rico-x/GemilaiMate/hardware/shield/manufacturing/drill-report.txt

Drill report for gemilaimate-shield.kicad_pcb
Created on 2026-10-28T00:00:00

Copper Layer Stackup:
    =============================================================
    L1 :  F.Cu                      front
    L2 :  B.Cu                      back

Drill file 'gemilaimate-shield-PTH.drl' contains
    plated through holes:
    =============================================================
    T1  0.300mm  0.0118"  (96 holes))
    T2  1.000mm  0.0394"  (121 holes))

    Total plated holes count 217

Drill file 'gemilaimate-shield-NPTH.drl' contains
    unplated through holes:
    =============================================================
    T1  1.000mm  0.0394"  (13 holes))
    T2  3.200mm  0.1260"  (4 holes))

    Total unplated holes count 17
