rico-x/GemilaiMate/hardware/carrier/manufacturing/drill-report.txt

Drill report for gemilaimate-carrier.kicad_pcb
Created on 2026-10-28T10:30:41

Copper Layer Stackup:
    =============================================================
    L1 :  F.Cu                      front
    L2 :  B.Cu                      back

Drill file 'gemilaimate-carrier-PTH.drl' contains
    plated through holes:
    =============================================================
    T1  0.300mm  0.0118"  (53 holes))
    T2  1.000mm  0.0394"  (112 holes))

    Total plated holes count 165

Drill file 'gemilaimate-carrier-NPTH.drl' contains
    unplated through holes:
    =============================================================
    T1  1.000mm  0.0394"  (13 holes))
    T2  3.200mm  0.1260"  (2 holes))

    Total unplated holes count 15
