rico-x/GemilaiMate/docs/compact-shield.md

# Compact Shield: ревизия 0.3.1

**Опытный проект, в железе не воспроизводился.** Переключение между согласованными парами GemilaiMate и оригинального GaggiMate остаётся требованием аппаратных испытаний. Старые carrier и shield сохранены отдельно.

Плата содержит ESP32-S3-WROOM-1-N16R8, собственный USB-C, питание, буферы, PCA9634 и гнёзда ADS1115 Blue, MAX31855 и CJMCU-0102. Измерительные модули вставляются без межплатных проводов. RobotDyn и SSR остаются отдельными силовыми модулями; сетевых цепей на этой PCB нет. Штатный нагрев Gemilai продолжает управляться штатной платой.

Открыть [KiCad-проект](../hardware/shield-compact/gemilaimate-compact.kicad_pro). [Файлы прототипа](../hardware/shield-compact/manufacturing/), [шаблон сверху 1:1](../hardware/shield-compact/previews/assembly-1to1.pdf), [снизу 1:1](../hardware/shield-compact/previews/assembly-bottom-1to1.pdf), [отчёты](../hardware/shield-compact/reports/).

Закупка с учётом прежнего комплекта: [что докупить для Compact](compact-purchase-delta.md). Полная деталировка с расчётом количества — [страница закупки](https://rico-x.github.io/GemilaiMate/compact-purchase.html); ручная сборка — [пошаговый монтаж](compact-assembly.md) ([с картами позиций](https://rico-x.github.io/GemilaiMate/compact-assembly.html)); рендеры и распиновка — [обзор Compact](https://rico-x.github.io/GemilaiMate/compact.html).

## Размеры и размещение

**76 × 61 мм, два медных слоя**, FR-4 1,6 мм, медь 35 мкм. По сравнению с проверявшейся четырёхслойной платой 75 × 60 мм прибавлен 1 мм по каждой стороне габарита; площадь больше на 3,0%. Размер выбран после серии изолированных попыток разводки. Это минимальный прошедший вариант с целыми миллиметрами среди проверенных; глобальный математический минимум не заявляется. Итоги поиска: [layout-search.json](../hardware/shield-compact/reports/layout-search.json).

Все трассы находятся на F.Cu/B.Cu; с обеих сторон заливка GND. Питание разведено дорожками. Внутренних слоёв нет. Антенна WROOM выступает примерно на 7,15 мм за верхний край: 76 × 61 мм — размер текстолита, а не всего устройства. USB выходит к нижнему краю, нижнее левое крепление сдвинуто вправо для кабеля. Размер корпуса и реальные кабели в машине ещё не проверены.

Сверху стоят WROOM, SMD, BOOT/RESET, USB и вставные модули; кабельные JST PH/XH — снизу. Часть низких SMD расположена под модулями: сначала паять SMD, затем гнёзда и разъёмы, последними вставлять модули. Номинальная высота нижней стороны модулей — 11,04 мм. Кнопки и контрольные точки остаются доступными.

Вход питания J4 — единственный JST XH, RobotDyn — единственный PH на 6 позиций (5/6 пустые); J10 нагрева не устанавливать. Другие одинаковые по размеру PH взаимозаменяемы механически: маркировать жгуты по PINOUT/HARNESSES. Ключ исключает разворот штекера, но не перестановку одинаковых разъёмов. Стороны и нумерацию смотреть по сборочным видам; вид снизу зеркален относительно вида сверху.

Номинальные размеры модулей: ADS1115 Blue 28 × 17 мм, MAX31855 20,32 × 22,86 мм, CJMCU-0102 15,24 × 15,24 мм; межрядье CJMCU принято 12,70 мм. **Полученные экземпляры не измерены.** До изготовления сверить модуль, клемму термопары и гребёнки с шаблоном. Источники и уверенность размеров: [component-dimensions.md](component-dimensions.md), [таблица всех позиций](../hardware/shield-compact/reports/component-dimensions.csv).

Гнёзда Harwin M20-7821046, M20-7820646 и два M20-7820546; ответные штыри M20-9991046/0646 и два M20-9990546. Гнездо 8,5 мм + пластик штыревой планки 2,54 мм дают 11,04 мм между платами. Рекомендованные отверстия Ø1,02 мм под контакт 0,65 мм. Совместимость фактических гребёнок-клонов пока не проверена.

Крепление — четыре M2 с головкой до Ø4 мм и изолирующими стойками. Вокруг каждого отверстия круг Ø5 мм без меди на обоих слоях. Не заменять крепёж широкой металлической шайбой.

## Производственные допуски

Ориентир — недорогая двухслойная плата PCBWave с требованием минимального зазора **8 mil = 0,2032 мм** и дорожкой 6 mil. В проекте дорожка не уже **0,20 мм (7,87 mil)**. Исключений 0,15 мм для меди нет.

| Параметр | Принято |
|---|---|
| Обычный зазор сигналов | 0,25 мм |
| Питание, USB и заливки | 0,30 мм |
| Локальные проходы USB-C и близкие контакты корпусов | Правило от 0,21 мм; между площадками USB фактически от 0,22 мм |
| Сигнальные дорожки | Номинал 0,30 мм; тесные участки от 0,20 мм |
| Питание | Номинал 0,40 мм; минимум 0,30 мм |
| Расширение свободных участков | До 0,80 мм сигналы и до 1,20 мм питание, с проверкой соседней меди и отверстий |
| Переходы | Ø0,80 / отверстие Ø0,40 мм, кольцо 0,20 мм, маска с обеих сторон |
| Медь — край | От 0,50 мм |
| Отверстие — чужая медь | От 0,50 мм; локально 0,40 мм у фиксированной геометрии USB |
| Отверстие — отверстие | От 0,65 мм; геометрия фиксированных посадочных мест проверяется отдельно |
| Маркировка | Высота от 1,0 мм, линия от 0,15 мм; это допуск надписей, не меди |

USB-C — **HRO TYPE-C-31-M-12**, локальный вариант посадочного места KiCad. Центры, длины площадок и крепёж сохранены; ширина контактных площадок уменьшена на 0,02 мм: 0,30 → 0,28 мм, 0,60 → 0,58 мм. По [чертежу HRO](https://datasheet.lcsc.com/datasheet/pdf/9e56b777c022540fcce7c7f67825f55e.pdf?productCode=C165948) ширина выводов 0,20 ±0,05 мм, допуск рекомендуемого PCB layout ±0,05 мм. Это проектная адаптация, а не отдельное одобрение производителя разъёма. Фактический минимальный зазор площадок **0,22 мм** независимо проверяется по сохранённой PCB; локальное правило контакт–контакт и контакт–трасса — от 0,21 мм. Один открытый ряд контактов доступен для ручной пайки. USB4085 для этой ревизии не подходит и в BOM отсутствует. Распиновка D+/D−, CC, VBUS и GND проверяется независимо по схеме и PCB. USB Full-Speed 12 Мбит/с; контролируемый импеданс и сертификация USB не заявляются.

На плате **34 перехода GND**, в том числе 20 дополнительных сшивающих Ø0,80/0,40 мм; сигнальные трассы и их переходы не перемещались. Тентирование с обеих сторон. Выбор свободных мест учитывает отверстия, чужую медь, отсутствие новых via-in-pad и крепёж; после добавления повторяется полный DRC. Список: [ground-stitching.json](../hardware/shield-compact/reports/ground-stitching.json).

**Ограничение USB сохраняется.** Заливка снизу разделена на 20 областей, сверху — на 9; сшивка добавляет электрические связи между слоями, но не превращает нижний слой в сплошную плоскость. Доля длины над противоположной заливкой GND: USB_DP 46,46%, USB_DM 48,16%, USB_DP_MCU 34,79%, USB_DM_MCU 0%. Это измерение осевой линии трасс, не расчёт импеданса. USB_DM 40,33 мм и 5 переходов, USB_DP 25,77 мм и 2 перехода; рядом с частью переходов путь до ближайшего соединения GND стал короче, но не везде. Предстоят аппаратные испытания USB и устойчивости к помехам; работа интерфейса не гарантируется проверкой DRC. [Замеры](../hardware/shield-compact/reports/ground-integrity.json).

Пассив 0805/1206 HandSolder, SOT-23/SMA HandSolder, U6/U7 SOIC с шагом 1,27 мм сохранены. Новых проводных перемычек или дополнительных компонентов для перехода на два слоя не добавлено. Локальная переразводка и переходы земли позволяют получить связность без внутренних плоскостей. Ряд тепловых отверстий в центральной земле WROOM сохранён; остальные непланарные отверстия не пересекают SMD-площадки.

Для пробной партии: **2 слоя, 1,6 мм, 1 oz, зелёная маска**, без монтажа; HASL допустим, ENIG даёт более ровные площадки. Перед заказом нужна независимая проверка актуального комплекта и примерка реальных модулей. Производственный ZIP содержит только два медных слоя и актуальные сверловки.

## Питание

Вход — стабилизированные изолированные 5 В правильной полярности. Не подавать на J4 обратное напряжение или повышенное постоянное напряжение. TVS SMAJ5.0A — ограничитель коротких импульсных выбросов: его напряжение пробоя начинается выше рабочего диапазона 5 В; он не является защитой от переполюсовки или длительного перенапряжения. PTC 1,5 А ограничивает перегрузку по току, но не гарантирует отключение блока питания с неверным напряжением. Внешние Alba, RobotDyn/SSR и освещение напрямую подключены к +5V_EXT. USB и внешний вход через отдельные PTC и SS14 образуют +5V_CORE; USB не должен питать внешнюю шину. AP7361C-33E-13 питает контроллер и логику 3,3 В. У него выводы **1 IN, 2 GND/tab, 3 OUT**, это не распиновка AMS1117.

USB позволяет обслуживать контроллер и измерительные модули. Для первой проверки отключить экран, внешнюю Alba, подсветку и исполнительные блоки. PTC 0,5 А не является точным ограничителем USB-тока и его допустимый ток уменьшается при нагреве. Полную систему от USB не питать.

Входной и выходной конденсаторы стабилизатора стоят в пределах 5 мм от его выводов. Предварительный бюджет 3,3 В — около 0,30 А в среднем, с запасом на импульсы радио. При +5V_CORE ≈ 4,6 В потери LDO составят около 0,39 Вт при 0,30 А; при 0,50 А — около 0,65 Вт. Значение 1 А в названии регулятора не означает допустимость 1 А непрерывно в горячей машине. На стенде измерить просадку и температуру. USB с плохим кабелем может не обеспечить запас по падению напряжения на PTC/диоде/LDO. Нельзя заявлять доказанное отсутствие brownout без испытания.

Выходы помпы и SSR имеют аппаратное выключение при отсутствии внешних 5 В и подтяжки в выключенное состояние. Этот узел не является защитным аварийным выключателем машины. Перезапуск, зависание и переключение питания проверяются с эквивалентами нагрузки до подключения силовых блоков.

## GPIO и оригинальная прошивка

| Функция | GPIO |
|---|---|
| Помпа / ZC / клапан | 9 / 21 / 10 |
| Нагрев, не подключён штатно / ALT | 14 / 47 |
| ADS1115 SCL / SDA | 41 / 42 |
| MAX31855 SCK / CS / DO | 6 / 7 / 4 |
| Кнопки пролива / пара, сухие контакты к GND | 38 / 48 |
| ID enable / ADC | 40 / 11 |
| Alba и VL53L0X SDA / SCL | 43 / 44 |
| Весы CLK / DAT0 / DAT1 | 17 / 18 / 39 |
| Штатное расширение | 1 / 2 / 8 / 12 / 13 |
| Свободные выводы | 5 / 15 / 16 |
| Native USB D− / D+ | 19 / 20 |

GPIO0/3/45/46 — сервисные STRAP-площадки; внешние цепи не должны менять режим загрузки. GPIO35/36/37 заняты Octal PSRAM N16R8 и не разведены для доработок. Выводы расширения не являются входами 5 В.

ID=4 соответствует оригинальному профилю GaggiMate Pro PCB Rev 1.1. Прошивка считает ID как round(мВ/100 − 0,5), окно ID=4 — 400–499 мВ. Делитель 10 кОм / 1,58 кОм и 10 нФ даёт номинально около 450 мВ, середину окна; с допусками резисторов ±1% и питания ±5% — около 420–481 мВ, запас примерно 20 мВ с обеих сторон. У старого shield остаётся ID=3 для профиля Pro LEGO. Реальный ADC и HIGH GPIO40 нужно измерить.

Встроенный PCA9634D имеет адрес 0x00, используемый оригинальным кодом. Это закрытая I2C-шина: адрес нельзя произвольно переносить и нельзя добавлять другие устройства с конфликтующим general-call/reset поведением. VL53L0X подключается к той же шине 3,3 В. I2C-сигналы J12 (ToF) и J13 (внешняя Alba) рассчитаны на **3,3 В**. Последовательные резисторы R39/R40 по 470 Ом — только ограничители помех и тока; они не преобразуют уровень и не делают GPIO43/44 устойчивыми к 5 В. Подавать 5 В на SDA/SCL запрещено. Если используется внешняя Alba с собственным PCA9634, **не устанавливать оба нулевых резистора SCL/SDA встроенного PCA**; двух PCA с одинаковым адресом на одной шине быть не должно. Это выбор оборудования при сборке, а не перестановка при смене прошивки.

RGBW: маломощный общий анод 5 В, отдельные резисторы 180 Ом на каналах 0–3. Ленты напрямую сюда не подключать. Каналы 4/5 имеют AO3400A и предназначены для небольшой нагрузки 5 В, суммарно до 200 мА в исходной комплектации. Поведение света во время сброса PCA и с оригинальной прошивкой ещё предстоит измерить; свет может кратко включаться до инициализации. Эти выходы не использовать для клапана или нагревателя.

## Сборка и прошивка

BOM/CPL находятся в manufacturing; BOM-EXTERNAL перечисляет три сменных breakout-модуля и ответные гребёнки. Их можно переставлять между прототипами; количество SMD на пять PCB не означает пять экранов или гидравлических комплектов. Заказывать именно **N16R8**, Quad Flash + Octal PSRAM. ESP-WROOM-32, N16 без R8 и WROOM-2 не являются заменой. Гнездо J19 сверено с маркировкой CJMCU-0102 (ряд A: GND, OE, VA, A1, A2; ряд B: GND, G, VB, B1, B2) и таблицей выводов TI SCES640L: SCL идёт через A1↔B1, SDA через A2↔B2; посадочное место не зеркальное, обе GND на одном торце. Межрядье 12,70 мм и маркировку конкретного клона всё равно проверить до питания. PCA9634D (SO20) и SN74AHCT125D (SOIC-14) имеют ту же нумерацию выводов, что и TSSOP-варианты; физические номера сверяются отдельно от ERC.

Для ручного монтажа выбраны: резисторы и малые конденсаторы 0805, конденсаторы 10 мкФ и предохранители 1206 — все с удлинёнными площадками HandSolder; SOT-23, SOT-23-5/6 и SMA тоже в вариантах для ручной пайки; микросхемы U6/U7 в SOIC с шагом 1,27 мм вместо TSSOP 0,65 мм. У каждой полярной SMD-детали на верхней шелкографии точка первого вывода (U, Q) или черта катода (D). Позиционные обозначения большинства мелких деталей на шелкографию не помещаются: паять по сборочному чертежу 1:1 ([assembly-1to1.pdf](../hardware/shield-compact/previews/assembly-1to1.pdf)) и BOM. Порядок: SMD сверху, затем разъёмы снизу и гнёзда модулей, модули — последними. Самые трудные места остаются у WROOM (центральная земля) и USB-C HRO; пайку скрытой земли нельзя подтвердить одним внешним осмотром.

Перед WROOM проверить питание и отсутствие замыкания. Центральная земля модуля требует пайки по рекомендованному процессу с доступом снизу/оплавлением; одним обычным паяльником надёжность центрального контакта не подтверждена. Для сборки заказать монтаж SMD либо предусмотреть контролируемый прогрев. Съёмные ADS/MAX/CJMCU упрощают замену модулей, но не решают пайку центральной земли WROOM.

Вставить MAX31855 правильной стороной: место модуля подписано на плате. VIN модуля питается от 3,3 В через R41 (0 Ом); это подходит для голого MAX и breakout с регулятором. Вариант 5 В — только перепайкой: снять R41, поставить 0 Ом на R42. Контакт 3Vo остаётся NC. ADS1115 ADDR соединён с GND, адрес 0x48; давление подаётся на A0 через RC-фильтр. CJMCU: ряд A питается от 3,3 В, ряд B от 5 В; контакт G оставлен неподключённым. OE включается RC-цепочкой R43 10 кОм / C17 1 мкФ примерно через 10 мс после установления 3,3 В: TI требует держать OE низким, пока VCCA и VCCB не установились (SCES640L, раздел 8.3). Свободного GPIO под OE нет, а оригинальная прошивка им бы не управляла. Проверить маркировку конкретного клона и прозвонить положение рядов перед включением; никакие сырые 5 В не должны попадать в ESP32.

Цель сборки — `controller-compact`, ID=4 и Alba 43/44, чтобы неизменённая GaggiMate Pro PCB прошивка выбирала профиль Rev 1.1. Прежняя `controller` остаётся ID=3 и GPIO 15/16 для carrier/shield. Физическое определение теперь различает варианты, но прошивку всё равно собирать и выбирать явно; автоматического зондирования GPIO нет. Старый GitHub-релиз без этой цели не является compact-пакетом. Собрать текущий пакет из исходников; согласованный display используется из того же пакета.

Физическая Flash 16 MB, PSRAM 8 MB OPI. В совместимом режиме намеренно сохраняется разметка и заголовки **8 MB**, верхние 8 MB не используются. Перед экспериментами сделать полный дамп **16 MB**, отдельно сохранить настройки экрана. Проверяющий flash.py без `--flash` не открывает порт:

```sh
python tools/flash.py controller-compact --package releases/firmware --port ACTUAL_PORT --fresh
```

Для принудительного загрузчика: удерживать BOOT, нажать и отпустить RESET, затем отпустить BOOT. Штатный USB-UART-мост отсутствует. Работа ROM USB и авто-перехода в загрузчик требует проверки на реальном модуле.

## Приёмка

1. Независимо проверить схему, посадочные места и BOM, сверить реальные модули с шаблоном, подтвердить стек фабрики. ERC/DRC не подтверждают работу схемы.
2. На изолированном стенде: внешний БП с ограничением тока, сопротивление шин, напряжения, USB отдельно/внешнее отдельно/оба питания, отсутствие обратного питания, нагрев и RF-пики тока. Измерить ток +5V_EXT со всей нагрузкой в горячей машине: PTC 1,5 А при нагреве держит меньше.
3. USB BOOT/RESET; физическая память 16/8 MB; определение ID=4 во всех режимах; стабильность BLE/RF возле корпуса.
4. ADS/MAX/ToF/PCA, электрические уровни и полярности выходов с эквивалентами. Проверить, не подсвечивается ли выключенный канал RGBW: в двухтактном режиме PCA выход держит 3,3 В при аноде 5 В. Проверить включение, перезапуск, потерю BLE/ZC и отключение питания.
5. Согласованные пары GemilaiMate и оригинального GaggiMate: несколько переключений туда/обратно, без изменения платы и перемычек. Не смешивать controller/display разных проектов. Для оригинала сверить сохранённые контрольные суммы официальных BIN.
6. Только затем размещение и испытания в Gemilai. Обратная совместимость остаётся неподтверждённой до этих испытаний.

Источники и закреплённые версии: [sources.json](../hardware/shield-compact/sources.json), матрица [совместимости](compatibility.md). Тяжёлые операции KiCad и сборки выполняются на разрешённом стенде; физические устройства при подготовке файлов не подключались.

## Воспроизведение файлов

На стенде нужны KiCad 10.0.7/Python pcbnew, sexpdata, Shapely и для изображений CairoSVG. Полная принятая трассировка хранится в `routing.json`; её SHA-256, сумма входного DSN и побайтовая сумма локальной библиотеки посадочных мест закреплены в `reports/route-cache.json`. Сумма DSN не зависит от порядка перечисления компонентов, цепей и посадочных мест. `python tools/rebuild_compact.py --kicad-python python3 --no-previews` заново создаёт PCB и схему, проверяет геометрию входа, восстанавливает медь, расширяет дорожки, расставляет подписи и повторяет проверки. Изменение схемы или геометрии останавливает использование сохранённой трассировки. Новые варианты трассируются Freerouting 2.5.0 / Java 25 на стенде, с отключёнными автоматическими сужениями и нижним пределом 0,20 мм. Локальные завершения выполняются отдельно и принимаются только после свежего KiCad DRC. `capture_route.py --from-board` сохраняет полную проверенную медь до автоматического расширения. Геометрия DSN и полный результат закреплены контрольными суммами. Локальная `.pretty` закреплена в неподвижной точке: пересборка проверяет её сумму до и после генерации. Автоматическое расширение обрабатывает дорожки по цепи, слою и координатам, независимо от UUID и порядка KiCad. Итоги независимых чистых пересборок: [reproducibility.json](../hardware/shield-compact/reports/reproducibility.json).

Минимальная сверка сохранённого проекта: `python tools/check_compact_shield.py`. Свежие ERC/DRC и сравнение CAM с PCB: `python tools/export_compact.py --verify-only`. Последние команды не подключают физические устройства и не отправляют заказ фабрике.
