rico-x/GemilaiMate/docs/shield.md

# Shield v0.2.4: сборка и ограничения

Два активных варианта: carrier v0.1 90×46 мм и shield 90×75 мм. Общая firmware v0.1.0, те же 13 GPIO и SMD. В shield ADS1115, TXS0102 и MAX31855 вставляются в гнёзда, заменяя три жгута (19 жил).

Схема подключения, 3D-вид сборки с модулями в гнёздах и таблицы жгутов — на [странице подключения shield](shield-wiring.html).

**J5/J6 — кабельные разъёмы. Прямая установка RobotDyn и SSR на shield не предусмотрена.** Диммер подключается 4 управляющими жилами, SSR 3 жилами. Силовые блоки крепятся отдельно, их сетевые части и радиаторы не находятся над PCB. Штатные винтовые клеммы SSR сохраняются.

## Ориентация

У J2/J3/J5/J6/J7 квадратная площадка 1, метка «1», контур на F.Silkscreen и подписи функций. Это не механический ключ: перед установкой модулей измерить питание на пустых гнёздах.

- J2 ADS1115: VDD, GND, SCL, SDA, ADDR, ALRT, A0, A1, A2, A3. ADDR на GND, адрес 0x48, давление A0, ALRT/A1–A3 NC. Подпись «VDD ... A3».
- J7 CJMCU-0102: **2 × 1×5 P2,54**, две независимые гребёнки, не стандартная колодка 2×5. Межрядье 12,70 мм пока допущение. A: GND, OE, VA, A1, A2; B: GND, G, VB, B1, B2. OE/VA = 3,3 В, VB = 5 В; G оставлен NC до прозвонки. Метки «A 3V3» / «B 5V». Поворот на 180° опасен: +5 В может попасть на VCCA.
- J3 MAX31855: VIN, 3Vo, GND, DO, CS, CLK по номерам контактов. Контакт 1 VIN справа, контакт 6 CLK слева при виде сверху. **3Vo — выход, NC.** Подпись читается слева направо: «CLK ... VIN». JP3 1–2 только после проверки VIN 5 В и уровней DO. Габарит Adafruit v2 — ориентир, клон не измерен.
- J5 RobotDyn: 1 VCC5V, 2 GND, 3 ZC, 4 PSM. Контакт 1 слева. Четыре гибких управляющих провода к штатной гребёнке отдельно закреплённого диммера.
- J6 SSR: 1 DC+, 3 DC−/GND, 5 CH1; 2/4 NC. Три отдельных провода к штатной входной клемме SSR, её шаг с PCB совпадать не должен. Перепайка клеммы не нужна.

[connections.csv](../hardware/shield/connections.csv) — актуальная распиновка. J2/J3/J6/J7 отличаются от carrier. Гнёзда малых модулей номинально ≥8,5 мм; просвет ESP32 над деталями проверить ≥5 мм. Нижний ряд ESP32 выбрать один: A либо B. Необязательный датчик уровня воды подключается к гнезду U1 так же, как на carrier: [интерфейсы](interfaces.md#датчик-уровня-воды-необязательно).

Метки J2 и ряды A/B J7 находятся внутри собственных контуров рядом с контактами. Жгуты собирать в цельных корпусах по [инструкции](harnesses.md): J5 1×4, J6 1×5 с пустыми 2/4, штыревые контакты со стороны shield. Отдельные одноконтактные вилки не использовать. Корпуса без механического ключа: метка контакта 1 и проверка прозвонкой до подачи питания обязательны.

Все видимые надписи шелкографии с обеих сторон, включая обозначения компонентов, автоматически проверяются на зазор ≥0,15 мм до переходов. В v0.2.4 перенесены подписи ADS1115, CJMCU-0102, NO MAINS ON BOARD, VDD ... A3, CH1/DC−, несколько позиционных обозначений и нижние авторские надписи. Медь, посадочные места и состав деталей сохранены.

## Механика

J4 сдвинут вправо на 1,27 мм. Четыре M3 с головкой **≤5,5 мм, без шайб**, предпочтительно изолирующие. Шайба Ø7 возле левого нижнего угла не входит в принятый зазор.

`mechanical_profiles` в [design.json](../hardware/shield/design.json) содержит объёмные зоны модулей, ответных колодок J1/J4/J8/J9/J5/J6 и первых участков кабелей. Проверяются пересечения, USB и M3. **Зоны — проектные допуски, не замеры деталей.** Если реальная колодка больше, сначала изменить профиль и компоновку.

USB: x −30…4,8 мм, y 7,62…35,56 мм от верхнего левого угла PCB. J4/J8/J5 и термопара выходят вниз раздельными зонами; J6 вправо, J1/J9 вверх. Дальнейшая прокладка зависит от машины.

RobotDyn/SSR имеют внешние резервы объёма 80×65×65 и 60×45×40 мм. Это бюджеты будущего держателя, не размеры модулей. Известен лишь заявленный PCB RobotDyn 60×42 мм; высота, радиатор, клеммы и габарит SSR не измерены. Координаты внешних блоков не назначены; их пересечения и вписываемость в Gemilai не проверены. Размер 90×75 относится только к PCB.

Вставные модули удерживаются отдельными прижимами по [плану фиксации](retention.md). Новых отверстий под стойки нет, сверление разведённой PCB не предусмотрено. Физическая фиксация ещё не испытана.

Проводами остаются питание J1/J9, давление J4, кнопки J8, термопара, 4 жилы J5, 3 жилы J6 и силовые цепи. J10 нагревателя не подключать.

## До пайки и запуска

1. Распечатать [шаблон 1:1](../hardware/shield/mounting-template-1to1.svg) при 100%; сверить реальные платы, гнёзда, колодки, USB и крепёж. Особенно TXS 12,70 мм/G, MAX и ESP32.
2. Примерить прижимы без давления на компоненты и без опоры только на контакты. Установить все ответные колодки.
3. Запаять SMD/U2/гнёзда без модулей. Проверить КЗ и питание с ограничением тока.
4. По одному установить TXS/ADS/MAX, ESP32 последним; снять JP1 для USB. [Прошивальщик](flashing.md), firmware v0.1.0.
5. Выполнить [стенд](bench.md): отдельно подтвердить ток SSR, ZC, штатные кнопки, уровни MAX при VIN 5 В и силовую часть 3007Z.
6. После часа работы помпы проверить люфт, контакты, прижимы и жгуты. Это испытание ещё не выполнялось.

[mechanical-check.json](../hardware/shield/mechanical-check.json) отделяет номинальные проверки от физики. Gerber — для пробной партии; сборка, USB-прошивка и работа в машине пока не подтверждены.
