rico-x/GemilaiMate/docs/harnesses.md

# Корпуса управляющих жгутов

Использовать цельный многоконтактный корпус, а не отдельные однополюсные вилки. Первый контакт отмечают красной меткой на корпусе и сверяют с маркировкой PCB.

| Вариант | Жгут | Корпус на стороне PCB | Заполнение |
|---|---|---|---|
| Shield | J5 RobotDyn | Один DuPont 1×4 P2,54, штыревые контакты | 1 +5V, 2 GND, 3 ZC, 4 PSM |
| Shield | J6 SSR | Один DuPont 1×5 P2,54, штыревые контакты | 1 DC+, 3 DC−/GND, 5 CH1; позиции 2 и 4 пустые |
| Carrier | J5 RobotDyn | Один DuPont 1×4 P2,54, гнездовые контакты | 1 +5V, 2 GND, 3 ZC, 4 PSM |
| Carrier | J6 SSR | Один DuPont 1×3 P2,54, гнездовые контакты | 1 DC+, 2 DC−/GND, 3 CH1, все позиции подряд |

Пол контактов указан для кабеля: на shield стоят гнёзда PCB, на carrier штыревые гребёнки. На стороне RobotDyn ответную часть подбирают к фактической штатной гребёнке. На стороне SSR — штатная винтовая клемма, её не перепаивают. Пятигнёздный корпус J6 shield с пустыми 2/4 не переносить на carrier.

**Эти корпуса без механического ключа.** Они предотвращают перестановку отдельных проводов при подключении, но весь корпус можно развернуть на 180°. Не считать конструкцию защищённой от переполюсовки. Разворот J5 может подать +5 В на PUMP_PWM/GPIO9; подключение CH1 SSR к +5 В может постоянно включить клапан.

До питания:

1. Проверить фиксацию обжатых контактов в общем корпусе и отсутствие отдельных свободных штекеров.
2. Нанести красную метку первого контакта на каждый корпус и бирку J5/J6. Положения 2/4 J6 shield оставить без металлических контактов.
3. На снятом жгуте прозвонить каждую цепь от позиции корпуса до вывода модуля по таблице. Проверить отсутствие замыканий между соседними проводами.
4. Устанавливать корпус только по метке 1, сохраняя маркировку видимой. Проверить повторно +5 В, GND и управляющие цепи. Первую проверку выполнить на низковольтном стенде с ограничением тока и отключёнными сетевыми нагрузками.

Размеры реально купленных корпусов ещё нужно сверить с зонами ответных колодок. Монтаж жгутов и физическая проверка пока не выполнялись.
