rico-x/GemilaiMate/docs/retention.md

# План регулируемого держателя

Держатель пока не изготовлен и не примерен. Точки прижима и высоты назначают после осмотра реальных модулей.

1. Изолирующий поддон удерживает shield за штатные отверстия Ø3,2: (3;3), (87;43), (3;72), (87;72). M3 с головкой ≤5,5 мм, без шайб. Под гнёздами — изолирующие опоры без контакта с пайкой/медью.
2. Верхняя изолирующая рамка опирается на поддон. Пазы/поперечины дают независимую регулировку трёх прижимных пальцев. Предварительно нижняя поверхность поперечин ≥28 мм над PCB; это не окончательная высота корпуса.
3. Каждый ADS/TXS/MAX удерживается отдельно: мягкая изолирующая накладка сверху на свободном **краю PCB**, опора снизу на том же краю. Не давить на микросхемы, SMD, штыри, регулятор или термоклемму. Устранить подъём/люфт без изгиба платы и нагрузки на гнездо. Номинальный верх малой PCB около 12,64 мм над shield; регулировать по факту.
4. На ADS искать край напротив ряда пинов; на TXS боковой край между рядами; на MAX боковой край в стороне от гребёнки/термоклеммы. У клона там могут быть детали. Если свободного участка нет, нужен другой фиксатор, а не давление на компонент.
5. ESP32 удерживать за свободный край PCB, сохранив USB и BOOT/RESET. Не занимать антенную зону RF keepout крепежом или рамкой.
6. Кабели отдельно разгружены на поддоне, с сервисной петлёй. RobotDyn/SSR крепятся в собственных опорах вне низковольтной PCB; жгуты J5/J6 не служат креплением.

Материал поддона/рамки должен сохранять изоляцию и жёсткость при измеренной температуре и влажности. Температурный запас пока не проверен; план не подтверждает пригодность PLA/PETG для кофемашины. Сетевой отсек проектируется отдельно.

Приёмка: без питания установить все модули, колодки и USB; проверить высоту, кнопки, термоклемму, снятие модулей и зазор до паек снизу. При лёгком подъёме за край модуль не выходит и не прогибается; за кабель/радиатор не тянуть. После стенда и часа работы помпы повторить проверку люфта и непрерывности контактов. Примерка и вибрационное испытание ещё не выполнены.
