rico-x/GemilaiMate/docs/plans/compact-shield.md

# План: Compact Shield с ESP32-S3-WROOM-1-N16R8

Дата: 03.11.2026. Статус: **реализация отдельного прототипа; аппаратные испытания не выполнены**.

Этот документ фиксирует принятые требования. Текущая реализация и ограничения описаны в [compact-shield.md](../compact-shield.md). Существующие carrier и shield сохраняются. Вариант `shield-compact`, текущая опытная ревизия `0.3.1`.

## 1. Цель и критерий совместимости

Создать максимально компактную низковольтную плату с распаянным ESP32-S3-WROOM-1-N16R8, собственным USB-C и гнёздами для измерительных модулей. Отдельный DevKit и его UART-мост исключаются. Сетевые RobotDyn и SSR остаются отдельными блоками; 230 В на основной PCB не заводится.

Полная совместимость является **критерием приёмки**, а не уже подтверждённым свойством. Для выбранной версии официальной прошивки:

- неизменённый образ контроллера должен загружаться на новой плате через native USB;
- оригинал должен определять плату как `GaggiMate Pro Rev 1.1`, ID=4;
- должны совпадать GPIO, полярности, электрические уровни и интерфейсы профиля Pro PCB Rev 1.1;
- согласованная пара официальных controller/display должна работать; возврат к согласованной паре GemilaiMate выполняется через USB без перепайки и перестановки перемычек;
- уровень воды и подсветка должны работать с совместимым оборудованием Alba без изменения оригинального кода;
- после переключения заново проверяются настройки/сопряжение. Совместимость сохранённых данных не предполагается автоматически.

Базовые исходники для сравнения: GemilaiMate `404be08`, GaggiMate v1.9.0 `43d2a7b` и master `b78beee`. Профили Pro PCB Rev 1.1 (ID=4) и Pro LEGO (ID=3) используют одинаковую карту GPIO; для Compact выбран ID=4, потому что это собранная основная PCB. Перед изготовлением повторить сравнение с актуальным стабильным релизом. Это не означает поддержку всех функций других аппаратных профилей GaggiMate, в частности двухбойлерных плат.

Совместимость платы не передаёт автоматически управление штатным нагревом Gemilai новому контроллеру. Выход нагрева предусматривается электрически; подключение его к машине остаётся отдельной задачей. Штатная интеграция сейчас сохраняет родное управление нагревом и паром.

## 2. Сравнение вариантов контроллера

| Вариант | Решение |
|---|---|
| **ESP32-S3-WROOM-1-N16R8 на нашей PCB** | Основной вариант. 16 MB Quad-SPI Flash, 8 MB Octal PSRAM, встроенная антенна; модуль 18 × 25,5 × 3,1 мм. Разводим питание, USB, BOOT/RESET и внешние цепи сами |
| ESP32-S3 DevKit N8R8/N16R8 с готовым USB | Возможен при отдельной проверке разводки UART, но оставляет габариты DevKit и риск занятых GPIO43/44; текущие варианты проекта уже используют этот подход |
| **ESP-WROOM-32 / ESP32 с CH9102X или CH340 и Type-C** | Исключить для этой задачи. Другой MCU/машинный код, нет GPIO40–48, GPIO6–11 заняты встроенной Flash. Официальный образ для ESP32-S3 не запустится; потребовались бы порт прошивки и новая распиновка. Type-C и модель UART-моста этого не меняют |

Использовать полный артикул **ESP32-S3-WROOM-1-N16R8**. Не подменять его ESP-WROOM-32, WROOM-2 или вариантом с другим суффиксом памяти без повторной проверки. Кварц, Flash, PSRAM и радиочасть уже находятся внутри WROOM; заново разводить их дискретными компонентами не требуется.

## 3. Предлагаемая архитектура и габариты

Реализованная геометрия ревизии 0.3.1: **76 × 61 мм, два медных слоя**. Сигнальные зазоры 0,25 мм, питание/USB/заливки 0,30 мм; минимальный зазор меди 0,21 мм, площадки USB от 0,22 мм, дорожки от 0,20 мм, питание от 0,30 мм. USB-C HRO TYPE-C-31-M-12 заменяет USB4085. Пассив 0805/1206 HandSolder и SOIC 1,27 мм сохранены; расширительные разъёмы J16–J18 — 2,54 мм. Модули не измерены и примерка в машине не выполнена. Текущие результаты проверок приведены в validation.md и отчётах.

- ADS1115, MAX31855 и CJMCU-0102 оставлены вставными, чтобы все малые платы shield ставились в гнёзда без навесных межплатных жгутов. До заказа платы измерить точные клоны, особенно межрядье CJMCU и клемму термопары.
- SMD согласование уровня не устанавливать параллельно CJMCU: преобразование 3,3/5 В выполняет один сменный TXS0102 модуль.
- Буферы ZC, SSR и остальные согласующие цепи также находятся на PCB. AHCT125 установлен в SOIC-14 с шагом 1,27 мм для ручной пайки.
- Вставные модули разместить с одной стороны; WROOM, USB и питание разместить так, чтобы модули не закрывали антенну или штекер USB. Обе стороны PCB допускаются, высоту сборки считать в 3D.
- Резервные гребёнки не устанавливать в базовой сборке: оставить доступные площадки/низкопрофильные разъёмы, чтобы они не увеличивали высоту.
- Основные кабельные разъёмы по краям; механический ключ и метка контакта 1. Никакой колодки в зоне входа USB-штекера.
- RF-часть модуля вынести к краю PCB; исключить медь, дорожки, детали, вставные модули, крепёж и кабели в запретной зоне антенны. Проверить также соседний металл корпуса кофемашины.
- Двухслойную трассировку принимать только после DRC, ERC, проверки возвратного пути USB и связности заливки GND. При ошибках корректировать компоновку или понемногу увеличивать габарит в целых миллиметрах; двухслойный результат принимать только после повторных проверок.

Ориентиры модулей: ADS1115 28 × 17 мм, MAX31855 20,32 × 22,86 мм, CJMCU-0102 15,24 × 15,24 мм; это номинальные/продавцом заявленные контуры, реальные клоны не измерены. Высота гнёзд, ответные колодки, терминал термопары и USB входят в общий габарит. Модули RobotDyn и SSR остаются отдельно закрепляемыми силовыми платами; 230 В на логическую PCB не заводить.

## 4. Обязательная распиновка оригинала

| Функция | GPIO | Что предусмотреть |
|---|---|---|
| Помпа | 9 | PSM, активный HIGH, безопасный LOW при запуске |
| Zero-cross | 21 | Неинвертирующий входной буфер 5 → 3,3 В, фильтрация по проверенной текущей схеме |
| Клапан | 10 | Неинвертирующее управление SSR, HIGH = включено |
| Нагрев | 14 | Выход управления SSR; по умолчанию к нагревателю Gemilai не подключён |
| Дополнительный выход ALT | 47 | Отдельный доступный выход, согласование уровня и выключенное состояние при старте |
| ADS1115 | SDA42 / SCL41 | Адрес 0x48, давление A0, питание/уровни как в совместимой схеме |
| MAX31855 | SCK6 / CS7 / MISO4 | Сохранить направление сигналов, питание и допустимый уровень DO |
| Кнопки | 38 / 48 | Сухие контакты к GND, active LOW, аппаратные фильтры |
| Определение платы | EN40 / ADC11 | Делитель ID=4, контроль запуска именно с оригинальным алгоритмом ADC |
| Alba / датчик воды | SDA43 / SCL44 | Отдельная I2C-пара, без UART-моста и индикаторов на этих линиях |
| Весы | CLK17 / DAT0 18 / DAT1 39 | Вывести интерфейс; пока не подключены, эти контакты не считать свободными GPIO |
| Расширение оригинала | 1 / 2 / 8 / 12 / 13 | Вывести отдельной группой, сохранить роли оригинального профиля |
| Native USB | D-19 / D+20 | Только USB; не использовать как свободные выводы |

ID=4 выбирает известный оригиналу профиль Pro PCB Rev 1.1. Делитель 10 кОм / 1,58 кОм рассчитан примерно на 450 мВ, середину окна 400–499 мВ; проверить сопротивление источника, RC и порог ADC. Совпадение расчётного напряжения само по себе не доказывает устойчивость автодетекта.

### Резерв GPIO

При сохранении перечисленных интерфейсов:

- **GPIO5, GPIO15, GPIO16** вывести как свободные GPIO 3,3 В с GND и доступным питанием рядом.
- **GPIO0, GPIO3, GPIO45, GPIO46** вывести на подписанные сервисные площадки с пометкой STRAP; GPIO0 используется также BOOT. Подключаемые доработки не должны менять загрузочные уровни. GPIO45 особенно важен для питания памяти, GPIO46 — для режима загрузки. Предусмотреть возможность отключения внешней нагрузки.
- GPIO1/2/8/12/13 и GPIO17/18/39 доступны через штатные группы расширения/весов, но оригинал может обращаться к ним при старте; произвольные нагрузки там не допускаются без проверки.
- GPIO35/36/37 не выводить как пользовательские: они заняты Octal PSRAM N16R8. Внутренние и не выведенные на WROOM линии памяти также не пытаться использовать.
- Предусмотреть тестовые площадки основных шин и 3,3/5 В, EN, GND; USB-площадки делать без длинных ответвлений. Дублированный тестовый контакт занятого сигнала не объявлять свободным GPIO.

Все внешние GPIO имеют логику 3,3 В; 5 В допускаются только через специально рассчитанное согласование. На схеме и PCB явно различить GPIO, питание и выходы буферов.

## 5. USB, питание, загрузка

1. USB-C в режиме USB 2.0 device: D-/D+ к GPIO19/20, отдельные Rd 5,1 кОм на CC1 и CC2, ESD-защита, механические крепления разъёма. Внешний CH340/CH9102X/CH343 не устанавливается.
2. Пару USB рассчитать под выбранный стек платы, 90 Ом ±10%, непрерывная опорная земля; короткая симметричная трасса. Оставить рекомендованные Espressif посадочные места последовательных резисторов 22/33 Ом и необязательных корректирующих компонентов; окончательные значения определить по модульной референсной схеме и проверке сигнала.
3. Кнопки BOOT и RESET доступны на собранной плате. EN с правильной подтяжкой/задержкой, контроль уровней strapping при всех режимах питания. Сервисные UART TX/RX можно иметь как точки подключения, но они разделены с Alba: для UART-сеанса периферию физически отключают. Постоянный мост отсутствует.
4. Вход внешних изолированных 5 В и USB VBUS развязать так, чтобы внешние 5 В не поступали в компьютер. Сравнить power-mux/идеальные диоды и простую защищённую схему; защита от обратного тока должна быть проверена, а не зависеть только от инструкции снять перемычку.
5. Разделить питание ядра/датчиков и питание дисплея/внешних модулей. Заложить отключение или ограничение внешних потребителей при питании только от USB, чтобы USB не питал всю установку и не превышал доступный ток до/после перечисления.
6. Стабилизатор 3,3 В выбрать по пиковому току и нагреву: минимум Espressif для ESP32-S3 — 500 мА, проектный запас рассчитать для всех потребителей. Сравнить компактный LDO и DC/DC; окончательный выбор после расчёта рассеиваемой мощности, пульсаций и расположения возле ADC/RF. Развязка непосредственно у WROOM, включая входную ёмкость.
7. Нагрев внутри машины — критерий размещения: для N16R8 даташит указывает верхнюю температуру окружающей среды 65 °C в обычной конфигурации PSRAM. Возможность 85 °C связана с ECC и не предполагается для неизменённой ванили. Проверить температуру на месте установки и запас до предела.

Не менять eFuse, не включать шифрование/secure boot, способные ограничить смену прошивок. Проверить восстановление через BOOT/RESET даже при неработающем приложении.

## 6. Alba и вода

Одного переноса I2C на GPIO43/44 недостаточно для отдельного VL53L0X: проверенный оригинал включает ToF после обнаружения LED-контроллера.

Предлагаемый вариант для покомпонентной сборки — предусмотреть **PCA9634 на основной PCB** и вынесенный к баку VL53L0X. Подсветку можно подключить к выходам драйвера; сами светодиоды для обнаружения микросхемы не обязательны. До утверждения схемы воспроизвести адресацию, OE, назначения каналов, питание и активные уровни Alba, затем проверить обнаружение и измерение воды неизменённым оригиналом. Не заменять PCA9634 другим PWM-драйвером только по сходству назначения.

Также предусмотреть разъём для оригинальной/совместимой Alba. **Два PCA9634 с одинаковым адресом одновременно на одну шину не подключать.** Для внешней Alba встроенный драйвер должен отключаться от SDA/SCL аппаратными конфигурационными связями либо быть DNP; одного снятия его питания недостаточно. Это вариант комплектации при сборке, а не переключатель между прошивками. Во время смены прошивок конфигурация аксессуаров сохраняется.

Если посадочное место PCA9634 препятствует целевому размеру, вынести его на малую плату датчика/подсветки и явно отразить это в BOM. В любом варианте для полноценной работы уровня воды на ванили требуется совместимый драйвер; голый VL53L0X не заявлять как полностью поддерживаемый оригиналом.

## 7. Flash и две прошивки

Физическая Flash N16R8 имеет 16 MB, но оригинальный контроллер сейчас собран под 8 MB и `default_8MB.csv`. В первом варианте сохраняем совместимые адреса разделов и используем нижние 8 MB. Верхние 8 MB пока не размечаем и пользовательские данные туда не переносим.

Не вводить собственную 16-MB разметку в режиме совместимости. Проверить bootloader, заголовки BIN, таблицы разделов и доступ к PSRAM. То, что большой чип физически вмещает меньший образ, не заменяет тест загрузки. Резервный полный дамп новой платы должен охватывать **16 MB**.

Для GemilaiMate отдельная сборочная цель `controller-compact` использует ID=4 и I2C периферии 43/44. Сборка существующих carrier/shield остаётся на ID=3 и GPIO 15/16. Для новых плат профиль различается аппаратно; на старом DevKit не зондировать GPIO43/44 из-за UART-моста. Выбор firmware target всё равно задаётся явно при сборке/упаковке.

Оригинальный controller BIN не патчить для прохождения приёмки. С ним используется оригинальный display той же версии. С нашим compact-controller используется согласованный GemilaiMate display. BLE UUID могут оставаться собственными; смешанные пары не заявляются. При переходах сохранить отдельные дампы/экспорты, учитывать NVS, очистку сопряжения и заново проверять рабочие настройки.

## 8. Как добавить в репозиторий

После согласования плана создать отдельную ветку реализации. Новый вариант самостоятельный, не перезаписывает существующий shield и не превращается в импорт исходного GaggiMate.

| Планируемый путь | Содержание |
|---|---|
| `hardware/shield-compact/` | Новый KiCad-проект, локальные библиотеки, исходная схема и PCB |
| `hardware/shield-compact/revision.json` | Единственный источник аппаратной ревизии и даты |
| `hardware/shield-compact/design.json` | Габариты, зоны модулей/антенны/USB, монтаж, состояние проверок |
| `hardware/shield-compact/pinmap.json` | Машиночитаемая карта GPIO и сравнение с выбранным профилем upstream |
| `hardware/shield-compact/manufacturing/` | Только после проверок: Gerber/Excellon, BOM по вариантам комплектации, CPL по сторонам, схемы сборки |
| `hardware/shield-compact/previews/` | 2D/3D, шаблон 1:1, сборка с реальными моделями модулей |
| `tools/check_compact_shield.py` | Независимые проверки GPIO, ID, памяти, запрещённых выводов и механических зон |
| `docs/compact-shield.md` | Сборка, распиновка, питание, ограничения и статус реальных испытаний |
| `docs/compatibility.md` | Матрица официальных версий, проверенных образов, аксессуаров и результатов переключения |

Обновить существующие `tools/check_project.py`, `tools/build_release.py`, `tools/flash.py`, генераторы страниц и `.github/workflows/checks.yml` для третьего варианта. Сейчас в них зашиты два firmware target и фиксированные свойства старых плат; не ослаблять старые проверки для прохождения новых.

Генераторы нового проекта не должны восстанавливать DevKit путём копирования текущего carrier: ядро WROOM требует другой схемы, силовых цепей питания и посадочного места. Общие проверки можно переиспользовать, аппаратные исходники держать раздельно. На PCB сохранить авторство Rico-X, ссылку на репозиторий и точную ревизию. Лицензии и происхождение заимствованных цепей отражать в NOTICE.

## 9. Этапы и условия перехода

| Этап | Результат | Условие перехода |
|---|---|---|
| 1. Требования и источники | Зафиксированные официальные версии, GPIO, память, схема Alba, выбранные артикулы и размеры | Нет неизвестного адреса/уровня/назначения критических цепей; ESP-WROOM-32 исключён |
| 2. Принципиальная схема | WROOM, питание, USB, BOOT/RESET, ID, согласование, сокеты, PCA/Alba и резерв | ERC без ошибок; расчёты питания/нагрева; независимая проверка схемы |
| 3. Компоновка и выбор слоёв | Сравнение компактных расстановок, общий 3D-габарит и доступ к разъёмам | Нет перекрытия антенны, штекеров, крепежа, посадочных мест и модулей; размеры деталей подтверждены |
| 4. Трассировка | Завершённая PCB, контролируемая USB-пара и возвратные токи | DRC/unconnected/schematic parity = 0; независимая сверка GPIO и всех монтажных подписей |
| 5. Сборочные пакеты | Отдельный compact firmware, производственный комплект и воспроизводимые отчёты | Все проверки старых вариантов проходят; новые образы/разделы согласованы; CPL учитывает все используемые стороны и DNP |
| 6. Низковольтный прототип | Реальная сборка, питание, USB/BOOT, память, датчики, логические выходы | Нет ложных включений, обратного питания USB, провалов 3,3 В и перегрева |
| 7. Переключение прошивок | Матрица GemilaiMate → официальный релиз → GemilaiMate и повторные циклы | Без перепайки/перемычек; правильный ID, связь с экраном, ToF/LED, датчики и выходы после каждого перехода |
| 8. Испытание в машине | Реальное размещение, связь, температура и работа через уже проверенные внешние силовые блоки | Только после стенда; документирован фактический результат и оставшиеся ограничения |

На стенде отдельно проверить пропадание ZC, потерю BLE, перезапуск контроллера и экрана, входы кнопок и состояние всех выходов при включении. Локальные защиты GemilaiMate не становятся частью официальной прошивки при смене образа; результаты её поведения фиксировать отдельно.

Нулевой ERC/DRC и успешная компиляция не являются доказательством работы USB, RF или кофемашины. Пока этапы 6–8 не выполнены, новый вариант маркируется PROTOTYPE / NOT HARDWARE VALIDATED, а совместимость — planned или source-checked, не passed.

Тяжёлые сборки и воспроизведение KiCad при реализации можно выполнять на разрешённом пользователем `ubuntu@192.168.88.101`, с фиксированными версиями инструментов и без доступа к физическому контроллеру.

## 10. Источники

- [ESP32-S3-WROOM-1/WROOM-1U datasheet v1.8](https://documentation.espressif.com/esp32-s3-wroom-1_wroom-1u_datasheet_en.pdf): таблица 1-1, выводы модуля, размер и рекомендованное посадочное место.
- [Espressif: schematic checklist](https://docs.espressif.com/projects/esp-hardware-design-guidelines/en/latest/esp32s3/schematic-checklist.html): питание, EN/strapping и USB.
- [Espressif: PCB layout](https://docs.espressif.com/projects/esp-hardware-design-guidelines/en/latest/esp32s3/pcb-layout-design.html): антенна, непрерывная земля и USB 90 Ом.
- [Espressif: GPIO ESP32-S3](https://docs.espressif.com/projects/esp-idf/en/stable/esp32s3/api-reference/peripherals/gpio.html): ограничения памяти, USB и strapping.
- [Espressif: native USB Serial/JTAG](https://docs.espressif.com/projects/esp-idf/en/stable/esp32s3/api-guides/usb-serial-jtag-console.html): загрузка без UART-моста.
- [ESP32-WROOM-32 datasheet](https://documentation.espressif.com/esp32-wroom-32_datasheet_en.html): другой процессор и занятые Flash GPIO6–11.
- [Профили GaggiMate v1.9.0](https://github.com/jniebuhr/gaggimate/blob/43d2a7ba2299c196fd67c001f455985e07e57a49/lib/GaggiMateController/src/ControllerConfig.h), [параметры платы](https://github.com/jniebuhr/gaggimate/blob/43d2a7ba2299c196fd67c001f455985e07e57a49/boards/Gaggimate-Controller.json).
- [GaggiMate Alba](https://docs.gaggimate.eu/docs/addon-alba/), контроллеры LED/ToF и PCA9634 в исходниках обеих прошивок.
- Текущий проект: `hardware/shield/module-profiles.json`, `docs/shield.md`, `firmware/lib/GemilaiMateController/src/ControllerConfig.h`, `tools/build_release.py`, `tools/flash.py`, `.github/workflows/checks.yml`.
