rico-x/GemilaiMate/hardware/carrier/previews/gemilaimate-carrier.png

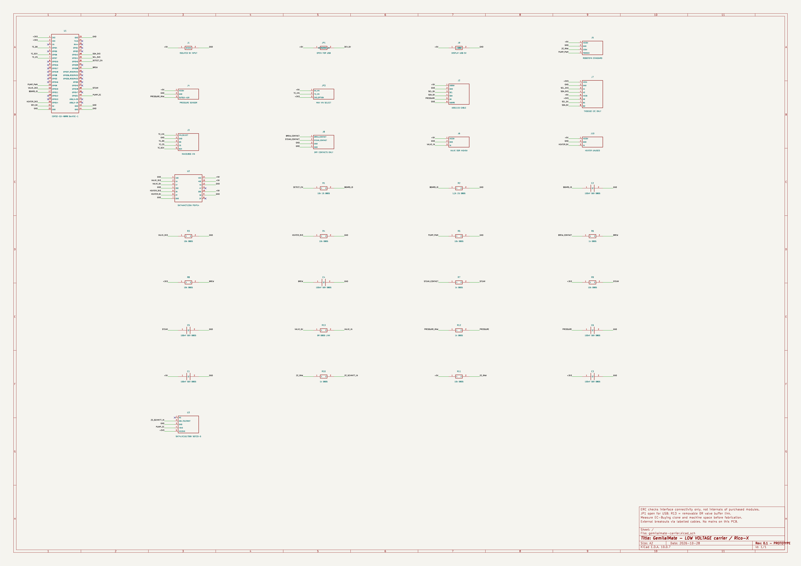
hardware/carrier/previews/gemilaimate-carrier.png
