rico-x/GemilaiMate/hardware/shield-compact/previews/board-bottom.png

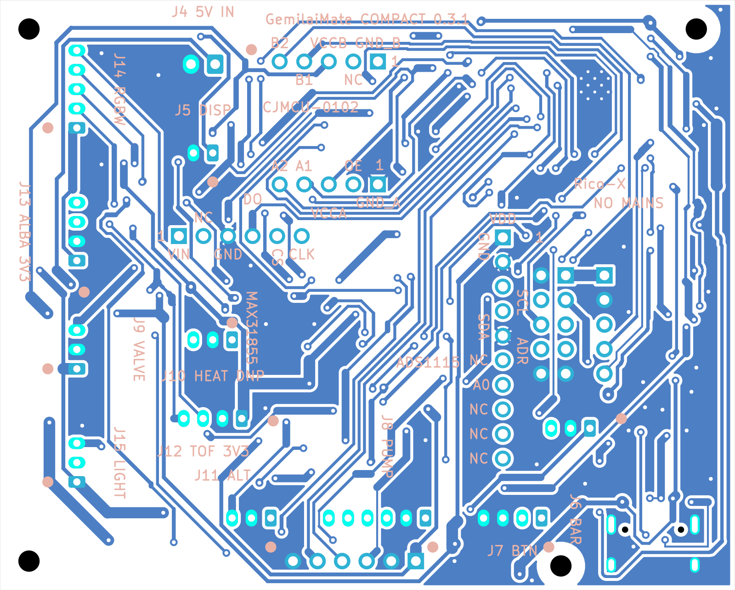
hardware/shield-compact/previews/board-bottom.png
