rico-x/GemilaiMate/hardware/shield-compact/previews/board-top.png

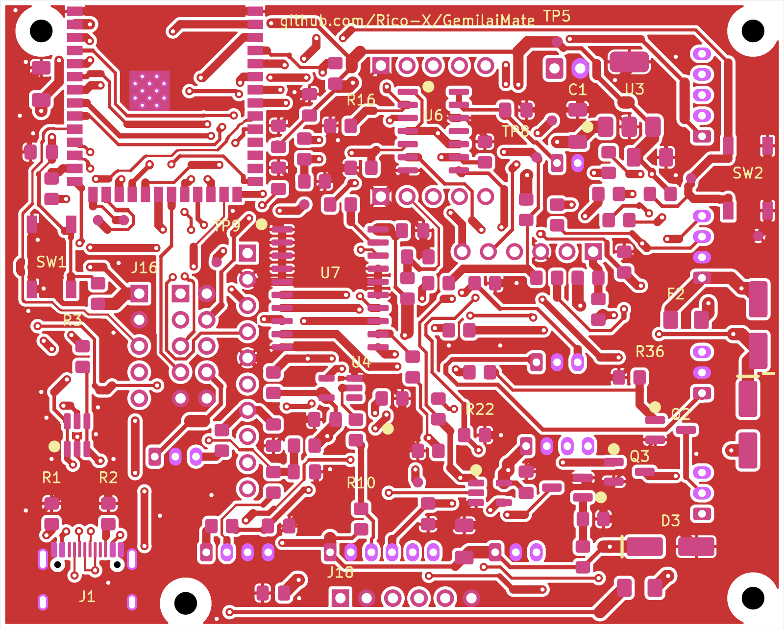
hardware/shield-compact/previews/board-top.png
