rico-x/GemilaiMate/hardware/shield-compact/previews/smd-front.png

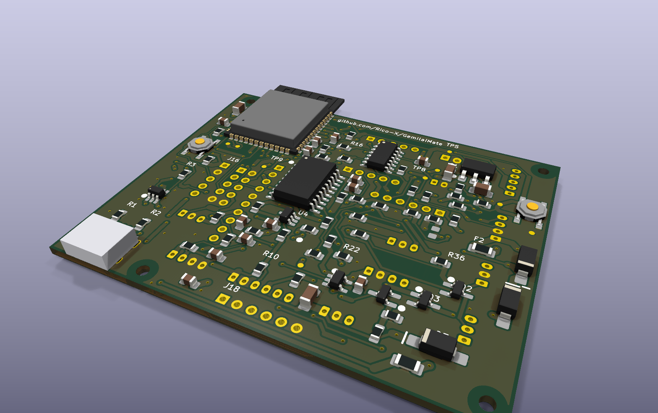
hardware/shield-compact/previews/smd-front.png
