rico-x/GemilaiMate/hardware/shield/previews/board-bottom.png

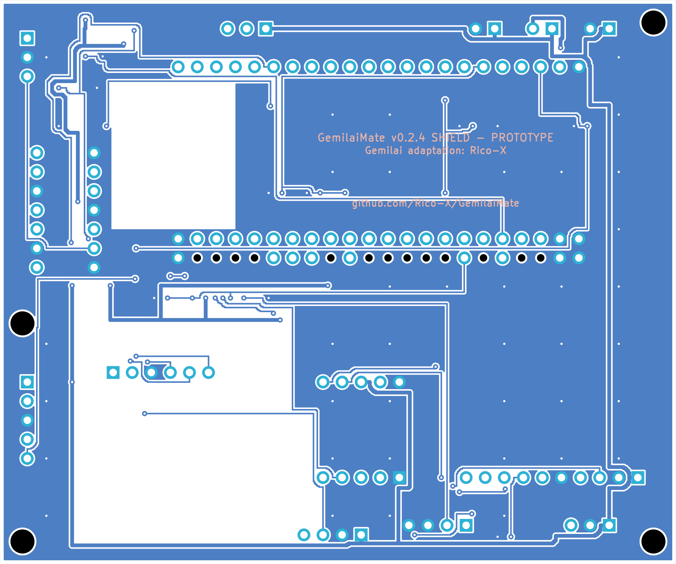
hardware/shield/previews/board-bottom.png
