rico-x/GemilaiMate/hardware/shield/previews/board-top.png

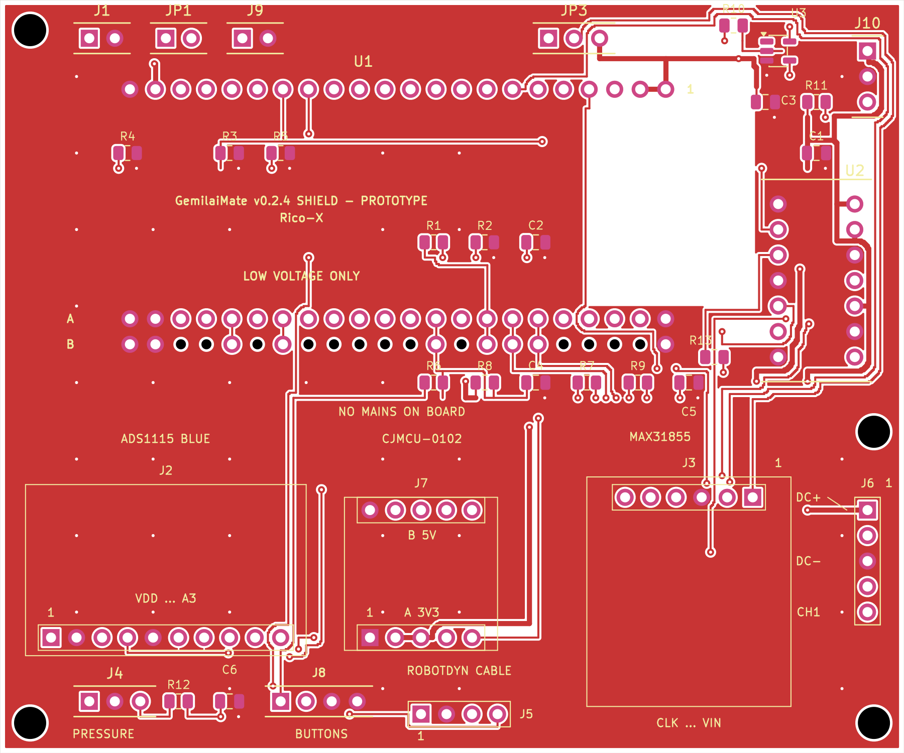
hardware/shield/previews/board-top.png
