rico-x/GemilaiMate/hardware/shield/previews/orientation-silkscreen.png

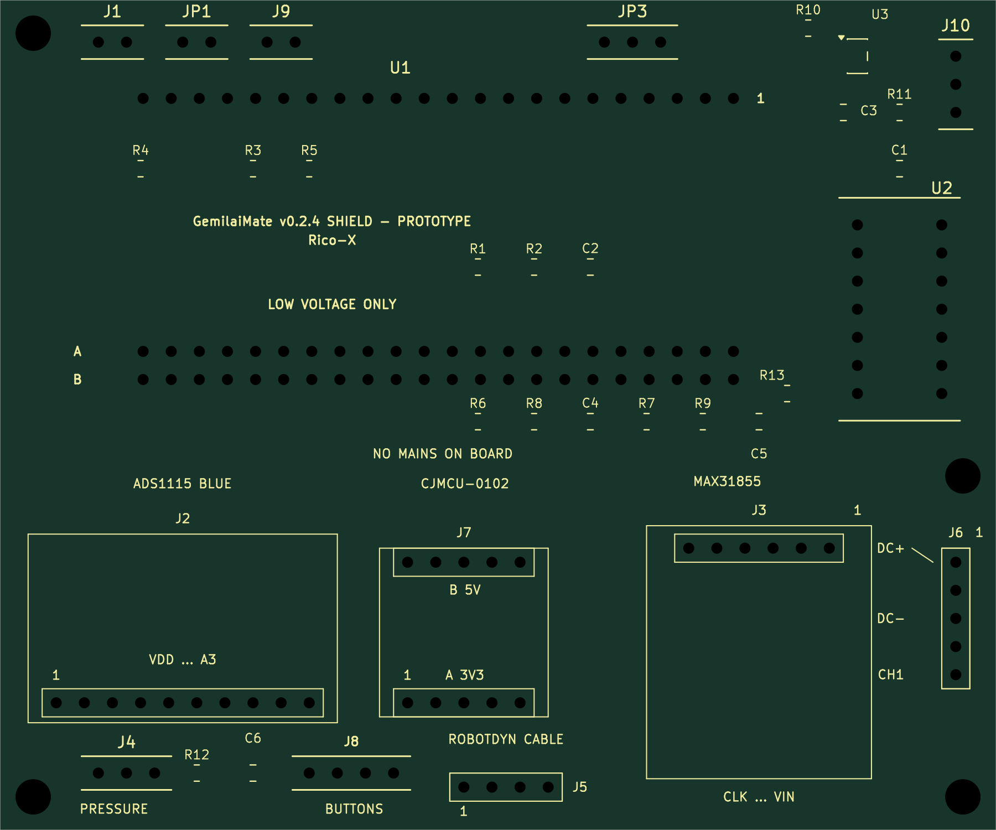
hardware/shield/previews/orientation-silkscreen.png
