rico-x/GemilaiMate/docs/compact-purchase-delta.md

# Что докупить для Compact Shield 0.3.1

Полный список на любое число плат: [страница закупки](https://rico-x.github.io/GemilaiMate/compact-purchase.html). Порядок пайки: [пошаговый монтаж](compact-assembly.md).

Сверка от 04.11.2026: текущий BOM 76×61 мм / 2 слоя и зафиксированная оплаченная закупка от 29.10.2026 в [purchase-kit.md](purchase-kit.md). Позднейшие покупки и фактическое получение посылок этим документом не подтверждаются. Предполагается, что старые упаковки ещё не израсходованы на carrier/shield.

План сохранён: **рассыпуха и разъёмы на платах на 5 PCB, голые WROOM на 3 контроллера, экран/датчики/силовые модули/гидравлика — один комплект на одну машину**. Две платы остаются без MCU. Для первого запуска достаточно одной полностью собранной PCB; столбец «на 1» позволяет заказать минимальный набор.

## Новые печатные платы

Заказать **5 Compact 0.3.1**, 76×61 мм, 2 слоя, 1,6 мм, 1 oz, по [актуальному Gerber ZIP](../hardware/shield-compact/manufacturing/gemilaimate-compact-0.3.1-PROTOTYPE.zip). Ранее заказанные carrier и shield имеют другую разводку.

## Новые SMD-компоненты

Количество без монтажного запаса. Для мелких корпусов разумен запас 10–20%; если упаковка больше потребности, одной упаковки достаточно. Резисторы — **0805, 1%**; конденсаторы — в корпусе и диэлектрике из таблицы. Не покупать 0603/TSSOP вместо предусмотренных корпусов.

| Деталь | Корпус / уточнение | На 1 PCB | По BOM на 5 | Докупить по плану |
|---|---|---:|---:|---:|
| ESP32-S3-WROOM-1-N16R8 | ESP32-S3-WROOM-1 | 1 | 5 | 3 |
| TYPE-C-31-M-12 | USB_C_Receptacle_HRO_TYPE-C-31-M-12 | 1 | 5 | 5 |
| 5.1k 1% | R_0805_2012Metric_Pad1.20x1.40mm_HandSolder | 2 | 10 | 10 |
| 22R 1% | R_0805_2012Metric_Pad1.20x1.40mm_HandSolder | 2 | 10 | 10 |
| USBLC6-2SC6 | SOT-23-6_Handsoldering | 1 | 5 | 5 |
| 1206L050YR 0.5A | Fuse_1206_3216Metric_Pad1.42x1.75mm_HandSolder | 1 | 5 | 5 |
| 1206L150/12 1.5A | Fuse_1206_3216Metric_Pad1.42x1.75mm_HandSolder | 1 | 5 | 5 |
| SS14 | D_SMA_Handsoldering | 2 | 10 | 10 |
| AP7361C-33E-13 | SOT-223-3_TabPin2 | 1 | 5 | 5 |
| 10uF 16V X7R | C_1206_3216Metric_Pad1.33x1.80mm_HandSolder | 4 | 20 | 20 |
| 1uF 16V X7R | C_0805_2012Metric_Pad1.18x1.45mm_HandSolder | 2 | 10 | 10 |
| TL3342F160QG — RESET | SW_SPST_TL3342 | 1 | 5 | 5 |
| TL3342F160QG — BOOT | SW_SPST_TL3342 | 1 | 5 | 5 |
| 1.58k 1% | R_0805_2012Metric_Pad1.20x1.40mm_HandSolder | 1 | 5 | 5 |
| 10nF 50V C0G | C_0805_2012Metric_Pad1.18x1.45mm_HandSolder | 1 | 5 | 5 |
| 47k 1% | R_0805_2012Metric_Pad1.20x1.40mm_HandSolder | 1 | 5 | 5 |
| 100k 1% | R_0805_2012Metric_Pad1.20x1.40mm_HandSolder | 3 | 15 | 15 |
| MMBT3904 | SOT-23_Handsoldering | 1 | 5 | 5 |
| SN74LVC1G125DBVR | SOT-23-5_HandSoldering | 1 | 5 | 5 |
| SN74AHCT125DR | SOIC-14_3.9x8.7mm_P1.27mm | 1 | 5 | 5 |
| PCA9634D | SOIC-20W_7.5x12.8mm_P1.27mm | 1 | 5 | 5 |
| 4.7k 1% | R_0805_2012Metric_Pad1.20x1.40mm_HandSolder | 2 | 10 | 10 |
| 180R 1% | R_0805_2012Metric_Pad1.20x1.40mm_HandSolder | 4 | 20 | 20 |
| 100R 1% | R_0805_2012Metric_Pad1.20x1.40mm_HandSolder | 2 | 10 | 10 |
| AO3400A | SOT-23_Handsoldering | 2 | 10 | 10 |
| SMAJ5.0A | D_SMA_Handsoldering | 1 | 5 | 5 |
| 470R 1% | R_0805_2012Metric_Pad1.20x1.40mm_HandSolder | 2 | 10 | 10 |

Всего новых SMD-позиций для закупки по этому плану — **213 физических деталей**, включая 3 WROOM; ещё **170 деталей** берутся из старых упаковок. Полная сборка всех пяти плат потребует ещё двух WROOM. Это арифметика установок, а не количество товарных упаковок.

Особенно важно:

- Купленные **ESP32-S3 DevKit N8R8** не вставляются в Compact. Нужен **голый ESP32-S3-WROOM-1-N16R8**, не DevKit и не ESP-WROOM-32. Старые DevKit остаются пригодны для прежних carrier/shield и стенда.
- Купленный **SN74AHCT125N DIP-14** не подходит к посадочному месту U6. Нужен **SN74AHCT125DR, SOIC-14**, шаг 1,27 мм. Различие корпусов подтверждено [TI](https://www.ti.com/lit/ds/symlink/sn74ahct125.pdf).
- **PCA9634D** — SOIC-20W, не PCA9685 и не вариант в другом корпусе.
- **AP7361C-33E-13** — предусмотренный стабилизатор 3,3 В в SOT-223; AMS1117 имеет другую распиновку и не является заменой.
- Старые **1,2 кОм** не заменяют **1,58 кОм R8**: этот номинал задаёт аппаратный ID=4.
- Нужен точный **HRO TYPE-C-31-M-12**. USB4085 и произвольный «USB-C 16 pin» не считать совместимыми.
- Предохранители F1/F2 — **самовосстанавливающиеся SMD PTC 1206**. Купленные стеклянные T2A 5×20 для БП выполняют другую задачу.

## Что из старой рассыпухи уже подходит

| Деталь | В зафиксированном заказе | Нужно на 5 Compact | Докупить |
|---|---:|---:|---:|
| 100nF 50V X7R | 100 | 50 | 0 |
| 10k 1% | 100 | 80 | 0 |
| 1k 1% | 100 | 20 | 0 |
| SN74LVC1G17DBVR | 10 | 5 | 0 |
| 0R | 100 | 15 | 0 |

Эти остатки посчитаны до сборки старых плат. Если часть упаковок уже использована, проверить остаток: например, на пять Compact требуется 80 резисторов 10 кОм. Дополнительные партии SN74LVC1G17 не нужны, если основной заказ действительно содержит DBVR/SOT-23-5.

## Разъёмы на пяти PCB

Нужны вертикальные **THT** разъёмы, соответствующие [BOM-THT](../hardware/shield-compact/manufacturing/BOM-THT.csv); разъёмы кабелей находятся с обратной стороны.

| На плату | Полный артикул-пример | На 1 PCB | На 5 PCB |
|---|---|---:|---:|
| JST XH, 2 контакта, шаг 2,50 мм | B2B-XH-A(LF)(SN) | 1 | 5 |
| JST PH, 2 контакта, шаг 2,00 мм | B2B-PH-K-S(LF)(SN) | 1 | 5 |
| JST PH, 3 контакта | B3B-PH-K-S(LF)(SN) | 4 | 20 |
| JST PH, 4 контакта | B4B-PH-K-S(LF)(SN) | 3 | 15 |
| JST PH, 5 контактов | B5B-PH-K-S(LF)(SN) | 1 | 5 |
| JST PH, 6 контактов | B6B-PH-K-S(LF)(SN) | 1 | 5 |

Это полная комплектация разъёмов текущего BOM. Для базовой машины можно пока не устанавливать разъёмы неиспользуемых ALT/ToF/внешней Alba/RGBW/LIGHTS. J10 нагрева — DNP, не покупать для базовой сборки.

**Купленные DuPont не заменяют PH/XH.** Штыревой разъём JST на PCB и ответный кабельный корпус с обжимными контактами — разные детали; нужны оба.

## Ответные корпуса и провод — один комплект жгутов

Для всех предусмотренных портов одной машины: **XHP-2 ×1, PHR-2 ×1, PHR-3 ×4, PHR-4 ×3, PHR-5 ×1, PHR-6 ×1**. Для базового набора достаточно XHP-2 ×1, PHR-2 ×1, PHR-3 ×2, PHR-4 ×1, PHR-6 ×1. Пустые порты не требуют кабелей.

- Контакты PH: SPH-002T-P0.5S либо SPH-002T-P0.5L из BOM; на все порты 35 шт., практично взять 50 с запасом. В PHR-6 RobotDyn заняты только позиции 1–4; 5/6 пустые.
- Контакты XH: SXH-001T-P0.6, на вход питания 2 шт., удобнее небольшой запас.
- Для PH докупить провод **24–28 AWG**, например 24 AWG для питания и 26 AWG для сигналов; диаметр изоляции **0,8–1,5 мм**. Альтернатива — готовые соответствующие PH-жгуты с проверенным сечением и распиновкой.
- Купленный **22 AWG не входит в диапазон SPH-002T-P0.5L**, который ограничен 24–28 AWG. Для входного XH с SXH-001T-P0.6 провод 22 AWG допускается при подходящем диаметре изоляции.

Диапазоны проводов проверены по первичным каталогам [JST PH](https://www.jst-mfg.com/product/pdf/eng/ePH.pdf) и [JST XH](https://www.jst-mfg.com/product/pdf/eng/eXH.pdf). Корпус DuPont с шагом 2,54 мм здесь не подходит. У готового жгута проверить последовательность проводов по HARNESSES, не по цвету.

## Гнёзда модулей и крепёж

Купленные гнёзда и штыри **1×40, 2,54 мм** можно использовать после сверки размеров. На PCB: 1×10 ADS1115, 1×6 MAX31855 и две 1×5 CJMCU — 26 контактов, на пять плат 130. С учётом потерь при резке запаса десяти полос 1×40 достаточно. Отдельные Harwin покупать не обязательно, если полученные гнёзда совпадут с требуемым монтажом и высотой.

Проверить высоту гнезда ≥8,5 мм и сборочный просвет примерно 11 мм под модулем, межрядье CJMCU 12,70 мм и штыри для установки с нижней стороны модулей. Реальные клоны пока не измерены.

Докупается **нейлоновый крепёж M2**: 4 точки на установленную плату, головка винта ≤4 мм. Старый M3 не входит в отверстия Compact Ø2,2 мм. Для одной машины достаточно одного набора на 4 точки; 20 комплектов винт/стойка/гайка нужны только если одновременно закреплять все пять PCB. Высоты стоек выбрать по разъёмам снизу и реальному свободному месту в машине.

## Повторно не покупать

Из зафиксированного комплекта переиспользуются: дисплей LilyGo T-RGB 2.1, ADS1115 Blue, MAX31855, CJMCU-0102, RobotDyn, один SSR клапана, XDB401, термопара, MEAN WELL RS-25-5, USB-кабель данных, стендовые приборы и инструменты. Гидравлика не меняется из-за этой ревизии PCB; её прежние неразрешённые вопросы по размерам и герметичности остаются. Один комплект вставных модулей можно переставлять между опытными платами.

VL53L0X и сами световые нагрузки RGBW/подсветки в старой закупке не подтверждены. Они нужны только для соответствующих дополнительных функций. Дополнительный SSR нужен лишь при использовании отдельного ALT-выхода. Внешнюю Alba для работы встроенного PCA9634 покупать не требуется.

## Старые незакрытые покупки

В прежнем списке также не отмечены как купленные:

- Переключатель режима «Штат/GM», если сохраняется такой способ переключения машины; сверять с окончательной схемой силовой проводки.
- ФУМ-лента либо другой подходящий уплотнитель, только если фактические фитинги требуют резьбового уплотнения. Для плоского G1/4 датчика используется предусмотренная прокладка, а не автоматическая намотка ленты.
- VL53L0X — только если нужен датчик уровня, и сами световые нагрузки — если нужна подсветка.

Эти позиции не являются следствием новой PCB. Существующие кнопки машины можно использовать только после определения их электрической схемы; входы Compact рассчитаны на сухие контакты к GND.

## Монтаж WROOM

У WROOM есть скрытая центральная земля. Для её надёжной пайки предусмотреть доступ к подходящему оборудованию прогрева/оплавления либо монтажнику; это не означает обязательную покупку термопинцета. Одного обычного паяльника может оказаться недостаточно. Производитель задаёт монтаж оплавлением: [Espressif, раздел Product Handling](https://www.espressif.com/sites/default/files/documentation/esp32-s3-wroom-1_wroom-1u_datasheet_en.pdf).

Наличие и цены новых товаров здесь не проверялись; документ фиксирует требуемые детали, корпуса и количество, а не готовую корзину.
