rico-x/GemilaiMate/hardware/shield-compact/manufacturing/BOM-SMD.csv

Designators | Quantity_1_PCB | Quantity_5_PCB | Value | MPN_example | Footprint
U1 | 1 | 5 | ESP32-S3-WROOM-1-N16R8 | ESP32-S3-WROOM-1-N16R8 | GemilaiMateCompact:ESP32-S3-WROOM-1
J1 | 1 | 5 | TYPE-C-31-M-12 | TYPE-C-31-M-12 | GemilaiMateCompact:USB_C_Receptacle_HRO_TYPE-C-31-M-12
R1 R2 | 2 | 10 | 5.1k 1% | RC0805FR-075K1L | GemilaiMateCompact:R_0805_2012Metric_Pad1.20x1.40mm_HandSolder
R3 R4 | 2 | 10 | 22R 1% | RC0805FR-0722RL | GemilaiMateCompact:R_0805_2012Metric_Pad1.20x1.40mm_HandSolder
U2 | 1 | 5 | USBLC6-2SC6 | USBLC6-2SC6 | GemilaiMateCompact:SOT-23-6_Handsoldering
F1 | 1 | 5 | 1206L050YR 0.5A | 1206L050YR | GemilaiMateCompact:Fuse_1206_3216Metric_Pad1.42x1.75mm_HandSolder
F2 | 1 | 5 | 1206L150/12 1.5A | 1206L150/12SLYR | GemilaiMateCompact:Fuse_1206_3216Metric_Pad1.42x1.75mm_HandSolder
D1 D2 | 2 | 10 | SS14 | SS14-13-F | GemilaiMateCompact:D_SMA_Handsoldering
U3 | 1 | 5 | AP7361C-33E-13 | AP7361C-33E-13 | GemilaiMateCompact:SOT-223-3_TabPin2
C1 C2 C3 C16 | 4 | 20 | 10uF 16V X7R | GRM31CR71C106KAC7L | GemilaiMateCompact:C_1206_3216Metric_Pad1.33x1.80mm_HandSolder
C4 C7 C8 C9 C10 C11 C12 C13 C14 C15 | 10 | 50 | 100nF 50V X7R | GRM21BR71H104KA01L | GemilaiMateCompact:C_0805_2012Metric_Pad1.18x1.45mm_HandSolder
R5 R6 R7 R10 R14 R15 R16 R17 R18 R19 R20 R21 R22 R24 R26 R43 | 16 | 80 | 10k 1% | RC0805FR-0710KL | GemilaiMateCompact:R_0805_2012Metric_Pad1.20x1.40mm_HandSolder
C5 C17 | 2 | 10 | 1uF 16V X7R | GRM21BR71C105KA01L | GemilaiMateCompact:C_0805_2012Metric_Pad1.18x1.45mm_HandSolder
SW1 | 1 | 5 | RESET | TL3342F160QG | GemilaiMateCompact:SW_SPST_TL3342
SW2 | 1 | 5 | BOOT | TL3342F160QG | GemilaiMateCompact:SW_SPST_TL3342
R8 | 1 | 5 | 1.58k 1% | RC0805FR-071K58L | GemilaiMateCompact:R_0805_2012Metric_Pad1.20x1.40mm_HandSolder
C6 | 1 | 5 | 10nF 50V C0G | GRM2165C1H103JA01D | GemilaiMateCompact:C_0805_2012Metric_Pad1.18x1.45mm_HandSolder
R9 R11 R23 R25 | 4 | 20 | 1k 1% | RC0805FR-071KL | GemilaiMateCompact:R_0805_2012Metric_Pad1.20x1.40mm_HandSolder
U4 | 1 | 5 | SN74LVC1G17DBVR | SN74LVC1G17DBVR | GemilaiMateCompact:SOT-23-5_HandSoldering
R12 | 1 | 5 | 47k 1% | RC0805FR-0747KL | GemilaiMateCompact:R_0805_2012Metric_Pad1.20x1.40mm_HandSolder
R13 R36 R38 | 3 | 15 | 100k 1% | RC0805FR-07100KL | GemilaiMateCompact:R_0805_2012Metric_Pad1.20x1.40mm_HandSolder
Q1 | 1 | 5 | MMBT3904 | MMBT3904-7-F | GemilaiMateCompact:SOT-23_Handsoldering
U5 | 1 | 5 | SN74LVC1G125DBVR | SN74LVC1G125DBVR | GemilaiMateCompact:SOT-23-5_HandSoldering
U6 | 1 | 5 | SN74AHCT125DR | SN74AHCT125DR | GemilaiMateCompact:SOIC-14_3.9x8.7mm_P1.27mm
U7 | 1 | 5 | PCA9634D | PCA9634D,118 | GemilaiMateCompact:SOIC-20W_7.5x12.8mm_P1.27mm
R27 R28 R41 | 3 | 15 | 0R | RC0805JR-070RL | GemilaiMateCompact:R_0805_2012Metric_Pad1.20x1.40mm_HandSolder
R29 R30 | 2 | 10 | 4.7k 1% | RC0805FR-074K7L | GemilaiMateCompact:R_0805_2012Metric_Pad1.20x1.40mm_HandSolder
R31 R32 R33 R34 | 4 | 20 | 180R 1% | RC0805FR-07180RL | GemilaiMateCompact:R_0805_2012Metric_Pad1.20x1.40mm_HandSolder
R35 R37 | 2 | 10 | 100R 1% | RC0805FR-07100RL | GemilaiMateCompact:R_0805_2012Metric_Pad1.20x1.40mm_HandSolder
Q2 Q3 | 2 | 10 | AO3400A | AO3400A | GemilaiMateCompact:SOT-23_Handsoldering
D3 | 1 | 5 | SMAJ5.0A | SMAJ5.0A | GemilaiMateCompact:D_SMA_Handsoldering
R39 R40 | 2 | 10 | 470R 1% | RC0805FR-07470RL | GemilaiMateCompact:R_0805_2012Metric_Pad1.20x1.40mm_HandSolder
