rico-x/GemilaiMate/hardware/shield-compact/manufacturing/BOM-THT.csv

Reference | Alias | Description | MPN_example | Side | Assembly_note
J2 | J_ADS | ADS1115 BLUE SOCKET | M20-7821046 | front | Verify exact mating part and pin 1 against assembly drawing
J3 | J_TC | MAX31855 SOCKET | M20-7820646 | front | Verify exact mating part and pin 1 against assembly drawing
J4 | J_PWR | 5V INPUT | B2B-XH-A(LF)(SN) | back | Verify exact mating part and pin 1 against assembly drawing
J5 | J_DISPLAY | DISPLAY 5V | B2B-PH-K-S(LF)(SN) | back | Verify exact mating part and pin 1 against assembly drawing
J6 | J_PRESS | PRESSURE | B3B-PH-K-S(LF)(SN) | back | Verify exact mating part and pin 1 against assembly drawing
J7 | J_BUTTONS | BUTTONS | B4B-PH-K-S(LF)(SN) | back | Verify exact mating part and pin 1 against assembly drawing
J8 | J_PUMP | ROBOTDYN | B6B-PH-K-S(LF)(SN) | back | Verify exact mating part and pin 1 against assembly drawing
J9 | J_VALVE | VALVE SSR | B3B-PH-K-S(LF)(SN) | back | Verify exact mating part and pin 1 against assembly drawing
J11 | J_ALT | ALT SSR | B3B-PH-K-S(LF)(SN) | back | Verify exact mating part and pin 1 against assembly drawing
J12 | J_TOF | VL53L0X 3V3 | B4B-PH-K-S(LF)(SN) | back | Verify exact mating part and pin 1 against assembly drawing
J13 | J_ALBA | EXTERNAL ALBA | B4B-PH-K-S(LF)(SN) | back | Verify exact mating part and pin 1 against assembly drawing
J14 | J_RGBW | RGBW CA | B5B-PH-K-S(LF)(SN) | back | Verify exact mating part and pin 1 against assembly drawing
J15 | J_LIGHT | LIGHTS 200mA TOTAL | B3B-PH-K-S(LF)(SN) | back | Verify exact mating part and pin 1 against assembly drawing
J19 | J_LEVEL | CJMCU-0102 TXS0102 SOCKET | 2 x Harwin M20-7820546 | front | Verify exact mating part and pin 1 against assembly drawing
