rico-x/GemilaiMate/hardware/shield-compact/manufacturing/BOM.csv

Reference | Function_alias | Description | MPN_example | Footprint | Side | DNP | Quantity_1_PCB | Quantity_5_PCB
U1 | U1 | ESP32-S3-WROOM-1-N16R8 | ESP32-S3-WROOM-1-N16R8 | GemilaiMateCompact:ESP32-S3-WROOM-1 | front | 0 | 1 | 5
J1 | J_USB | TYPE-C-31-M-12 | TYPE-C-31-M-12 | GemilaiMateCompact:USB_C_Receptacle_HRO_TYPE-C-31-M-12 | front | 0 | 1 | 5
R1 | R_CC1 | 5.1k 1% | RC0805FR-075K1L | GemilaiMateCompact:R_0805_2012Metric_Pad1.20x1.40mm_HandSolder | front | 0 | 1 | 5
R2 | R_CC2 | 5.1k 1% | RC0805FR-075K1L | GemilaiMateCompact:R_0805_2012Metric_Pad1.20x1.40mm_HandSolder | front | 0 | 1 | 5
R3 | R_USBP | 22R 1% | RC0805FR-0722RL | GemilaiMateCompact:R_0805_2012Metric_Pad1.20x1.40mm_HandSolder | front | 0 | 1 | 5
R4 | R_USBM | 22R 1% | RC0805FR-0722RL | GemilaiMateCompact:R_0805_2012Metric_Pad1.20x1.40mm_HandSolder | front | 0 | 1 | 5
U2 | U_ESD | USBLC6-2SC6 | USBLC6-2SC6 | GemilaiMateCompact:SOT-23-6_Handsoldering | front | 0 | 1 | 5
F1 | F_USB | 1206L050YR 0.5A | 1206L050YR | GemilaiMateCompact:Fuse_1206_3216Metric_Pad1.42x1.75mm_HandSolder | front | 0 | 1 | 5
F2 | F_EXT | 1206L150/12 1.5A | 1206L150/12SLYR | GemilaiMateCompact:Fuse_1206_3216Metric_Pad1.42x1.75mm_HandSolder | front | 0 | 1 | 5
D1 | D_USB | SS14 | SS14-13-F | GemilaiMateCompact:D_SMA_Handsoldering | front | 0 | 1 | 5
D2 | D_EXT | SS14 | SS14-13-F | GemilaiMateCompact:D_SMA_Handsoldering | front | 0 | 1 | 5
U3 | U_REG | AP7361C-33E-13 | AP7361C-33E-13 | GemilaiMateCompact:SOT-223-3_TabPin2 | front | 0 | 1 | 5
C1 | C_IN | 10uF 16V X7R | GRM31CR71C106KAC7L | GemilaiMateCompact:C_1206_3216Metric_Pad1.33x1.80mm_HandSolder | front | 0 | 1 | 5
C2 | C_OUT | 10uF 16V X7R | GRM31CR71C106KAC7L | GemilaiMateCompact:C_1206_3216Metric_Pad1.33x1.80mm_HandSolder | front | 0 | 1 | 5
C3 | C_MCU | 10uF 16V X7R | GRM31CR71C106KAC7L | GemilaiMateCompact:C_1206_3216Metric_Pad1.33x1.80mm_HandSolder | front | 0 | 1 | 5
C4 | C_MCUHF | 100nF 50V X7R | GRM21BR71H104KA01L | GemilaiMateCompact:C_0805_2012Metric_Pad1.18x1.45mm_HandSolder | front | 0 | 1 | 5
R5 | R_EN | 10k 1% | RC0805FR-0710KL | GemilaiMateCompact:R_0805_2012Metric_Pad1.20x1.40mm_HandSolder | front | 0 | 1 | 5
C5 | C_EN | 1uF 16V X7R | GRM21BR71C105KA01L | GemilaiMateCompact:C_0805_2012Metric_Pad1.18x1.45mm_HandSolder | front | 0 | 1 | 5
R6 | R_BOOT | 10k 1% | RC0805FR-0710KL | GemilaiMateCompact:R_0805_2012Metric_Pad1.20x1.40mm_HandSolder | front | 0 | 1 | 5
SW1 | SW_RESET | RESET | TL3342F160QG | GemilaiMateCompact:SW_SPST_TL3342 | front | 0 | 1 | 5
SW2 | SW_BOOT | BOOT | TL3342F160QG | GemilaiMateCompact:SW_SPST_TL3342 | front | 0 | 1 | 5
R7 | R_ID_TOP | 10k 1% | RC0805FR-0710KL | GemilaiMateCompact:R_0805_2012Metric_Pad1.20x1.40mm_HandSolder | front | 0 | 1 | 5
R8 | R_ID_LOW | 1.58k 1% | RC0805FR-071K58L | GemilaiMateCompact:R_0805_2012Metric_Pad1.20x1.40mm_HandSolder | front | 0 | 1 | 5
C6 | C_ID | 10nF 50V C0G | GRM2165C1H103JA01D | GemilaiMateCompact:C_0805_2012Metric_Pad1.18x1.45mm_HandSolder | front | 0 | 1 | 5
C7 | C_LVA | 100nF 50V X7R | GRM21BR71H104KA01L | GemilaiMateCompact:C_0805_2012Metric_Pad1.18x1.45mm_HandSolder | front | 0 | 1 | 5
C8 | C_LVB | 100nF 50V X7R | GRM21BR71H104KA01L | GemilaiMateCompact:C_0805_2012Metric_Pad1.18x1.45mm_HandSolder | front | 0 | 1 | 5
J2 | J_ADS | ADS1115 BLUE SOCKET | M20-7821046 | GemilaiMateCompact:ADS1115_socket | front | 0 | 1 | 5
R9 | R_PRESS | 1k 1% | RC0805FR-071KL | GemilaiMateCompact:R_0805_2012Metric_Pad1.20x1.40mm_HandSolder | front | 0 | 1 | 5
C9 | C_PRESS | 100nF 50V X7R | GRM21BR71H104KA01L | GemilaiMateCompact:C_0805_2012Metric_Pad1.18x1.45mm_HandSolder | front | 0 | 1 | 5
J3 | J_TC | MAX31855 SOCKET | M20-7820646 | GemilaiMateCompact:MAX31855_socket | front | 0 | 1 | 5
R10 | R_ZCPU | 10k 1% | RC0805FR-0710KL | GemilaiMateCompact:R_0805_2012Metric_Pad1.20x1.40mm_HandSolder | front | 0 | 1 | 5
R11 | R_ZCS | 1k 1% | RC0805FR-071KL | GemilaiMateCompact:R_0805_2012Metric_Pad1.20x1.40mm_HandSolder | front | 0 | 1 | 5
U4 | U_ZC | SN74LVC1G17DBVR | SN74LVC1G17DBVR | GemilaiMateCompact:SOT-23-5_HandSoldering | front | 0 | 1 | 5
C10 | C_ZC | 100nF 50V X7R | GRM21BR71H104KA01L | GemilaiMateCompact:C_0805_2012Metric_Pad1.18x1.45mm_HandSolder | front | 0 | 1 | 5
R12 | R_EXT_BASE | 47k 1% | RC0805FR-0747KL | GemilaiMateCompact:R_0805_2012Metric_Pad1.20x1.40mm_HandSolder | front | 0 | 1 | 5
R13 | R_EXT_PD | 100k 1% | RC0805FR-07100KL | GemilaiMateCompact:R_0805_2012Metric_Pad1.20x1.40mm_HandSolder | front | 0 | 1 | 5
Q1 | Q_EXT | MMBT3904 | MMBT3904-7-F | GemilaiMateCompact:SOT-23_Handsoldering | front | 0 | 1 | 5
R14 | R_OEUP | 10k 1% | RC0805FR-0710KL | GemilaiMateCompact:R_0805_2012Metric_Pad1.20x1.40mm_HandSolder | front | 0 | 1 | 5
U5 | U_PUMP | SN74LVC1G125DBVR | SN74LVC1G125DBVR | GemilaiMateCompact:SOT-23-5_HandSoldering | front | 0 | 1 | 5
U6 | U_SSR | SN74AHCT125DR | SN74AHCT125DR | GemilaiMateCompact:SOIC-14_3.9x8.7mm_P1.27mm | front | 0 | 1 | 5
C11 | C_SSR | 100nF 50V X7R | GRM21BR71H104KA01L | GemilaiMateCompact:C_0805_2012Metric_Pad1.18x1.45mm_HandSolder | front | 0 | 1 | 5
C12 | C_PUMP | 100nF 50V X7R | GRM21BR71H104KA01L | GemilaiMateCompact:C_0805_2012Metric_Pad1.18x1.45mm_HandSolder | front | 0 | 1 | 5
R15 | R_PD1 | 10k 1% | RC0805FR-0710KL | GemilaiMateCompact:R_0805_2012Metric_Pad1.20x1.40mm_HandSolder | front | 0 | 1 | 5
R16 | R_PD2 | 10k 1% | RC0805FR-0710KL | GemilaiMateCompact:R_0805_2012Metric_Pad1.20x1.40mm_HandSolder | front | 0 | 1 | 5
R17 | R_PD3 | 10k 1% | RC0805FR-0710KL | GemilaiMateCompact:R_0805_2012Metric_Pad1.20x1.40mm_HandSolder | front | 0 | 1 | 5
R18 | R_PD4 | 10k 1% | RC0805FR-0710KL | GemilaiMateCompact:R_0805_2012Metric_Pad1.20x1.40mm_HandSolder | front | 0 | 1 | 5
R19 | R_PD5 | 10k 1% | RC0805FR-0710KL | GemilaiMateCompact:R_0805_2012Metric_Pad1.20x1.40mm_HandSolder | front | 0 | 1 | 5
R20 | R_OUT_VALVE | 10k 1% | RC0805FR-0710KL | GemilaiMateCompact:R_0805_2012Metric_Pad1.20x1.40mm_HandSolder | front | 0 | 1 | 5
R21 | R_OUT_HEATER | 10k 1% | RC0805FR-0710KL | GemilaiMateCompact:R_0805_2012Metric_Pad1.20x1.40mm_HandSolder | front | 0 | 1 | 5
R22 | R_OUT_ALT | 10k 1% | RC0805FR-0710KL | GemilaiMateCompact:R_0805_2012Metric_Pad1.20x1.40mm_HandSolder | front | 0 | 1 | 5
R23 | R_BREW | 1k 1% | RC0805FR-071KL | GemilaiMateCompact:R_0805_2012Metric_Pad1.20x1.40mm_HandSolder | front | 0 | 1 | 5
R24 | R_BREWPU | 10k 1% | RC0805FR-0710KL | GemilaiMateCompact:R_0805_2012Metric_Pad1.20x1.40mm_HandSolder | front | 0 | 1 | 5
C13 | C_BREW | 100nF 50V X7R | GRM21BR71H104KA01L | GemilaiMateCompact:C_0805_2012Metric_Pad1.18x1.45mm_HandSolder | front | 0 | 1 | 5
R25 | R_STEAM | 1k 1% | RC0805FR-071KL | GemilaiMateCompact:R_0805_2012Metric_Pad1.20x1.40mm_HandSolder | front | 0 | 1 | 5
R26 | R_STEAMPU | 10k 1% | RC0805FR-0710KL | GemilaiMateCompact:R_0805_2012Metric_Pad1.20x1.40mm_HandSolder | front | 0 | 1 | 5
C14 | C_STEAM | 100nF 50V X7R | GRM21BR71H104KA01L | GemilaiMateCompact:C_0805_2012Metric_Pad1.18x1.45mm_HandSolder | front | 0 | 1 | 5
U7 | U_LED | PCA9634D | PCA9634D,118 | GemilaiMateCompact:SOIC-20W_7.5x12.8mm_P1.27mm | front | 0 | 1 | 5
R27 | R_PCACLK | 0R | RC0805JR-070RL | GemilaiMateCompact:R_0805_2012Metric_Pad1.20x1.40mm_HandSolder | front | 0 | 1 | 5
R28 | R_PCADAT | 0R | RC0805JR-070RL | GemilaiMateCompact:R_0805_2012Metric_Pad1.20x1.40mm_HandSolder | front | 0 | 1 | 5
C15 | C_PCA | 100nF 50V X7R | GRM21BR71H104KA01L | GemilaiMateCompact:C_0805_2012Metric_Pad1.18x1.45mm_HandSolder | front | 0 | 1 | 5
R29 | R_ALBASDA | 4.7k 1% | RC0805FR-074K7L | GemilaiMateCompact:R_0805_2012Metric_Pad1.20x1.40mm_HandSolder | front | 0 | 1 | 5
R30 | R_ALBASCL | 4.7k 1% | RC0805FR-074K7L | GemilaiMateCompact:R_0805_2012Metric_Pad1.20x1.40mm_HandSolder | front | 0 | 1 | 5
R31 | R_LED0 | 180R 1% | RC0805FR-07180RL | GemilaiMateCompact:R_0805_2012Metric_Pad1.20x1.40mm_HandSolder | front | 0 | 1 | 5
R32 | R_LED1 | 180R 1% | RC0805FR-07180RL | GemilaiMateCompact:R_0805_2012Metric_Pad1.20x1.40mm_HandSolder | front | 0 | 1 | 5
R33 | R_LED2 | 180R 1% | RC0805FR-07180RL | GemilaiMateCompact:R_0805_2012Metric_Pad1.20x1.40mm_HandSolder | front | 0 | 1 | 5
R34 | R_LED3 | 180R 1% | RC0805FR-07180RL | GemilaiMateCompact:R_0805_2012Metric_Pad1.20x1.40mm_HandSolder | front | 0 | 1 | 5
R35 | R_GATE4 | 100R 1% | RC0805FR-07100RL | GemilaiMateCompact:R_0805_2012Metric_Pad1.20x1.40mm_HandSolder | front | 0 | 1 | 5
R36 | R_GPD4 | 100k 1% | RC0805FR-07100KL | GemilaiMateCompact:R_0805_2012Metric_Pad1.20x1.40mm_HandSolder | front | 0 | 1 | 5
Q2 | Q_LED4 | AO3400A | AO3400A | GemilaiMateCompact:SOT-23_Handsoldering | front | 0 | 1 | 5
R37 | R_GATE5 | 100R 1% | RC0805FR-07100RL | GemilaiMateCompact:R_0805_2012Metric_Pad1.20x1.40mm_HandSolder | front | 0 | 1 | 5
R38 | R_GPD5 | 100k 1% | RC0805FR-07100KL | GemilaiMateCompact:R_0805_2012Metric_Pad1.20x1.40mm_HandSolder | front | 0 | 1 | 5
Q3 | Q_LED5 | AO3400A | AO3400A | GemilaiMateCompact:SOT-23_Handsoldering | front | 0 | 1 | 5
J4 | J_PWR | 5V INPUT | B2B-XH-A(LF)(SN) | GemilaiMateCompact:JST_XH_B2B-XH-A_1x02_P2.50mm_Vertical | back | 0 | 1 | 5
J5 | J_DISPLAY | DISPLAY 5V | B2B-PH-K-S(LF)(SN) | GemilaiMateCompact:JST_PH_B2B-PH-K_1x02_P2.00mm_Vertical | back | 0 | 1 | 5
J6 | J_PRESS | PRESSURE | B3B-PH-K-S(LF)(SN) | GemilaiMateCompact:JST_PH_B3B-PH-K_1x03_P2.00mm_Vertical | back | 0 | 1 | 5
J7 | J_BUTTONS | BUTTONS | B4B-PH-K-S(LF)(SN) | GemilaiMateCompact:JST_PH_B4B-PH-K_1x04_P2.00mm_Vertical | back | 0 | 1 | 5
J8 | J_PUMP | ROBOTDYN | B6B-PH-K-S(LF)(SN) | GemilaiMateCompact:JST_PH_B6B-PH-K_1x06_P2.00mm_Vertical | back | 0 | 1 | 5
J9 | J_VALVE | VALVE SSR | B3B-PH-K-S(LF)(SN) | GemilaiMateCompact:JST_PH_B3B-PH-K_1x03_P2.00mm_Vertical | back | 0 | 1 | 5
J10 | J_HEAT | HEATER UNUSED | B3B-PH-K-S(LF)(SN) | GemilaiMateCompact:JST_PH_B3B-PH-K_1x03_P2.00mm_Vertical | back | 1 | 0 | 0
J11 | J_ALT | ALT SSR | B3B-PH-K-S(LF)(SN) | GemilaiMateCompact:JST_PH_B3B-PH-K_1x03_P2.00mm_Vertical | back | 0 | 1 | 5
J12 | J_TOF | VL53L0X 3V3 | B4B-PH-K-S(LF)(SN) | GemilaiMateCompact:JST_PH_B4B-PH-K_1x04_P2.00mm_Vertical | back | 0 | 1 | 5
J13 | J_ALBA | EXTERNAL ALBA | B4B-PH-K-S(LF)(SN) | GemilaiMateCompact:JST_PH_B4B-PH-K_1x04_P2.00mm_Vertical | back | 0 | 1 | 5
J14 | J_RGBW | RGBW CA | B5B-PH-K-S(LF)(SN) | GemilaiMateCompact:JST_PH_B5B-PH-K_1x05_P2.00mm_Vertical | back | 0 | 1 | 5
J15 | J_LIGHT | LIGHTS 200mA TOTAL | B3B-PH-K-S(LF)(SN) | GemilaiMateCompact:JST_PH_B3B-PH-K_1x03_P2.00mm_Vertical | back | 0 | 1 | 5
J16 | J_SCALE | SCALE 3V3 | SCALE 3V3 | GemilaiMateCompact:PinHeader_1x05_P2.54mm_Vertical | front | 1 | 0 | 0
J17 | J_EXT | EXT 3V3 | EXT 3V3 | GemilaiMateCompact:PinHeader_2x05_P2.54mm_Vertical | front | 1 | 0 | 0
J18 | J_FREE | FREE GPIO 3V3 | FREE GPIO 3V3 | GemilaiMateCompact:PinHeader_1x06_P2.54mm_Vertical | front | 1 | 0 | 0
J19 | J_LEVEL | CJMCU-0102 TXS0102 SOCKET | 2 x Harwin M20-7820546 | GemilaiMateCompact:CJMCU0102_socket | front | 0 | 1 | 5
D3 | D_TVS | SMAJ5.0A | SMAJ5.0A | GemilaiMateCompact:D_SMA_Handsoldering | front | 0 | 1 | 5
C16 | C_EXT | 10uF 16V X7R | GRM31CR71C106KAC7L | GemilaiMateCompact:C_1206_3216Metric_Pad1.33x1.80mm_HandSolder | front | 0 | 1 | 5
R39 | R_EXTSDA | 470R 1% | RC0805FR-07470RL | GemilaiMateCompact:R_0805_2012Metric_Pad1.20x1.40mm_HandSolder | front | 0 | 1 | 5
R40 | R_EXTSCL | 470R 1% | RC0805FR-07470RL | GemilaiMateCompact:R_0805_2012Metric_Pad1.20x1.40mm_HandSolder | front | 0 | 1 | 5
R41 | R_TC3V3 | 0R | RC0805JR-070RL | GemilaiMateCompact:R_0805_2012Metric_Pad1.20x1.40mm_HandSolder | front | 0 | 1 | 5
R42 | R_TC5V | 0R | RC0805JR-070RL | GemilaiMateCompact:R_0805_2012Metric_Pad1.20x1.40mm_HandSolder | front | 1 | 0 | 0
R43 | R_OE | 10k 1% | RC0805FR-0710KL | GemilaiMateCompact:R_0805_2012Metric_Pad1.20x1.40mm_HandSolder | front | 0 | 1 | 5
C17 | C_OE | 1uF 16V X7R | GRM21BR71C105KA01L | GemilaiMateCompact:C_0805_2012Metric_Pad1.18x1.45mm_HandSolder | front | 0 | 1 | 5
