rico-x/GemilaiMate/hardware/shield/manufacturing/BOM-THT.csv

Reference | Quantity_per_board | Description | Assembly_notes
U1 upper/lower | 2 | 1x22 female 2.54mm >=8.5mm nominal | Populate ONE of the lower alternatives; verify real DevKit
U2 | 1 | SN74AHCT125N PDIP-14 | Same logic as carrier v0.1
J2 | 1 | 1x10 female 2.54mm >=8.5mm | ADS1115 Blue; ten pins, ADDR wired GND
J7 | 2 | 1x5 female 2.54mm >=8.5mm | CJMCU-0102 rows 12.70mm ASSUMED; extra G left NC
J3 | 1 | 1x6 female 2.54mm >=8.5mm | MAX31855 VIN,3Vo NC,GND,DO,CS,CLK
J5 | 1 | 1x4 female 2.54mm >=8.5mm | Four-wire control harness to separately retained RobotDyn; pin 1 LEFT; no direct docking
J6 | 1 | 1x5 female 2.54mm >=8.5mm | Three-wire control harness, shield pins 1/3/5 to original SSR DC+/DC-/CH1 screw terminal; 2/4 NC
J1 J9 JP1 | 3 | 1x2 male 2.54mm | Power/display/USB disconnect
J4 J10 JP3 | 3 | 1x3 male 2.54mm | Pressure / unused heater / MAX VIN select
J8 | 1 | 1x4 male 2.54mm | Dry contact buttons only
JP1 JP3 shunts | 2 | 2.54mm removable shunt | Open JP1 for USB
Module-side headers | 1 | 1x10 + (2 x 1x5) + 1x6 male 2.54mm | TXS uses TWO independent 1x5 rows; 12.70mm spacing ASSUMED until measured, not a standard 2x5 block
J5 J6 control harnesses | 1 | 4 + 3 flexible control wires; male 2.54mm contacts at shield | RobotDyn original header and SSR original input terminal; do not remove SSR screw terminals
J5 harness housing | 1 | Single 1x4 Dupont 2.54mm housing with MALE crimp contacts | Populate 1,2,3,4; mark pin 1 RED on housing and align with square PCB pad 1. One housing, no loose single-pole plugs. Not mechanically keyed.
J6 harness housing | 1 | Single 1x5 Dupont 2.54mm housing with MALE crimp contacts | Populate 1,3,5 ONLY; positions 2/4 EMPTY. Mark pin 1 RED; one housing, no loose single-pole plugs. Not mechanically keyed.
Mechanical retention | 1 | Insulating tray, adjustable padded keepers and underside supports | Use existing four PCB mounts; retain each module PCB edge independently per docs/retention.md
PCB fasteners | 4 | M3 nylon or insulated head <=5.5mm; no washers | J4 moved right by 1.27mm; respect mating-plug allowance and check real hardware
