rico-x/GemilaiMate/hardware/shield/manufacturing/BOM-SMD.csv

Designators | Quantity_per_board | Requirement | Package | Manufacturer_example | MPN_example
R1 R3 R4 R5 R8 R9 R11 | 7 | 10k 1% >=0.125W | 0805 | Yageo | RC0805FR-0710KL
R2 | 1 | 1.2k 1% >=0.125W | 0805 | Yageo | RC0805FR-071K2L
R6 R7 R10 R12 | 4 | 1k 1% >=0.125W | 0805 | Yageo | RC0805FR-071KL
R13 | 1 | 0 ohm jumper | 0805 | Yageo | RC0805JR-070RL
C1 C2 C3 C4 C5 C6 | 6 | 100nF 50V X7R +/-10% | 0805 | Samsung | CL21B104KBCNNNC
U3 | 1 | Non-inverting Schmitt; 5.5V input; 3.3V VCC | SOT-23-5 DBV | Texas Instruments | SN74LVC1G17DBVR
