rico-x/GemilaiMate/hardware/shield-compact/connections.csv

Reference | Value | Pin | Pin name | Net | x_mm | y_mm
U1 | ESP32-S3-WROOM-1-N16R8 | 1 | GND | GND | 7.25 | 1.09
U1 | ESP32-S3-WROOM-1-N16R8 | 2 | 3V3 | +3V3 | 7.25 | 2.36
U1 | ESP32-S3-WROOM-1-N16R8 | 3 | EN | EN | 7.25 | 3.63
U1 | ESP32-S3-WROOM-1-N16R8 | 4 | GPIO4 | TC_DO | 7.25 | 4.9
U1 | ESP32-S3-WROOM-1-N16R8 | 5 | GPIO5 | GPIO5 | 7.25 | 6.17
U1 | ESP32-S3-WROOM-1-N16R8 | 6 | GPIO6 | TC_SCK | 7.25 | 7.44
U1 | ESP32-S3-WROOM-1-N16R8 | 7 | GPIO7 | TC_CS | 7.25 | 8.71
U1 | ESP32-S3-WROOM-1-N16R8 | 8 | GPIO15 | GPIO15 | 7.25 | 9.98
U1 | ESP32-S3-WROOM-1-N16R8 | 9 | GPIO16 | GPIO16 | 7.25 | 11.25
U1 | ESP32-S3-WROOM-1-N16R8 | 10 | GPIO17 | SCALE_CLK | 7.25 | 12.52
U1 | ESP32-S3-WROOM-1-N16R8 | 11 | GPIO18 | SCALE_DAT0 | 7.25 | 13.79
U1 | ESP32-S3-WROOM-1-N16R8 | 12 | GPIO8 | EXT3 | 7.25 | 15.06
U1 | ESP32-S3-WROOM-1-N16R8 | 13 | GPIO19 | USB_DM_MCU | 7.25 | 16.33
U1 | ESP32-S3-WROOM-1-N16R8 | 14 | GPIO20 | USB_DP_MCU | 7.25 | 17.6
U1 | ESP32-S3-WROOM-1-N16R8 | 15 | GPIO3 | STRAP3 | 9.015 | 18.85
U1 | ESP32-S3-WROOM-1-N16R8 | 16 | GPIO46 | STRAP46 | 10.285 | 18.85
U1 | ESP32-S3-WROOM-1-N16R8 | 17 | GPIO9 | PUMP_PWM | 11.555 | 18.85
U1 | ESP32-S3-WROOM-1-N16R8 | 18 | GPIO10 | VALVE | 12.825 | 18.85
U1 | ESP32-S3-WROOM-1-N16R8 | 19 | GPIO11 | BOARD_ID | 14.095 | 18.85
U1 | ESP32-S3-WROOM-1-N16R8 | 20 | GPIO12 | EXT4 | 15.365 | 18.85
U1 | ESP32-S3-WROOM-1-N16R8 | 21 | GPIO13 | EXT5 | 16.635 | 18.85
U1 | ESP32-S3-WROOM-1-N16R8 | 22 | GPIO14 | HEATER | 17.905 | 18.85
U1 | ESP32-S3-WROOM-1-N16R8 | 23 | GPIO21 | PUMP_ZC | 19.175 | 18.85
U1 | ESP32-S3-WROOM-1-N16R8 | 24 | GPIO47 | ALT | 20.445 | 18.85
U1 | ESP32-S3-WROOM-1-N16R8 | 25 | GPIO48 | STEAM | 21.715 | 18.85
U1 | ESP32-S3-WROOM-1-N16R8 | 26 | GPIO45 | STRAP45 | 22.985 | 18.85
U1 | ESP32-S3-WROOM-1-N16R8 | 27 | GPIO0 | BOOT | 24.75 | 17.6
U1 | ESP32-S3-WROOM-1-N16R8 | 28 | GPIO35 | NC | 24.75 | 16.33
U1 | ESP32-S3-WROOM-1-N16R8 | 29 | GPIO36 | NC | 24.75 | 15.06
U1 | ESP32-S3-WROOM-1-N16R8 | 30 | GPIO37 | NC | 24.75 | 13.79
U1 | ESP32-S3-WROOM-1-N16R8 | 31 | GPIO38 | BREW | 24.75 | 12.52
U1 | ESP32-S3-WROOM-1-N16R8 | 32 | GPIO39 | SCALE_DAT1 | 24.75 | 11.25
U1 | ESP32-S3-WROOM-1-N16R8 | 33 | GPIO40 | DETECT_EN | 24.75 | 9.98
U1 | ESP32-S3-WROOM-1-N16R8 | 34 | GPIO41 | SCL_3V3 | 24.75 | 8.71
U1 | ESP32-S3-WROOM-1-N16R8 | 35 | GPIO42 | SDA_3V3 | 24.75 | 7.44
U1 | ESP32-S3-WROOM-1-N16R8 | 36 | GPIO44 | ALBA_SCL | 24.75 | 6.17
U1 | ESP32-S3-WROOM-1-N16R8 | 37 | GPIO43 | ALBA_SDA | 24.75 | 4.9
U1 | ESP32-S3-WROOM-1-N16R8 | 38 | GPIO2 | EXT2 | 24.75 | 3.63
U1 | ESP32-S3-WROOM-1-N16R8 | 39 | GPIO1 | EXT1 | 24.75 | 2.36
U1 | ESP32-S3-WROOM-1-N16R8 | 40 | GND | GND | 24.75 | 1.09
U1 | ESP32-S3-WROOM-1-N16R8 | 41 | EP_GND | GND | 13.1 | 8.11
J_USB | TYPE-C-31-M-12 | A1 | A1 | GND | 5.225 | 53.305
J_USB | TYPE-C-31-M-12 | A12 | A12 | GND | 11.725 | 53.305
J_USB | TYPE-C-31-M-12 | A4 | A4 | USB_VBUS | 6.025 | 53.305
J_USB | TYPE-C-31-M-12 | A5 | A5 | CC1 | 7.225 | 53.305
J_USB | TYPE-C-31-M-12 | A6 | A6 | USB_DP | 8.225 | 53.305
J_USB | TYPE-C-31-M-12 | A7 | A7 | USB_DM | 8.725 | 53.305
J_USB | TYPE-C-31-M-12 | A8 | A8 | NC | 9.725 | 53.305
J_USB | TYPE-C-31-M-12 | A9 | A9 | USB_VBUS | 10.925 | 53.305
J_USB | TYPE-C-31-M-12 | B1 | B1 | GND | 11.725 | 53.305
J_USB | TYPE-C-31-M-12 | B12 | B12 | GND | 5.225 | 53.305
J_USB | TYPE-C-31-M-12 | B4 | B4 | USB_VBUS | 10.925 | 53.305
J_USB | TYPE-C-31-M-12 | B5 | B5 | CC2 | 10.225 | 53.305
J_USB | TYPE-C-31-M-12 | B6 | B6 | USB_DP | 9.225 | 53.305
J_USB | TYPE-C-31-M-12 | B7 | B7 | USB_DM | 7.725 | 53.305
J_USB | TYPE-C-31-M-12 | B8 | B8 | NC | 6.725 | 53.305
J_USB | TYPE-C-31-M-12 | B9 | B9 | USB_VBUS | 6.025 | 53.305
J_USB | TYPE-C-31-M-12 | SH | SH | GND | 4.155 | 54.22
R_CC1 | 5.1k 1% | 1 | 1 | CC1 | 5.0 | 50.816666
R_CC1 | 5.1k 1% | 2 | 2 | GND | 5.0 | 48.816666
R_CC2 | 5.1k 1% | 1 | 1 | CC2 | 10.5 | 50.816666
R_CC2 | 5.1k 1% | 2 | 2 | GND | 10.5 | 48.816666
R_USBP | 22R 1% | 1 | 1 | USB_DP_MCU | 8.0 | 33.566666
R_USBP | 22R 1% | 2 | 2 | USB_DP | 8.0 | 35.566666
R_USBM | 22R 1% | 1 | 1 | USB_DM_MCU | 5.0 | 17.299999
R_USBM | 22R 1% | 2 | 2 | USB_DM | 5.0 | 19.299999
U_ESD | USBLC6-2SC6 | 1 | 1 | USB_DM | 6.525 | 43.541666
U_ESD | USBLC6-2SC6 | 2 | 2 | GND | 7.475 | 43.541666
U_ESD | USBLC6-2SC6 | 3 | 3 | USB_DP | 8.425 | 43.541666
U_ESD | USBLC6-2SC6 | 4 | 4 | USB_DP | 8.425 | 40.841666
U_ESD | USBLC6-2SC6 | 5 | 5 | USB_VBUS | 7.475 | 40.841666
U_ESD | USBLC6-2SC6 | 6 | 6 | USB_DM | 6.525 | 40.841666
F_USB | 1206L050YR 0.5A | 1 | 1 | USB_VBUS | 60.5125 | 57.0
F_USB | 1206L050YR 0.5A | 2 | 2 | USB_FUSED | 63.4875 | 57.0
F_EXT | 1206L150/12 1.5A | 1 | 1 | EXT_IN | 67.9875 | 31.008333
F_EXT | 1206L150/12 1.5A | 2 | 2 | +5V_EXT | 65.0125 | 31.008333
D_USB | SS14 | 1 | K | +5V_CORE | 72.5 | 38.675
D_USB | SS14 | 2 | A | USB_FUSED | 72.5 | 43.675
D_EXT | SS14 | 1 | K | +5V_CORE | 73.5 | 34.016666
D_EXT | SS14 | 2 | A | +5V_EXT | 73.5 | 29.016666
U_REG | AP7361C-33E-13 | 1 | IN | +5V_CORE | 58.7 | 12.299999
U_REG | AP7361C-33E-13 | 2 | GND_TAB | GND | 61.0 | 12.299999
U_REG | AP7361C-33E-13 | 3 | OUT | +3V3 | 63.3 | 12.299999
C_IN | 10uF 16V X7R | 1 | 1 | +5V_CORE | 56.0 | 13.7625
C_IN | 10uF 16V X7R | 2 | 2 | GND | 56.0 | 10.6375
C_OUT | 10uF 16V X7R | 1 | 1 | +3V3 | 61.4375 | 15.25
C_OUT | 10uF 16V X7R | 2 | 2 | GND | 64.5625 | 15.25
C_MCU | 10uF 16V X7R | 1 | 1 | +3V3 | 4.0 | 9.695833
C_MCU | 10uF 16V X7R | 2 | 2 | GND | 4.0 | 6.570833
C_MCUHF | 100nF 50V X7R | 1 | 1 | +3V3 | 27.0 | 14.254166
C_MCUHF | 100nF 50V X7R | 2 | 2 | GND | 27.0 | 12.179166
R_EN | 10k 1% | 1 | 1 | +3V3 | 9.5 | 29.466666
R_EN | 10k 1% | 2 | 2 | EN | 9.5 | 27.466666
C_EN | 1uF 16V X7R | 1 | 1 | EN | 5.0375 | 14.741666
C_EN | 1uF 16V X7R | 2 | 2 | GND | 2.9625 | 14.741666
R_BOOT | 10k 1% | 1 | 1 | +3V3 | 65.0 | 18.808333
R_BOOT | 10k 1% | 2 | 2 | BOOT | 63.0 | 18.808333
SW_RESET | RESET | 1 | 1 | EN | 6.9 | 21.758333
SW_RESET | RESET | 2 | 2 | GND | 3.1 | 21.758333
SW_BOOT | BOOT | 1 | 1 | BOOT | 70.6 | 20.433333
SW_BOOT | BOOT | 2 | 2 | GND | 74.4 | 20.433333
R_ID_TOP | 10k 1% | 1 | 1 | DETECT_EN | 29.5 | 13.436666
R_ID_TOP | 10k 1% | 2 | 2 | BOARD_ID | 29.5 | 15.436666
R_ID_LOW | 1.58k 1% | 1 | 1 | BOARD_ID | 29.5 | 17.588333
R_ID_LOW | 1.58k 1% | 2 | 2 | GND | 31.5 | 17.588333
C_ID | 10nF 50V C0G | 1 | 1 | BOARD_ID | 27.0 | 18.320833
C_ID | 10nF 50V C0G | 2 | 2 | GND | 27.0 | 16.245833
C_LVA | 100nF 50V X7R | 1 | 1 | +3V3 | 30.0 | 11.204166
C_LVA | 100nF 50V X7R | 2 | 2 | GND | 30.0 | 9.129166
C_LVB | 100nF 50V X7R | 1 | 1 | +5V_CORE | 27.5375 | 57.5
C_LVB | 100nF 50V X7R | 2 | 2 | GND | 25.4625 | 57.5
J_ADS | ADS1115 BLUE SOCKET | 1 | VDD | +5V_CORE | 24.0 | 24.542333
J_ADS | ADS1115 BLUE SOCKET | 2 | GND | GND | 24.0 | 27.082333
J_ADS | ADS1115 BLUE SOCKET | 3 | SCL | SCL_5V | 24.0 | 29.622333
J_ADS | ADS1115 BLUE SOCKET | 4 | SDA | SDA_5V | 24.0 | 32.162333
J_ADS | ADS1115 BLUE SOCKET | 5 | ADDR | GND | 24.0 | 34.702333
J_ADS | ADS1115 BLUE SOCKET | 6 | ALRT | NC | 24.0 | 37.242333
J_ADS | ADS1115 BLUE SOCKET | 7 | A0 | PRESSURE | 24.0 | 39.782333
J_ADS | ADS1115 BLUE SOCKET | 8 | A1 | NC | 24.0 | 42.322333
J_ADS | ADS1115 BLUE SOCKET | 9 | A2 | NC | 24.0 | 44.862333
J_ADS | ADS1115 BLUE SOCKET | 10 | A3 | NC | 24.0 | 47.402333
R_PRESS | 1k 1% | 1 | 1 | PRESSURE_RAW | 21.5 | 43.699999
R_PRESS | 1k 1% | 2 | 2 | PRESSURE | 21.5 | 41.699999
C_PRESS | 100nF 50V X7R | 1 | 1 | PRESSURE | 26.5 | 41.154166
C_PRESS | 100nF 50V X7R | 2 | 2 | GND | 26.5 | 43.229166
J_TC | MAX31855 SOCKET | 1 | VIN | TC_VIN | 57.5 | 24.4
J_TC | MAX31855 SOCKET | 2 | 3Vo_NC | NC | 54.96 | 24.4
J_TC | MAX31855 SOCKET | 3 | GND | GND | 52.42 | 24.4
J_TC | MAX31855 SOCKET | 4 | DO | TC_DO | 49.88 | 24.4
J_TC | MAX31855 SOCKET | 5 | CS | TC_CS | 47.34 | 24.4
J_TC | MAX31855 SOCKET | 6 | CLK | TC_SCK | 44.8 | 24.4
R_ZCPU | 10k 1% | 1 | 1 | +5V_EXT | 35.0 | 51.324999
R_ZCPU | 10k 1% | 2 | 2 | ZC_RAW | 35.0 | 49.324999
R_ZCS | 1k 1% | 1 | 1 | ZC_RAW | 34.5 | 42.683333
R_ZCS | 1k 1% | 2 | 2 | ZC_IN | 34.5 | 40.683333
U_ZC | SN74LVC1G17DBVR | 1 | NC | NC | 34.35 | 38.566666
U_ZC | SN74LVC1G17DBVR | 2 | A | ZC_IN | 34.35 | 37.616666
U_ZC | SN74LVC1G17DBVR | 3 | GND | GND | 34.35 | 36.666666
U_ZC | SN74LVC1G17DBVR | 4 | Y | PUMP_ZC | 31.65 | 36.666666
U_ZC | SN74LVC1G17DBVR | 5 | VCC | +3V3 | 31.65 | 38.566666
C_ZC | 100nF 50V X7R | 1 | 1 | +3V3 | 32.5375 | 40.666666
C_ZC | 100nF 50V X7R | 2 | 2 | GND | 30.4625 | 40.666666
R_EXT_BASE | 47k 1% | 1 | 1 | +5V_EXT | 56.5 | 55.0
R_EXT_BASE | 47k 1% | 2 | 2 | EXT_BASE | 56.5 | 53.0
R_EXT_PD | 100k 1% | 1 | 1 | EXT_BASE | 56.5 | 50.324999
R_EXT_PD | 100k 1% | 2 | 2 | GND | 58.5 | 50.324999
Q_EXT | MMBT3904 | 1 | B | EXT_BASE | 56.5 | 48.225
Q_EXT | MMBT3904 | 2 | E | GND | 56.5 | 46.325
Q_EXT | MMBT3904 | 3 | C | OUTPUT_OE_N | 53.5 | 47.275
R_OEUP | 10k 1% | 1 | 1 | +3V3 | 42.5 | 38.65
R_OEUP | 10k 1% | 2 | 2 | OUTPUT_OE_N | 42.5 | 40.65
U_PUMP | SN74LVC1G125DBVR | 1 | OE_N | OUTPUT_OE_N | 46.15 | 46.833333
U_PUMP | SN74LVC1G125DBVR | 2 | A | PUMP_PWM | 46.15 | 47.783333
U_PUMP | SN74LVC1G125DBVR | 3 | GND | GND | 46.15 | 48.733333
U_PUMP | SN74LVC1G125DBVR | 4 | Y | PUMP_OUT | 48.85 | 48.733333
U_PUMP | SN74LVC1G125DBVR | 5 | VCC | +3V3 | 48.85 | 46.833333
U_SSR | SN74AHCT125DR | 1 | 1OE_N | OUTPUT_OE_N | 39.525 | 8.898333
U_SSR | SN74AHCT125DR | 2 | 1A | VALVE | 39.525 | 10.168333
U_SSR | SN74AHCT125DR | 3 | 1Y | VALVE_5V | 39.525 | 11.438333
U_SSR | SN74AHCT125DR | 4 | 2OE_N | OUTPUT_OE_N | 39.525 | 12.708333
U_SSR | SN74AHCT125DR | 5 | 2A | HEATER | 39.525 | 13.978333
U_SSR | SN74AHCT125DR | 6 | 2Y | HEATER_5V | 39.525 | 15.248333
U_SSR | SN74AHCT125DR | 7 | GND | GND | 39.525 | 16.518333
U_SSR | SN74AHCT125DR | 8 | 3Y | ALT_5V | 44.475 | 16.518333
U_SSR | SN74AHCT125DR | 9 | 3A | ALT | 44.475 | 15.248333
U_SSR | SN74AHCT125DR | 10 | 3OE_N | OUTPUT_OE_N | 44.475 | 13.978333
U_SSR | SN74AHCT125DR | 11 | 4Y_NC | NC | 44.475 | 12.708333
U_SSR | SN74AHCT125DR | 12 | 4A | GND | 44.475 | 11.438333
U_SSR | SN74AHCT125DR | 13 | 4OE_N | +5V_EXT | 44.475 | 10.168333
U_SSR | SN74AHCT125DR | 14 | VCC | +5V_EXT | 44.475 | 8.898333
C_SSR | 100nF 50V X7R | 1 | 1 | +5V_EXT | 48.9625 | 10.674999
C_SSR | 100nF 50V X7R | 2 | 2 | GND | 51.0375 | 10.674999
C_PUMP | 100nF 50V X7R | 1 | 1 | +3V3 | 51.0 | 47.804166
C_PUMP | 100nF 50V X7R | 2 | 2 | GND | 51.0 | 45.729166
R_PD1 | 10k 1% | 1 | 1 | PUMP_PWM | 37.0 | 38.633333
R_PD1 | 10k 1% | 2 | 2 | GND | 39.0 | 38.633333
R_PD2 | 10k 1% | 1 | 1 | VALVE | 34.0 | 12.2
R_PD2 | 10k 1% | 2 | 2 | GND | 32.0 | 12.2
R_PD3 | 10k 1% | 1 | 1 | HEATER | 36.0 | 16.266666
R_PD3 | 10k 1% | 2 | 2 | GND | 34.0 | 16.266666
R_PD4 | 10k 1% | 1 | 1 | ALT | 47.0 | 15.741666
R_PD4 | 10k 1% | 2 | 2 | GND | 47.0 | 13.741666
R_PD5 | 10k 1% | 1 | 1 | PUMP_OUT | 41.5 | 48.816666
R_PD5 | 10k 1% | 2 | 2 | GND | 41.5 | 50.816666
R_OUT_VALVE | 10k 1% | 1 | 1 | VALVE_5V | 60.5 | 26.416666
R_OUT_VALVE | 10k 1% | 2 | 2 | GND | 60.5 | 24.416666
R_OUT_HEATER | 10k 1% | 1 | 1 | HEATER_5V | 46.0 | 27.45
R_OUT_HEATER | 10k 1% | 2 | 2 | GND | 48.0 | 27.45
R_OUT_ALT | 10k 1% | 1 | 1 | ALT_5V | 45.0 | 42.191666
R_OUT_ALT | 10k 1% | 2 | 2 | GND | 47.0 | 42.191666
R_BREW | 1k 1% | 1 | 1 | BREW_RAW | 20.5 | 51.0
R_BREW | 1k 1% | 2 | 2 | BREW | 22.5 | 51.0
R_BREWPU | 10k 1% | 1 | 1 | +3V3 | 26.5 | 38.108333
R_BREWPU | 10k 1% | 2 | 2 | BREW | 26.5 | 36.108333
C_BREW | 100nF 50V X7R | 1 | 1 | BREW | 25.9625 | 51.0
C_BREW | 100nF 50V X7R | 2 | 2 | GND | 28.0375 | 51.0
R_STEAM | 1k 1% | 1 | 1 | STEAM_RAW | 26.5 | 47.766666
R_STEAM | 1k 1% | 2 | 2 | STEAM | 26.5 | 45.766666
R_STEAMPU | 10k 1% | 1 | 1 | +3V3 | 30.5 | 43.208333
R_STEAMPU | 10k 1% | 2 | 2 | STEAM | 28.5 | 43.208333
C_STEAM | 100nF 50V X7R | 1 | 1 | STEAM | 28.4625 | 45.75
C_STEAM | 100nF 50V X7R | 2 | 2 | GND | 30.5375 | 45.75
U_LED | PCA9634D | 1 | A0 | GND | 27.35 | 22.243333
U_LED | PCA9634D | 2 | A1 | GND | 27.35 | 23.513333
U_LED | PCA9634D | 3 | A2 | GND | 27.35 | 24.783333
U_LED | PCA9634D | 4 | A3 | GND | 27.35 | 26.053333
U_LED | PCA9634D | 5 | A4 | GND | 27.35 | 27.323333
U_LED | PCA9634D | 6 | LED0 | PCA_LED0 | 27.35 | 28.593333
U_LED | PCA9634D | 7 | LED1 | PCA_LED1 | 27.35 | 29.863333
U_LED | PCA9634D | 8 | LED2 | PCA_LED2 | 27.35 | 31.133333
U_LED | PCA9634D | 9 | LED3 | PCA_LED3 | 27.35 | 32.403333
U_LED | PCA9634D | 10 | VSS | GND | 27.35 | 33.673333
U_LED | PCA9634D | 11 | LED4 | PCA_LED4 | 36.65 | 33.673333
U_LED | PCA9634D | 12 | LED5 | PCA_LED5 | 36.65 | 32.403333
U_LED | PCA9634D | 13 | LED6 | PCA_LED6 | 36.65 | 31.133333
U_LED | PCA9634D | 14 | LED7 | PCA_LED7 | 36.65 | 29.863333
U_LED | PCA9634D | 15 | OE_N | GND | 36.65 | 28.593333
U_LED | PCA9634D | 16 | A5 | GND | 36.65 | 27.323333
U_LED | PCA9634D | 17 | A6 | GND | 36.65 | 26.053333
U_LED | PCA9634D | 18 | SCL | PCA_SCL | 36.65 | 24.783333
U_LED | PCA9634D | 19 | SDA | PCA_SDA | 36.65 | 23.513333
U_LED | PCA9634D | 20 | VDD | +3V3 | 36.65 | 22.243333
R_PCACLK | 0R | 1 | 1 | ALBA_SCL | 43.5 | 27.45
R_PCACLK | 0R | 2 | 2 | PCA_SCL | 41.5 | 27.45
R_PCADAT | 0R | 1 | 1 | ALBA_SDA | 32.0 | 19.825
R_PCADAT | 0R | 2 | 2 | PCA_SDA | 34.0 | 19.825
C_PCA | 100nF 50V X7R | 1 | 1 | +3V3 | 38.9625 | 22.366666
C_PCA | 100nF 50V X7R | 2 | 2 | GND | 41.0375 | 22.366666
R_ALBASDA | 4.7k 1% | 1 | 1 | +3V3 | 32.5 | 8.116666
R_ALBASDA | 4.7k 1% | 2 | 2 | ALBA_SDA | 32.5 | 6.116666
R_ALBASCL | 4.7k 1% | 1 | 1 | +3V3 | 51.0 | 19.333333
R_ALBASCL | 4.7k 1% | 2 | 2 | ALBA_SCL | 51.0 | 21.333333
R_LED0 | 180R 1% | 1 | 1 | PCA_LED0 | 59.0 | 21.349999
R_LED0 | 180R 1% | 2 | 2 | RGBW0 | 61.0 | 21.349999
R_LED1 | 180R 1% | 1 | 1 | PCA_LED1 | 59.0 | 16.758333
R_LED1 | 180R 1% | 2 | 2 | RGBW1 | 59.0 | 14.758333
R_LED2 | 180R 1% | 1 | 1 | PCA_LED2 | 58.0 | 18.808333
R_LED2 | 180R 1% | 2 | 2 | RGBW2 | 60.0 | 18.808333
R_LED3 | 180R 1% | 1 | 1 | PCA_LED3 | 43.5 | 32.025
R_LED3 | 180R 1% | 2 | 2 | RGBW3 | 45.5 | 32.025
R_GATE4 | 100R 1% | 1 | 1 | PCA_LED4 | 45.5 | 36.091666
R_GATE4 | 100R 1% | 2 | 2 | LED_GATE4 | 47.5 | 36.091666
R_GPD4 | 100k 1% | 1 | 1 | LED_GATE4 | 62.0 | 36.599999
R_GPD4 | 100k 1% | 2 | 2 | GND | 60.0 | 36.599999
Q_LED4 | AO3400A | 1 | G | LED_GATE4 | 63.5 | 40.733333
Q_LED4 | AO3400A | 2 | S | GND | 63.5 | 42.633333
Q_LED4 | AO3400A | 3 | D | LED4_DRAIN | 66.5 | 41.683333
R_GATE5 | 100R 1% | 1 | 1 | PCA_LED5 | 40.0 | 34.583333
R_GATE5 | 100R 1% | 2 | 2 | LED_GATE5 | 40.0 | 36.583333
R_GPD5 | 100k 1% | 1 | 1 | LED_GATE5 | 42.5 | 43.716666
R_GPD5 | 100k 1% | 2 | 2 | GND | 40.5 | 43.716666
Q_LED5 | AO3400A | 1 | G | LED_GATE5 | 59.5 | 44.8
Q_LED5 | AO3400A | 2 | S | GND | 59.5 | 46.7
Q_LED5 | AO3400A | 3 | D | LED5_DRAIN | 62.5 | 45.75
J_PWR | 5V INPUT | 1 | 5V_IN | EXT_IN | 53.75 | 6.63375
J_PWR | 5V INPUT | 2 | GND | GND | 56.25 | 6.63375
J_DISPLAY | DISPLAY 5V | 1 | 5V_EXT | +5V_EXT | 54.0 | 15.809166
J_DISPLAY | DISPLAY 5V | 2 | GND | GND | 56.0 | 15.809166
J_PRESS | PRESSURE | 1 | 5V | +5V_EXT | 15.0 | 44.275833
J_PRESS | PRESSURE | 2 | GND | GND | 17.0 | 44.275833
J_PRESS | PRESSURE | 3 | OUT | PRESSURE_RAW | 19.0 | 44.275833
J_BUTTONS | BUTTONS | 1 | BREW | BREW_RAW | 20.0 | 53.55
J_BUTTONS | BUTTONS | 2 | STEAM | STEAM_RAW | 22.0 | 53.55
J_BUTTONS | BUTTONS | 3 | GND | GND | 24.0 | 53.55
J_BUTTONS | BUTTONS | 4 | GND | GND | 26.0 | 53.55
J_PUMP | ROBOTDYN | 1 | 5V | +5V_EXT | 32.0 | 53.55
J_PUMP | ROBOTDYN | 2 | GND | GND | 34.0 | 53.55
J_PUMP | ROBOTDYN | 3 | ZC | ZC_RAW | 36.0 | 53.55
J_PUMP | ROBOTDYN | 4 | PSM | PUMP_OUT | 38.0 | 53.55
J_PUMP | ROBOTDYN | 5 | EMPTY | NC | 40.0 | 53.55
J_PUMP | ROBOTDYN | 6 | EMPTY | NC | 42.0 | 53.55
J_VALVE | VALVE SSR | 1 | 5V | +5V_EXT | 68.05 | 38.125
J_VALVE | VALVE SSR | 2 | GND | GND | 68.05 | 36.125
J_VALVE | VALVE SSR | 3 | IN | VALVE_5V | 68.05 | 34.125
J_HEAT | HEATER UNUSED | 1 | 5V | +5V_EXT | 52.0 | 35.125833
J_HEAT | HEATER UNUSED | 2 | GND | GND | 54.0 | 35.125833
J_HEAT | HEATER UNUSED | 3 | IN | HEATER_5V | 56.0 | 35.125833
J_ALT | ALT SSR | 1 | 5V | +5V_EXT | 48.0 | 53.55
J_ALT | ALT SSR | 2 | GND | GND | 50.0 | 53.55
J_ALT | ALT SSR | 3 | IN | ALT_5V | 52.0 | 53.55
J_TOF | VL53L0X 3V3 | 1 | 3V3 | +3V3 | 51.0 | 43.259166
J_TOF | VL53L0X 3V3 | 2 | GND | GND | 53.0 | 43.259166
J_TOF | VL53L0X 3V3 | 3 | SDA | EXT_SDA | 55.0 | 43.259166
J_TOF | VL53L0X 3V3 | 4 | SCL | EXT_SCL | 57.0 | 43.259166
J_ALBA | EXTERNAL ALBA | 1 | 5V_EXT | +5V_EXT | 68.05 | 26.941666
J_ALBA | EXTERNAL ALBA | 2 | GND | GND | 68.05 | 24.941666
J_ALBA | EXTERNAL ALBA | 3 | SDA | EXT_SDA | 68.05 | 22.941666
J_ALBA | EXTERNAL ALBA | 4 | SCL | EXT_SCL | 68.05 | 20.941666
J_RGBW | RGBW CA | 1 | 5V_CA | +5V_EXT | 68.05 | 13.216666
J_RGBW | RGBW CA | 2 | R | RGBW0 | 68.05 | 11.216666
J_RGBW | RGBW CA | 3 | G | RGBW1 | 68.05 | 9.216666
J_RGBW | RGBW CA | 4 | B | RGBW2 | 68.05 | 7.216666
J_RGBW | RGBW CA | 5 | W | RGBW3 | 68.05 | 5.216666
J_LIGHT | LIGHTS 200mA TOTAL | 1 | 5V | +5V_EXT | 68.05 | 49.816666
J_LIGHT | LIGHTS 200mA TOTAL | 2 | CH4_NEG | LED4_DRAIN | 68.05 | 47.816666
J_LIGHT | LIGHTS 200mA TOTAL | 3 | CH5_NEG | LED5_DRAIN | 68.05 | 45.816666
J_SCALE | SCALE 3V3 | 1 | 1 | +3V3 | 13.5 | 28.466666
J_SCALE | SCALE 3V3 | 2 | 2 | GND | 13.5 | 31.006666
J_SCALE | SCALE 3V3 | 3 | 3 | SCALE_CLK | 13.5 | 33.546666
J_SCALE | SCALE 3V3 | 4 | 4 | SCALE_DAT0 | 13.5 | 36.086666
J_SCALE | SCALE 3V3 | 5 | 5 | SCALE_DAT1 | 13.5 | 38.626666
J_EXT | EXT 3V3 | 1 | 1 | +3V3 | 17.5 | 28.466666
J_EXT | EXT 3V3 | 2 | 2 | GND | 20.04 | 28.466666
J_EXT | EXT 3V3 | 3 | 3 | EXT1 | 17.5 | 31.006666
J_EXT | EXT 3V3 | 4 | 4 | EXT2 | 20.04 | 31.006666
J_EXT | EXT 3V3 | 5 | 5 | EXT3 | 17.5 | 33.546666
J_EXT | EXT 3V3 | 6 | 6 | EXT4 | 20.04 | 33.546666
J_EXT | EXT 3V3 | 7 | 7 | EXT5 | 17.5 | 36.086666
J_EXT | EXT 3V3 | 8 | 8 | +5V_EXT | 20.04 | 36.086666
J_EXT | EXT 3V3 | 9 | 9 | GND | 17.5 | 38.626666
J_EXT | EXT 3V3 | 10 | 10 | GND | 20.04 | 38.626666
J_FREE | FREE GPIO 3V3 | 1 | 1 | +3V3 | 33.0 | 58.0
J_FREE | FREE GPIO 3V3 | 2 | 2 | GND | 35.54 | 58.0
J_FREE | FREE GPIO 3V3 | 3 | 3 | GPIO5 | 38.08 | 58.0
J_FREE | FREE GPIO 3V3 | 4 | 4 | GPIO15 | 40.62 | 58.0
J_FREE | FREE GPIO 3V3 | 5 | 5 | GPIO16 | 43.16 | 58.0
J_FREE | FREE GPIO 3V3 | 6 | 6 | GND | 45.7 | 58.0
J_LEVEL | CJMCU-0102 TXS0102 SOCKET | 1 | GND_A | GND | 36.92 | 19.058333
J_LEVEL | CJMCU-0102 TXS0102 SOCKET | 2 | OE | I2C_OE | 39.46 | 19.058333
J_LEVEL | CJMCU-0102 TXS0102 SOCKET | 3 | VCCA | +3V3 | 42.0 | 19.058333
J_LEVEL | CJMCU-0102 TXS0102 SOCKET | 4 | A1 | SCL_3V3 | 44.54 | 19.058333
J_LEVEL | CJMCU-0102 TXS0102 SOCKET | 5 | A2 | SDA_3V3 | 47.08 | 19.058333
J_LEVEL | CJMCU-0102 TXS0102 SOCKET | 6 | GND_B | GND | 36.92 | 6.358333
J_LEVEL | CJMCU-0102 TXS0102 SOCKET | 7 | G_RESERVED_NC | NC | 39.46 | 6.358333
J_LEVEL | CJMCU-0102 TXS0102 SOCKET | 8 | VCCB | +5V_CORE | 42.0 | 6.358333
J_LEVEL | CJMCU-0102 TXS0102 SOCKET | 9 | B1 | SCL_5V | 44.54 | 6.358333
J_LEVEL | CJMCU-0102 TXS0102 SOCKET | 10 | B2 | SDA_5V | 47.08 | 6.358333
TP1 | STRAP3 | 1 | 1 | STRAP3 | 12.0 | 21.349999
TP2 | STRAP45 | 1 | 1 | STRAP45 | 29.5 | 19.825
TP3 | STRAP46 | 1 | 1 | STRAP46 | 9.5 | 21.349999
TP4 | BOOT | 1 | 1 | BOOT | 67.0 | 17.283333
TP5 | +3V3 | 1 | 1 | +3V3 | 54.0 | 4.066666
TP6 | GND | 1 | 1 | GND | 73.5 | 22.875
TP7 | ALBA_SDA | 1 | 1 | ALBA_SDA | 53.5 | 11.691666
TP8 | ALBA_SCL | 1 | 1 | ALBA_SCL | 52.0 | 15.25
TP9 | PCA_LED6 | 1 | 1 | PCA_LED6 | 21.0 | 25.416666
TP10 | PCA_LED7 | 1 | 1 | PCA_LED7 | 40.5 | 46.766666
D_TVS | SMAJ5.0A | 1 | K | +5V_EXT | 62.5 | 53.0
D_TVS | SMAJ5.0A | 2 | A | GND | 67.5 | 53.0
C_EXT | 10uF 16V X7R | 1 | 1 | +5V_EXT | 45.0 | 54.0625
C_EXT | 10uF 16V X7R | 2 | 2 | GND | 45.0 | 50.9375
R_EXTSDA | 470R 1% | 1 | 1 | ALBA_SDA | 54.0 | 19.841666
R_EXTSDA | 470R 1% | 2 | 2 | EXT_SDA | 54.0 | 21.841666
R_EXTSCL | 470R 1% | 1 | 1 | ALBA_SCL | 52.0 | 26.941666
R_EXTSCL | 470R 1% | 2 | 2 | EXT_SCL | 54.0 | 26.941666
R_TC3V3 | 0R | 1 | 1 | +3V3 | 56.0 | 26.941666
R_TC3V3 | 0R | 2 | 2 | TC_VIN | 58.0 | 26.941666
R_TC5V | 0R | 1 | 1 | +5V_CORE | 58.0 | 30.991666
R_TC5V | 0R | 2 | 2 | TC_VIN | 58.0 | 28.991666
R_OE | 10k 1% | 1 | 1 | +3V3 | 39.5 | 28.958333
R_OE | 10k 1% | 2 | 2 | I2C_OE | 39.5 | 26.958333
C_OE | 1uF 16V X7R | 1 | 1 | I2C_OE | 39.4625 | 24.908333
C_OE | 1uF 16V X7R | 2 | 2 | GND | 41.5375 | 24.908333
