rico-x/GemilaiMate/hardware/carrier/connections.csv

Reference | Value | Pin | Pin name | Net | x_mm | y_mm
U1 | ESP32-S3-N8R8 DevKitC-1 | 1 | 3V3 | +3V3 | 65.0 | 8.89
U1 | ESP32-S3-N8R8 DevKitC-1 | 2 | 3V3 | +3V3 | 62.46 | 8.89
U1 | ESP32-S3-N8R8 DevKitC-1 | 3 | EN | NC | 59.92 | 8.89
U1 | ESP32-S3-N8R8 DevKitC-1 | 4 | GPIO4 | TC_DO | 57.38 | 8.89
U1 | ESP32-S3-N8R8 DevKitC-1 | 5 | GPIO5 | NC | 54.84 | 8.89
U1 | ESP32-S3-N8R8 DevKitC-1 | 6 | GPIO6 | TC_SCK | 52.3 | 8.89
U1 | ESP32-S3-N8R8 DevKitC-1 | 7 | GPIO7 | TC_CS | 49.76 | 8.89
U1 | ESP32-S3-N8R8 DevKitC-1 | 8 | GPIO15 | NC | 47.22 | 8.89
U1 | ESP32-S3-N8R8 DevKitC-1 | 9 | GPIO16 | NC | 44.68 | 8.89
U1 | ESP32-S3-N8R8 DevKitC-1 | 10 | GPIO17 | NC | 42.14 | 8.89
U1 | ESP32-S3-N8R8 DevKitC-1 | 11 | GPIO18 | NC | 39.6 | 8.89
U1 | ESP32-S3-N8R8 DevKitC-1 | 12 | GPIO8 | NC | 37.06 | 8.89
U1 | ESP32-S3-N8R8 DevKitC-1 | 13 | GPIO3 | NC | 34.519999999999996 | 8.89
U1 | ESP32-S3-N8R8 DevKitC-1 | 14 | GPIO46 | NC | 31.979999999999997 | 8.89
U1 | ESP32-S3-N8R8 DevKitC-1 | 15 | GPIO9 | PUMP_PWM | 29.439999999999998 | 8.89
U1 | ESP32-S3-N8R8 DevKitC-1 | 16 | GPIO10 | VALVE_3V3 | 26.9 | 8.89
U1 | ESP32-S3-N8R8 DevKitC-1 | 17 | GPIO11 | BOARD_ID | 24.36 | 8.89
U1 | ESP32-S3-N8R8 DevKitC-1 | 18 | GPIO12 | NC | 21.82 | 8.89
U1 | ESP32-S3-N8R8 DevKitC-1 | 19 | GPIO13 | NC | 19.28 | 8.89
U1 | ESP32-S3-N8R8 DevKitC-1 | 20 | GPIO14 | HEATER_3V3 | 16.740000000000002 | 8.89
U1 | ESP32-S3-N8R8 DevKitC-1 | 21 | 5V | DEV_5V | 14.200000000000003 | 8.89
U1 | ESP32-S3-N8R8 DevKitC-1 | 22 | GND | GND | 11.659999999999997 | 8.89
U1 | ESP32-S3-N8R8 DevKitC-1 | 23 | GND | GND | 65.0 | 31.75
U1 | ESP32-S3-N8R8 DevKitC-1 | 24 | TX43 | NC | 62.46 | 31.75
U1 | ESP32-S3-N8R8 DevKitC-1 | 25 | RX44 | NC | 59.92 | 31.75
U1 | ESP32-S3-N8R8 DevKitC-1 | 26 | GPIO1 | NC | 57.38 | 31.75
U1 | ESP32-S3-N8R8 DevKitC-1 | 27 | GPIO2 | NC | 54.84 | 31.75
U1 | ESP32-S3-N8R8 DevKitC-1 | 28 | GPIO42 | SDA_3V3 | 52.3 | 31.75
U1 | ESP32-S3-N8R8 DevKitC-1 | 29 | GPIO41 | SCL_3V3 | 49.76 | 31.75
U1 | ESP32-S3-N8R8 DevKitC-1 | 30 | GPIO40 | DETECT_EN | 47.22 | 31.75
U1 | ESP32-S3-N8R8 DevKitC-1 | 31 | GPIO39 | NC | 44.68 | 31.75
U1 | ESP32-S3-N8R8 DevKitC-1 | 32 | GPIO38 | BREW | 42.14 | 31.75
U1 | ESP32-S3-N8R8 DevKitC-1 | 33 | GPIO37_RESERVED | NC | 39.6 | 31.75
U1 | ESP32-S3-N8R8 DevKitC-1 | 34 | GPIO36_RESERVED | NC | 37.06 | 31.75
U1 | ESP32-S3-N8R8 DevKitC-1 | 35 | GPIO35_RESERVED | NC | 34.519999999999996 | 31.75
U1 | ESP32-S3-N8R8 DevKitC-1 | 36 | GPIO0 | NC | 31.979999999999997 | 31.75
U1 | ESP32-S3-N8R8 DevKitC-1 | 37 | GPIO45 | NC | 29.439999999999998 | 31.75
U1 | ESP32-S3-N8R8 DevKitC-1 | 38 | GPIO48 | STEAM | 26.9 | 31.75
U1 | ESP32-S3-N8R8 DevKitC-1 | 39 | GPIO47 | NC | 24.36 | 31.75
U1 | ESP32-S3-N8R8 DevKitC-1 | 40 | GPIO21 | PUMP_ZC | 21.82 | 31.75
U1 | ESP32-S3-N8R8 DevKitC-1 | 41 | USB_D+20 | NC | 19.28 | 31.75
U1 | ESP32-S3-N8R8 DevKitC-1 | 42 | USB_D-19 | NC | 16.740000000000002 | 31.75
U1 | ESP32-S3-N8R8 DevKitC-1 | 43 | GND | GND | 14.200000000000003 | 31.75
U1 | ESP32-S3-N8R8 DevKitC-1 | 44 | GND | GND | 11.659999999999997 | 31.75
J1 | ISOLATED 5V INPUT | 1 | 5V | +5V | 8.89 | 3.81
J1 | ISOLATED 5V INPUT | 2 | GND | GND | 11.43 | 3.81
JP1 | OPEN FOR USB | 1 | SUPPLY_5V | +5V | 16.51 | 3.81
JP1 | OPEN FOR USB | 2 | DEVKIT_5V | DEV_5V | 19.05 | 3.81
J9 | DISPLAY USB 5V | 1 | USB5V | +5V | 24.13 | 3.81
J9 | DISPLAY USB 5V | 2 | GND | GND | 26.669999999999998 | 3.81
J5 | ROBOTDYN STANDARD | 1 | VCC5V | +5V | 31.75 | 3.81
J5 | ROBOTDYN STANDARD | 2 | GND | GND | 34.29 | 3.81
J5 | ROBOTDYN STANDARD | 3 | ZC5V | ZC_RAW | 36.83 | 3.81
J5 | ROBOTDYN STANDARD | 4 | PSM3V3 | PUMP_PWM | 39.37 | 3.81
J4 | PRESSURE SENSOR | 1 | VCC5V | +5V | 44.45 | 3.81
J4 | PRESSURE SENSOR | 2 | GND | GND | 46.99 | 3.81
J4 | PRESSURE SENSOR | 3 | OUT0.5-4.5V | PRESSURE_RAW | 49.53 | 3.81
JP3 | MAX VIN SELECT | 1 | 5V_VIN | +5V | 54.61 | 3.81
JP3 | MAX VIN SELECT | 2 | TC_VIN | TC_VIN | 57.15 | 3.81
JP3 | MAX VIN SELECT | 3 | 3V3_OPTION | +3V3 | 59.69 | 3.81
J2 | ADS1115 CABLE | 1 | VDD5V | +5V | 5.08 | 41.91
J2 | ADS1115 CABLE | 2 | GND | GND | 7.62 | 41.91
J2 | ADS1115 CABLE | 3 | SCL | SCL_5V | 10.16 | 41.91
J2 | ADS1115 CABLE | 4 | SDA | SDA_5V | 12.7 | 41.91
J2 | ADS1115 CABLE | 5 | A0 | PRESSURE | 15.24 | 41.91
J2 | ADS1115 CABLE | 6 | ADDR0 | GND | 17.78 | 41.91
J7 | TXS0102 I2C ONLY | 1 | VCCA | +3V3 | 22.86 | 41.91
J7 | TXS0102 I2C ONLY | 2 | GND | GND | 25.4 | 41.91
J7 | TXS0102 I2C ONLY | 3 | A1 | SCL_3V3 | 27.939999999999998 | 41.91
J7 | TXS0102 I2C ONLY | 4 | A2 | SDA_3V3 | 30.48 | 41.91
J7 | TXS0102 I2C ONLY | 5 | VCCB | +5V | 33.019999999999996 | 41.91
J7 | TXS0102 I2C ONLY | 6 | OE | +3V3 | 35.56 | 41.91
J7 | TXS0102 I2C ONLY | 7 | B1 | SCL_5V | 38.1 | 41.91
J7 | TXS0102 I2C ONLY | 8 | B2 | SDA_5V | 40.64 | 41.91
J3 | MAX31855 VIN | 1 | VIN_SELECT | TC_VIN | 45.72 | 41.91
J3 | MAX31855 VIN | 2 | GND | GND | 48.26 | 41.91
J3 | MAX31855 VIN | 3 | DO | TC_DO | 50.8 | 41.91
J3 | MAX31855 VIN | 4 | CS | TC_CS | 53.339999999999996 | 41.91
J3 | MAX31855 VIN | 5 | SCK | TC_SCK | 55.879999999999995 | 41.91
J8 | DRY CONTACTS ONLY | 1 | BREW_CONTACT | BREW_CONTACT | 60.96 | 41.91
J8 | DRY CONTACTS ONLY | 2 | STEAM_CONTACT | STEAM_CONTACT | 63.5 | 41.91
J8 | DRY CONTACTS ONLY | 3 | GND | GND | 66.04 | 41.91
J8 | DRY CONTACTS ONLY | 4 | GND | GND | 68.58 | 41.91
J6 | VALVE SSR HIGH5V | 1 | VCC5V | +5V | 76.2 | 41.91
J6 | VALVE SSR HIGH5V | 2 | GND | GND | 78.74000000000001 | 41.91
J6 | VALVE SSR HIGH5V | 3 | IN | VALVE_IN | 81.28 | 41.91
J10 | HEATER UNUSED | 1 | VCC5V | +5V | 86.36 | 5.08
J10 | HEATER UNUSED | 2 | GND | GND | 86.36 | 7.62
J10 | HEATER UNUSED | 3 | IN | HEATER_5V | 86.36 | 10.16
U2 | SN74AHCT125N PDIP14 | 1 | 1OE | GND | 77.47 | 20.32
U2 | SN74AHCT125N PDIP14 | 2 | 1A | VALVE_3V3 | 77.47 | 22.86
U2 | SN74AHCT125N PDIP14 | 3 | 1Y | VALVE_5V | 77.47 | 25.4
U2 | SN74AHCT125N PDIP14 | 4 | 2OE | GND | 77.47 | 27.94
U2 | SN74AHCT125N PDIP14 | 5 | 2A | HEATER_3V3 | 77.47 | 30.48
U2 | SN74AHCT125N PDIP14 | 6 | 2Y | HEATER_5V | 77.47 | 33.019999999999996
U2 | SN74AHCT125N PDIP14 | 7 | GND | GND | 77.47 | 35.56
U2 | SN74AHCT125N PDIP14 | 14 | VCC | +5V | 85.09 | 20.32
U2 | SN74AHCT125N PDIP14 | 13 | 4OE | +5V | 85.09 | 22.86
U2 | SN74AHCT125N PDIP14 | 12 | 4A | GND | 85.09 | 25.4
U2 | SN74AHCT125N PDIP14 | 11 | 4Y | NC | 85.09 | 27.94
U2 | SN74AHCT125N PDIP14 | 10 | 3OE | +5V | 85.09 | 30.48
U2 | SN74AHCT125N PDIP14 | 9 | 3A | GND | 85.09 | 33.019999999999996
U2 | SN74AHCT125N PDIP14 | 8 | 3Y | NC | 85.09 | 35.56
R1 | 10k 1% 0805 | 1 | 1 | DETECT_EN | 42.2675 | 24.13
R1 | 10k 1% 0805 | 2 | 2 | BOARD_ID | 44.0925 | 24.13
R2 | 1.2k 1% 0805 | 1 | 1 | BOARD_ID | 47.3475 | 24.13
R2 | 1.2k 1% 0805 | 2 | 2 | GND | 49.1725 | 24.13
C2 | 100nF 50V 0805 | 1 | 1 | BOARD_ID | 52.39 | 24.13
C2 | 100nF 50V 0805 | 2 | 2 | GND | 54.29 | 24.13
R3 | 10k 0805 | 1 | 1 | VALVE_3V3 | 21.9475 | 15.24
R3 | 10k 0805 | 2 | 2 | GND | 23.7725 | 15.24
R4 | 10k 0805 | 1 | 1 | HEATER_3V3 | 11.7875 | 15.24
R4 | 10k 0805 | 2 | 2 | GND | 13.6125 | 15.24
R5 | 10k 0805 | 1 | 1 | PUMP_PWM | 27.0275 | 15.24
R5 | 10k 0805 | 2 | 2 | GND | 28.8525 | 15.24
R6 | 1k 0805 | 1 | 1 | BREW_CONTACT | 42.2675 | 38.1
R6 | 1k 0805 | 2 | 2 | BREW | 44.0925 | 38.1
R8 | 10k 0805 | 1 | 1 | +3V3 | 47.3475 | 38.1
R8 | 10k 0805 | 2 | 2 | BREW | 49.1725 | 38.1
C4 | 100nF 50V 0805 | 1 | 1 | BREW | 52.39 | 38.1
C4 | 100nF 50V 0805 | 2 | 2 | GND | 54.29 | 38.1
R7 | 1k 0805 | 1 | 1 | STEAM_CONTACT | 57.5075 | 38.1
R7 | 1k 0805 | 2 | 2 | STEAM | 59.3325 | 38.1
R9 | 10k 0805 | 1 | 1 | +3V3 | 62.5875 | 38.1
R9 | 10k 0805 | 2 | 2 | STEAM | 64.4125 | 38.1
C5 | 100nF 50V 0805 | 1 | 1 | STEAM | 67.63 | 38.1
C5 | 100nF 50V 0805 | 2 | 2 | GND | 69.53 | 38.1
R13 | 0R 0805 LINK | 1 | 1 | VALVE_5V | 70.2075 | 35.56
R13 | 0R 0805 LINK | 2 | 2 | VALVE_IN | 72.0325 | 35.56
R12 | 1k 0805 | 1 | 1 | PRESSURE_RAW | 19.4075 | 24.13
R12 | 1k 0805 | 2 | 2 | PRESSURE | 21.2325 | 24.13
C6 | 100nF 50V 0805 | 1 | 1 | PRESSURE | 24.45 | 24.13
C6 | 100nF 50V 0805 | 2 | 2 | GND | 26.35 | 24.13
C1 | 100nF 50V 0805 | 1 | 1 | +5V | 80.33 | 15.24
C1 | 100nF 50V 0805 | 2 | 2 | GND | 82.23 | 15.24
R10 | 1k 0805 | 1 | 1 | ZC_RAW | 72.11249999999998 | 2.540000000000001
R10 | 1k 0805 | 2 | 2 | ZC_SCHMITT_IN | 73.93749999999999 | 2.540000000000001
R11 | 10k 0805 | 1 | 1 | +5V | 80.3675 | 10.16
R11 | 10k 0805 | 2 | 2 | ZC_RAW | 82.1925 | 10.16
C3 | 100nF 50V 0805 | 1 | 1 | +3V3 | 75.25 | 10.16
C3 | 100nF 50V 0805 | 2 | 2 | GND | 77.15 | 10.16
U3 | SN74LVC1G17DBV SOT23-5 | 1 | NC | NC | 76.3325 | 4.13
U3 | SN74LVC1G17DBV SOT23-5 | 2 | A5V_TOLERANT | ZC_SCHMITT_IN | 76.3325 | 5.08
U3 | SN74LVC1G17DBV SOT23-5 | 3 | GND | GND | 76.3325 | 6.03
U3 | SN74LVC1G17DBV SOT23-5 | 4 | Y3V3 | PUMP_ZC | 78.6075 | 6.03
U3 | SN74LVC1G17DBV SOT23-5 | 5 | VCC3V3 | +3V3 | 78.6075 | 4.13
