rico-x/GemilaiMate/docs/modules.csv

Component | Selected_variant | Quantity | Reference_URL | Status
ESP32-S3 N8R8 | ESP32-S3-N8R8 | 1 | https://aliexpress.ru/item/1005001953904745.html?sku_id=12000048029969241 | Verify received model/pinout and ratings; not hardware validated
LilyGo T-RGB 2.1 | CST820 Full Circle | 1 | https://aliexpress.ru/item/1005004778542414.html?sku_id=12000031497989223 | Verify received model/pinout and ratings; not hardware validated
MAX31855K | MAX31855 K-type, 1 штука | 1 | https://aliexpress.ru/item/33050360870.html?sku_id=67508712590 | Verify received model/pinout and ratings; not hardware validated
Датчик давления XIDIBEI XDB401 | 5V OUT 0.5-4.5V; 0-1.6Mpa; G1/4 по описанию | 1 | https://aliexpress.ru/item/1005007148779919.html?sku_id=12000047074417511 | Verify received model/pinout and ratings; not hardware validated
Термопара Finglai FTARB03-K-U M3 | M3 6x6.8mm bolt hex; маркировка K-U в характеристиках | 1 | https://aliexpress.ru/item/1005004948080451.html?sku_id=12000055989597775 | Verify received model/pinout and ratings; not hardware validated
Диммер RobotDyn | 16A-Standard, 1 шт.; не DimmerLink | 1 | https://aliexpress.ru/item/1005001965951718.html?sku_id=12000044296027587 | Verify received model/pinout and ratings; not hardware validated
ADS1115 | ADS1115 Blue | 1 | https://aliexpress.ru/item/1005009774074735.html?sku_id=12000050121529945 | Verify received model/pinout and ratings; not hardware validated
TXS0102 | TXS0102;1 шт. | 1 | https://aliexpress.ru/item/32898604164.html?sku_id=65803725915 | Verify received model/pinout and ratings; not hardware validated
SSR клапана TZT | 5V1wayHigh;1PCS | 1 | https://aliexpress.ru/item/1005004574175141.html?sku_id=12000057604741628 | Verify received model/pinout and ratings; not hardware validated
