rico-x/GemilaiMate/docs/purchase-kit.md

# Пример закупки одного комплекта

Фактическая закупка владельца на AliExpress 29.10.2026 для одной машины, carrier или shield. Это пример, а не проверенный список: детали ещё не получены и не собраны. Сетевые клеммы и фитинги выбраны до замеров в машине, см. [открытые вопросы](validation.md).

- Цена за позицию, без доставки, на дату заказа. Продавцы меняют цены и снимают товары; ссылка фиксирует вариант (`sku_id`), наличие проверять заново.
- Выбор: сначала количество и качество отзывов, цена вторична. Часть позиций взята из комбо-корзины (заказ от 1 000 ₽, общая доставка).
- «уп.» — одной упаковки хватает на комплект с запасом. Что куплено сверх комплекта, указано в разделе 11.
- PCB заказаны отдельно: [производство](manufacturing.md). Назначение выводов — [интерфейсы](interfaces.md), жгуты — [таблица жгутов](harnesses.md).

## 1. Детали на плату — 802,24 ₽

| Позиция | На комплект | Цена | Назначение |
|---|---|---:|---|
| [Резисторы 0805 1% 10 кОм](https://aliexpress.ru/item/1005004542788613.html?sku_id=12000029544739785), 100 шт. | 7 | 32 ₽ | R1 — верхнее плечо BOARD_ID; R3–R5 — стяжки VALVE, HEATER, PUMP_PWM к GND, выходы выключены при старте; R8, R9 — подтяжки кнопок к 3,3 В; R11 — подтяжка ZC к 5 В |
| [Резисторы 1,2 кОм](https://aliexpress.ru/item/1005004542788613.html?sku_id=12000029544739764) | 1 | 32 ₽ | R2 — нижнее плечо BOARD_ID |
| [Резисторы 1 кОм](https://aliexpress.ru/item/1005004542788613.html?sku_id=12000029544739763) | 4 | 32 ₽ | R6, R7 — последовательно в линиях кнопок; R10 — вход ZC в U3; R12 — RC-фильтр давления |
| [Резисторы 0 Ом](https://aliexpress.ru/item/1005004542788613.html?sku_id=12000029544739662) | 1 | 32 ₽ | R13 — перемычка в цепи клапана |
| [Конденсаторы 0805 100 нФ 50 В X7R](https://aliexpress.ru/item/1005007108081207.html?sku_id=12000039428469197), 100 шт. | 6 | 239 ₽ | C1, C3 — развязка 5 В и 3,3 В; C2 — BOARD_ID; C4, C5 — антидребезг кнопок; C6 — фильтр давления |
| [SN74LVC1G17DBVR](https://aliexpress.ru/item/1005009187973393.html?sku_id=12000048238377635), 10 шт. | 1 | 111 ₽ | U3 — триггер Шмитта сигнала ZC (переход сети через ноль) |
| [SN74AHCT125N DIP-14](https://aliexpress.ru/item/1005013157881410.html?sku_id=12000060441428861), 3 шт. | 1 | 51 ₽ | U2 — буфер 3,3 → 5 В для SSR клапана и выхода нагрева |
| [Гнёзда 1×40 2,54 мм](https://aliexpress.ru/item/1005008682898765.html?sku_id=12000059750671000), 10 шт. | carrier 2 полосы, shield 3 | 136,74 ₽ | U1 ESP32 (2×22). На shield ещё J2 ADS1115, J7 TXS0102, J3 MAX31855, кабельные J5, J6. Высота ≥8,5 мм |
| [Штыревые гребёнки 1×40](https://aliexpress.ru/item/1005012745679662.html?sku_id=12000059840202792), 6 шт. | carrier 2 полосы, shield 1 | 67,50 ₽ | J1, J4, J8, J9, J10, JP1, JP3; на carrier ещё J2, J3, J5, J6, J7. Штыри модулей обычно идут с модулями |
| [Перемычки 2,54 мм](https://aliexpress.ru/item/1005004482029258.html?sku_id=12000061168227641), 100 шт. | 2 | 69 ₽ | JP1 — разрыв +5 В при прошивке по USB; JP3 — выбор питания MAX31855 |

## 2. Модули — 4 989 ₽

| Позиция | На комплект | Цена | Назначение |
|---|---|---:|---|
| [ESP32-S3 DevKit N8R8](https://aliexpress.ru/item/1005001953904745.html?sku_id=12000048029969241) | 1 | 369 ₽ | Контроллер: помпа, клапан, датчики. Ставится в U1, просвет под ним ≥5 мм |
| [LilyGo T-RGB 2.1″ CST820](https://aliexpress.ru/item/1005004778542414.html?sku_id=12000031497989223) | 1 | 3 223 ₽ | Дисплей и интерфейс; питание от J9, связь с контроллером по BLE |
| [ADS1115 Blue](https://aliexpress.ru/item/1005009774074735.html?sku_id=12000050121529945) | 1 | 119 ₽ | АЦП датчика давления, вход A0, адрес I²C 0x48 |
| [TXS0102 (CJMCU-0102)](https://aliexpress.ru/item/32898604164.html?sku_id=65803725915) | 1 | 76 ₽ | Уровни I²C 3,3 ↔ 5 В между ESP32 и ADS1115 |
| [MAX31855 K](https://aliexpress.ru/item/33050360870.html?sku_id=67508712590) | 1 | 393 ₽ | Усилитель термопары K, SPI |
| [RobotDyn 16A Standard](https://aliexpress.ru/item/1005001965951718.html?sku_id=12000044296027587) | 1 | 722 ₽ | Фазовое управление помпой (PSM) и детектор ZC; жгут J5 |
| [SSR TZT 5V 1 канал High](https://aliexpress.ru/item/1005004574175141.html?sku_id=12000057604741628) | 1 | 87 ₽ | Реле клапана Brew; жгут J6 на штатную входную клемму |

## 3. Датчики — 1 578 ₽

| Позиция | На комплект | Цена | Назначение |
|---|---|---:|---|
| [XDB401 0–1,6 МПа, 0,5–4,5 В, G1/4](https://aliexpress.ru/item/1005007148779919.html?sku_id=12000047074417511) | 1 | 1 199 ₽ | Давление пролива; J4 → RC-фильтр → ADS1115 |
| [Термопара K Finglai FTARB03-K, болт M3](https://aliexpress.ru/item/1005004948080451.html?sku_id=12000055989597775) | 1 | 379 ₽ | Температура бойлера, в отверстие M3 сверху; к MAX31855 |

## 4. Питание — 1 367 ₽

| Позиция | На комплект | Цена | Назначение |
|---|---|---:|---|
| [MEAN WELL RS-25-5, 5 В 5 А](https://aliexpress.ru/item/1_654059256.html?sku_id=5000003388873206) | 1 | 884 ₽ | Изолированные 5 В для платы и дисплея, цепь M1. Запасной вариант, не куплен: [HDR-60-5](https://aliexpress.ru/item/1005008339626599.html?sku_id=12000044654383758), 1 289 ₽ + 851 ₽ доставка |
| [Кабель USB-C 5 В 3 А, угловой, 1 м](https://aliexpress.ru/item/1005008149396644.html?sku_id=12000043999104616) | 1 | 66 ₽ | Питание дисплея от J9: кабель режется, VBUS и GND — в колодку 1×2 |
| [Предохранители T2A 250 В 5×20](https://aliexpress.ru/item/1005009095345250.html?sku_id=12000047892225154), 5 шт. | 1 | 274 ₽ | Защита входа БП, цепь M1 |
| [Держатель предохранителя 5×20](https://aliexpress.ru/item/1005007910707716.html?sku_id=12000042808025090) | 1 | 143 ₽ | В разрыв L перед БП |

## 5. Низковольтные жгуты — 751 ₽

| Позиция | На комплект | Цена | Назначение |
|---|---|---:|---|
| [Набор DuPont TENSTAR](https://aliexpress.ru/item/4001244242602.html?sku_id=10000015440686923): корпуса 1–8 конт., штыревые и гнездовые контакты | 1 | 203 ₽ | Жгуты J1–J9. J5 — корпус 1×4; J6 — 1×3 с гнёздами (carrier) или 1×5 со штырями, заняты 1/3/5 (shield) |
| [Силиконовый провод 22 AWG, красный](https://aliexpress.ru/item/4000627624331.html?sku_id=10000004331445213), 5 м | 1 | 279 ₽ | +5 В и сигналы |
| [Силиконовый провод 22 AWG, чёрный](https://aliexpress.ru/item/4000627624331.html?sku_id=10000004331445226), 5 м | 1 | 269 ₽ | GND и сигналы |

## 6. Сетевая часть 230 В — 2 181,52 ₽

| Позиция | На комплект | Цена | Назначение |
|---|---|---:|---|
| Силиконовый провод 18 AWG, 1 м: [красный](https://aliexpress.ru/item/4000627624331.html?sku_id=10000004331445215), [чёрный](https://aliexpress.ru/item/4000627624331.html?sku_id=10000004331445228), [синий](https://aliexpress.ru/item/4000627624331.html?sku_id=10000004331445241) | по 1 | 3 × 219 ₽ | Цепи M1–M6: красный — L, чёрный — коммутируемая L к переключателю, помпе и клапану, синий — N |
| [Наконечники НШВИ](https://aliexpress.ru/item/1_639524197.html?sku_id=5000003348362034), 300 шт. | 1 набор | 427 ₽ | Многожильный провод в винтовых клеммах БП, RobotDyn, SSR |
| Вилки [SV1.25-4](https://aliexpress.ru/item/1005012284491249.html?sku_id=12000057988354862), [SV1.25-5](https://aliexpress.ru/item/1005012284491249.html?sku_id=12000057988354867) | по 1 уп. | 2 × 117 ₽ | Под винтовые клеммы M3,5–M4 и M5, в том числе переключателя режима; какие нужны — по месту |
| [Клеммы 6,3 мм изолированные](https://aliexpress.ru/item/1005009903886809.html?sku_id=12000059848947571), 50 пар | 1 | 259 ₽ | Переходники: штатные разъёмы помпы и клапана — на переключатель режима (M5), провода не резать |
| DJ6212 с изолятором: [6,3 мм](https://aliexpress.ru/item/1005012230826158.html?sku_id=12000057809115477), [4,8 мм](https://aliexpress.ru/item/1005012230826158.html?sku_id=12000057809115476) | по 1 | 78 + 54 ₽ | Под лепестки помпы и катушки клапана; размер лепестков проверить в машине |
| Клеммы 2,8 мм: [DJ621 гнездо](https://aliexpress.ru/item/1005012437326595.html?sku_id=12000058359923156), [DJ611 штырь](https://aliexpress.ru/item/1005012437326595.html?sku_id=12000058359923152), по 50 шт. | по 1 | 2 × 146 ₽ | Переходники к лепесткам 2,8 мм штатной проводки, если они есть |
| [Колпачки клемм 2,8 мм](https://aliexpress.ru/item/4001080026905.html?sku_id=10000014219986023), 50 шт. | 1 | 116 ₽ | Изоляция клемм 2,8 мм |
| [RC-снаббер, модуль](https://aliexpress.ru/item/1005002449519632.html?sku_id=12000059750666976) | 1 | 64,52 ₽ | Параллельно катушке клапана (M6), гасит выброс при выключении SSR |
| Переключатель режима — **не куплено, взять в местном магазине** | 1 | — | Двухполюсный тумблер на 6 контактов, ВКЛ-ВЫКЛ-ВКЛ (подойдёт ВКЛ-ВКЛ), от 6 А 250 В~, с колпачком. Ориентир — [E-TEN1322 TLZWLA](https://aliexpress.ru/item/1005005691211359.html?sku_id=12000034136874348), 127 ₽. «Штат» — помпа и клапан от штатной платы, «GM» — от RobotDyn и SSR, середина — отключены |

## 7. Гидравлика: врезка у штатного манометра — 1 081 ₽

| Позиция | На комплект | Цена | Назначение |
|---|---|---:|---|
| [Тройник 1/4″ BSP, три внутренние резьбы, нерж. 304](https://aliexpress.ru/item/4001251037492.html?sku_id=10000015490984901) | 1 | 661 ₽ | Два отвода — разрезанная трубка манометра, третий — датчик |
| [Компрессионный штуцер 4 мм × 1/4″ BSPT, нерж. 304](https://aliexpress.ru/item/1005006746005988.html?sku_id=12000042154835942) | 2 | 2 × 116 ₽ | Трубка манометра 4 мм в тройник; по описанию 16 МПа, до 450 °C |
| [Трубка ПТФЭ 2×4 мм](https://aliexpress.ru/item/1005001446770552.html?sku_id=12000016141649916), 1 м | 1 | 74 ₽ | Удлинение отвода, если штатной трубки не хватит |
| [Силиконовые прокладки 1/4″, 3 мм](https://aliexpress.ru/item/4000027435343.html?sku_id=10000000062043351), 10 шт. | 1 | 114 ₽ | Уплотнение G1/4 датчика |
| ФУМ-лента | 1 | — | Не покупалась, нужна для BSPT штуцеров |

Монтаж: штуцеры BSPT — 3–4 витка ФУМ-ленты; датчик G1/4 — только прокладка, без ленты, при неровном торце медная или алюминиевая шайба; трубку ПТФЭ вставить до упора и затянуть от руки плюс около ¾ оборота, сильный обжим её деформирует. Герметичность проверить под давлением помпы до установки датчика в корпус.

## 8. Крепёж — 429 ₽

| Позиция | На комплект | Цена | Назначение |
|---|---|---:|---|
| [Нейлоновые стойки, винты, гайки M3](https://aliexpress.ru/item/1005005263472533.html?sku_id=12000032409695282), 192 шт. | 1 набор | 429 ₽ | 4 точки крепления платы: головка ≤5,5 мм, без шайб. Остальное — на [держатель](retention.md) |

## 9. Необязательно, в проекте не предусмотрено — 286 ₽

| Позиция | Цена | Комментарий |
|---|---:|---|
| [Резисторы 220 Ом](https://aliexpress.ru/item/1005004542788613.html?sku_id=12000029544739747) | 32 ₽ | Последовательный резистор PUMP_PWM, если его добавят в следующей ревизии |
| [Варисторы 10D471K](https://aliexpress.ru/item/1005002283291324.html?sku_id=12000019906345052), 20 шт. | 155 ₽ | Защита от импульсов в сети, по месту |
| [Термисторы NTC 5D-9](https://aliexpress.ru/item/1005006583954806.html?sku_id=12000037730077405), 10 шт. | 99 ₽ | Ограничение пускового тока, по месту |
| Модуль VL53L0X — не куплено, в местном магазине | — | Датчик уровня воды в баке, навесным монтажом: [подключение](interfaces.md#датчик-уровня-воды-необязательно) |

## 10. Стенд и прошивка, один раз — 8 529,90 ₽

| Позиция | Цена | Назначение |
|---|---:|---|
| [FNIRSI DPS-150](https://aliexpress.ru/item/1_150459853.html?sku_id=5000000617435915) | 7 268,90 ₽ | Лабораторный БП с ограничением тока для первого включения, [стенд](bench.md) |
| [Логический анализатор 24 МГц, 8 каналов](https://aliexpress.ru/item/1005009093038845.html?sku_id=12000047885685654) | 359 ₽ | I²C, SPI, ZC, PSM |
| [Arduino Nano Type-C](https://aliexpress.ru/item/1005008598843208.html?sku_id=12000045891570084) | 199 ₽ | Генератор импульсов 0–5 В вместо ZC от сети |
| [MCP4725](https://aliexpress.ru/item/1005008748400479.html?sku_id=12000046505112338) | 61 ₽ | Имитация датчика давления 0,5–4,5 В |
| [Тестовые крючки SMD](https://aliexpress.ru/item/1005009795591520.html?sku_id=12000050187686391), 10 шт. | 363 ₽ | Щупы на выводы микросхем |
| [Кабель USB 3.2 A → C](https://aliexpress.ru/item/1005004626284967.html?sku_id=12000029883463702), 1 м | 279 ₽ | [Прошивка](flashing.md) ESP32 и дисплея |

## 11. Куплено сверх комплекта — 1 547,24 ₽

| Позиция | Сумма | Зачем |
|---|---:|---|
| ESP32-S3 N8R8, 2 шт. | 738 ₽ | Запас |
| SN74AHCT125N, гнёзда 1×40, гребёнки 1×40 — по 1 уп. | 255,24 ₽ | Запас |
| [SN74LVC1G17, другой продавец](https://aliexpress.ru/item/1005012149495291.html?sku_id=12000057645328874), 3 × 50 шт. | 483 ₽ | Дублирующий заказ на случай задержки основного |
| [MCP4725, другой продавец](https://aliexpress.ru/item/1005008806753528.html?sku_id=12000048418254989) | 71 ₽ | То же |

## Итого

| | Сумма |
|---|---:|
| Один комплект, разделы 1–8 | 13 178,76 ₽ |
| Докупить в местном магазине | переключатель режима; VL53L0X, если нужен уровень воды |
| Необязательно | 286 ₽ |
| Стенд и прошивка | 8 529,90 ₽ |
| Сверх комплекта | 1 547,24 ₽ |
| Товары всего | 23 541,90 ₽ |
| Доставка, 43 заказа | 3 844 ₽ |
| **Оплачено** | **27 385,90 ₽** |
