rico-x/GemilaiMate/hardware/shield-compact/manufacturing/README.md

# GemilaiMate Compact Shield 0.3.1: комплект прототипа

Не отправлять в производство как проверенный серийный проект. Нужны независимая проверка схемы/BOM, реальные размеры модулей и согласование стека/USB с фабрикой. Аппаратных испытаний нет.

Gerber ZIP: два медных слоя, без платы-панели и без заказа монтажа. На обеих сторонах заливка GND; внутренних слоёв нет. BOM: количества на 1/5 PCB; DNP не устанавливать. HARNESSES рассчитан на одну кофемашину, не на пять. SMD CPL содержит центры компонентов и вид сверху; у WROOM учтён сдвиг от начала посадочного места. Модуль включён в SMD несмотря на тепловые PTH-площадки; проверить предпросмотр сборщика. ADS1115, MAX31855 и CJMCU вставляются в отдельные гнёзда; реальные платы и межрядье CJMCU пока не измерены. Гнёзда модулей и JST паять со стороны, указанной в BOM-THT.

Под ручной монтаж: резисторы и малые конденсаторы 0805, 10 мкФ и предохранители 1206 — все с удлинёнными площадками HandSolder; SOT-23/SMA тоже HandSolder; микросхемы SOIC с шагом 1,27 мм. У полярных деталей на шелкографии точка первого вывода или черта катода. SMD паять до установки модулей: часть деталей стоит под ними. Основной модуль WROOM требует надёжной пайки центральной земли. Нужен ручной контроль сборки; один паяльник не гарантирует пайку скрытого контакта.

Схема, ограничения питания и испытания: ../../../docs/compact-shield.md.
