rico-x/GemilaiMate/hardware/shield/manufacturing/README.md

# Shield v0.2.4 - отдельная пробная партия

Заказной архив: `gemilaimate-shield-v0.2.4-prototype.zip`. Это второй активный вариант, не замена файла carrier v0.1.

- 5 одинаковых PCB, 90×75 мм, 2 слоя, FR-4 1,6 мм, медь 35 мкм, зелёная маска, белая маркировка с двух сторон, HASL, электротест.
- Только голые платы, без SMD/THT монтажа, трафарета и программирования.
- Переходы 0,7/0,3 мм, обычное тентирование обеих сторон; без заполнения и via-in-pad. Минимальные дорожки 0,2032 мм, правило зазора 0,2 мм.
- На PCB только низковольтные сигналы. J5 — четыре управляющих провода RobotDyn, J6 — три провода SSR, контакты 1/3/5. Силовые модули закреплены отдельно; прямого дока нет. Клеммы SSR сохраняются.
- `BOM-SMD.csv`: те же 20 деталей / 6 типов, что carrier v0.1.
- `BOM-THT.csv`: другой комплект гнёзд; не использовать BOM разъёмов от carrier. 112 паяных THT-контактов на самой PCB при одном нижнем ряде ESP32.
- `CPL-SMD.csv`: мм, начало в нижнем левом углу PCB, +X вправо, +Y вверх; высота для пересчёта 75 мм. Нужен только при отдельном решении о заводском монтаже. Сырые координаты KiCad — `positions-kicad.csv`.

**Прототип физически не проверен.** Межрядье CJMCU-0102 12,70 мм/G, геометрия клона MAX31855, ESP32, ответные колодки и держатель требуют сверки по `../module-profiles.json`, `../design.json` и шаблону 1:1. J4 сдвинут вправо на 1,27 мм; M3 с головкой ≤5,5 мм, без шайб. На гнёздах квадратная площадка 1, метка «1», контуры и подписи функций. Реальные размеры/высота RobotDyn/SSR и их отдельное размещение не подтверждены. План прижимов в `../../../docs/retention.md`.

Сохранённые ERC, DRC, unconnected и schematic parity равны нулю. Это не подтверждает физическую совместимость клонов или вписываемость в корпус Gemilai. Изготавливать как пробную партию, не объявлять серийно проверенным устройством.

Для сравнения заказать отдельно 5 carrier 90×46 и 5 shield 90×75. Это два дизайна PCB, а не количество 10 одного дизайна. Каждый архив загрузить отдельной позицией. Не использовать файлы одного варианта для другого.
