rico-x/GemilaiMate/docs/manufacturing.md

# Изготовление carrier v0.1

Текущий заказный файл: [`gerber-drill.zip`](../hardware/carrier/manufacturing/gerber-drill.zip). 5 шт., FR-4 1,6 мм, два слоя, медь 35 мкм, зелёная маска, белая маркировка с обеих сторон, HASL, электротест. Контур 90×46 мм. На PCB нет сетевых цепей. Переходы 0,7/0,3 мм, обычное тентирование, без заполнения via-in-pad. Минимальная дорожка 0,2032 мм, правило зазора 0,2 мм.

Для первой попытки разумно изготовить 5 голых PCB и собрать одну вручную: 20 SMD, из них 19 двухвыводных 0805 и один SOT-23-5. Инструменты пайки/кримпинга у владельца уже есть. Перед заказом всё ещё необходимы сверка реального ESP32 по шаблону и проверка высоты гнёзд.

Ориентиры на 28.10.2026, доставка в Россию; это расчёт, не КП:

| Вариант | Бюджет |
|---|---:|
| 5 голых PCB по публичному тарифу PCBPI | 2 890 ₽ |
| 5 PCB + мелкие детали для одной ручной сборки и их отдельная доставка | 3 400-4 400 ₽ |
| 5 PCB, заводской SMD на двух | около 16 000-20 000 ₽ |
| 5 PCB, заводской SMD на всех пяти | около 17 000-23 000 ₽ |

[PCBPI](https://pcbpi.ru/) публикует 2 890 ₽/5 FR-4 до 100×100 мм с доставкой; итог подтверждается после CAM. Для ручной сборки добавлен наш резерв 300-1 000 ₽ на мелкие детали и 200-500 ₽ на их доставку. Это не проверка качества поставщика.

[Резонит PCB](https://www.rezonit.ru/price_pcb/): подготовка 3 200 +590 ₽/дм²; пять плат 2,07 дм² ->4 421,30 ₽ до опций/доставки. [Подготовка монтажа](https://www.rezonit.ru/price_assembly/) от 6 000 ₽/сторону, детали/работа отдельно; чужие PCB не принимают. [Трафарет](https://www.rezonit.ru/price_stencil/): 3 600 +43×3,05 =3 731,15 ₽ для одной позиции платы. Для PCBA-модели приняты отдельные рамки 100×56 мм ->4 852 ₽/5 PCB; рамок в Gerber нет, панель/реперы согласует завод. Наш резерв на работу/компоненты/доставку даёт 15 883-18 483 ₽ для двух собираемых плат и 17 083-22 083 ₽ для пяти; округление учитывает возможную другую панель. Счёт может отличаться.

В суммы не входят ESP32, дисплей, внешние модули/датчики, силовая часть, корпуса и гидравлика; их фактическая закупка — в [примере](purchase-kit.md). Полный THT-монтаж и функциональный тест/программирование на заводе отдельно не оценены. Производитель должен согласовать U3 pin 1, CPL, аналоги, поля/реперы, маску и компактную маркировку 0,8 мм. Расчёт запрашивать с явным указанием «ТОЛЬКО РАСЧЁТ, НЕ ЗАПУСКАТЬ»; заказов и оплат не было.

## Две отдельные пробные партии

Наряду с carrier v0.1 подготовлен [shield v0.2.4](shield.md), 90×75 мм. Его отдельный архив: [gemilaimate-shield-v0.2.4-prototype.zip](../hardware/shield/manufacturing/gemilaimate-shield-v0.2.4-prototype.zip). Оба варианта активны. Заказывать **5 carrier + 5 shield как два разных дизайна**, без монтажа. Не выбирать просто 10 одинаковых плат.

Оба прямоугольника попадают в публичный тариф PCBPI до 100×100 мм: ориентир 2×2 890 = **5 780 ₽ за десять плат двух дизайнов**, если при CAM не появятся доплаты. Это расчёт по опубликованному тарифу, индивидуальное КП на новый shield не получено. Монтаж гнёзд/деталей, ответные штыри и крепёж оплачиваются отдельно. Для shield остаются непроверенные геометрические допущения; перед заказом сверить реальные модули и SVG 1:1. [Общий черновик запроса](../hardware/shield/manufacturing/RFQ-RU.md).

Для одинакового электротеста расчёт по Резониту для carrier составляет 3 200 + 2,07×(590+40) = 4 504,10 ₽; для shield — 3 200 + 3,375×(590+40) = 5 326,25 ₽. Вместе около 9 830,35 ₽ до доставки при доступном стандартном тарифе и материале 1,5 мм; это альтернатива проектным 1,6 мм, не индивидуальное КП. Предыдущая сумма 4 421,30 ₽ выше в документе была базой до опций и электротест не включает.

## Compact Shield 0.3.1

Текущий compact — **76×61 мм, 2 слоя, 1,6 мм, 1 oz**. [Архив Gerber/Excellon](../hardware/shield-compact/manufacturing/gemilaimate-compact-0.3.1-PROTOTYPE.zip), [BOM на 1/5 плат](../hardware/shield-compact/manufacturing/BOM.csv), [описание сборки](compact-shield.md). Минимальный зазор меди 0,21 мм (>8 mil), между контактами USB 0,22 мм; дорожка от 0,20 мм; обычные зазоры 0,25 мм, питание/USB 0,30 мм; питание не уже 0,30 мм. USB-C — HRO TYPE-C-31-M-12. Аппаратные испытания и примерка модулей пока не выполнены.
