rico-x/GemilaiMate/docs/assembly.md

# Сборка carrier v0.1

Этот документ описывает **carrier v0.1**. Для второго варианта см. [shield v0.2.4](shield.md): его разъёмы J2/J3/J6/J7 имеют другую распиновку.

Жгуты J5/J6 собирать в цельных корпусах по [таблице корпусов](harnesses.md): на carrier J5 — 1×4, J6 — 1×3, гнездовые контакты. На shield у J6 другой корпус и занятые позиции. Общий корпус не защищает от разворота на 180°: отметить первый контакт и проверить каждую цепь до питания.

Carrier в сборе, 3D-вид

3D-виды в сборе: [спереди](../hardware/carrier/previews/assembled-3d-front.png), [сзади](../hardware/carrier/previews/assembled-3d-back.png), [сверху](../hardware/carrier/previews/assembled-3d-top.png). Показан нижний ряд гнёзд A и перемычки JP1/JP3 в положении 1-2. DevKit упрощён (плата, USB-C, BOOT/RESET), модуль ESP32-S3-WROOM-1 - модель KiCad; геометрия реального клона и высоты требуют сверки.

Подключение модулей и узлов машины по жгутам — [страница на GitHub Pages](https://rico-x.github.io/GemilaiMate/wiring.html) (тот же файл в репозитории: [docs/wiring.html](wiring.html)): схема с выводами каждого модуля, 3D-вид и таблицы жгутов. Сетевая часть там нарисована по референсной переделке и для 3007Z требует проверки. Локальный файл открывается в браузере; 3D-вид загружает three.js из интернета.

Плата 90×46 мм, два слоя, только низковольтные цепи. 34 схемные позиции. Сверху 20 SMD: R1-R13, C1-C6, U3 SOT-23-5; 43 SMD-контакта. Выводные детали: U2 DIP14, разъёмы и два гнезда ESP32 по 22 контакта. При выборе одного нижнего ряда - 103 выводных паяных контакта.

1. Сверить реальный ESP32 N8R8 с PDF 1:1: 44 контакта, USB слева, антенна справа. Нижний ряд выбрать один: A 22,86 мм либо B 25,40 мм. Проверить GPIO38/48 и отсутствие занятого GPIO35/36/37 у N8R8.
2. Между нижними элементами DevKit и carrier оставить **не менее 5 мм** для SMD. Гнёзда номинально около 8,5 мм или выше выбираются по фактическому просвету. Одновременная установка двух нижних рядов не предусмотрена.
3. Сначала паять SMD, затем U2/разъёмы, затем гнёзда U1. Проверить U3: DBV SOT-23-5, 1 NC, 2 A, 3 GND, 4 Y, 5 VCC. Ориентацию U2 и первого контакта брать по монтажному рисунку.
4. GND-площадки соединены с заливками сплошь: 35 всего, 24 PTH и 11 SMD, включая альтернативные позиции U1. Нужны достаточная теплоподача и массивное жало; при необходимости подогрев. Ориентир от 60 Вт не заменяет осмотра смачивания. Прозвонить GND от J1.2 до каждого установленного разъёма.
5. Проверить отсутствие КЗ и полярность питания без MCU. Сначала включать с ограничением тока. Контроллер установить после этих проверок.

Наши отверстия M3: Ø3,2 мм, (3;3), (87;43) мм от верхнего левого угла. Два диагональных винта не подтверждают виброустойчивость: нужен изолирующий держатель с опорой свободных углов и разгрузкой жгутов. Не сверлить дополнительные отверстия в существующей разводке. Опоры и металл не должны касаться меди/выводов. После часового испытания помпы проверить люфт гнёзд и платы.

JP1 снять для USB контроллера. JP3 1-2: VIN 5 В только для MAX31855 с подходящим регулятором; 2-3: совместимый модуль 3,3 В. Сигнальные уровни MAX должны оставаться 3,3 В. R13=0 Ом соединяет 5 В буфер с входом SSR; для другого драйвера его можно удалить, но автоматического переключения на 3,3 В нет. J10 нагревателя в данной адаптации не подключать.

J8 принимает только независимые сухие контакты. До соединения со штатной кнопкой выяснить её схему и изоляцию. Базовая пара: R8/R9=10 кОм, R6/R7=1 кОм, ток около 0,35 мА. Проверить 100 нажатий. Условная переделка при неподходящих контактах: **одновременно** R8/R9=2,2 кОм и R6/R7=220 Ом (около 1,4 мА); эти альтернативы не входят в базовую BOM. Менять только подтяжку нельзя. Надёжность контакта требует паспорта/проверки даже при повышенном токе.

ADS1115 разместить близко к J2. Участок A0 после R12/C6 вести коротко с GND, вдали от силовых проводов. Сравнить шум давления с работающей помпой и по манометру; фильтр на carrier не подтверждает подавление помех на всём кабеле.
