rico-x/GemilaiMate/hardware/shield/manufacturing/RFQ-RU.md

# Пробная партия двух вариантов - черновик, не отправлен

Просьба рассчитать две отдельные позиции без монтажа компонентов:

1. GemilaiMate carrier v0.1: 5 шт., 90×46 мм; архив из `hardware/carrier/manufacturing/gerber-drill.zip`.
2. GemilaiMate shield v0.2.4: 5 шт., 90×75 мм; архив `gemilaimate-shield-v0.2.4-prototype.zip` из этого каталога.

Обе позиции: 2 слоя, FR-4 1,6 мм, медь 35 мкм, зелёная маска, белая маркировка с двух сторон, HASL, электротест, обычное тентирование 0,7/0,3 мм, без заполнения переходов. Сетевых цепей на PCB нет. Панели/рамки не нужны: отдельные платы с фрезерованным внешним контуром и NPTH. Стандартный тариф, доставка физлицу в Россию.

Указать отдельно изготовление каждой позиции, доставку общего заказа, НДС и сроки. Если предлагается материал 1,5 мм вместо 1,6 мм, указать это явно. Не объединять 2 разных дизайна как 10 одинаковых плат и не менять расположение разъёмов/отверстий.

Это первые физические прототипы. На shield есть непроверенные механические допущения посадочных мест; электроника и размеры должны быть согласованы владельцем до запуска. **ТОЛЬКО РАСЧЁТ. НЕ ЗАПУСКАТЬ АВТОМАТИЧЕСКИ ДО ОТДЕЛЬНОГО ПОДТВЕРЖДЕНИЯ.** Никаких заказов и оплат агент не выполнял.
