rico-x/GemilaiMate/hardware/carrier/manufacturing/RFQ-RU.md

# Запрос расчёта - черновик

ТОЛЬКО РАСЧЁТ. НЕ ЗАПУСКАТЬ В ПРОИЗВОДСТВО, в том числе автоматически до оплаты.

GemilaiMate carrier v0.1: 5 PCB 90×46 мм, 2 слоя, FR-4 1,6 мм, медь 35 мкм, зелёная маска, белая маркировка с двух сторон, HASL, электротест. Обычный несрочный тариф, доставка физлицу в Россию. Gerber/раздельные PTH-NPTH Excellon в gerber-drill.zip.

Просьба отдельно оценить: только голые платы; SMD на 2 из 5; SMD на всех 5; необязательную пайку THT. DevKit не устанавливать. Указать подготовку, трафарет, компоненты и запас, работу, панель/реперы, НДС, доставку и сроки. Согласовать ориентацию U3 pin 1, CPL с нижним левым началом, аналоги и маркировку 0,8 мм. Габарит рабочей платы не менять. Проект ещё не проверялся физически; сначала нужны CAM и итоговый расчёт, затем отдельное решение о запуске.
