rico-x/GemilaiMate/tools/wiring_template.html

# %%H1%%

%%STAMP%%

%%LEAD%%

%%META%%

%%SVG%%

%%CAPTION%%

Жгут

## Выберите разъём

Наведите на провода схемы или нажмите на разъём, чтобы увидеть его контакты.

+5 В+3,3 ВGND I²C / SPIдавлениепомпа ZC / PSM клапанкнопкитермопара K сеть Lсеть Nкоммутируемая L штатный выход, проверитьполюса одного переключателявода

Изометрия Сверху Сеть 230 В Подписи Вращение — перетаскивание, масштаб — колесо или щипок. Наведите на провод, чтобы увидеть его жгут.

%%NOTE3D%%

%%TABLES%%

## Перед подключением

%%RULES%%

%%SRC%%
