rico-x/GemilaiMate/hardware/carrier/previews/assembled-3d-back.png

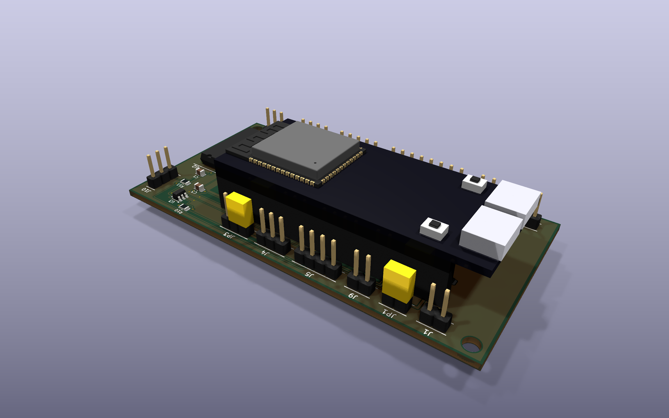
hardware/carrier/previews/assembled-3d-back.png
