rico-x/GemilaiMate/hardware/shield-compact/previews/assembled-back.png

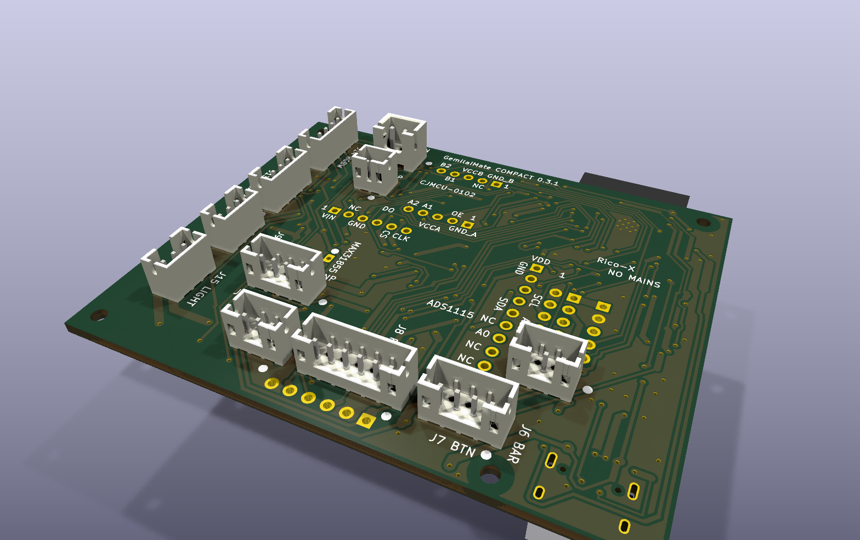
hardware/shield-compact/previews/assembled-back.png
