rico-x/GemilaiMate/hardware/shield-compact/previews/assembled-top.png

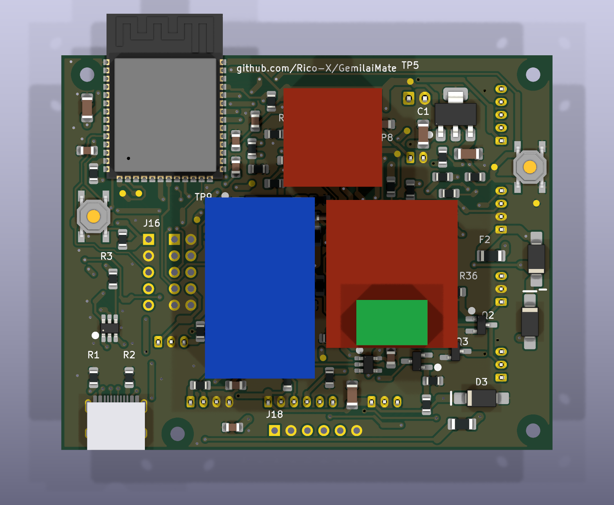
hardware/shield-compact/previews/assembled-top.png
