rico-x/GemilaiMate/hardware/shield-compact/previews/assembly-bottom.png

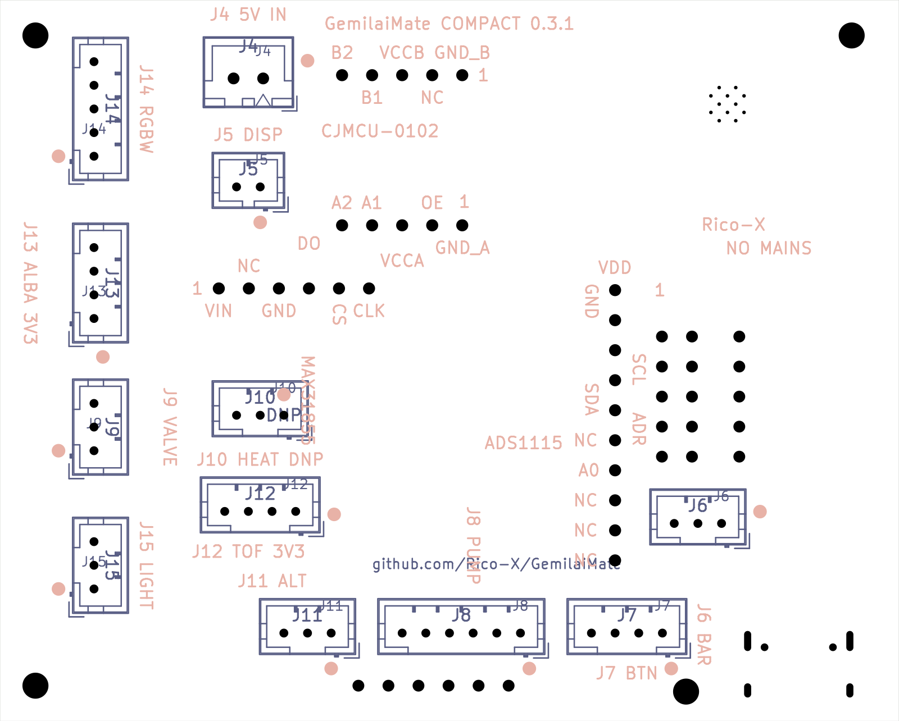
hardware/shield-compact/previews/assembly-bottom.png
