rico-x/GemilaiMate/hardware/shield-compact/previews/assembly-top.png

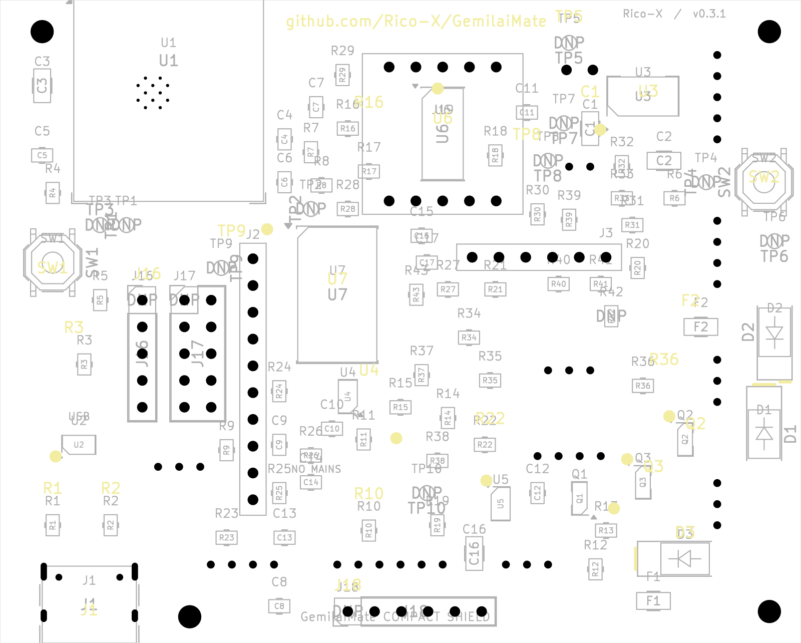
hardware/shield-compact/previews/assembly-top.png
