rico-x/GemilaiMate/hardware/shield/previews/assembled-3d-top.png

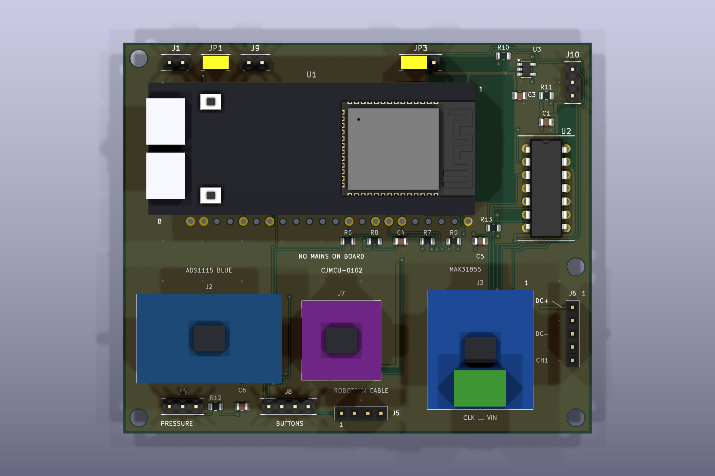
hardware/shield/previews/assembled-3d-top.png
