rico-x/GemilaiMate/hardware/shield/previews/assembly-top.png

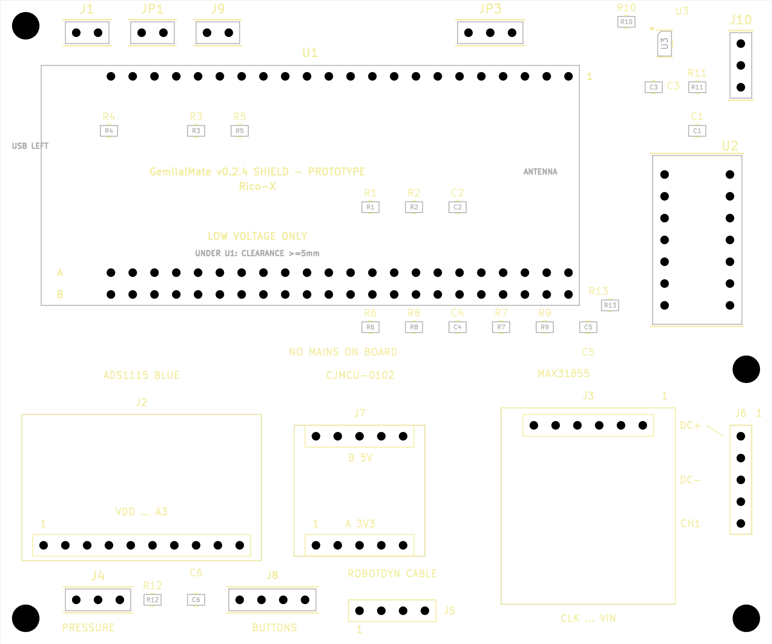
hardware/shield/previews/assembly-top.png
