rico-x/GemilaiMate/docs/validation.md

# Проверки GemilaiMate v0.1.0

**Физическая воспроизводимость пока не подтверждена:** PCB не изготовлена/не собрана, USB-запись, BLE и работа в Gemilai не испытывались. Проверки файлов не заменяют стенд.

Текущая ветка: **ERC 0, DRC 0, unconnected 0, parity 0; 19 host-сценариев; 9 тестов flasher; 42 теста Unity**. Семь сетевых тестов пропущены. Controller, controller-compact, display, Web UI и LittleFS собраны; размеры и SHA-256 13 файлов BIN проверяются manifest. Для carrier/shield сохранены 13 GPIO/29 цепей и исходная медь; их свежие ERC/DRC и CAM повторно проверены. Новая плата Compact проверяется отдельно по физическим номерам выводов и собственной карте GPIO.

[Ранее опубликованная базовая версия прошла GitHub CI](https://github.com/rico-x/GemilaiMate/actions/runs/40653238272). Эта ссылка не подтверждает новую ветку Compact: её проверки выполнены на стенде, публикация и запуск нового CI здесь не заявляются.

Текущая программа проверок: сборки controller/controller-compact/display и Web UI, LittleFS, заголовки и хеши BIN, 14 сценариев PumpPSM/DigitalInput, 5 PingWatchdog, 9 тестов flasher, обе карты GPIO, ERC/DRC с parity, сверка выводов, CAM и просмотр PDF/превью. Базовый `validation.json` относится к прежним вариантам; отчёты Compact находятся в `hardware/shield-compact/reports/`.

Сторож помпы: stop(0) немедленно опускает GPIO; потеря ZC при запросе мощности фиксирует аварию до перезапуска. Таймаут BLE сохраняет 20 с, метка пинга атомарна и читается до часов с перепроверкой устаревшего снимка. Host-тест моделирует сутки обмена, не выполняет суточный прогон ESP32.

ERC проверяет интерфейсную схему, не внутренние схемы купленных модулей. DRC действует с правилами проекта; пропущенные категории перечислены в ignored_checks отчёта. Не исключались соединения, замыкания, зазоры и parity. Габарит/распиновка клона, высота, SSR, ZC, кнопки, шум давления, вибрации, изоляция, силовая часть и гидравлика остаются предметом [стенда](bench.md). До заказа сверить шаблон и просвет ≥5 мм.

## Shield v0.2.4, 28.10.2026

Второй активный прототип, hardware/shield, 90×75 мм. Отчёты ERC/DRC/unconnected/parity относятся к этой ревизии. Сверяются 13 GPIO с неизменённой прошивкой v0.1.0, SMD BOM с carrier, CPL и физические координаты площадок. J4 сдвинут вправо на 1,27 мм. Отчёты carrier относятся только к carrier.

Дополнительно проверены реальные Gerber: у всех 121 PTH-площадок shield открыта паяльная маска с обеих сторон, переходы тентированы. Новая проверка выявляет закрытые маской выводные площадки, даже если DRC не сообщает об ошибках. Проверен и свежий запуск генератора посадочных мест.

Проверяются квадратная площадка 1, метка «1», полный F.Silkscreen-контур и функциональные подписи J2/J3/J5/J6/J7 непосредственно в KiCad PCB. Отдельный экспорт orientation-silkscreen показывает производственную маркировку.

Порядок крайних слов J2/J3 проверяется независимо по X реальных площадок PCB: у J3 слева CLK, справа VIN. Метки J2/J7 должны находиться внутри собственных контуров и рядом со своими рядами. `silk-clearance.json` содержит нативную проверку всех видимых текстов F.Silkscreen и B.Silkscreen, включая позиционные обозначения и поля компонентов: зазор их ограничивающих прямоугольников до всех переходов ≥0,15 мм. Полнота отчёта независимо сверяется с текстами PCB, без списка разрешённых имён. Для DC+, MAX31855 и ROBOTDYN CABLE дополнительно сохранён зазор ≥0,15 мм до передних дорожек; у остальных надписей число пересечений с дорожками информационное. Это дополнительная проверка вида маркировки над тентированными переходами; правила DRC не ослаблены. BOM обоих вариантов требует цельные маркированные корпуса жгутов, но механического ключа у них нет.

Механическая проверка охватывает номинальные объёмные зоны модулей, ответных колодок J1/J4/J8/J9/J5/J6, выходов кабелей, USB и M3 с головкой ≤5,5 мм без шайб. Это проектные допуски, не замеры. J5/J6 подключаются жгутами; габариты внешних силовых блоков, их расположение, держатель/прижимы и корпус машины не проверены. Статусы явно отражены в mechanical-check.json.

Linux-сборка поддерживает отсутствие DISPLAY: wx.App не создаётся, полный прогон описан в development.md. Физическая примерка, фиксация модулей, час работы помпы и USB-прошивка ещё не выполнялись. Зелёные проверки файлов не заменяют этих испытаний.
## Compact Shield 0.3.1

Плата 76×61 мм, два слоя, 0805/1206 HandSolder и SOIC 1,27 мм. Минимум сигнальной дорожки 0,20 мм, питания 0,30 мм; зазор обычных сигналов 0,25 мм, питания/USB/заливок 0,30 мм, локальное правило зазора от 0,21 мм (>8 mil), между площадками USB от 0,22 мм. Внутренних плоскостей нет; GND залит на F.Cu/B.Cu. USB-C — HRO TYPE-C-31-M-12.

Текущие машинные доказательства: свежие all-severity ERC/DRC, связность и parity; независимая геометрия и карта GPIO; контрольные суммы воспроизводимой генерации и CAM. Они находятся в [reports](../hardware/shield-compact/reports/) и [manifest](../hardware/shield-compact/manufacturing/manifest.json). Матрица сравнений размеров сохранена в layout-search.json. Сборки прошивки предыдущей ревизии не считаются аппаратным испытанием этой платы.

Схема и 106 позиций сохранены относительно 1b20d58, кроме физического типа USB-C. ID=4, GPIO Alba 43/44, карта памяти 8 MB при физических N16R8 сохраняются. Независимая проверка обоих профилей выполняется tools/test_controller_profiles.py.

**В железе не собран, не прошит и в машине не проверен.** Реальные ADS1115, MAX31855, CJMCU-0102 и корпус ещё не измерены. См. [описание](compact-shield.md), [совместимость](compatibility.md), [комплект прототипа](../hardware/shield-compact/manufacturing/).

Для текущей compact проверяется фиксированная локальная библиотека `.pretty` до и после сборки; порядок расширения дорожек не зависит от UUID. Добавлено 20 переходов GND (всего 34), трассы сигналов сохранены. Покрытие USB противоположной заливкой осталось 46–48%, для USB_DM_MCU 0%; DRC не подтверждает качество USB или работу интерфейса. Сравнение: [ground-baseline.json](../hardware/shield-compact/reports/ground-baseline.json), [ground-integrity.json](../hardware/shield-compact/reports/ground-integrity.json). Чистые пересборки: [reproducibility.json](../hardware/shield-compact/reports/reproducibility.json).
