rico-x/GemilaiMate/hardware/shield-compact/previews/assembly-1to1.pdf

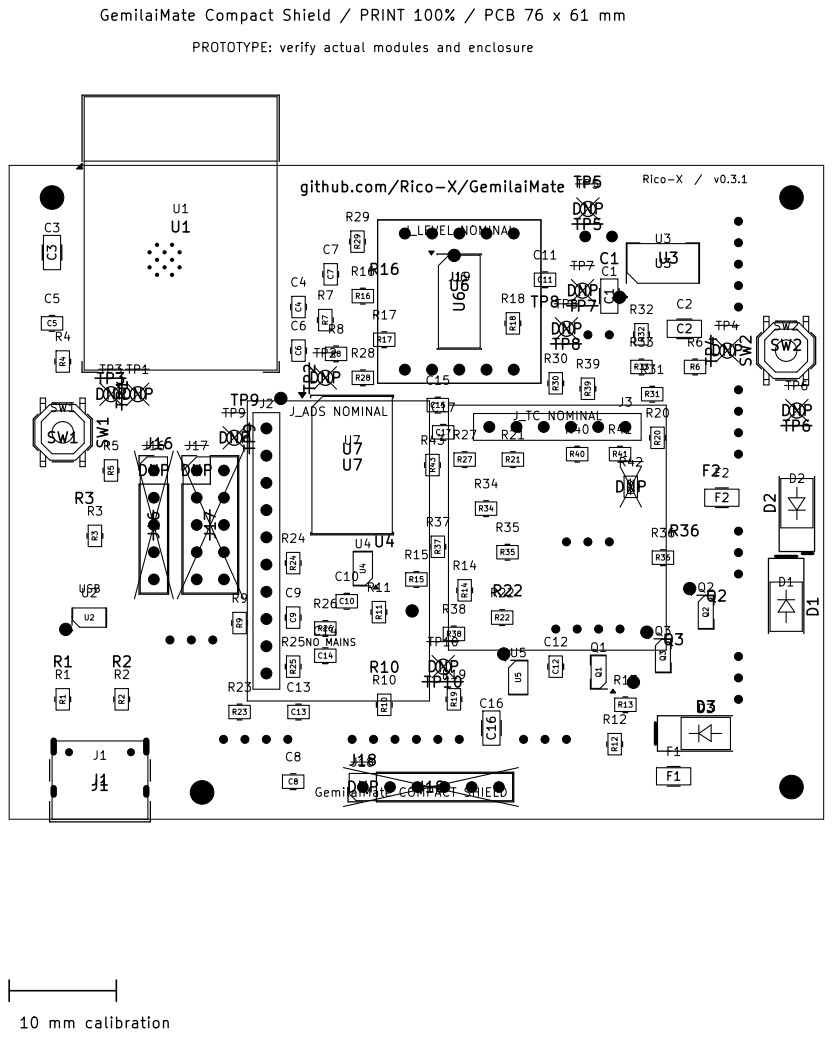
[picture p21: page 1]

J_TC NOMINAL PROTOTYPE: verify actual modules and enclosure 10 mm calibration

Rico-X / v0.3.1 GemilaiMate COMPACT SHIELD DNPDNP
