rico-x/GemilaiMate/hardware/shield-compact/previews/assembly-bottom-1to1.pdf

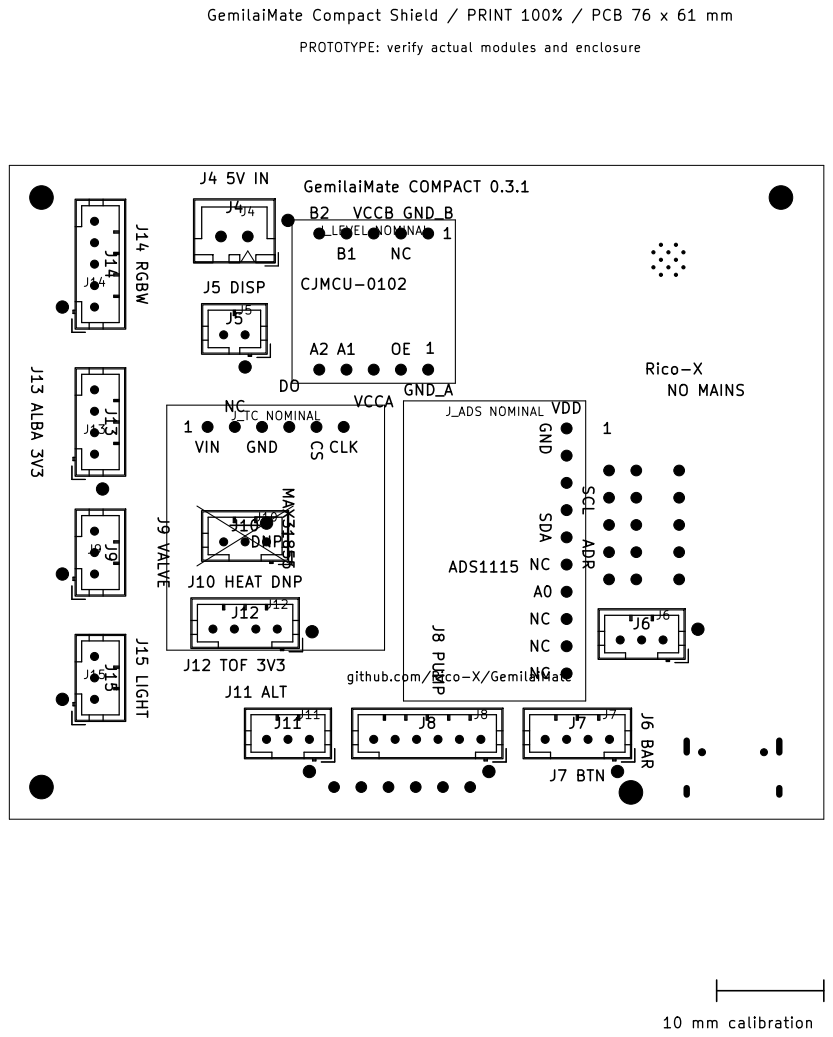
[picture p22: page 1]

GemilaiMate Compact Shield / PRINT 100% / PCB 76 x 61 mm

github.com/Rico-X/GemilaiMate DNP
