rico-x/GemilaiMate/(list of files, drawings)

Other design files:
hardware/carrier/schematic-pad-nets.json
hardware/shield-compact/reports/unrouted-native.dsn
hardware/shield-compact/reports/unrouted.dsn
hardware/shield-compact/schematic-paths.json
hardware/shield/schematic-pad-nets.json
