rico-x/GemilaiMate/hardware/shield-compact/gemilaimate-compact.kicad_pcb

## KiCad design hardware/shield-compact/gemilaimate-compact.kicad_pcb (2026-11-04)

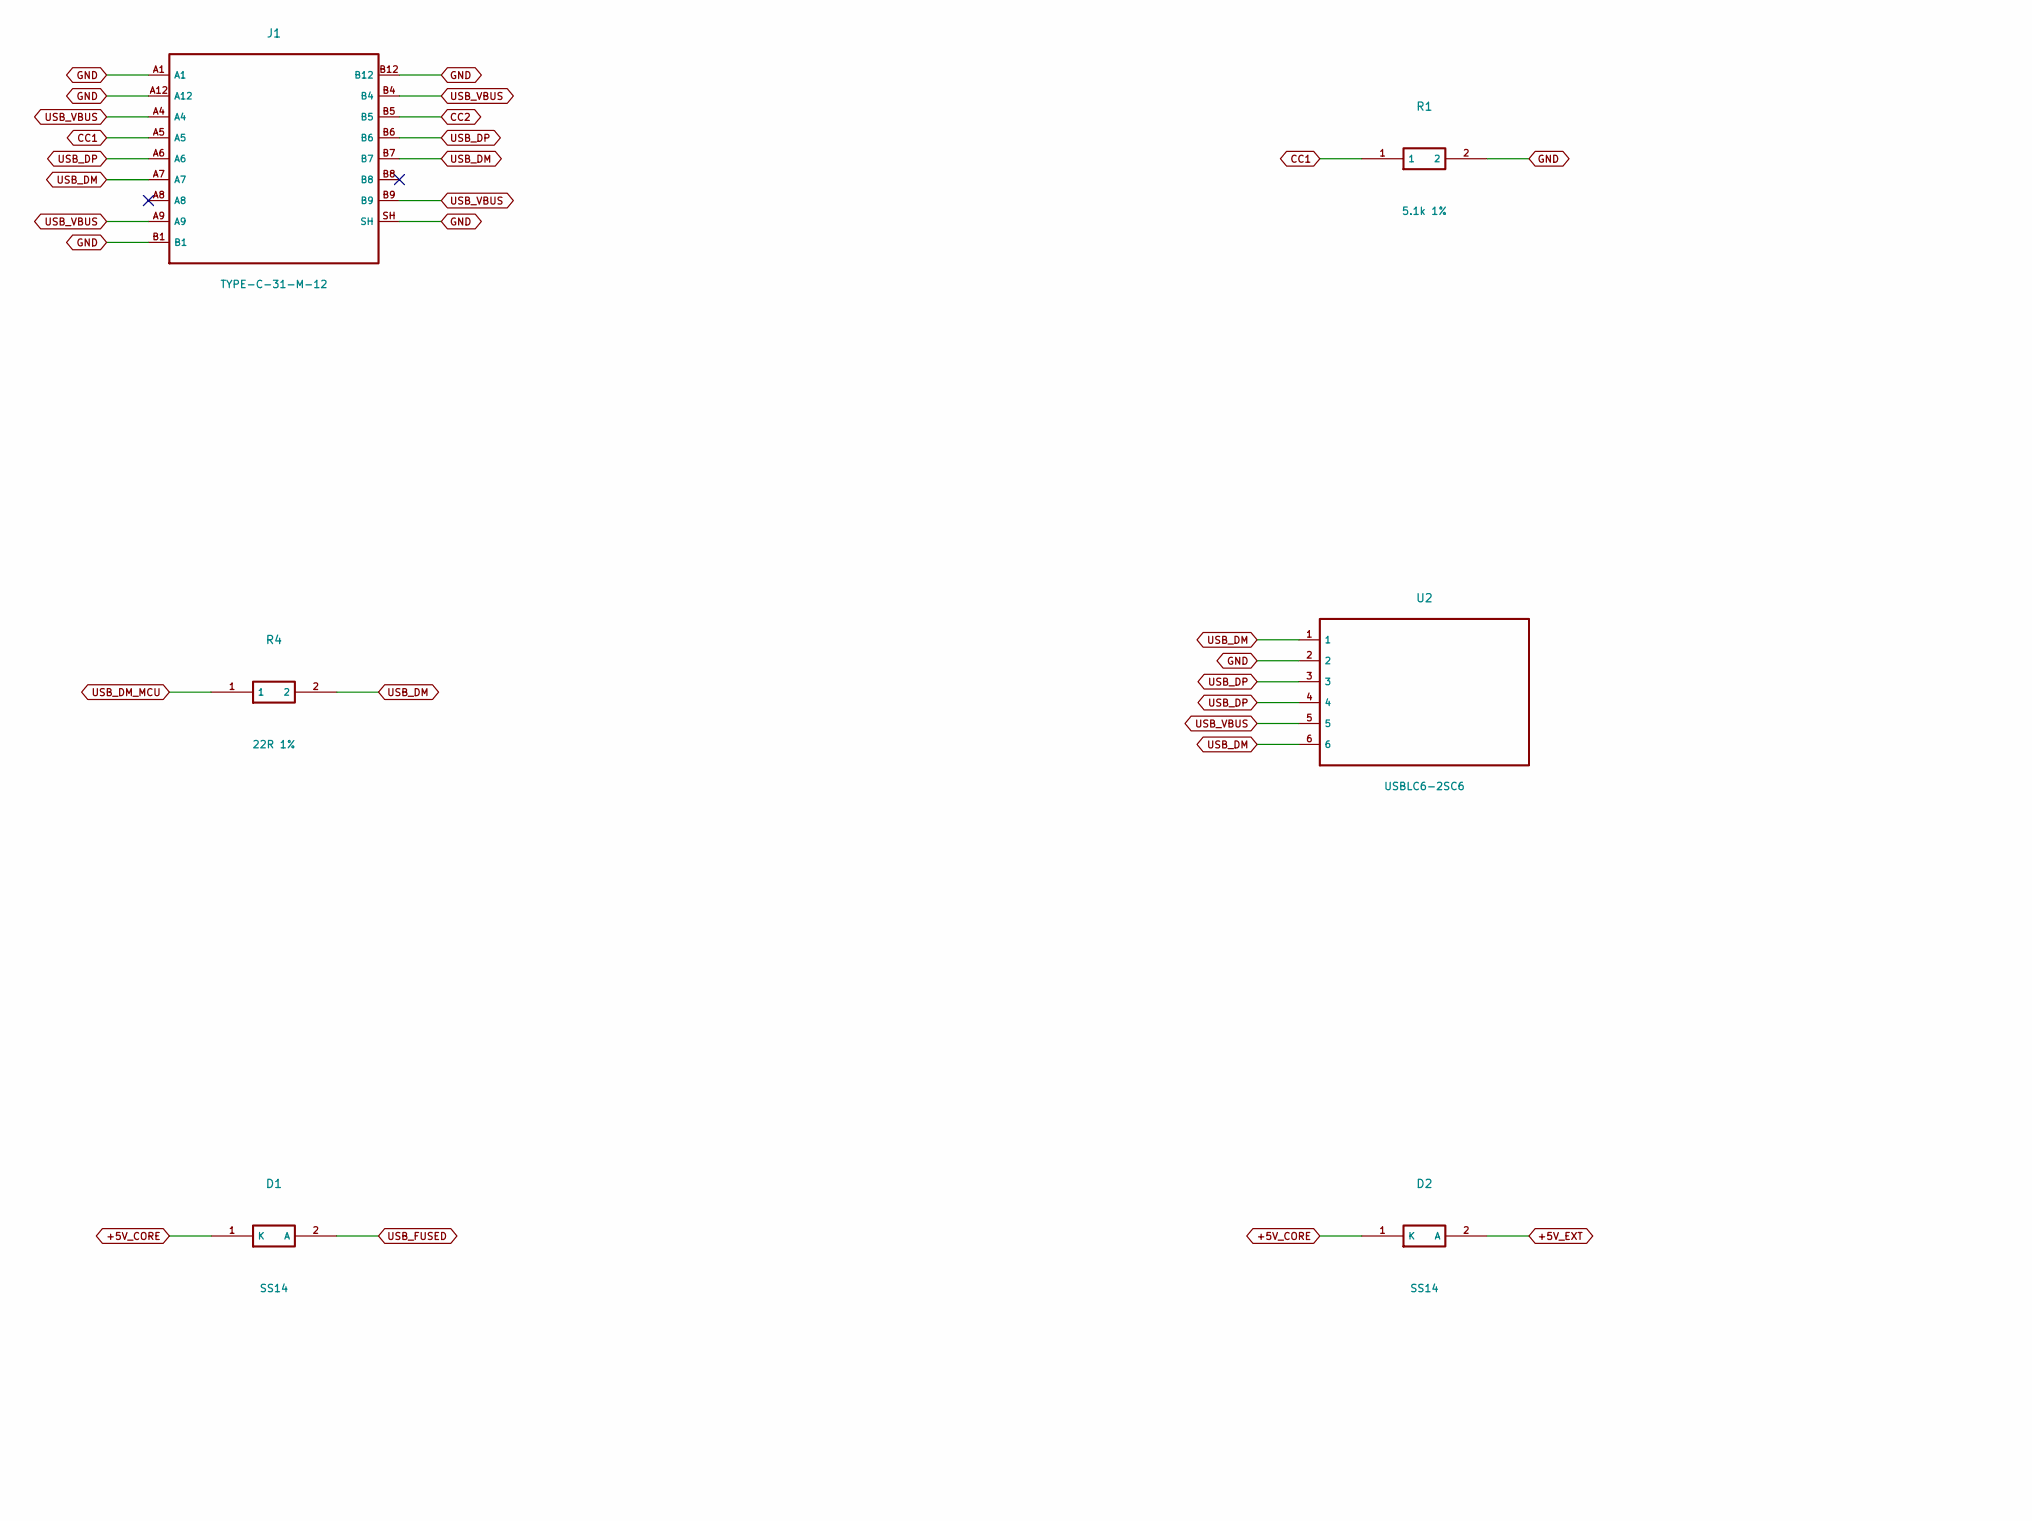
[picture p23: schematic power-usb.kicad_sch, USB-C and protected core power, part in row 1, column 1]

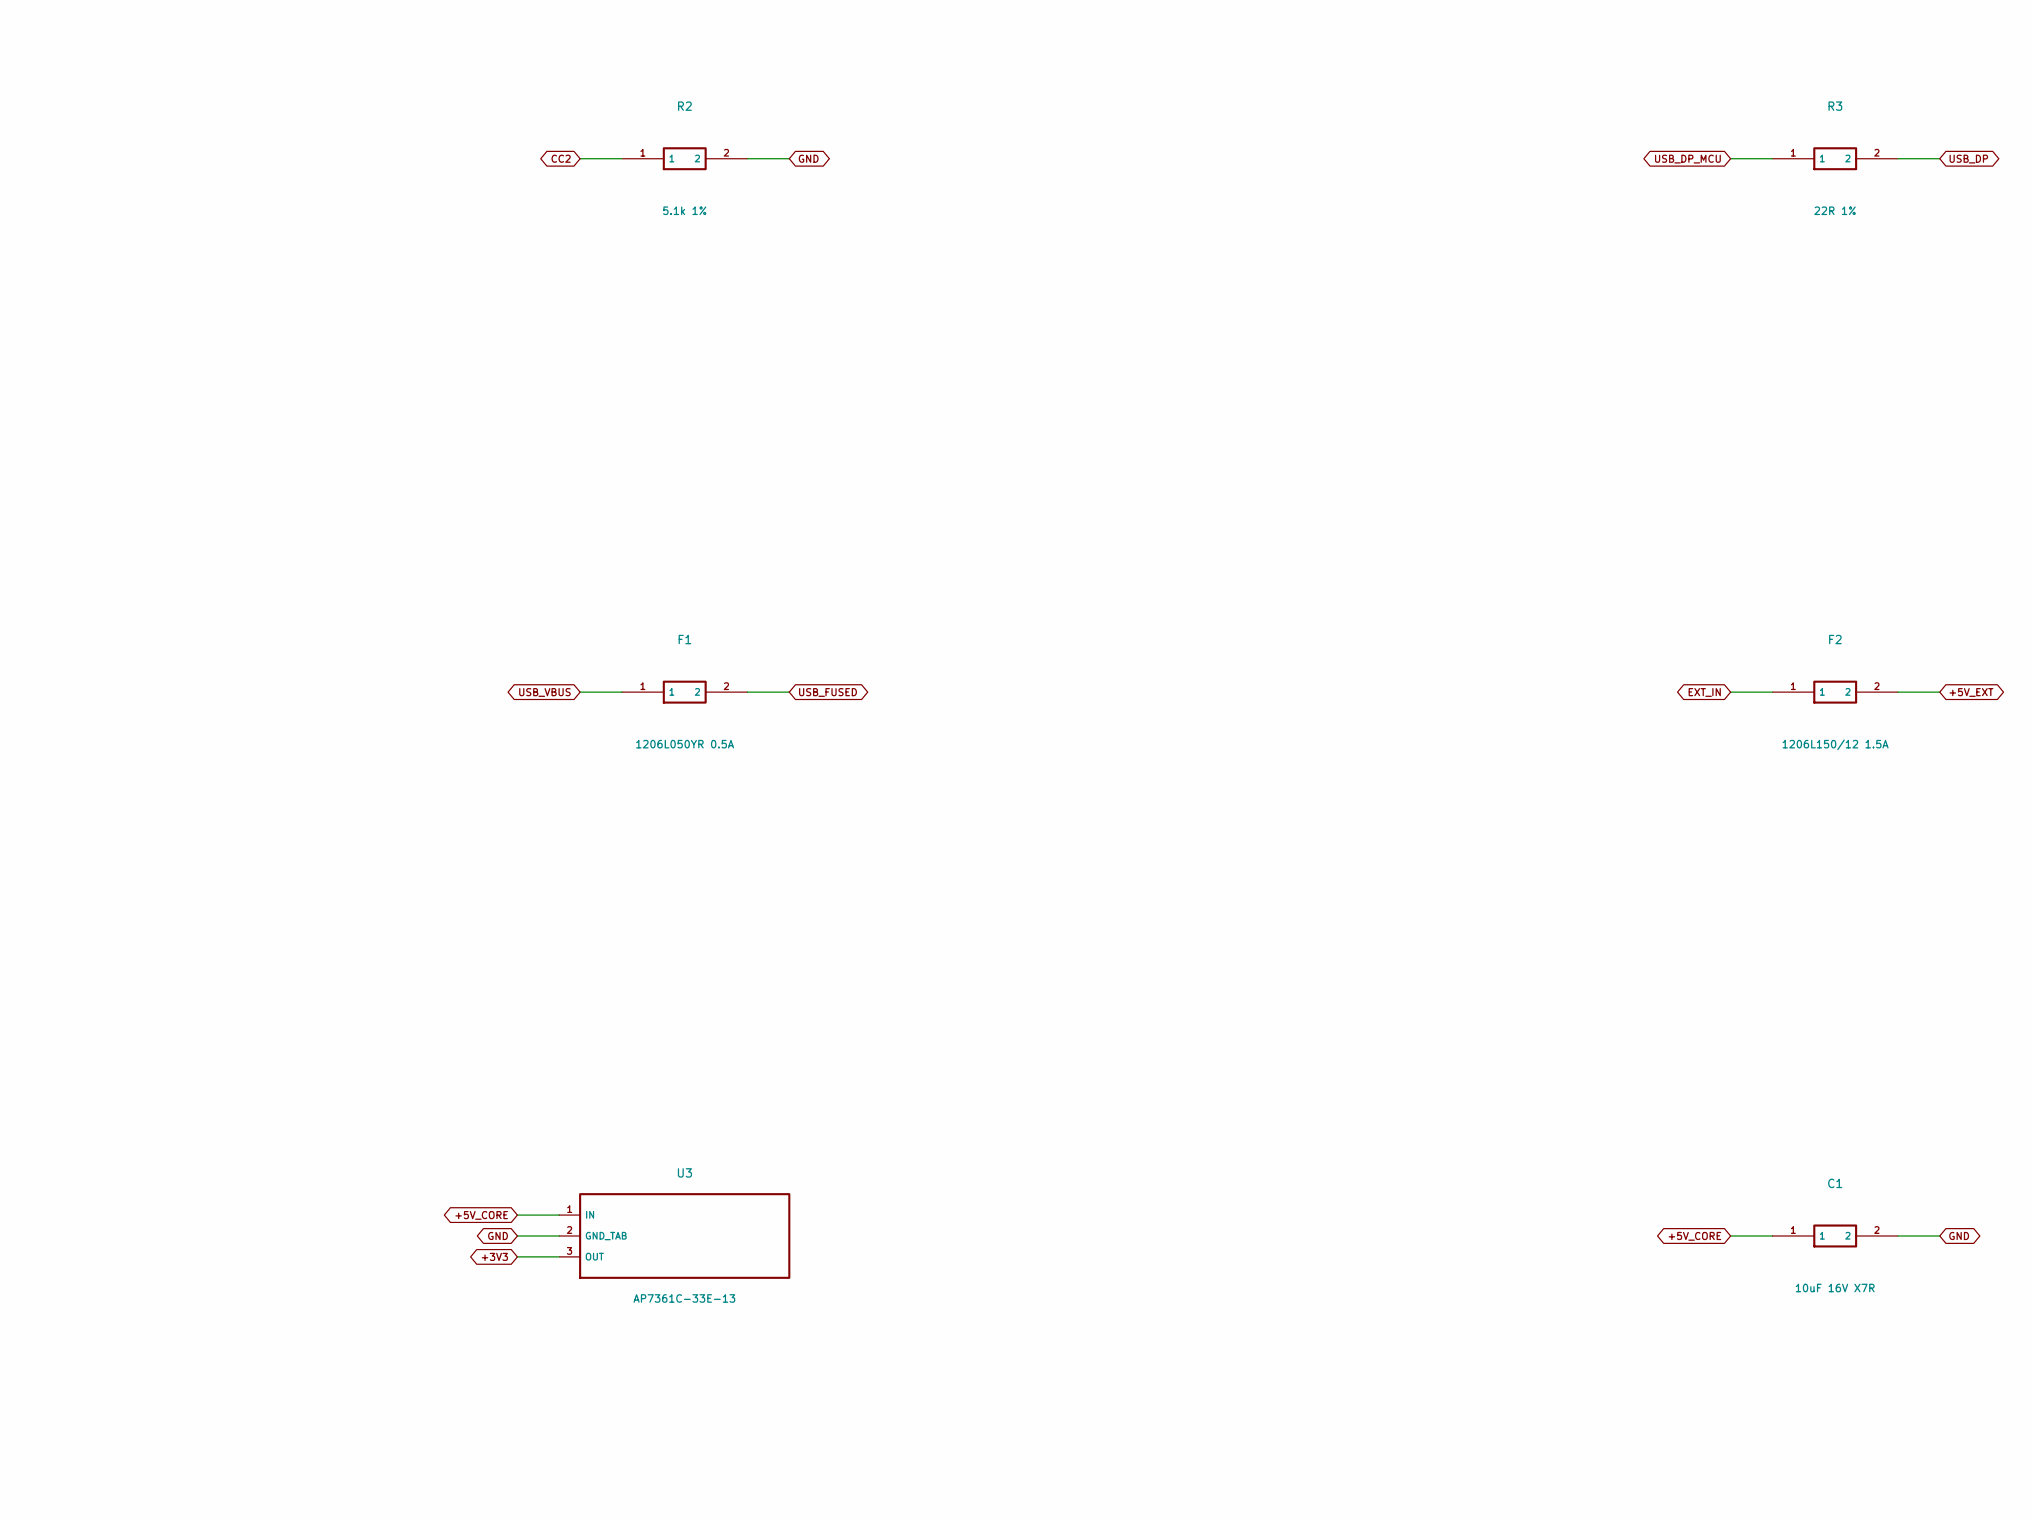
[picture p24: schematic power-usb.kicad_sch, USB-C and protected core power, part in row 1, column 2]

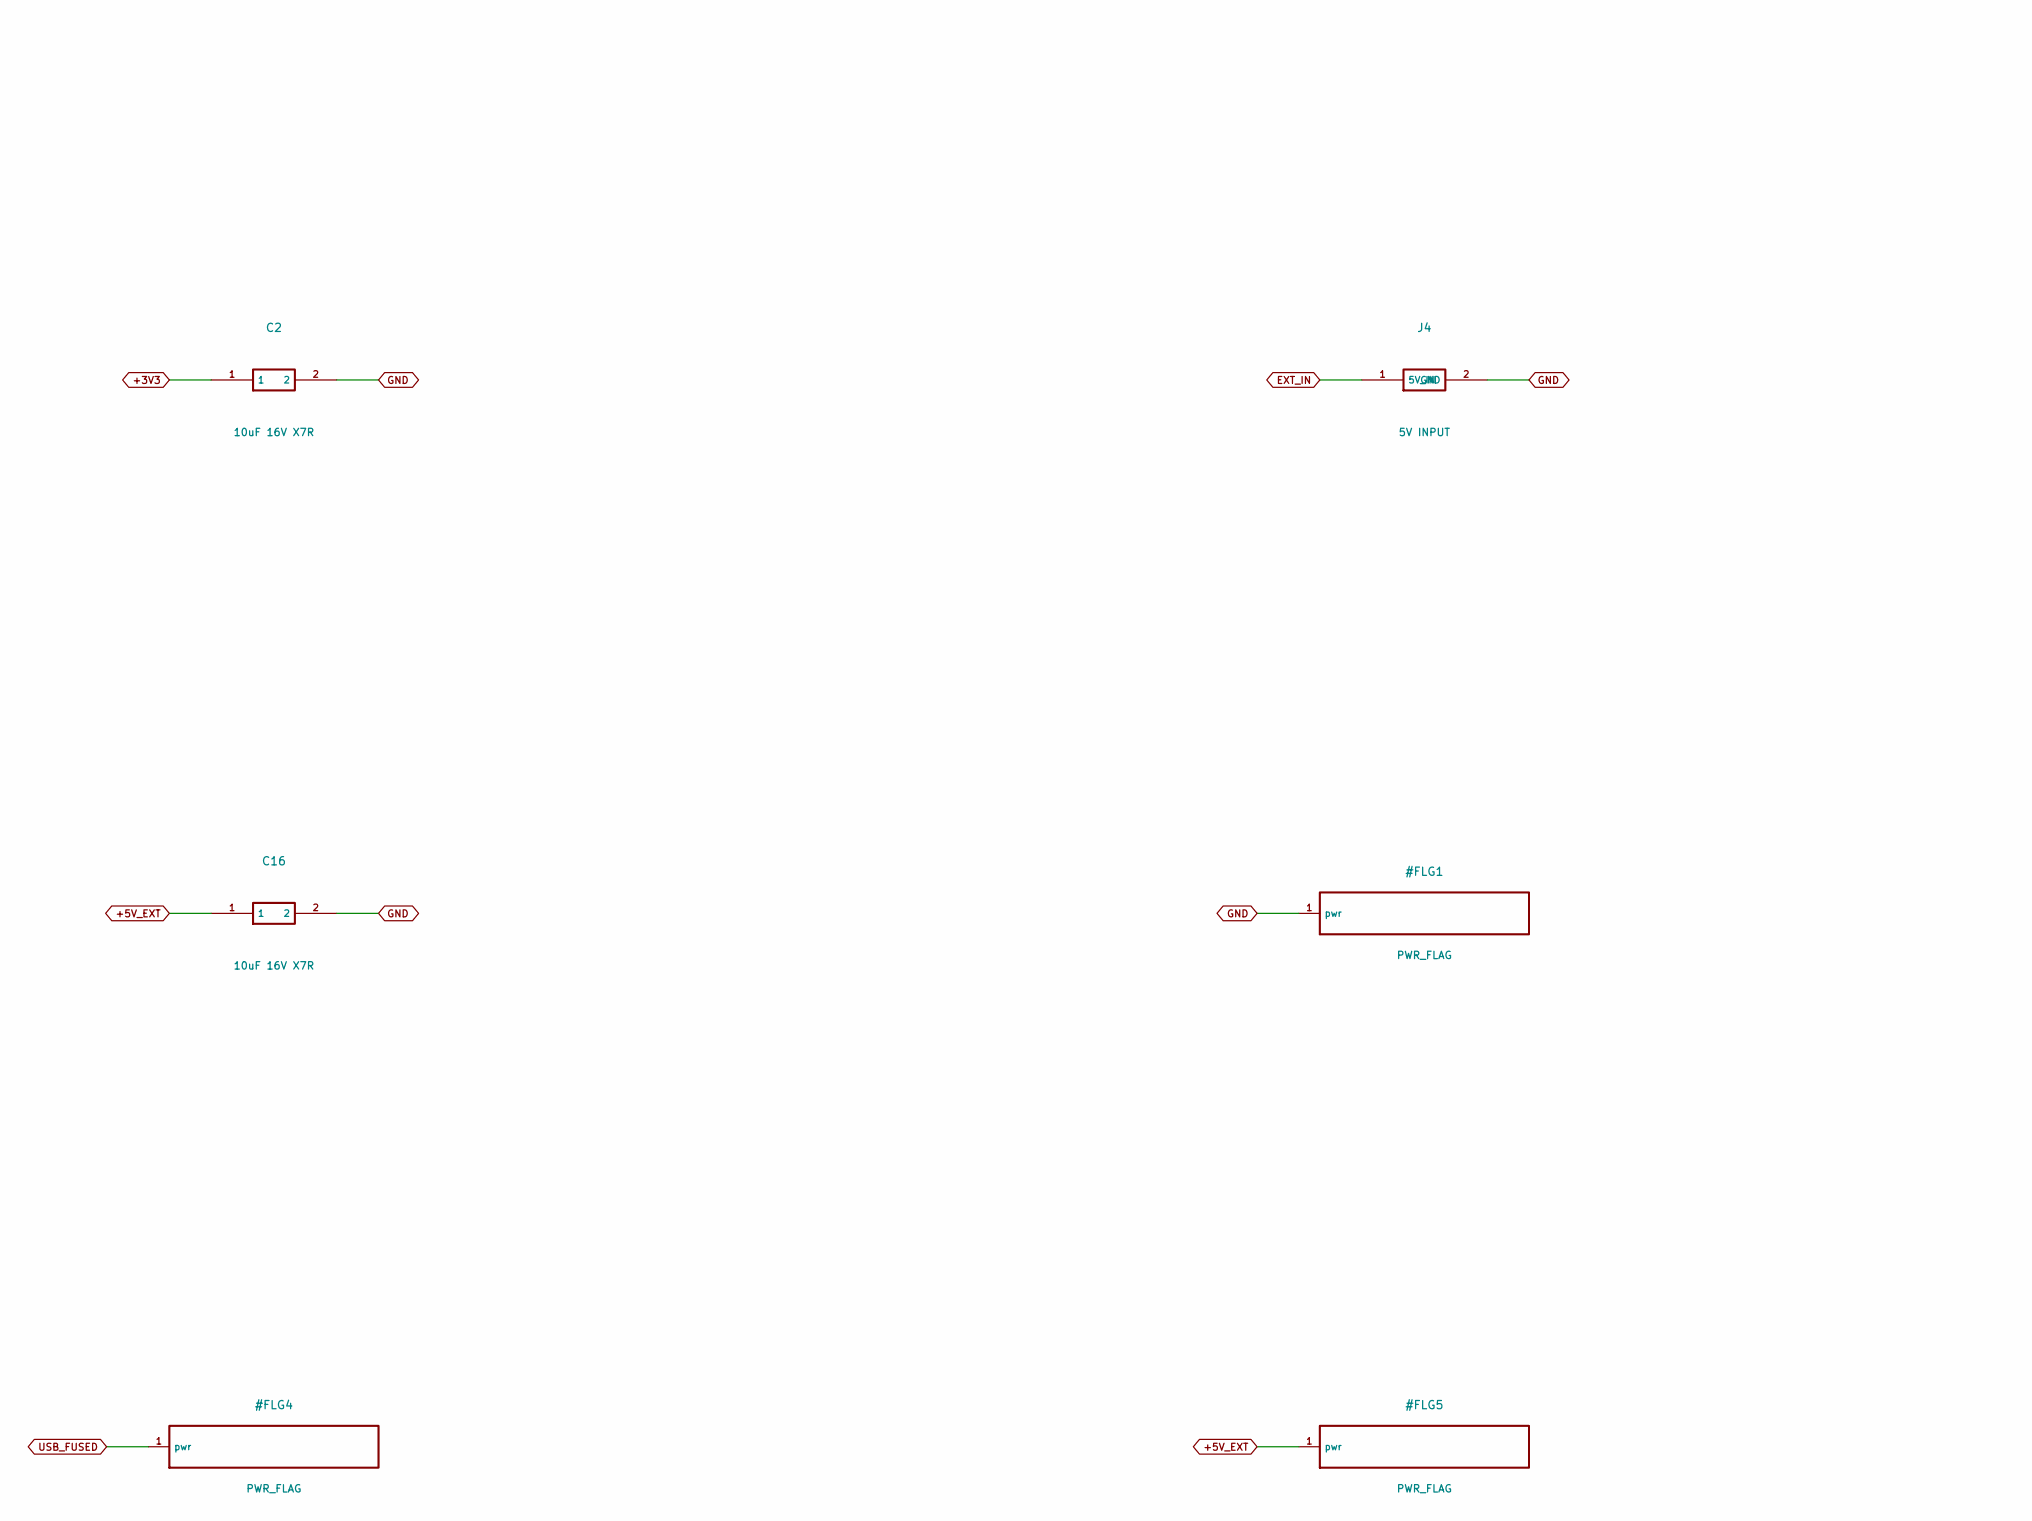
[picture p25: schematic power-usb.kicad_sch, USB-C and protected core power, part in row 2, column 1]

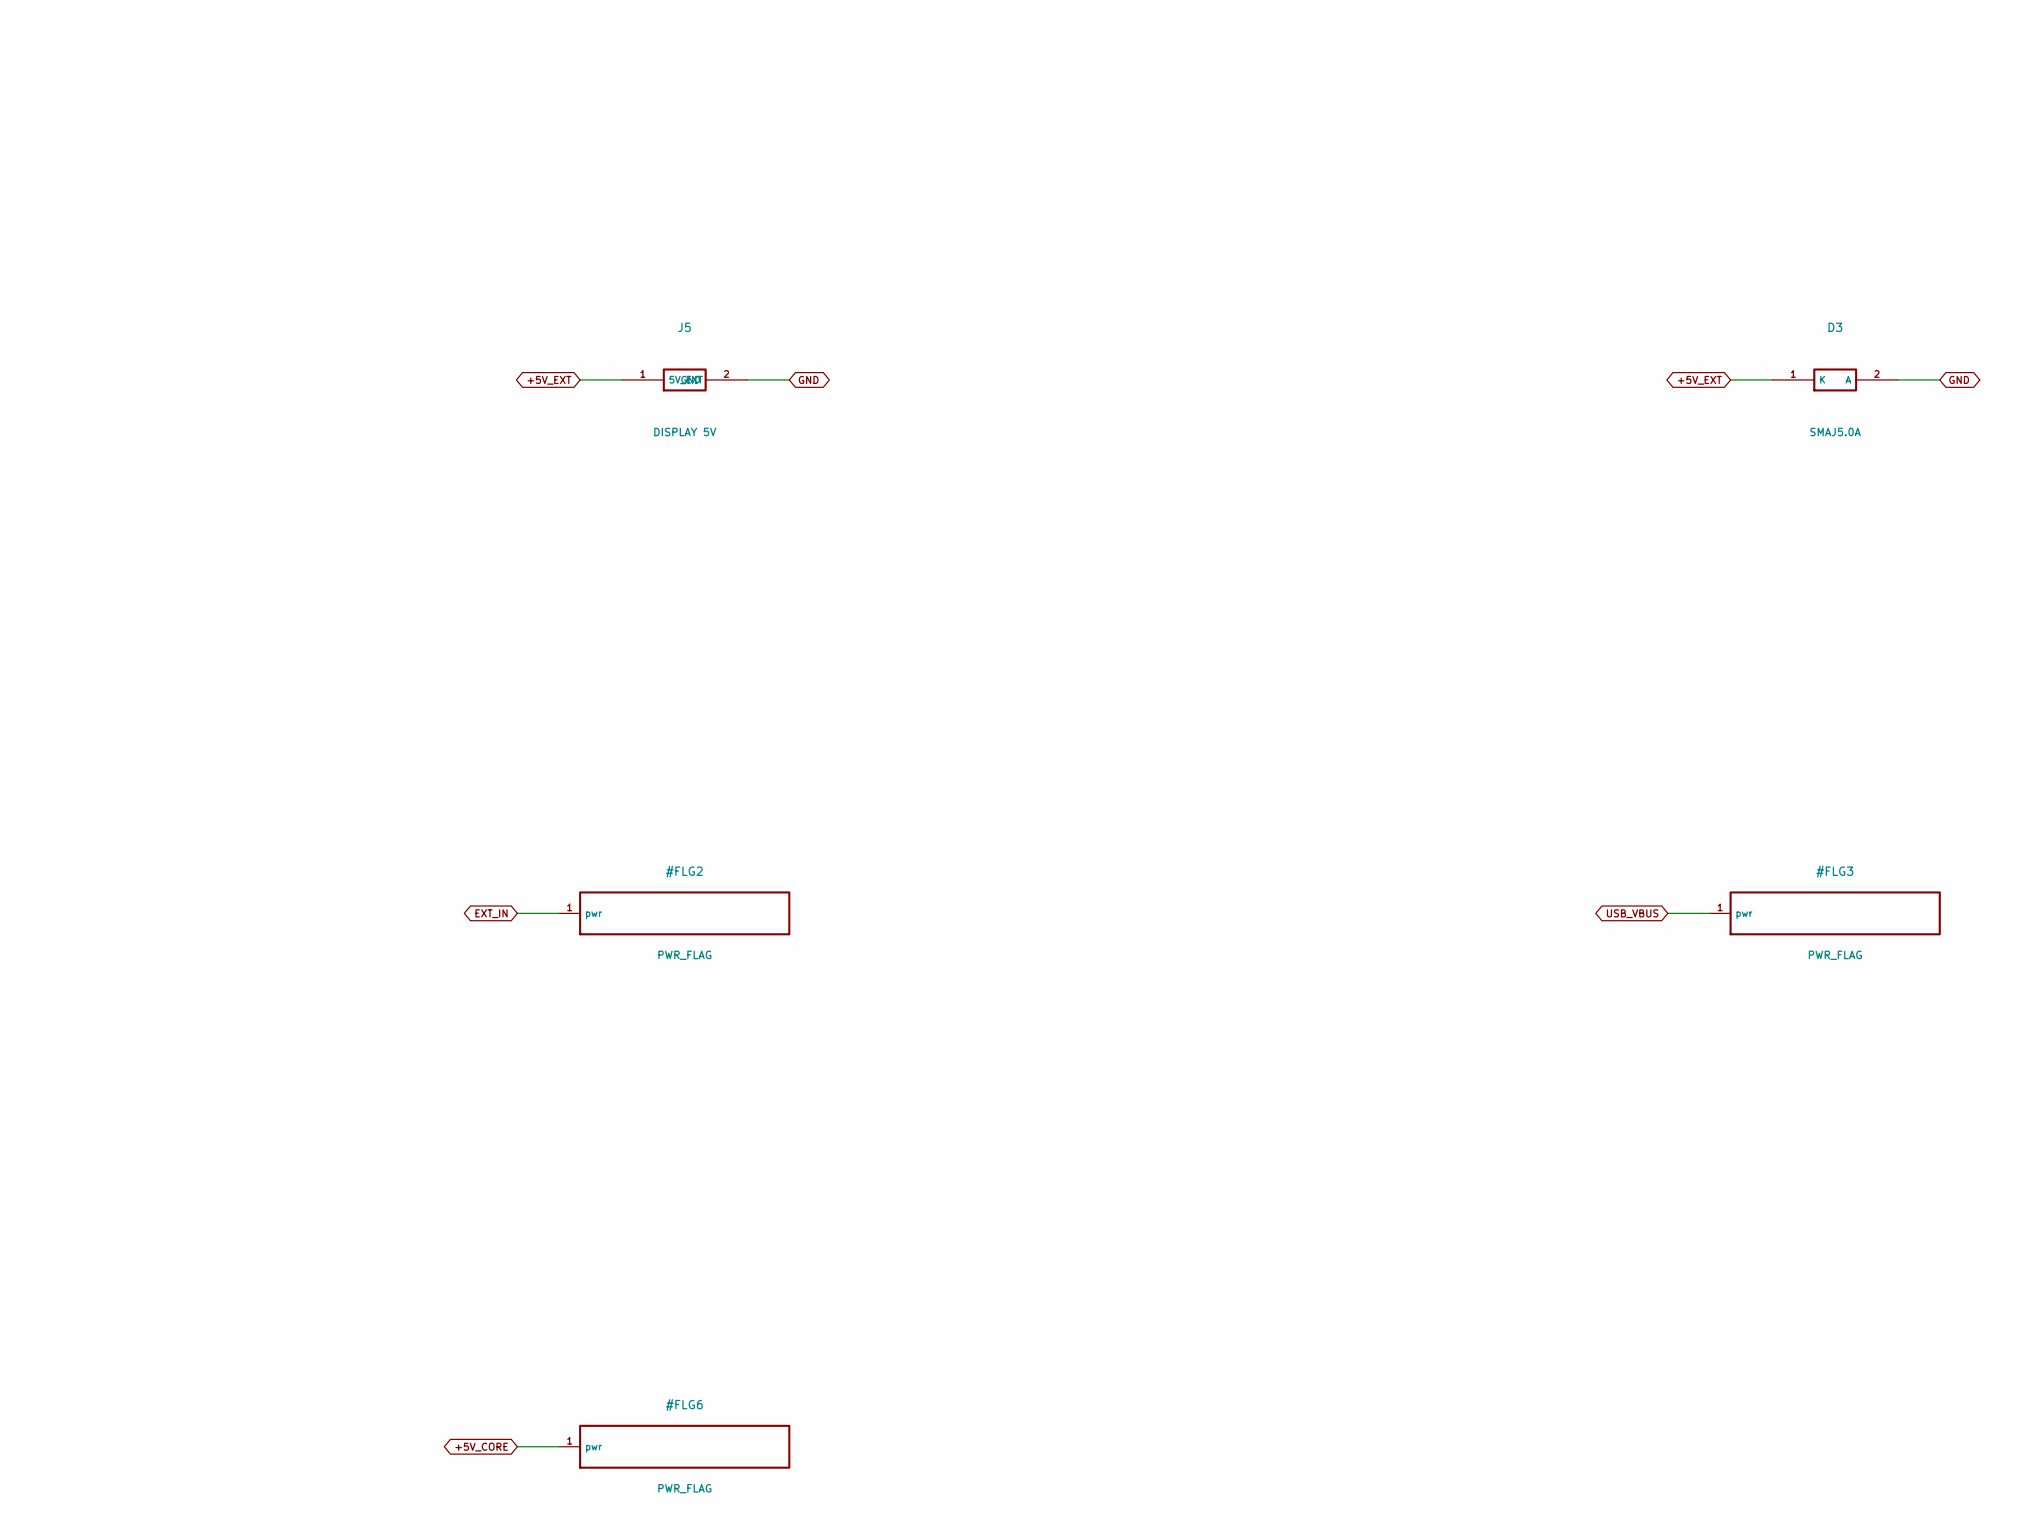
[picture p26: schematic power-usb.kicad_sch, USB-C and protected core power, part in row 2, column 2]

Parts:
C1, C2, C16: 10uF 16V X7R; C_1206_3216Metric_Pad1.33x1.80mm_HandSolder
D1, D2: SS14; D_SMA_Handsoldering
D3: SMAJ5.0A; D_SMA_Handsoldering
F1: 1206L050YR 0.5A; Fuse_1206_3216Metric_Pad1.42x1.75mm_HandSolder
F2: 1206L150/12 1.5A; Fuse_1206_3216Metric_Pad1.42x1.75mm_HandSolder
J1: TYPE-C-31-M-12; USB_C_Receptacle_HRO_TYPE-C-31-M-12
J4: 5V INPUT; JST_XH_B2B-XH-A_1x02_P2.50mm_Vertical
J5: DISPLAY 5V; JST_PH_B2B-PH-K_1x02_P2.00mm_Vertical
R1, R2: 5.1k 1%; R_0805_2012Metric_Pad1.20x1.40mm_HandSolder
R3, R4: 22R 1%; R_0805_2012Metric_Pad1.20x1.40mm_HandSolder
U2: USBLC6-2SC6; SOT-23-6_Handsoldering
U3: AP7361C-33E-13; SOT-223-3_TabPin2

Connections:
+3V3: C2.1, U3.3 (OUT); also elsewhere on the board
+5V_CORE: C1.1, D1.1 (K), D2.1 (K), U3.1 (IN); also elsewhere on the board
+5V_EXT: C16.1, D2.2 (A), D3.1 (K), F2.2, J5.1 (5V_EXT); also elsewhere on the board
CC1: J1.A5, R1.1
CC2: J1.B5, R2.1
EXT_IN: F2.1, J4.1 (5V_IN)
GND: C1.2, C2.2, C16.2, D3.2 (A), J1.A1, J1.A12, J1.B1, J1.B12, J1.SH, J4.2 (GND), J5.2 (GND), R1.2, R2.2, U2.2, U3.2 (GND_TAB); also elsewhere on the board
USB_DM: J1.A7, J1.B7, R4.2, U2.1, U2.6
USB_DM_MCU: R4.1; also elsewhere on the board
USB_DP: J1.A6, J1.B6, R3.2, U2.3, U2.4
USB_DP_MCU: R3.1; also elsewhere on the board
USB_FUSED: D1.2 (A), F1.2
USB_VBUS: F1.1, J1.A4, J1.A9, J1.B4, J1.B9, U2.5

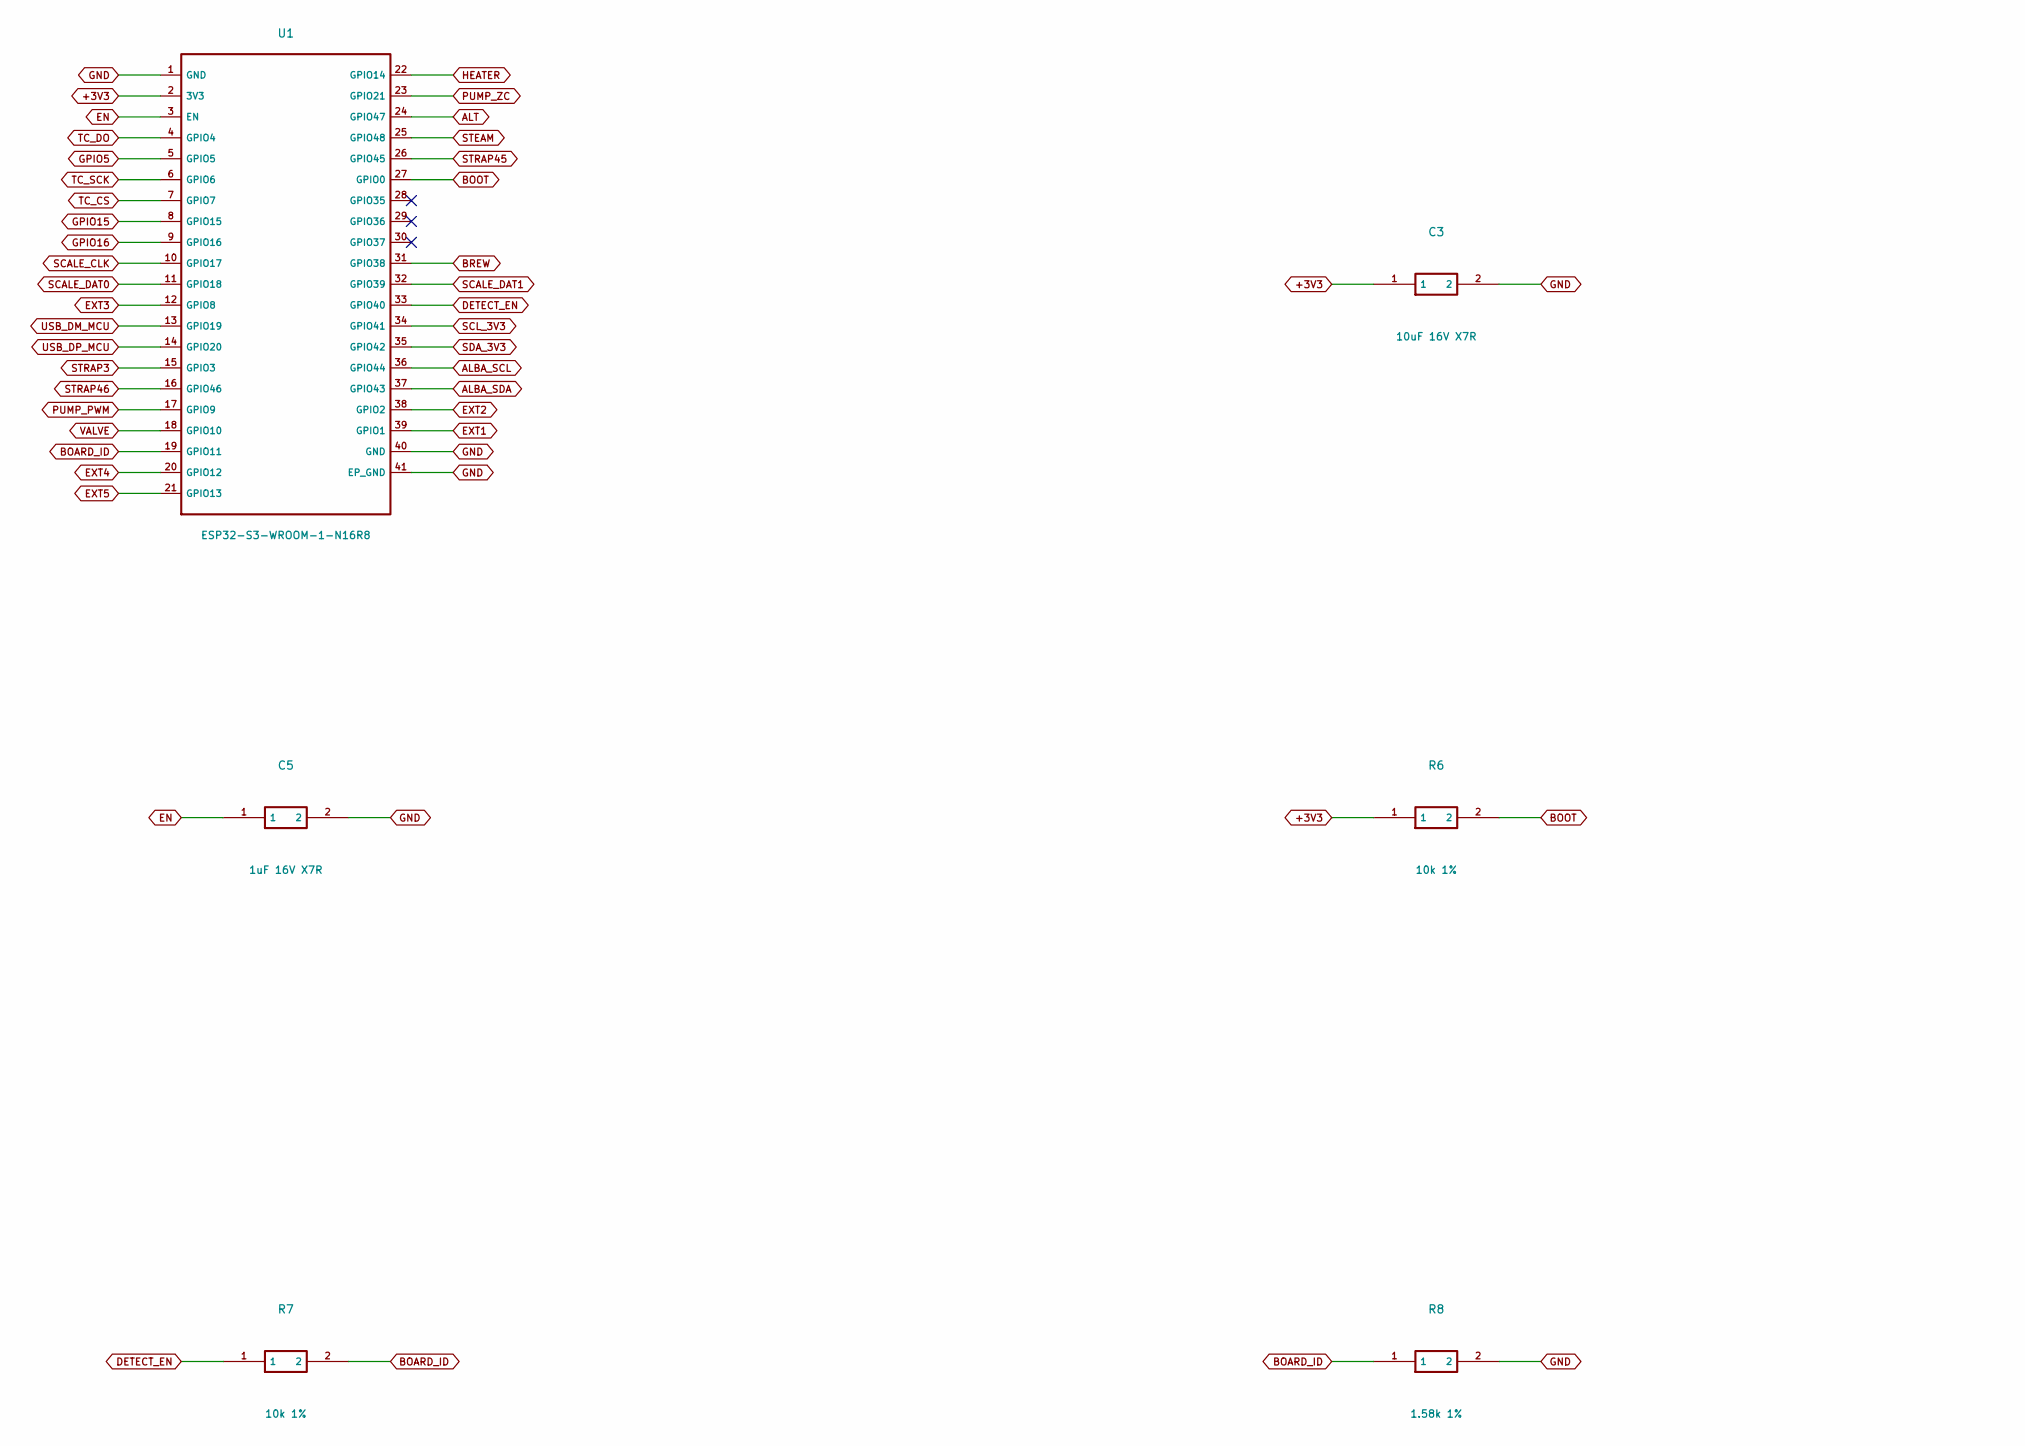
[picture p27: schematic mcu.kicad_sch, ESP32-S3 and ID=4 / Boot, part in row 1, column 1]

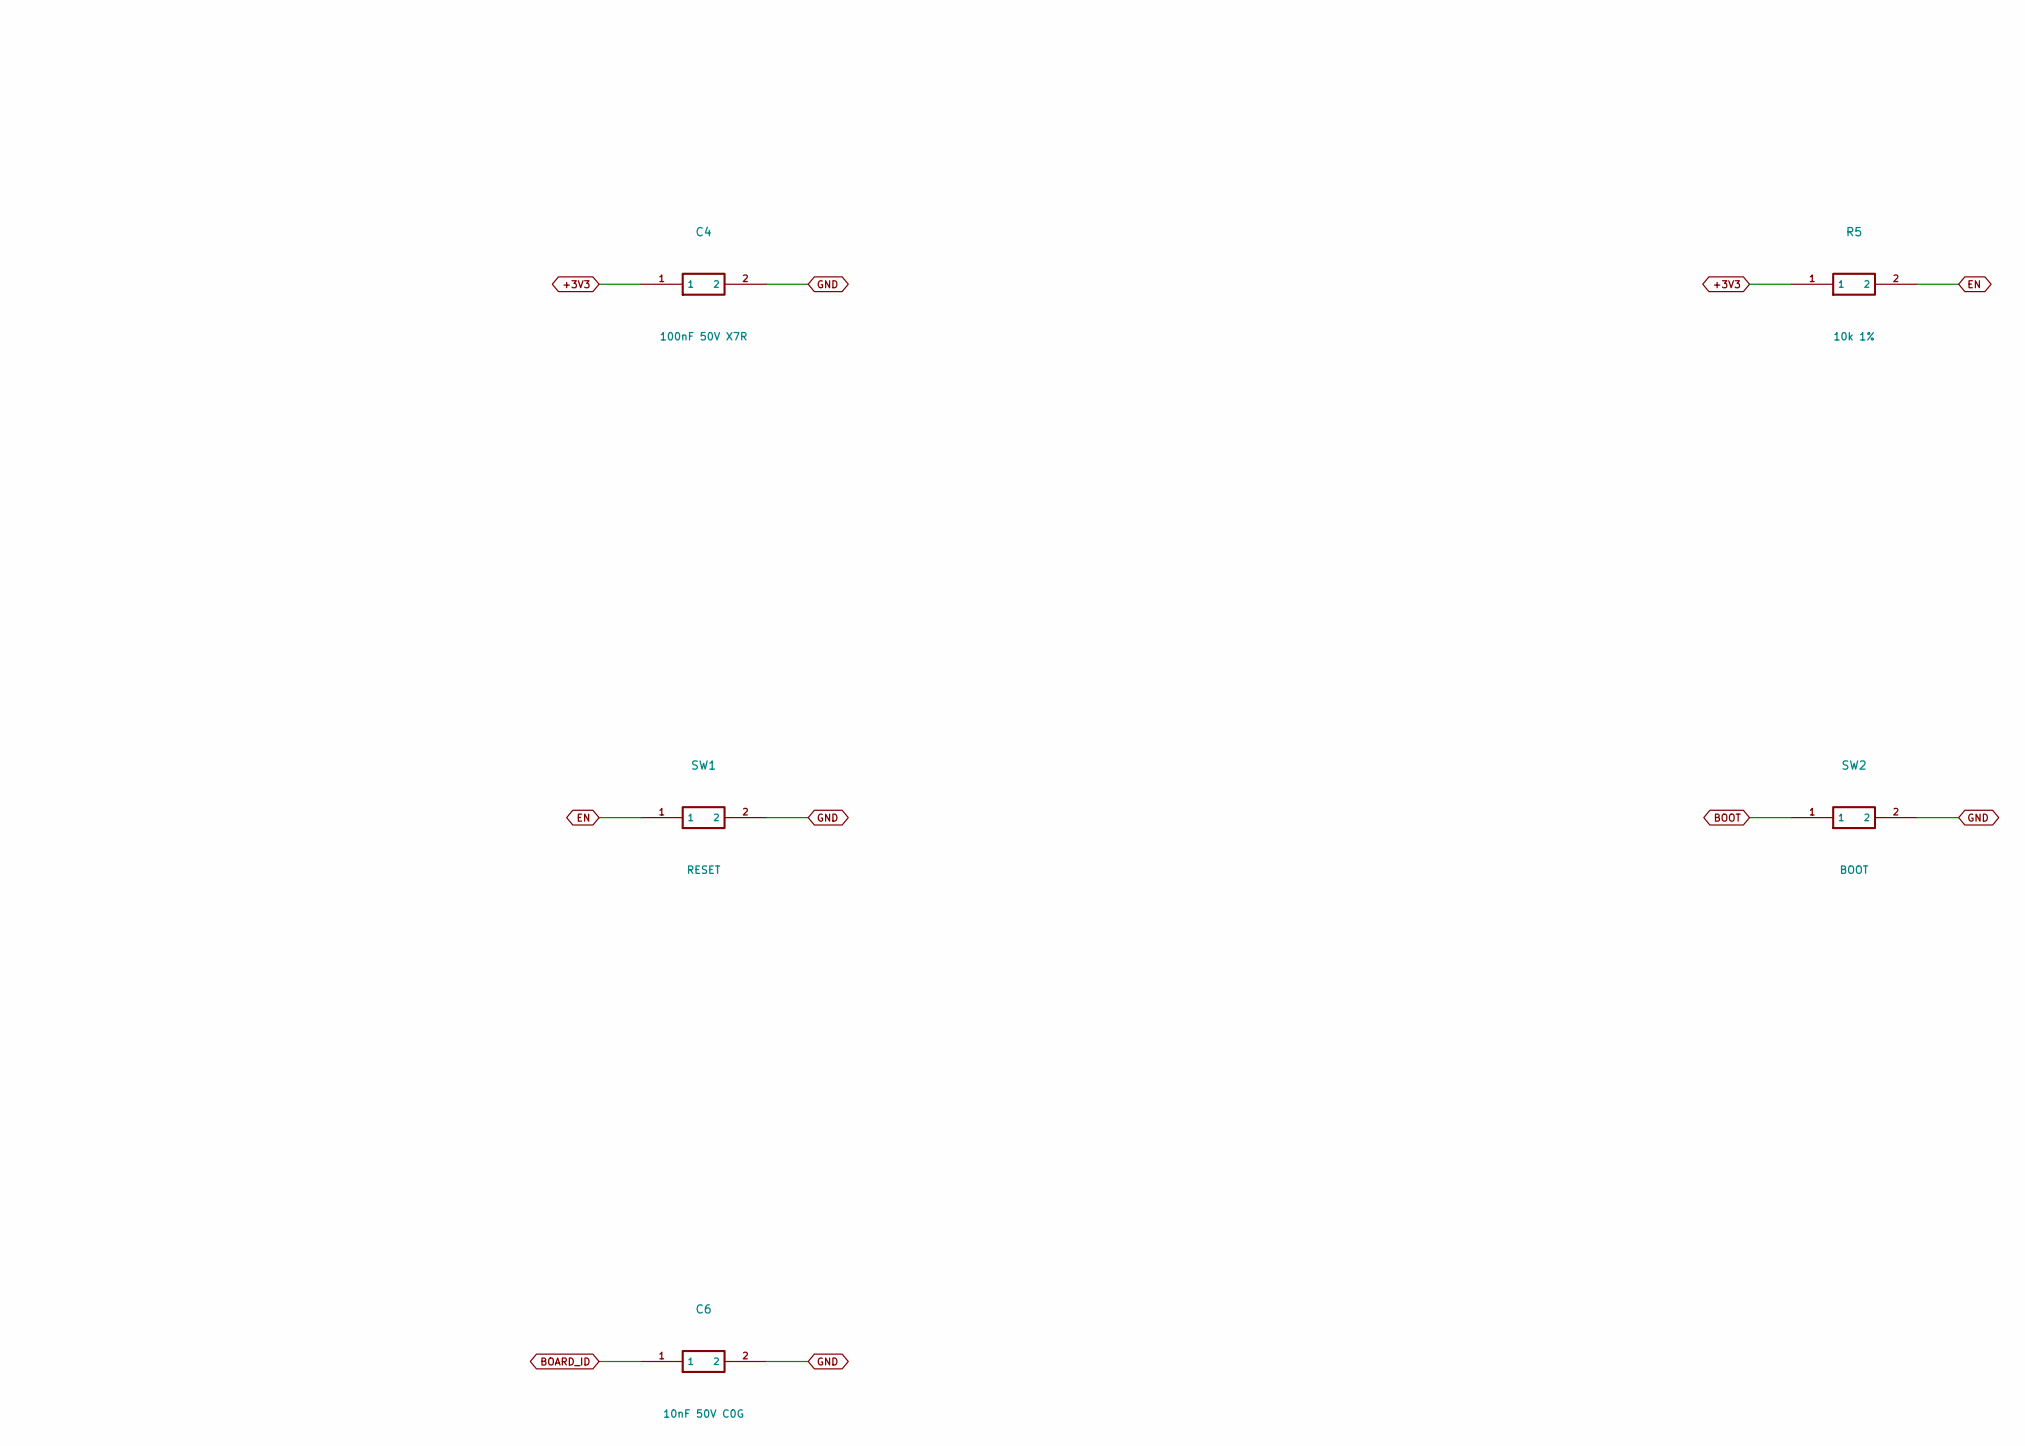
[picture p28: schematic mcu.kicad_sch, ESP32-S3 and ID=4 / Boot, part in row 1, column 2]

Parts:
C3: 10uF 16V X7R; C_1206_3216Metric_Pad1.33x1.80mm_HandSolder
C4: 100nF 50V X7R; C_0805_2012Metric_Pad1.18x1.45mm_HandSolder
C5: 1uF 16V X7R; C_0805_2012Metric_Pad1.18x1.45mm_HandSolder
C6: 10nF 50V C0G; C_0805_2012Metric_Pad1.18x1.45mm_HandSolder
R5, R6, R7: 10k 1%; R_0805_2012Metric_Pad1.20x1.40mm_HandSolder
R8: 1.58k 1%; R_0805_2012Metric_Pad1.20x1.40mm_HandSolder
SW1: RESET; SW_SPST_TL3342
SW2: BOOT; SW_SPST_TL3342
U1: ESP32-S3-WROOM-1-N16R8; ESP32-S3-WROOM-1

Connections:
+3V3: C3.1, C4.1, R5.1, R6.1, U1.2 (3V3); also elsewhere on the board
ALBA_SCL: U1.36 (GPIO44); also elsewhere on the board
ALBA_SDA: U1.37 (GPIO43); also elsewhere on the board
ALT: U1.24 (GPIO47); also elsewhere on the board
BOARD_ID: C6.1, R7.2, R8.1, U1.19 (GPIO11)
BOOT: R6.2, SW2.1, U1.27 (GPIO0); also elsewhere on the board
BREW: U1.31 (GPIO38); also elsewhere on the board
DETECT_EN: R7.1, U1.33 (GPIO40)
EN: C5.1, R5.2, SW1.1, U1.3 (EN)
EXT1: U1.39 (GPIO1); also elsewhere on the board
EXT2: U1.38 (GPIO2); also elsewhere on the board
EXT3: U1.12 (GPIO8); also elsewhere on the board
EXT4: U1.20 (GPIO12); also elsewhere on the board
EXT5: U1.21 (GPIO13); also elsewhere on the board
GND: C3.2, C4.2, C5.2, C6.2, R8.2, SW1.2, SW2.2, U1.1 (GND), U1.40 (GND), U1.41 (EP_GND); also elsewhere on the board
GPIO5: U1.5 (GPIO5); also elsewhere on the board
GPIO15: U1.8 (GPIO15); also elsewhere on the board
GPIO16: U1.9 (GPIO16); also elsewhere on the board
HEATER: U1.22 (GPIO14); also elsewhere on the board
PUMP_PWM: U1.17 (GPIO9); also elsewhere on the board
PUMP_ZC: U1.23 (GPIO21); also elsewhere on the board
SCALE_CLK: U1.10 (GPIO17); also elsewhere on the board
SCALE_DAT0: U1.11 (GPIO18); also elsewhere on the board
SCALE_DAT1: U1.32 (GPIO39); also elsewhere on the board
SCL_3V3: U1.34 (GPIO41); also elsewhere on the board
SDA_3V3: U1.35 (GPIO42); also elsewhere on the board
STEAM: U1.25 (GPIO48); also elsewhere on the board
STRAP3: U1.15 (GPIO3); also elsewhere on the board
STRAP45: U1.26 (GPIO45); also elsewhere on the board
STRAP46: U1.16 (GPIO46); also elsewhere on the board
TC_CS: U1.7 (GPIO7); also elsewhere on the board
TC_DO: U1.4 (GPIO4); also elsewhere on the board
TC_SCK: U1.6 (GPIO6); also elsewhere on the board
USB_DM_MCU: U1.13 (GPIO19); also elsewhere on the board
USB_DP_MCU: U1.14 (GPIO20); also elsewhere on the board
VALVE: U1.18 (GPIO10); also elsewhere on the board
