rico-x/GemilaiMate/hardware/shield-compact/gemilaimate-compact.kicad_pcb

## KiCad design hardware/shield-compact/gemilaimate-compact.kicad_pcb (continued)

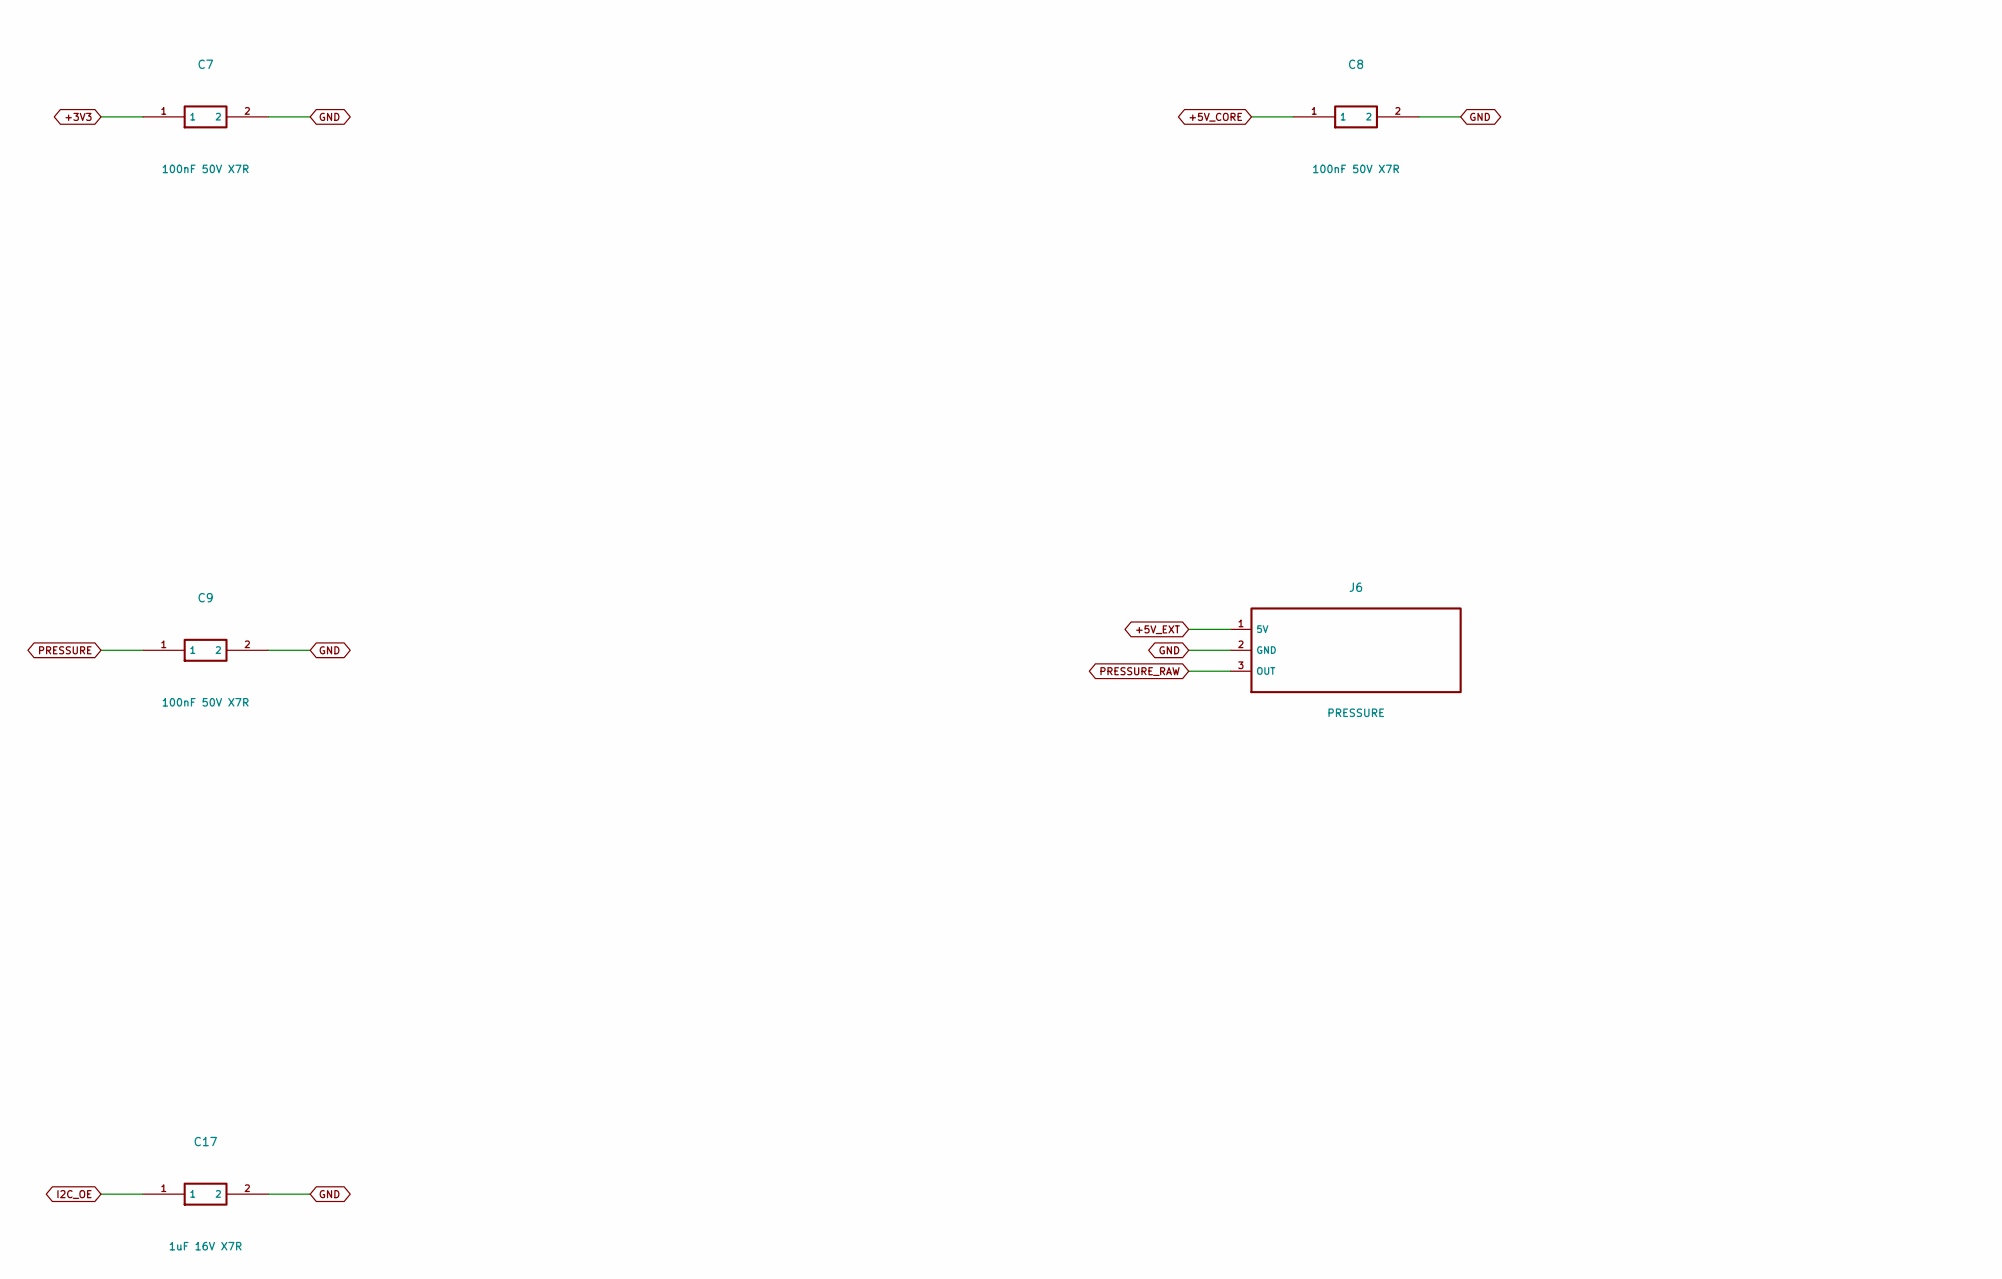
[picture p29: schematic pressure.kicad_sch, ADS1115 and 3V3/5V I2C, part in row 1, column 1]

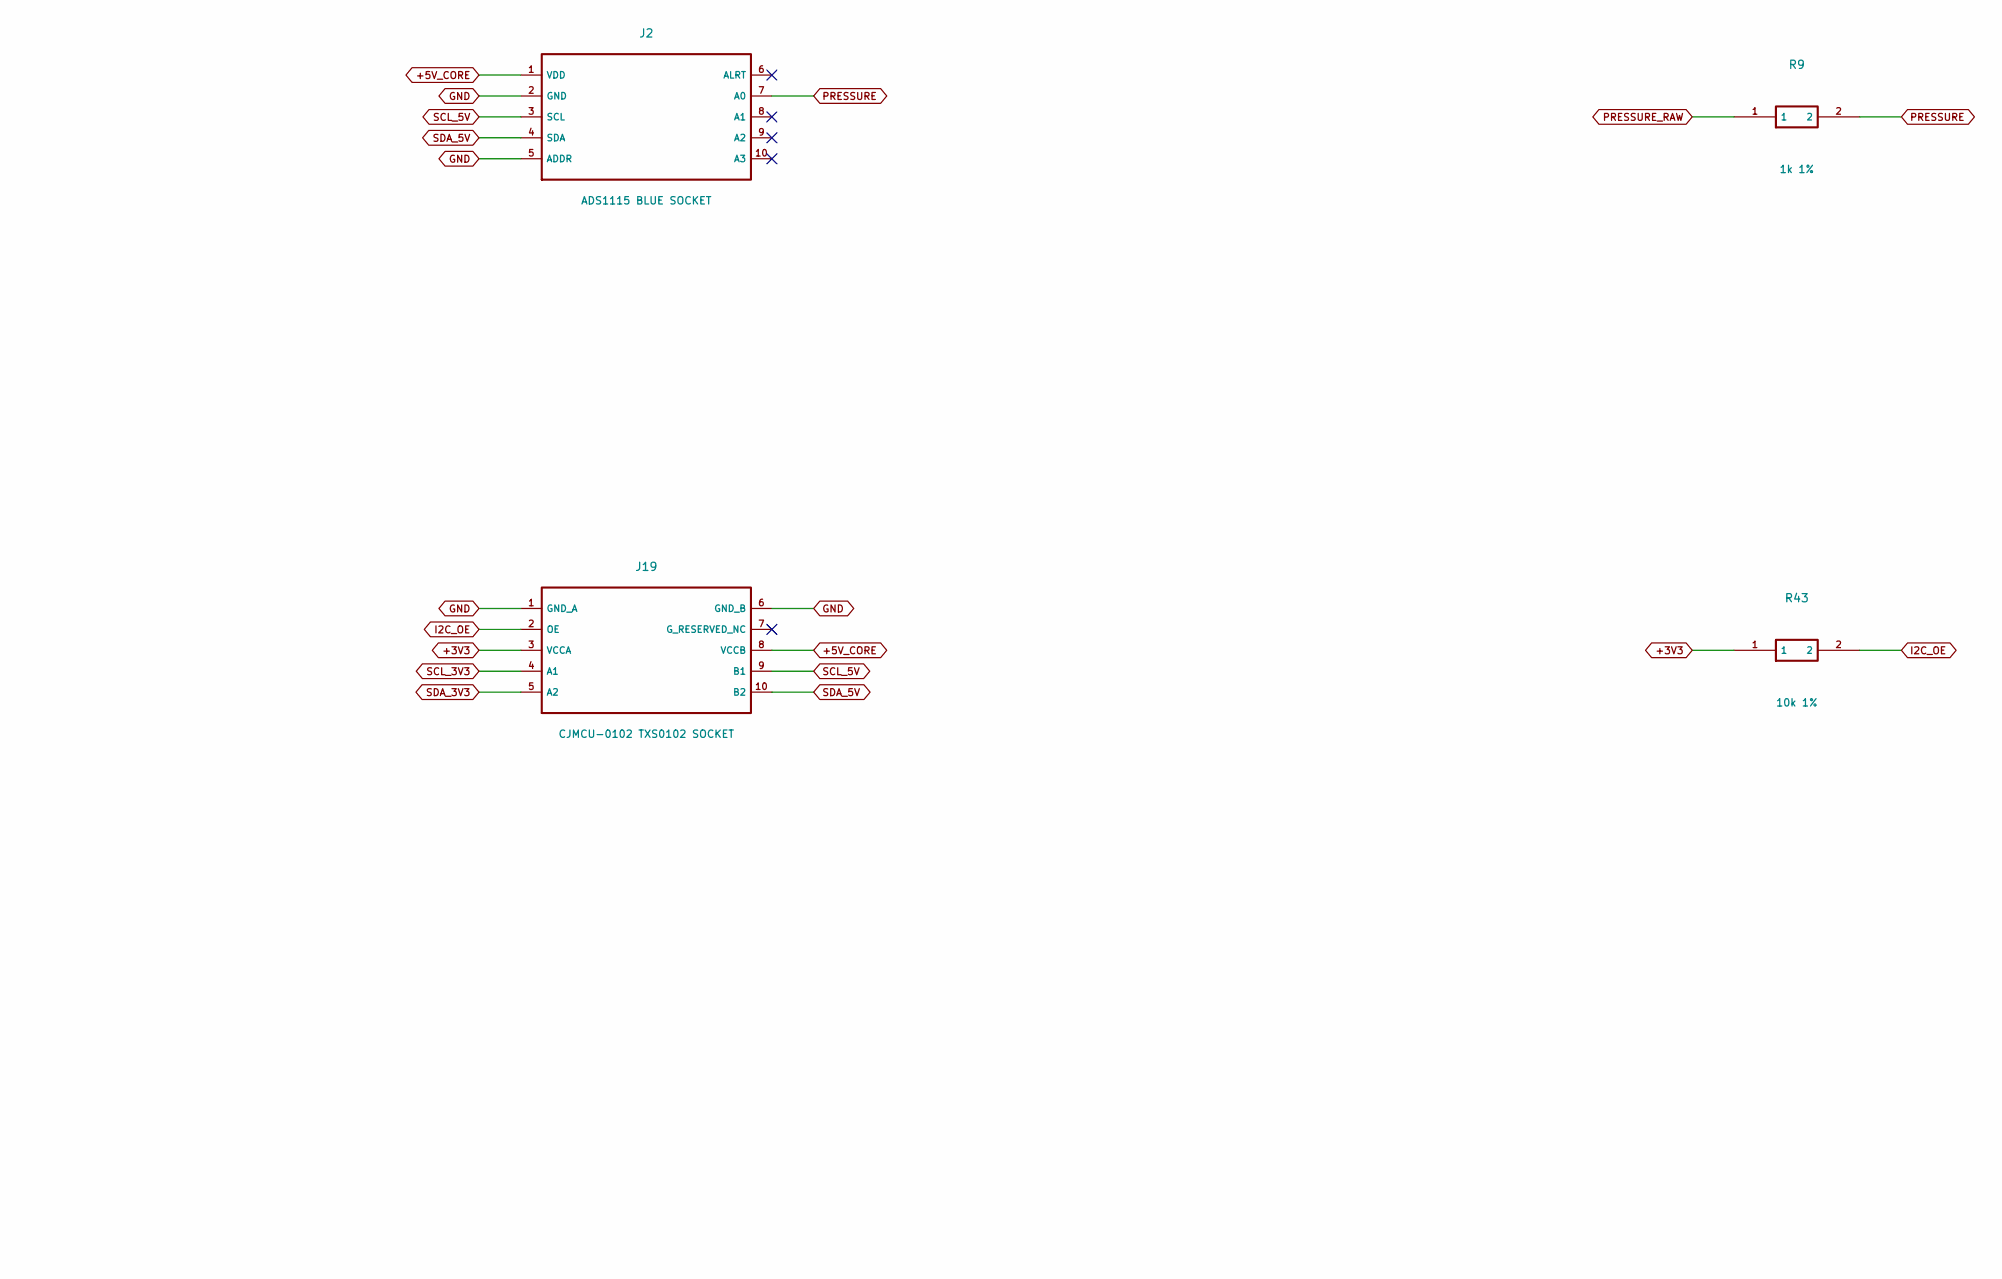
[picture p30: schematic pressure.kicad_sch, ADS1115 and 3V3/5V I2C, part in row 1, column 2]

Parts:
C7, C8, C9: 100nF 50V X7R; C_0805_2012Metric_Pad1.18x1.45mm_HandSolder
C17: 1uF 16V X7R; C_0805_2012Metric_Pad1.18x1.45mm_HandSolder
J2: ADS1115 BLUE SOCKET; ADS1115_socket
J6: PRESSURE; JST_PH_B3B-PH-K_1x03_P2.00mm_Vertical
J19: CJMCU-0102 TXS0102 SOCKET; CJMCU0102_socket
R9: 1k 1%; R_0805_2012Metric_Pad1.20x1.40mm_HandSolder
R43: 10k 1%; R_0805_2012Metric_Pad1.20x1.40mm_HandSolder

Connections:
+3V3: C7.1, J19.3 (VCCA), R43.1; also elsewhere on the board
+5V_CORE: C8.1, J2.1 (VDD), J19.8 (VCCB); also elsewhere on the board
+5V_EXT: J6.1 (5V); also elsewhere on the board
GND: C7.2, C8.2, C9.2, C17.2, J2.2 (GND), J2.5 (ADDR), J6.2 (GND), J19.1 (GND_A), J19.6 (GND_B); also elsewhere on the board
I2C_OE: C17.1, J19.2 (OE), R43.2
PRESSURE: C9.1, J2.7 (A0), R9.2
PRESSURE_RAW: J6.3 (OUT), R9.1
SCL_3V3: J19.4 (A1); also elsewhere on the board
SCL_5V: J2.3 (SCL), J19.9 (B1)
SDA_3V3: J19.5 (A2); also elsewhere on the board
SDA_5V: J2.4 (SDA), J19.10 (B2)

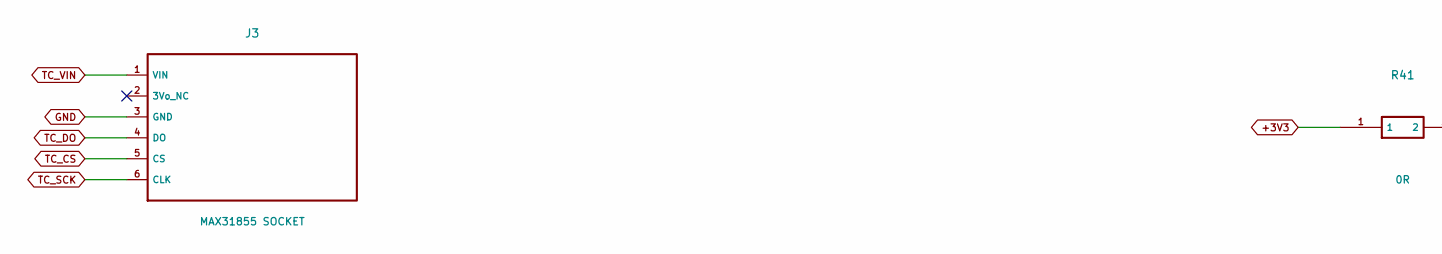
[picture p31: schematic temperature.kicad_sch, MAX31855 socket, part in row 1, column 1]

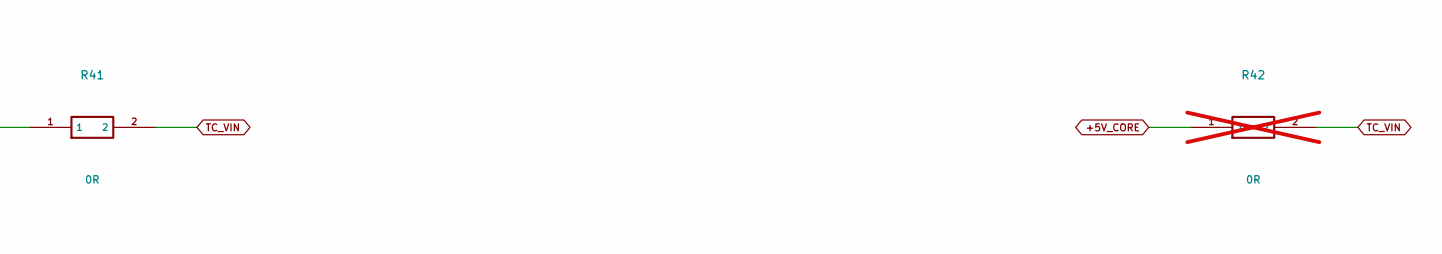
[picture p32: schematic temperature.kicad_sch, MAX31855 socket, part in row 1, column 2]

Parts:
J3: MAX31855 SOCKET; MAX31855_socket
R41: 0R; R_0805_2012Metric_Pad1.20x1.40mm_HandSolder
R42: 0R; R_0805_2012Metric_Pad1.20x1.40mm_HandSolder; not fitted

Connections:
+3V3: R41.1; also elsewhere on the board
+5V_CORE: R42.1; also elsewhere on the board
GND: J3.3 (GND); also elsewhere on the board
TC_CS: J3.5 (CS); also elsewhere on the board
TC_DO: J3.4 (DO); also elsewhere on the board
TC_SCK: J3.6 (CLK); also elsewhere on the board
TC_VIN: J3.1 (VIN), R41.2, R42.2

Schematic: outputs.kicad_sch, ZC and buffered external outputs

Parts:
C10, C11, C12, C15: 100nF 50V X7R; C_0805_2012Metric_Pad1.18x1.45mm_HandSolder
J8: ROBOTDYN; JST_PH_B6B-PH-K_1x06_P2.00mm_Vertical
J9: VALVE SSR; JST_PH_B3B-PH-K_1x03_P2.00mm_Vertical
J10: HEATER UNUSED; JST_PH_B3B-PH-K_1x03_P2.00mm_Vertical; not fitted
J11: ALT SSR; JST_PH_B3B-PH-K_1x03_P2.00mm_Vertical
Q1: MMBT3904; SOT-23_Handsoldering
R10, R14, R15, R16, R17, R18, R19, R20, R21, R22: 10k 1%; R_0805_2012Metric_Pad1.20x1.40mm_HandSolder
R11: 1k 1%; R_0805_2012Metric_Pad1.20x1.40mm_HandSolder
R12: 47k 1%; R_0805_2012Metric_Pad1.20x1.40mm_HandSolder
R13, R36, R38: 100k 1%; R_0805_2012Metric_Pad1.20x1.40mm_HandSolder
R27, R28: 0R; R_0805_2012Metric_Pad1.20x1.40mm_HandSolder
R29, R30: 4.7k 1%; R_0805_2012Metric_Pad1.20x1.40mm_HandSolder
R31, R32, R33, R34: 180R 1%; R_0805_2012Metric_Pad1.20x1.40mm_HandSolder
R35, R37: 100R 1%; R_0805_2012Metric_Pad1.20x1.40mm_HandSolder
U4: SN74LVC1G17DBVR; SOT-23-5_HandSoldering
U5: SN74LVC1G125DBVR; SOT-23-5_HandSoldering
U6: SN74AHCT125DR; SOIC-14_3.9x8.7mm_P1.27mm

Connections:
+3V3: C10.1, C12.1, C15.1, R14.1, R29.1, R30.1, U4.5 (VCC), U5.5 (VCC); also elsewhere on the board
+5V_EXT: C11.1, J8.1 (5V), J9.1 (5V), J10.1 (5V), J11.1 (5V), R10.1, R12.1, U6.13 (4OE_N), U6.14 (VCC); also elsewhere on the board
ALBA_SCL: R27.1, R30.2; also elsewhere on the board
ALBA_SDA: R28.1, R29.2; also elsewhere on the board
ALT: R18.1, U6.9 (3A); also elsewhere on the board
ALT_5V: J11.3 (IN), R22.1, U6.8 (3Y)
EXT_BASE: Q1.1 (B), R12.2, R13.1
GND: C10.2, C11.2, C12.2, C15.2, J8.2 (GND), J9.2 (GND), J10.2 (GND), J11.2 (GND), Q1.2 (E), R13.2, R15.2, R16.2, R17.2, R18.2, R19.2, R20.2, R21.2, R22.2, R36.2, R38.2, U4.3 (GND), U5.3 (GND), U6.7 (GND), U6.12 (4A); also elsewhere on the board
HEATER: R17.1, U6.5 (2A); also elsewhere on the board
HEATER_5V: J10.3 (IN), R21.1, U6.6 (2Y)
LED_GATE4: R35.2, R36.1; also elsewhere on the board
LED_GATE5: R37.2, R38.1; also elsewhere on the board
OUTPUT_OE_N: Q1.3 (C), R14.2, U5.1 (OE_N), U6.1 (1OE_N), U6.4 (2OE_N), U6.10 (3OE_N)
PCA_LED0: R31.1; also elsewhere on the board
PCA_LED1: R32.1; also elsewhere on the board
PCA_LED2: R33.1; also elsewhere on the board
PCA_LED3: R34.1; also elsewhere on the board
PCA_LED4: R35.1; also elsewhere on the board
PCA_LED5: R37.1; also elsewhere on the board
PCA_SCL: R27.2; also elsewhere on the board
PCA_SDA: R28.2; also elsewhere on the board
PUMP_OUT: J8.4 (PSM), R19.1, U5.4 (Y)
PUMP_PWM: R15.1, U5.2 (A); also elsewhere on the board
PUMP_ZC: U4.4 (Y); also elsewhere on the board
RGBW0: R31.2; also elsewhere on the board
RGBW1: R32.2; also elsewhere on the board
RGBW2: R33.2; also elsewhere on the board
RGBW3: R34.2; also elsewhere on the board
VALVE: R16.1, U6.2 (1A); also elsewhere on the board
VALVE_5V: J9.3 (IN), R20.1, U6.3 (1Y)
ZC_IN: R11.2, U4.2 (A)
ZC_RAW: J8.3 (ZC), R10.2, R11.1

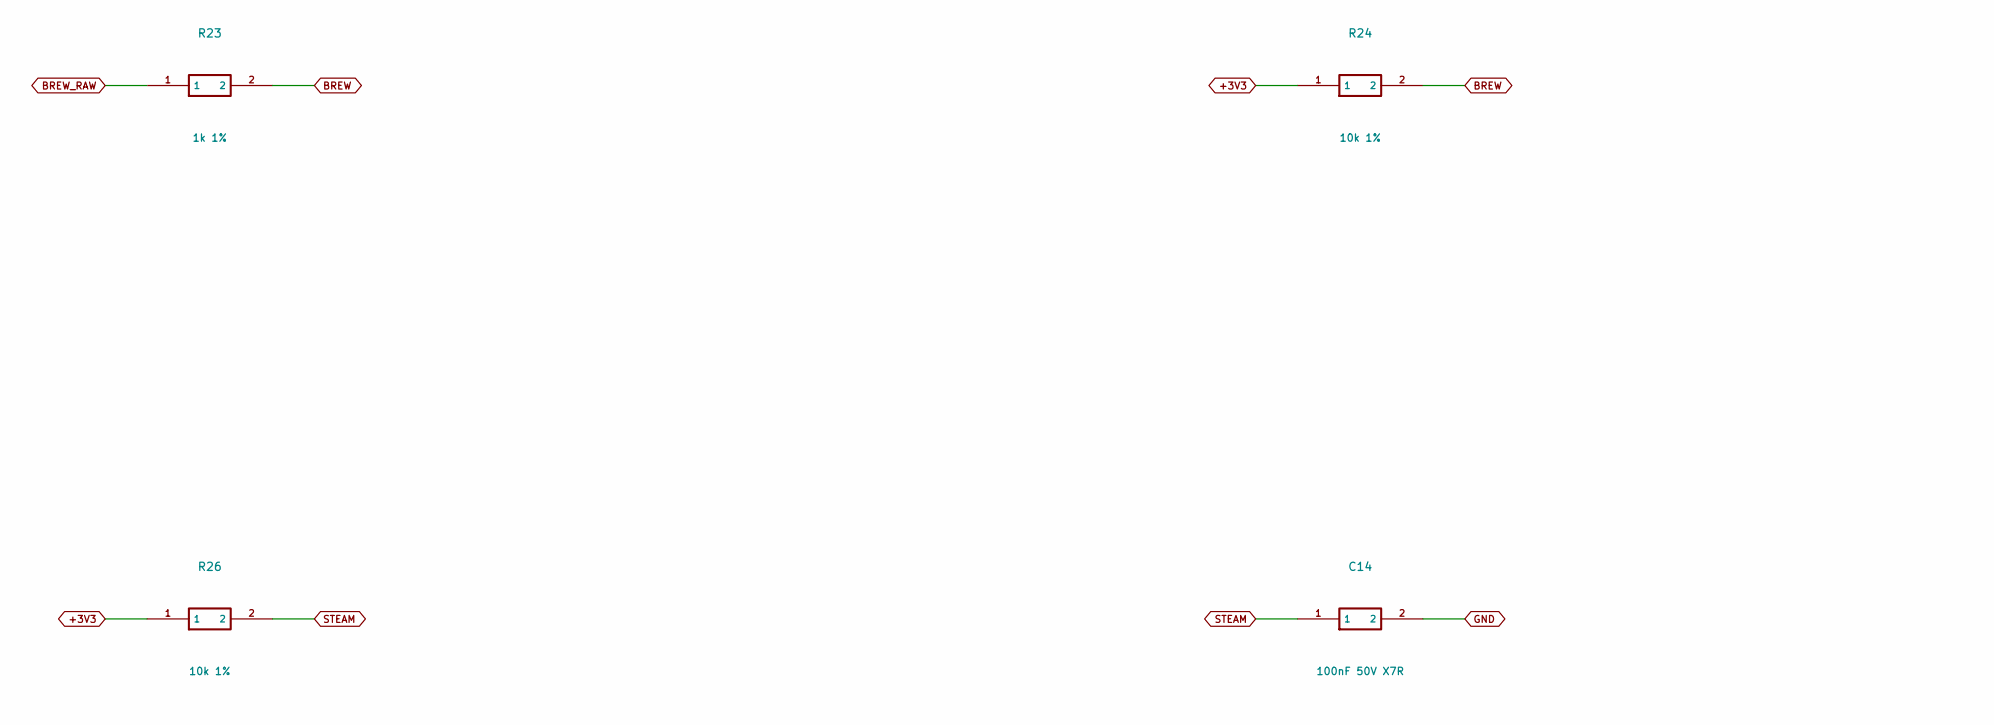
[picture p33: schematic buttons.kicad_sch, Active-low dry contacts, part in row 1, column 1]

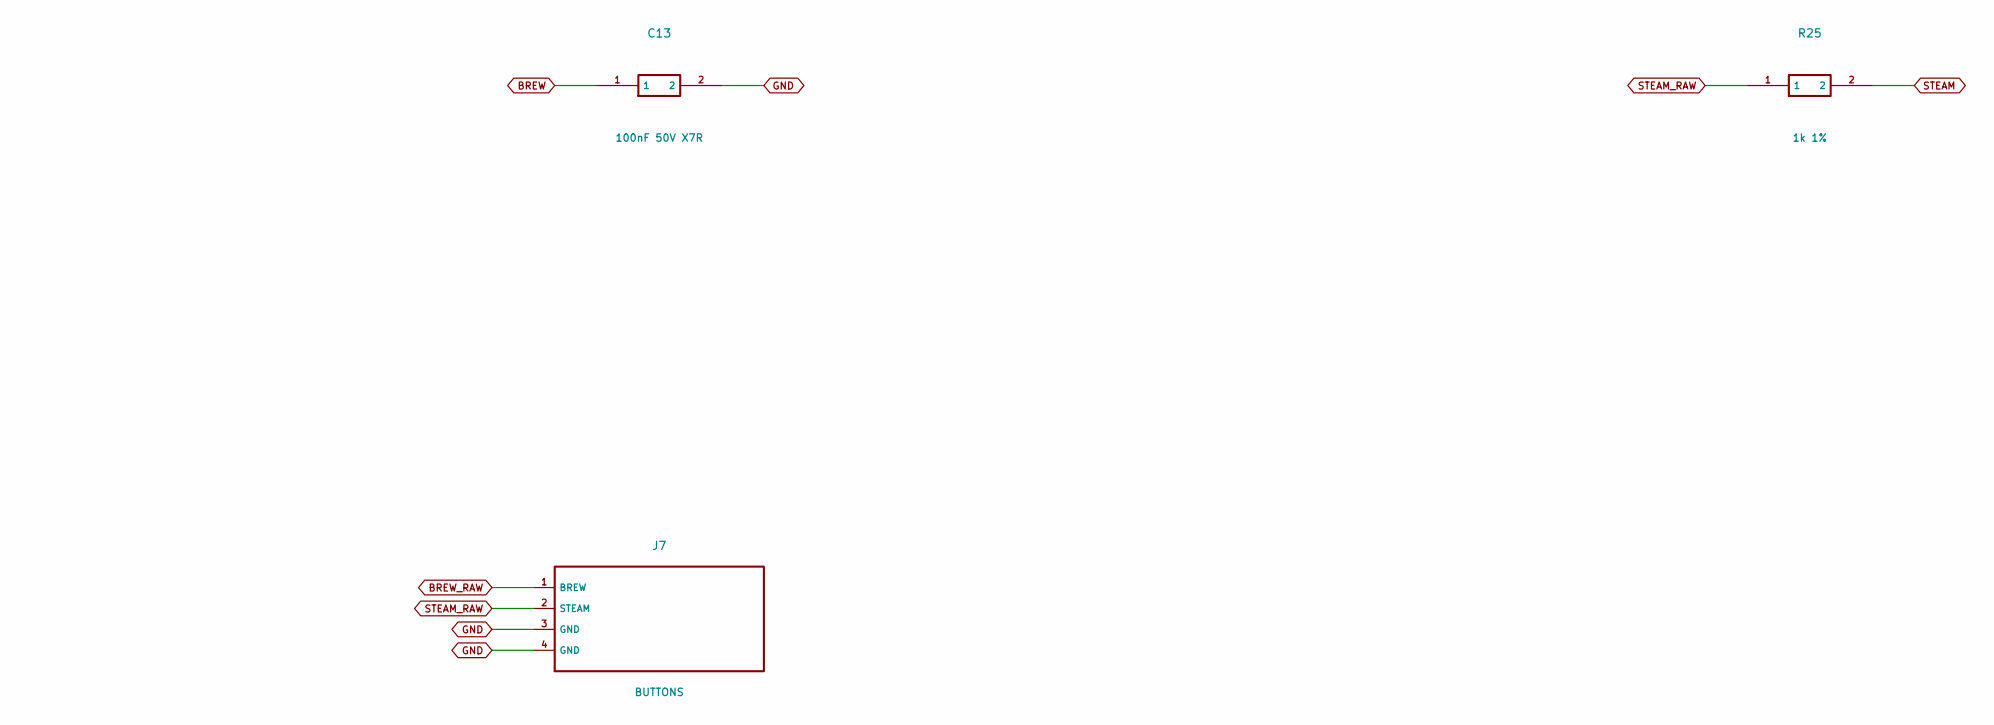
[picture p34: schematic buttons.kicad_sch, Active-low dry contacts, part in row 1, column 2]

Parts:
C13, C14: 100nF 50V X7R; C_0805_2012Metric_Pad1.18x1.45mm_HandSolder
J7: BUTTONS; JST_PH_B4B-PH-K_1x04_P2.00mm_Vertical
R23, R25: 1k 1%; R_0805_2012Metric_Pad1.20x1.40mm_HandSolder
R24, R26: 10k 1%; R_0805_2012Metric_Pad1.20x1.40mm_HandSolder

Connections:
+3V3: R24.1, R26.1; also elsewhere on the board
BREW: C13.1, R23.2, R24.2; also elsewhere on the board
BREW_RAW: J7.1 (BREW), R23.1
GND: C13.2, C14.2, J7.3 (GND), J7.4 (GND); also elsewhere on the board
STEAM: C14.1, R25.2, R26.2; also elsewhere on the board
STEAM_RAW: J7.2 (STEAM), R25.1

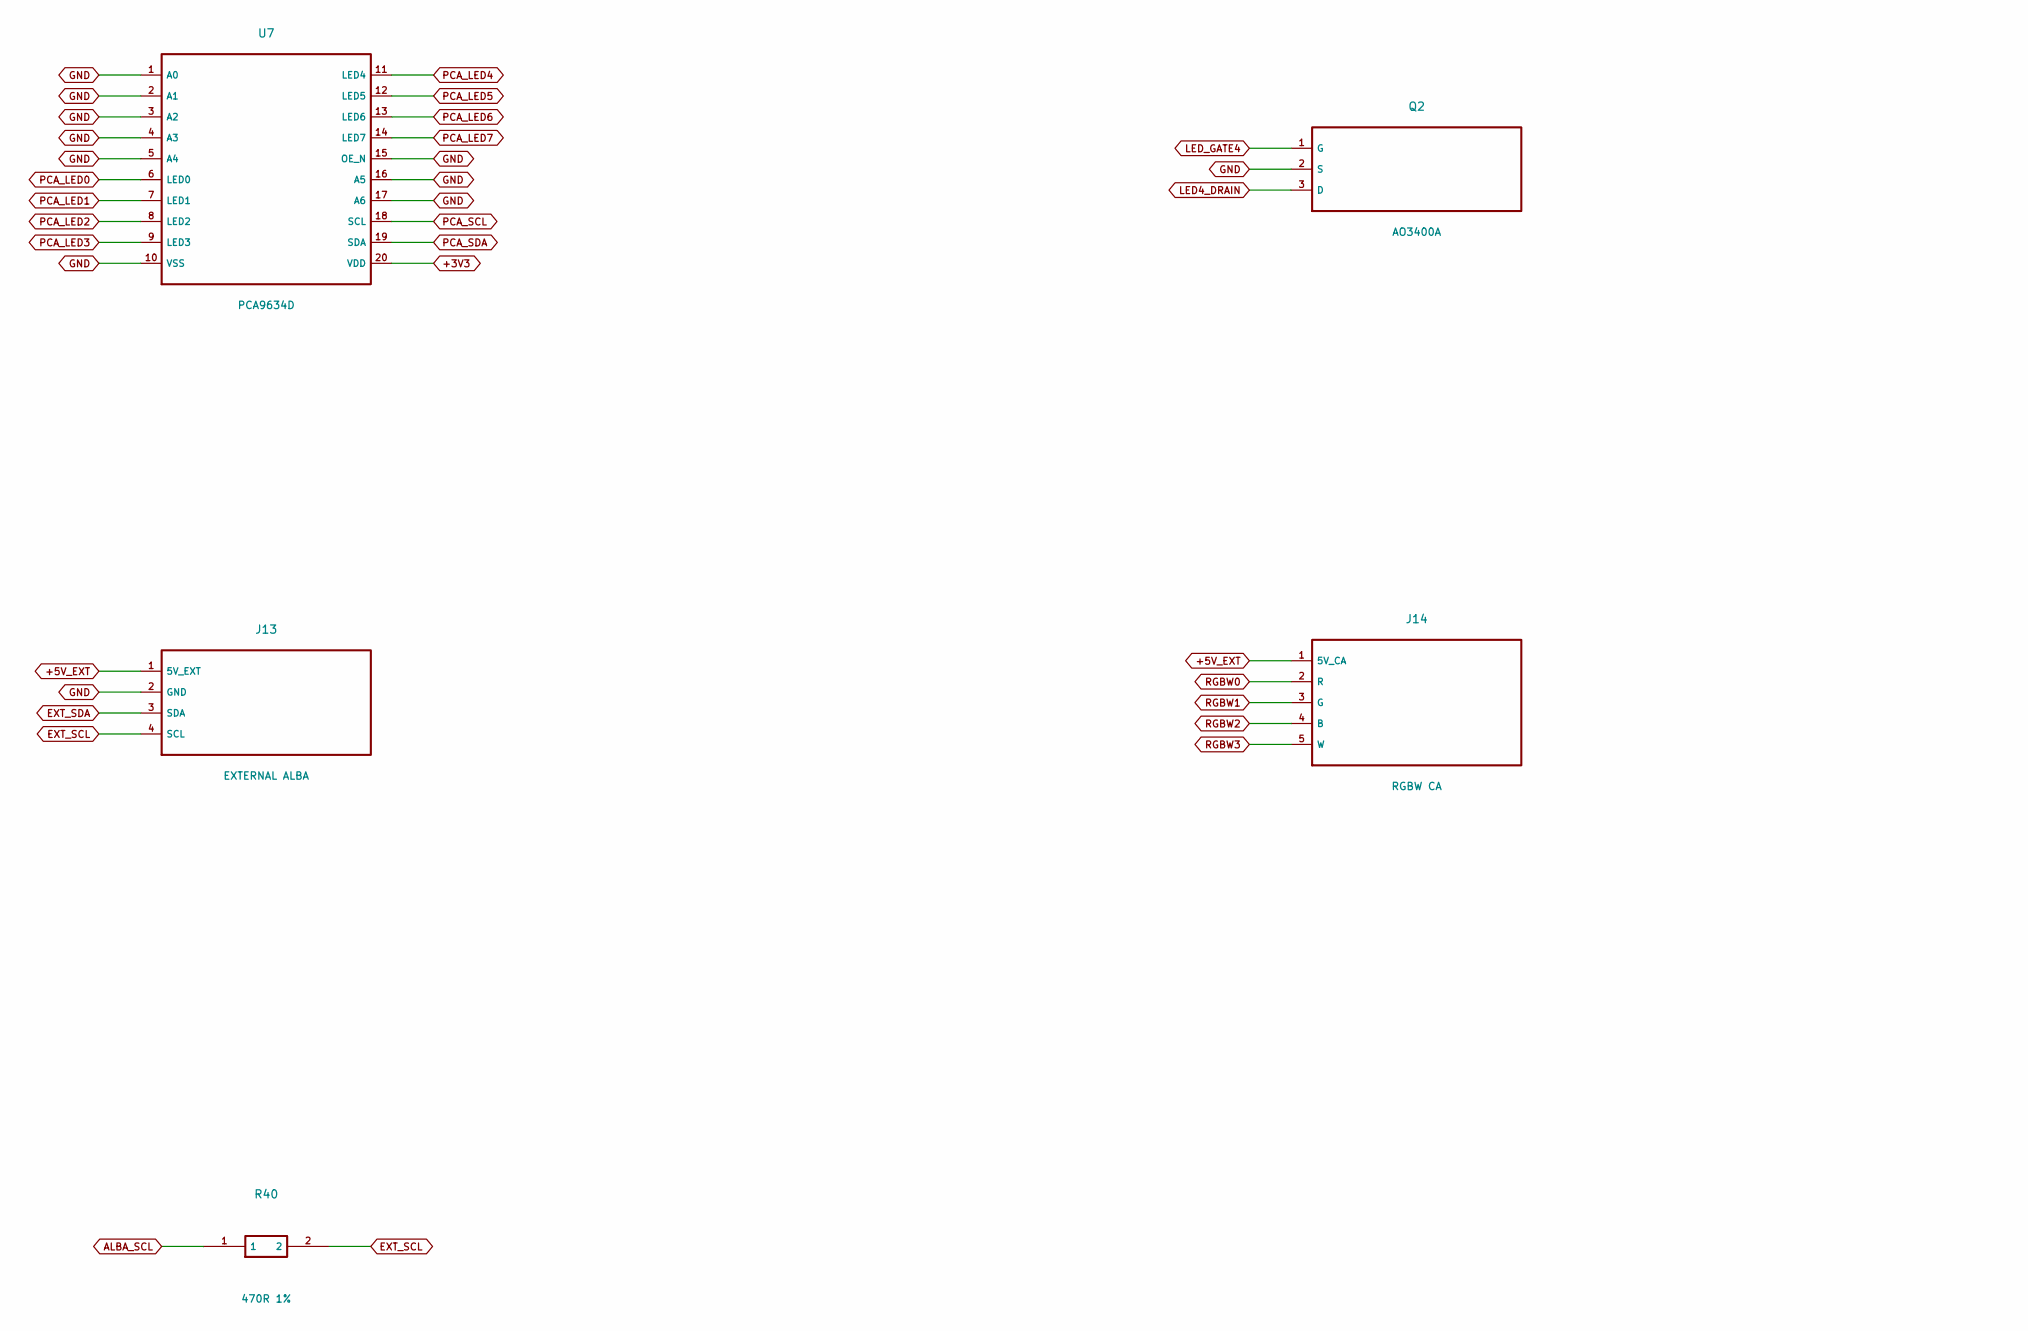
[picture p35: schematic alba.kicad_sch, PCA9634 and tank / lighting, part in row 1, column 1]

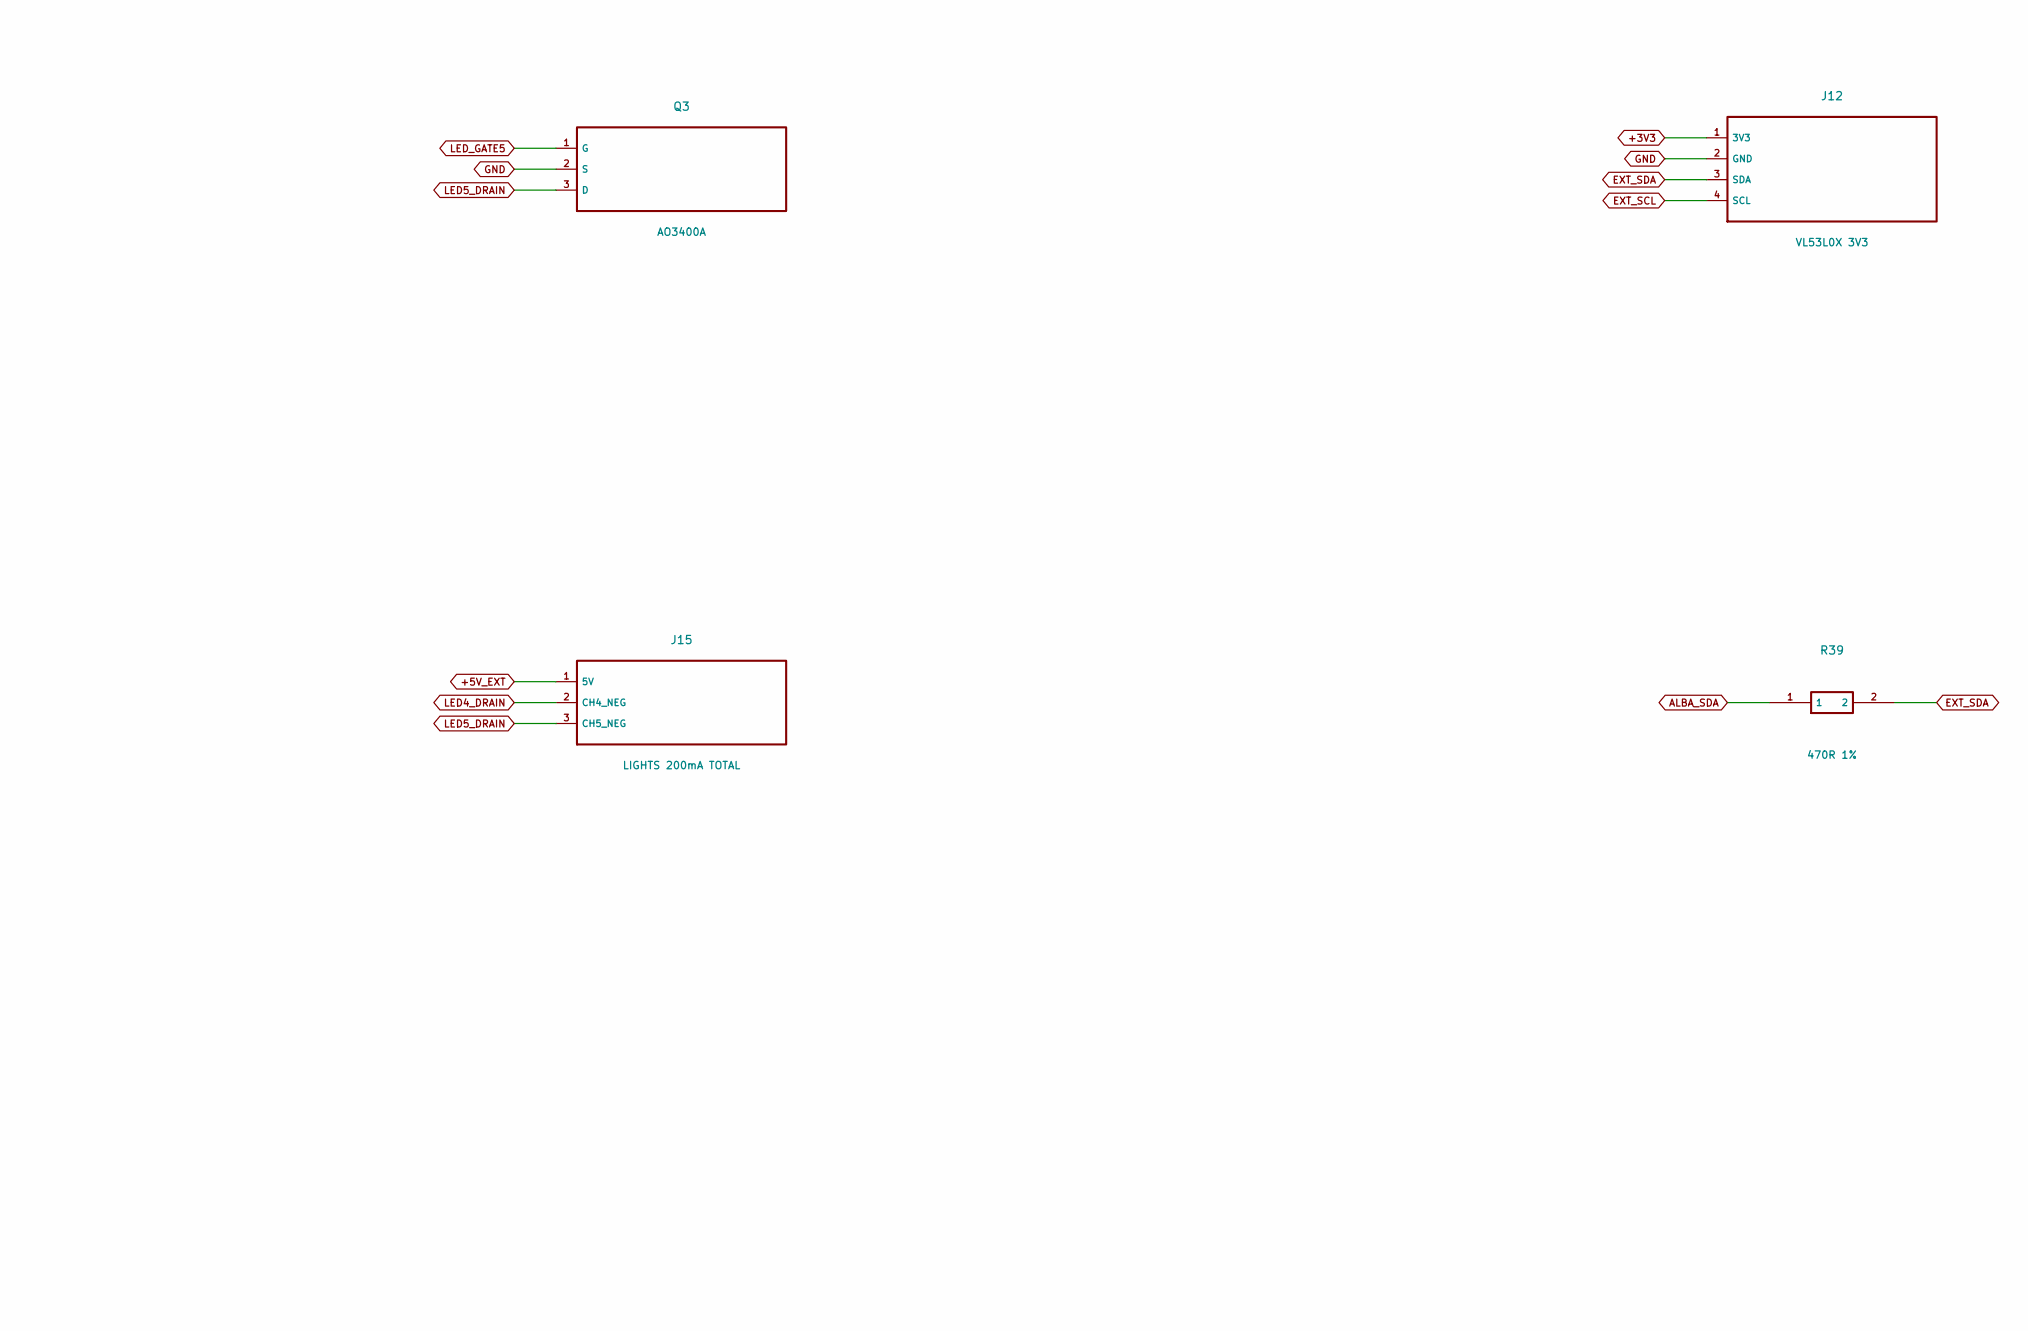
[picture p36: schematic alba.kicad_sch, PCA9634 and tank / lighting, part in row 1, column 2]

Parts:
J12: VL53L0X 3V3; JST_PH_B4B-PH-K_1x04_P2.00mm_Vertical
J13: EXTERNAL ALBA; JST_PH_B4B-PH-K_1x04_P2.00mm_Vertical
J14: RGBW CA; JST_PH_B5B-PH-K_1x05_P2.00mm_Vertical
J15: LIGHTS 200mA TOTAL; JST_PH_B3B-PH-K_1x03_P2.00mm_Vertical
Q2, Q3: AO3400A; SOT-23_Handsoldering
R39, R40: 470R 1%; R_0805_2012Metric_Pad1.20x1.40mm_HandSolder
U7: PCA9634D; SOIC-20W_7.5x12.8mm_P1.27mm

Connections:
+3V3: J12.1 (3V3), U7.20 (VDD); also elsewhere on the board
+5V_EXT: J13.1 (5V_EXT), J14.1 (5V_CA), J15.1 (5V); also elsewhere on the board
ALBA_SCL: R40.1; also elsewhere on the board
ALBA_SDA: R39.1; also elsewhere on the board
EXT_SCL: J12.4 (SCL), J13.4 (SCL), R40.2
EXT_SDA: J12.3 (SDA), J13.3 (SDA), R39.2
GND: J12.2 (GND), J13.2 (GND), Q2.2 (S), Q3.2 (S), U7.1 (A0), U7.2 (A1), U7.3 (A2), U7.4 (A3), U7.5 (A4), U7.10 (VSS), U7.15 (OE_N), U7.16 (A5), U7.17 (A6); also elsewhere on the board
LED4_DRAIN: J15.2 (CH4_NEG), Q2.3 (D)
LED5_DRAIN: J15.3 (CH5_NEG), Q3.3 (D)
LED_GATE4: Q2.1 (G); also elsewhere on the board
LED_GATE5: Q3.1 (G); also elsewhere on the board
PCA_LED0: U7.6 (LED0); also elsewhere on the board
PCA_LED1: U7.7 (LED1); also elsewhere on the board
PCA_LED2: U7.8 (LED2); also elsewhere on the board
PCA_LED3: U7.9 (LED3); also elsewhere on the board
PCA_LED4: U7.11 (LED4); also elsewhere on the board
PCA_LED5: U7.12 (LED5); also elsewhere on the board
PCA_LED6: U7.13 (LED6); also elsewhere on the board
PCA_LED7: U7.14 (LED7); also elsewhere on the board
PCA_SCL: U7.18 (SCL); also elsewhere on the board
PCA_SDA: U7.19 (SDA); also elsewhere on the board
RGBW0: J14.2 (R); also elsewhere on the board
RGBW1: J14.3 (G); also elsewhere on the board
RGBW2: J14.4 (B); also elsewhere on the board
RGBW3: J14.5 (W); also elsewhere on the board
