rico-x/GemilaiMate/hardware/shield-compact/gemilaimate-compact.kicad_pcb

## KiCad design hardware/shield-compact/gemilaimate-compact.kicad_pcb (continued)

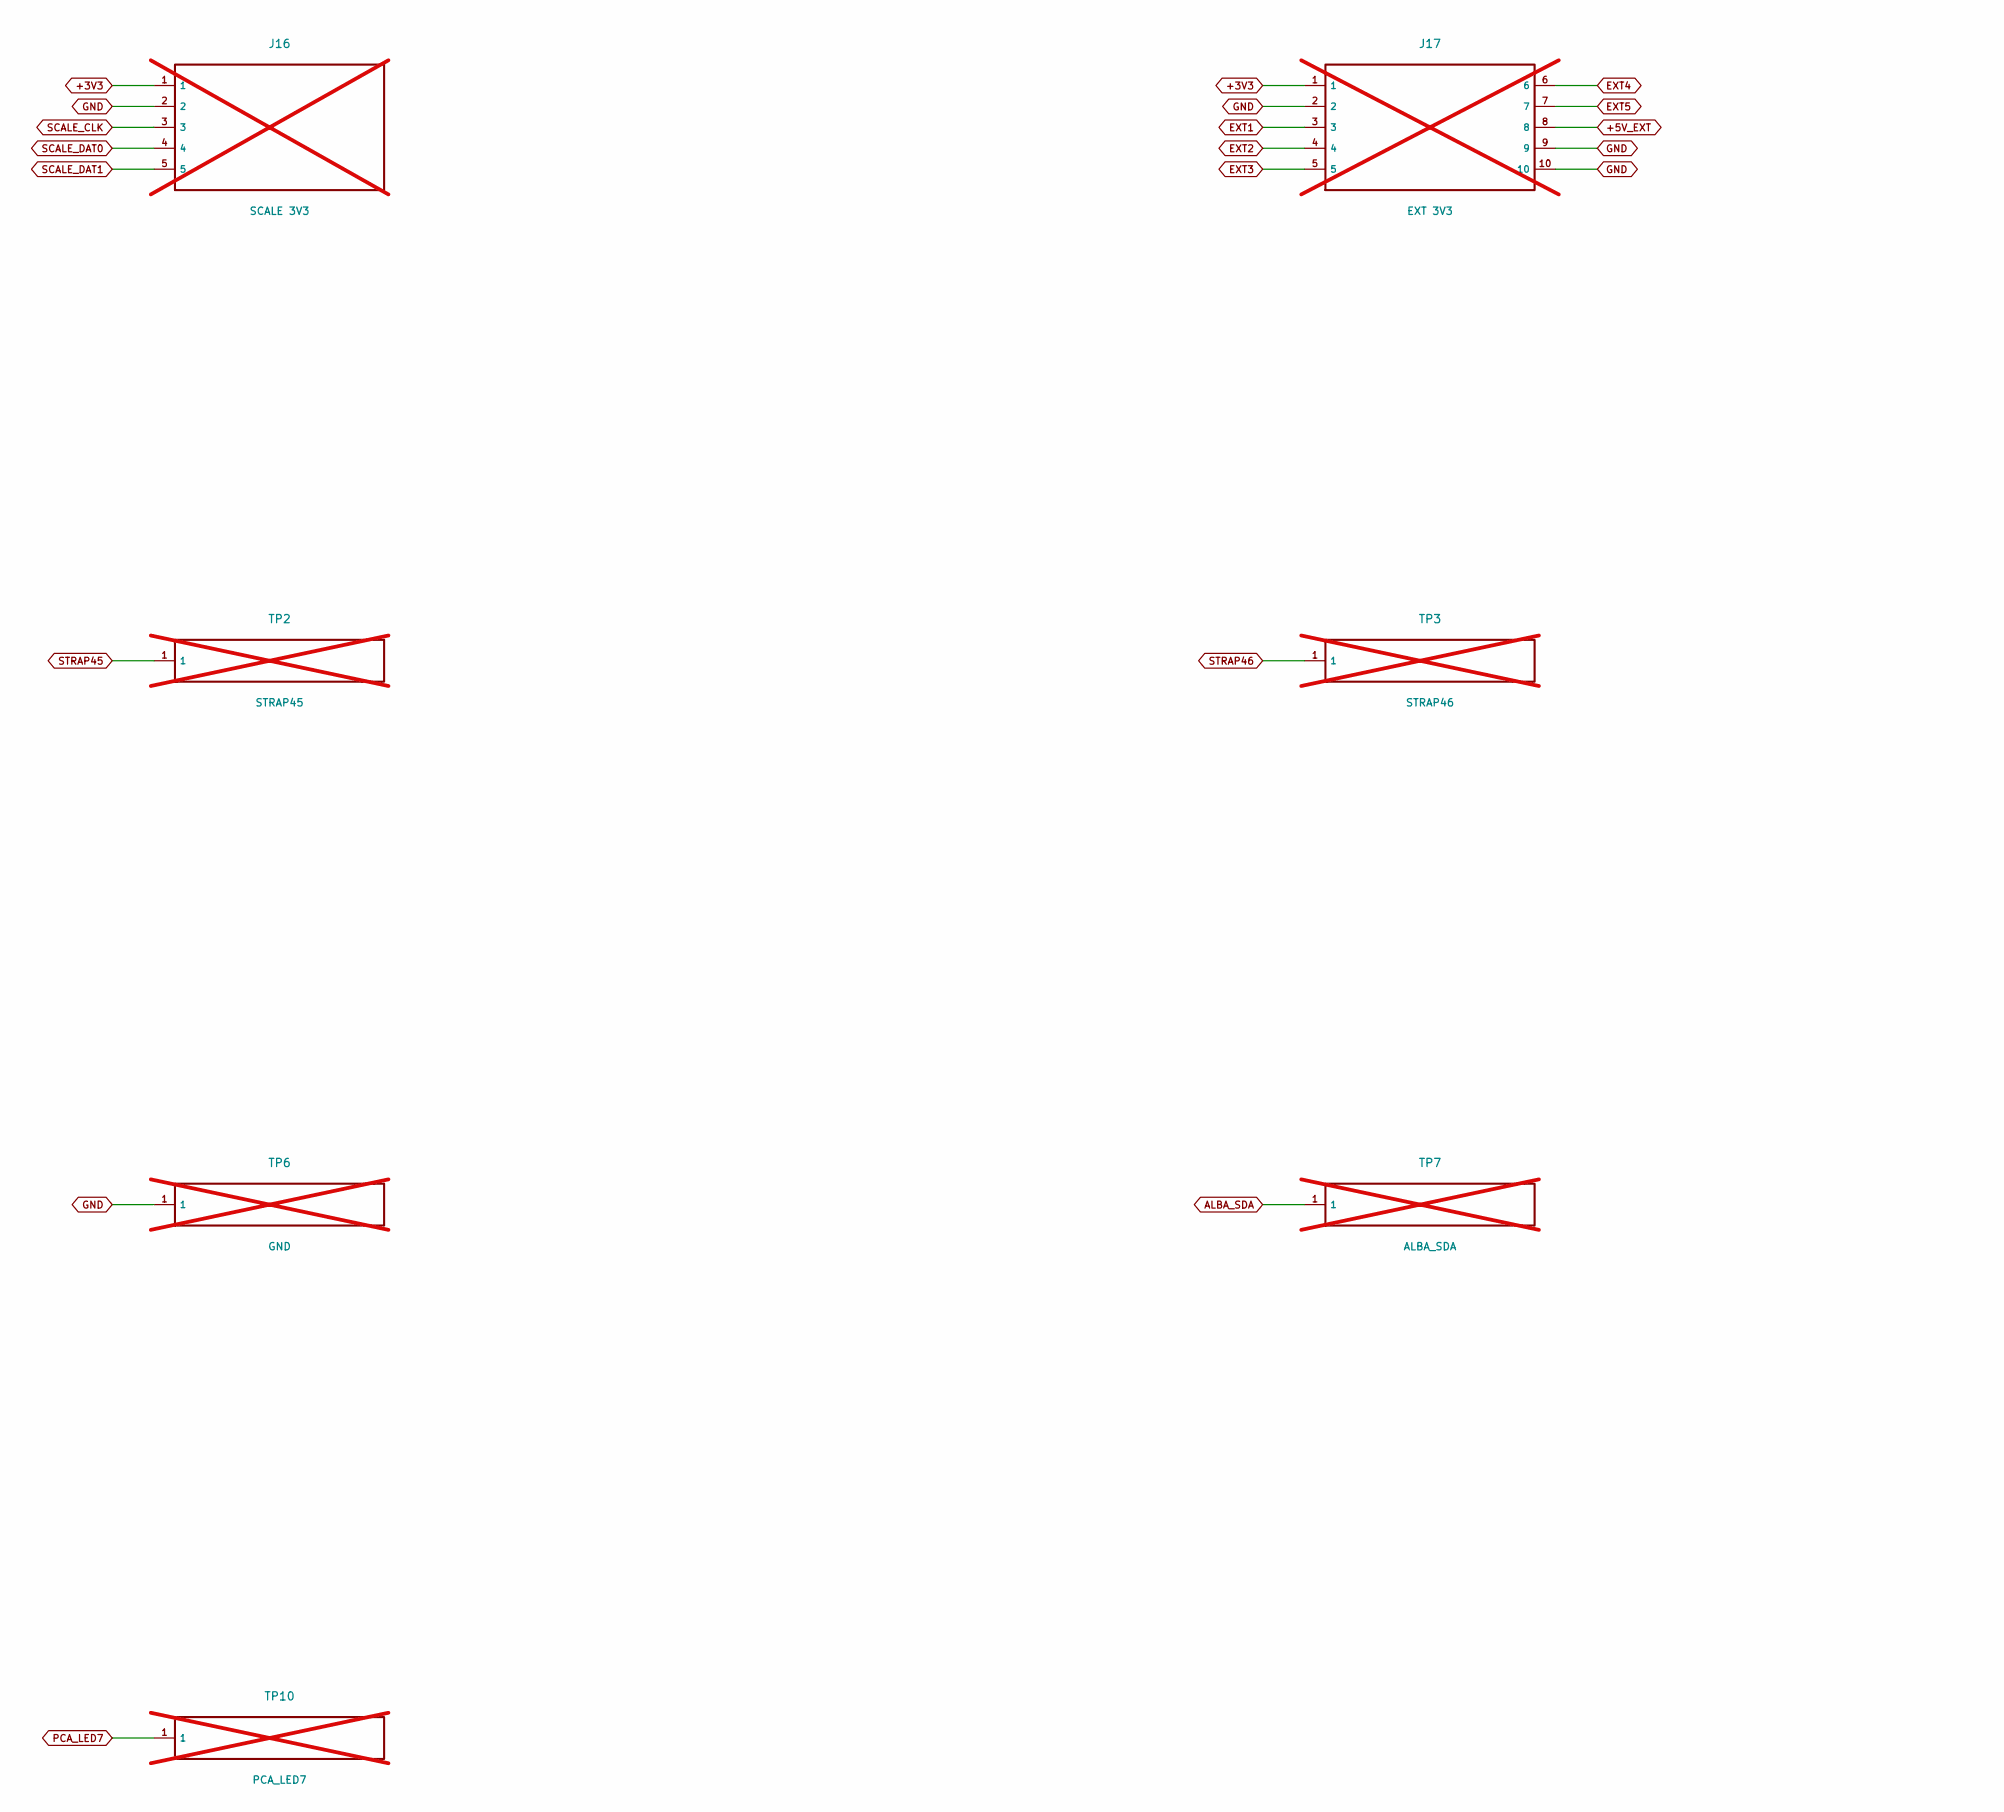
[picture p37: schematic expansion.kicad_sch, Reserved interfaces and free GPIO, part in row 1, column 1]

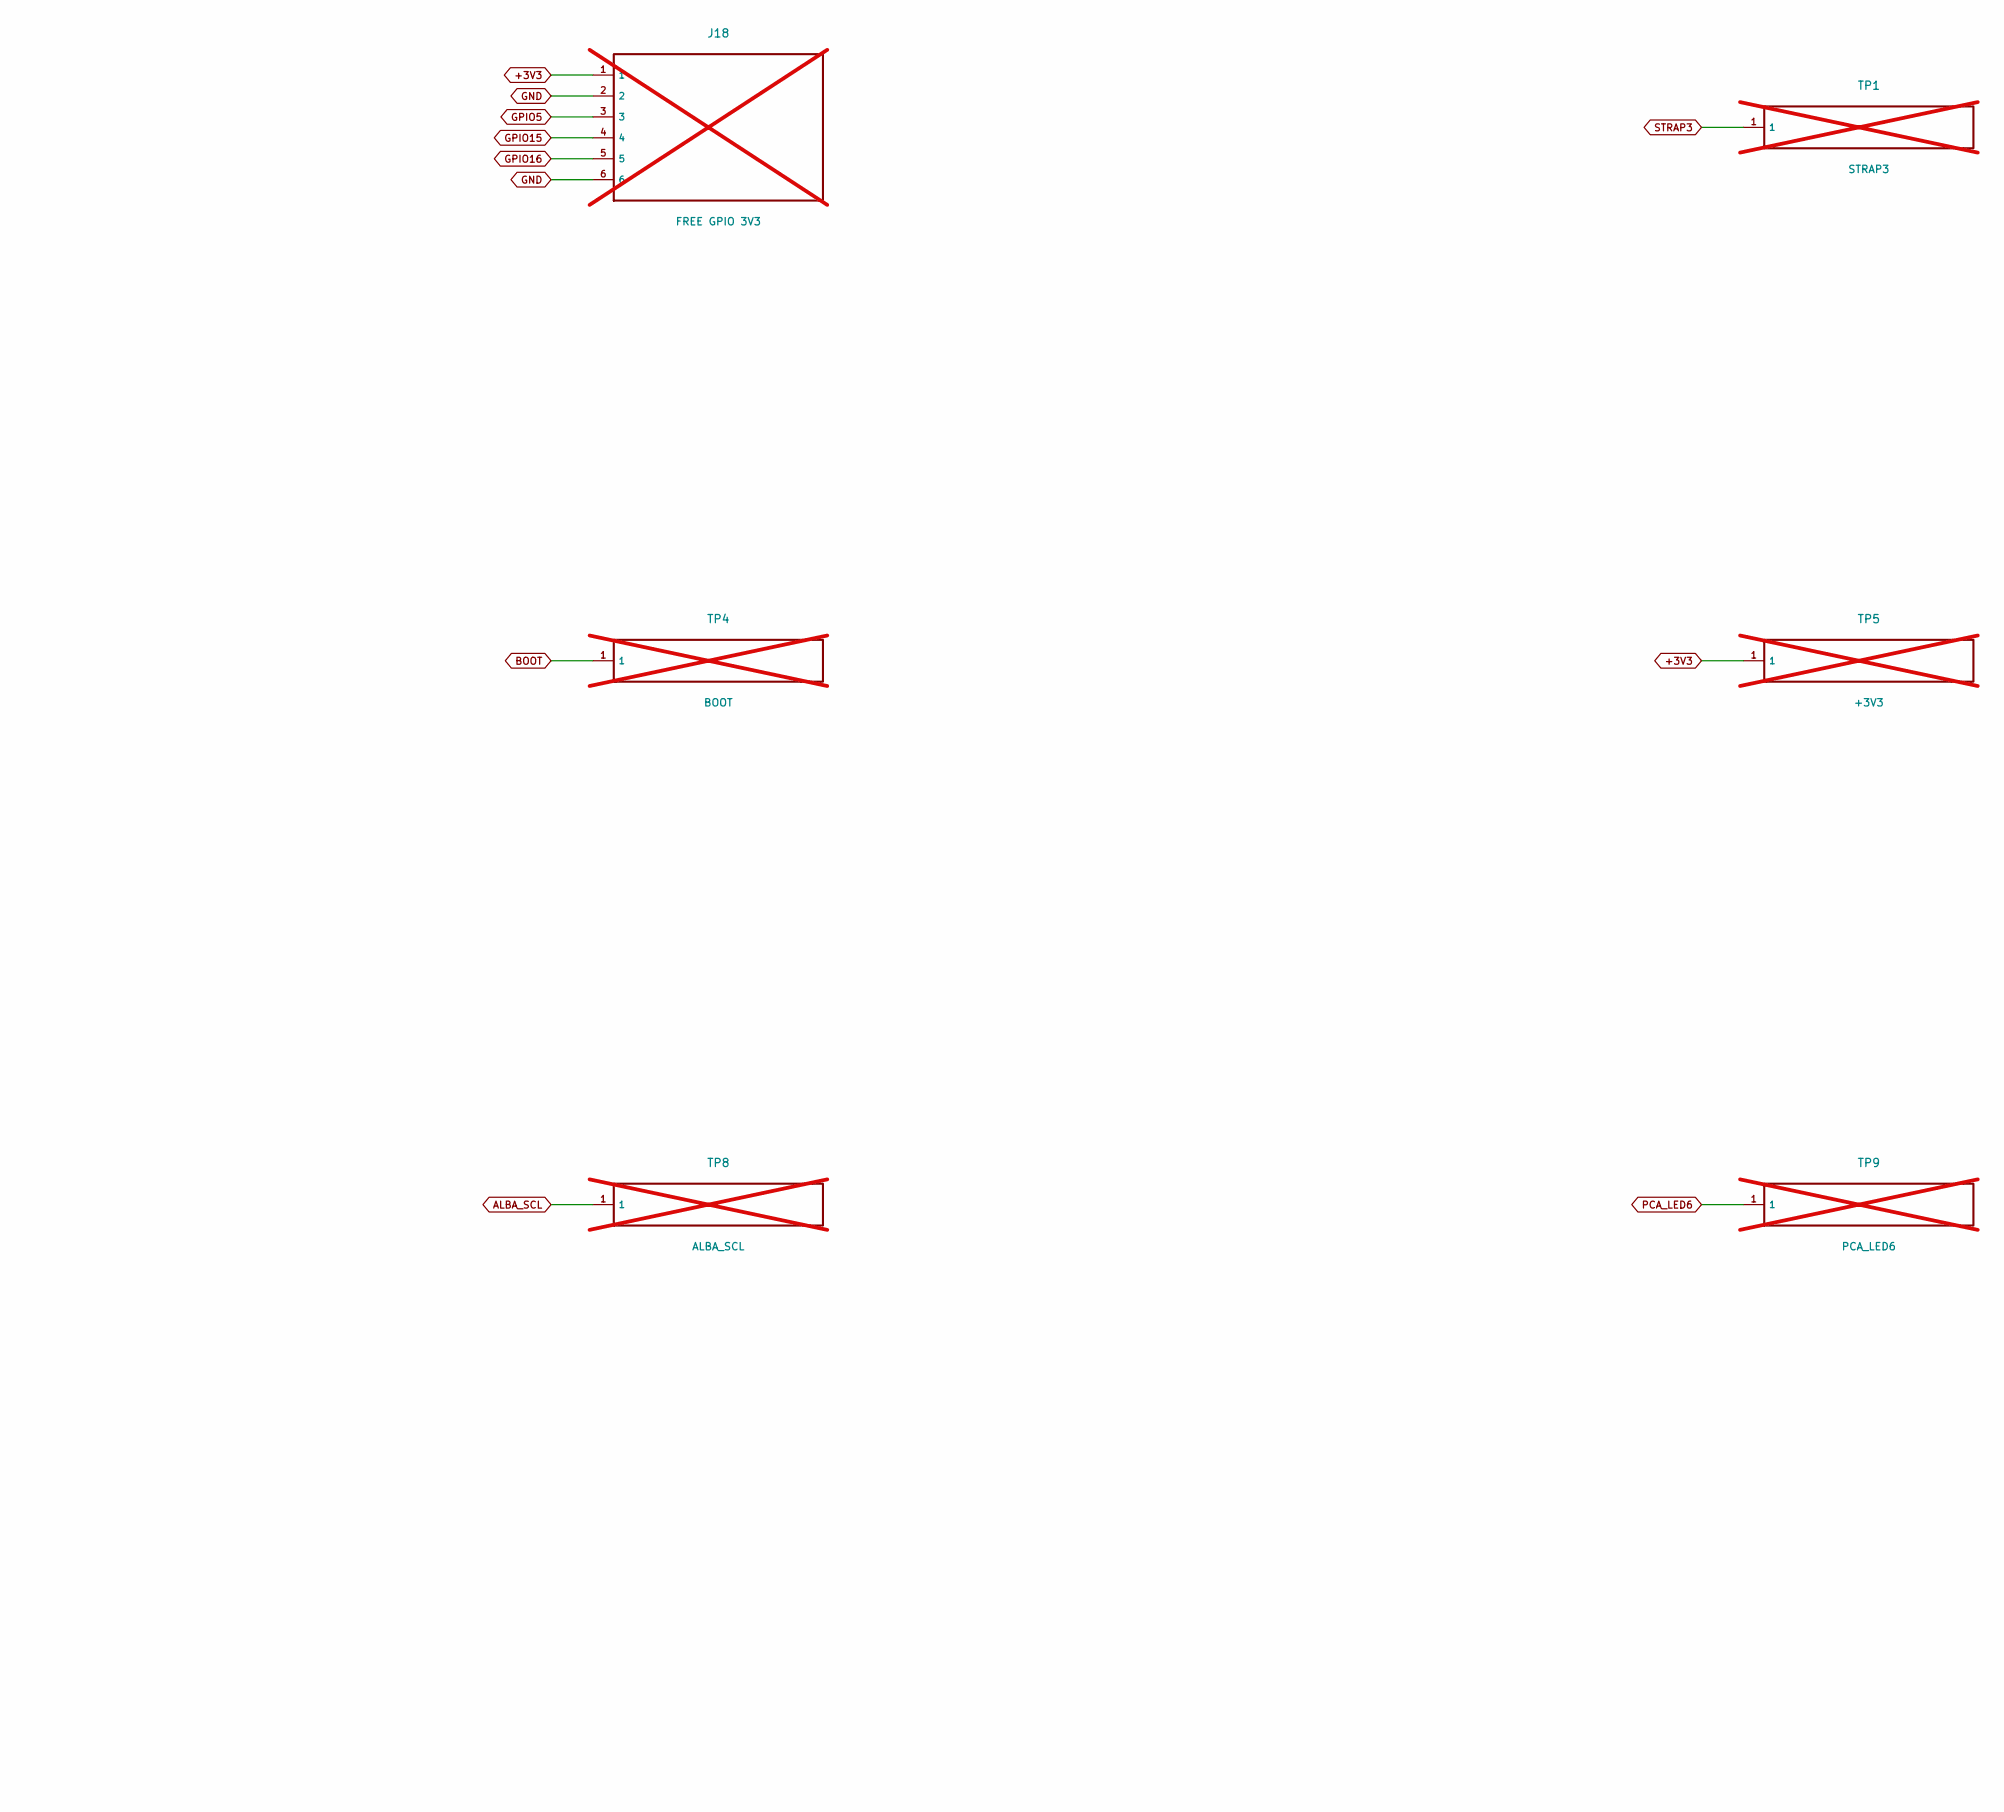
[picture p38: schematic expansion.kicad_sch, Reserved interfaces and free GPIO, part in row 1, column 2]

Parts:
J16: SCALE 3V3; PinHeader_1x05_P2.54mm_Vertical; not fitted
J17: EXT 3V3; PinHeader_2x05_P2.54mm_Vertical; not fitted
J18: FREE GPIO 3V3; PinHeader_1x06_P2.54mm_Vertical; not fitted
TP1: STRAP3; TestPoint_Pad_D1.0mm; not fitted
TP2: STRAP45; TestPoint_Pad_D1.0mm; not fitted
TP3: STRAP46; TestPoint_Pad_D1.0mm; not fitted
TP4: BOOT; TestPoint_Pad_D1.0mm; not fitted
TP5: +3V3; TestPoint_Pad_D1.0mm; not fitted
TP6: GND; TestPoint_Pad_D1.0mm; not fitted
TP7: ALBA_SDA; TestPoint_Pad_D1.0mm; not fitted
TP8: ALBA_SCL; TestPoint_Pad_D1.0mm; not fitted
TP9: PCA_LED6; TestPoint_Pad_D1.0mm; not fitted
TP10: PCA_LED7; TestPoint_Pad_D1.0mm; not fitted

Connections:
+3V3: J16.1, J17.1, J18.1, TP5.1 (1_1); also elsewhere on the board
+5V_EXT: J17.8; also elsewhere on the board
ALBA_SCL: TP8.1 (1_1); also elsewhere on the board
ALBA_SDA: TP7.1 (1_1); also elsewhere on the board
BOOT: TP4.1 (1_1); also elsewhere on the board
EXT1: J17.3; also elsewhere on the board
EXT2: J17.4; also elsewhere on the board
EXT3: J17.5; also elsewhere on the board
EXT4: J17.6; also elsewhere on the board
EXT5: J17.7; also elsewhere on the board
GND: J16.2, J17.2, J17.9, J17.10, J18.2, J18.6, TP6.1 (1_1); also elsewhere on the board
GPIO5: J18.3; also elsewhere on the board
GPIO15: J18.4; also elsewhere on the board
GPIO16: J18.5; also elsewhere on the board
PCA_LED6: TP9.1 (1_1); also elsewhere on the board
PCA_LED7: TP10.1 (1_1); also elsewhere on the board
SCALE_CLK: J16.3; also elsewhere on the board
SCALE_DAT0: J16.4; also elsewhere on the board
SCALE_DAT1: J16.5; also elsewhere on the board
STRAP3: TP1.1 (1_1); also elsewhere on the board
STRAP45: TP2.1 (1_1); also elsewhere on the board
STRAP46: TP3.1 (1_1); also elsewhere on the board

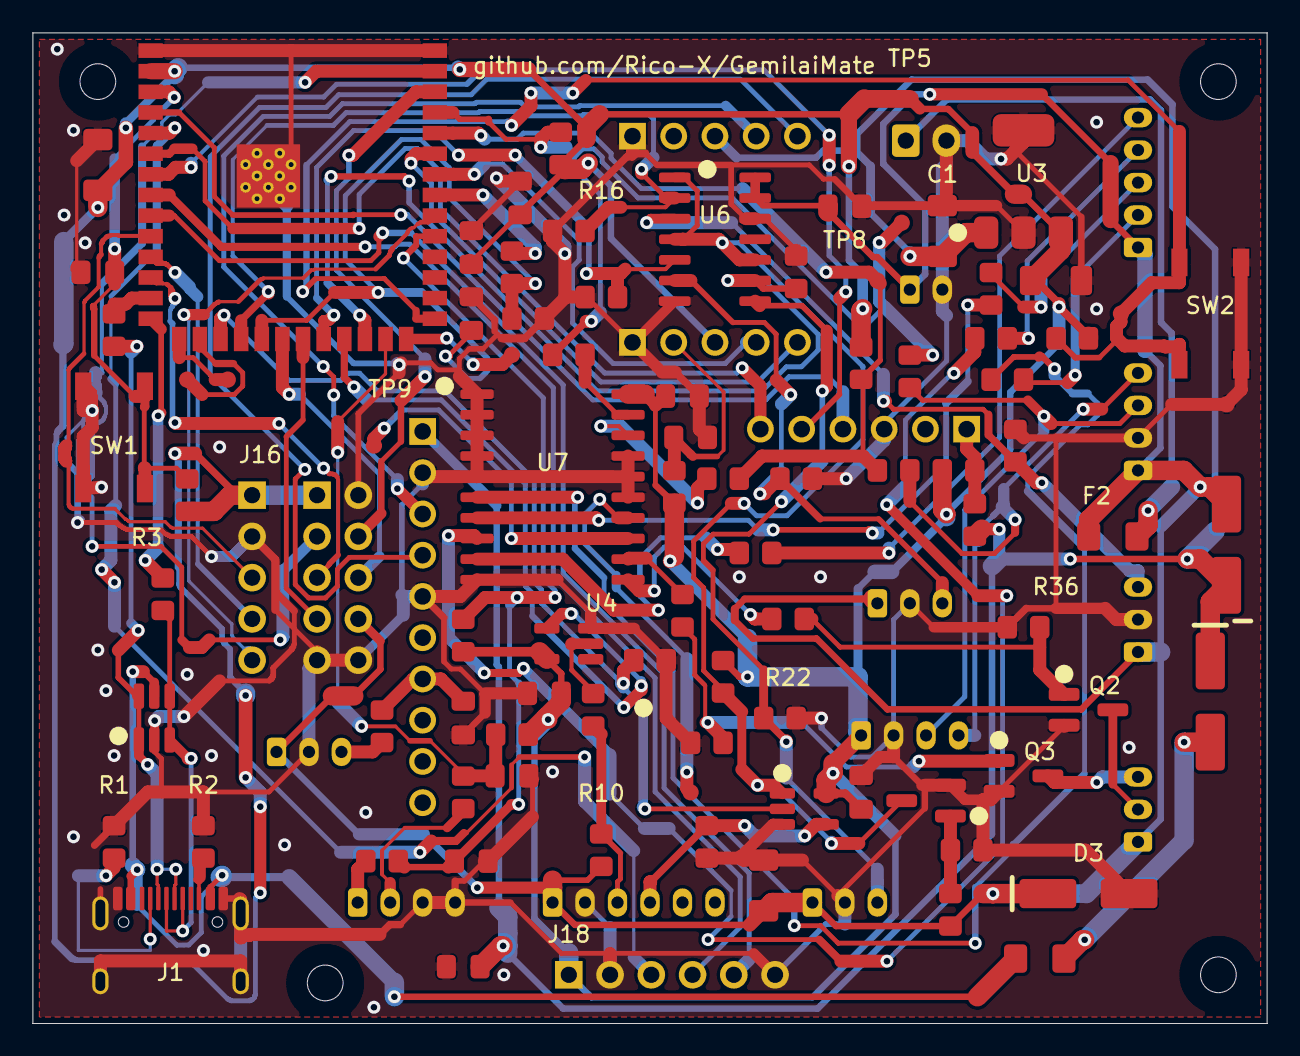
[picture p39: board gemilaimate-compact.kicad_pcb from above]

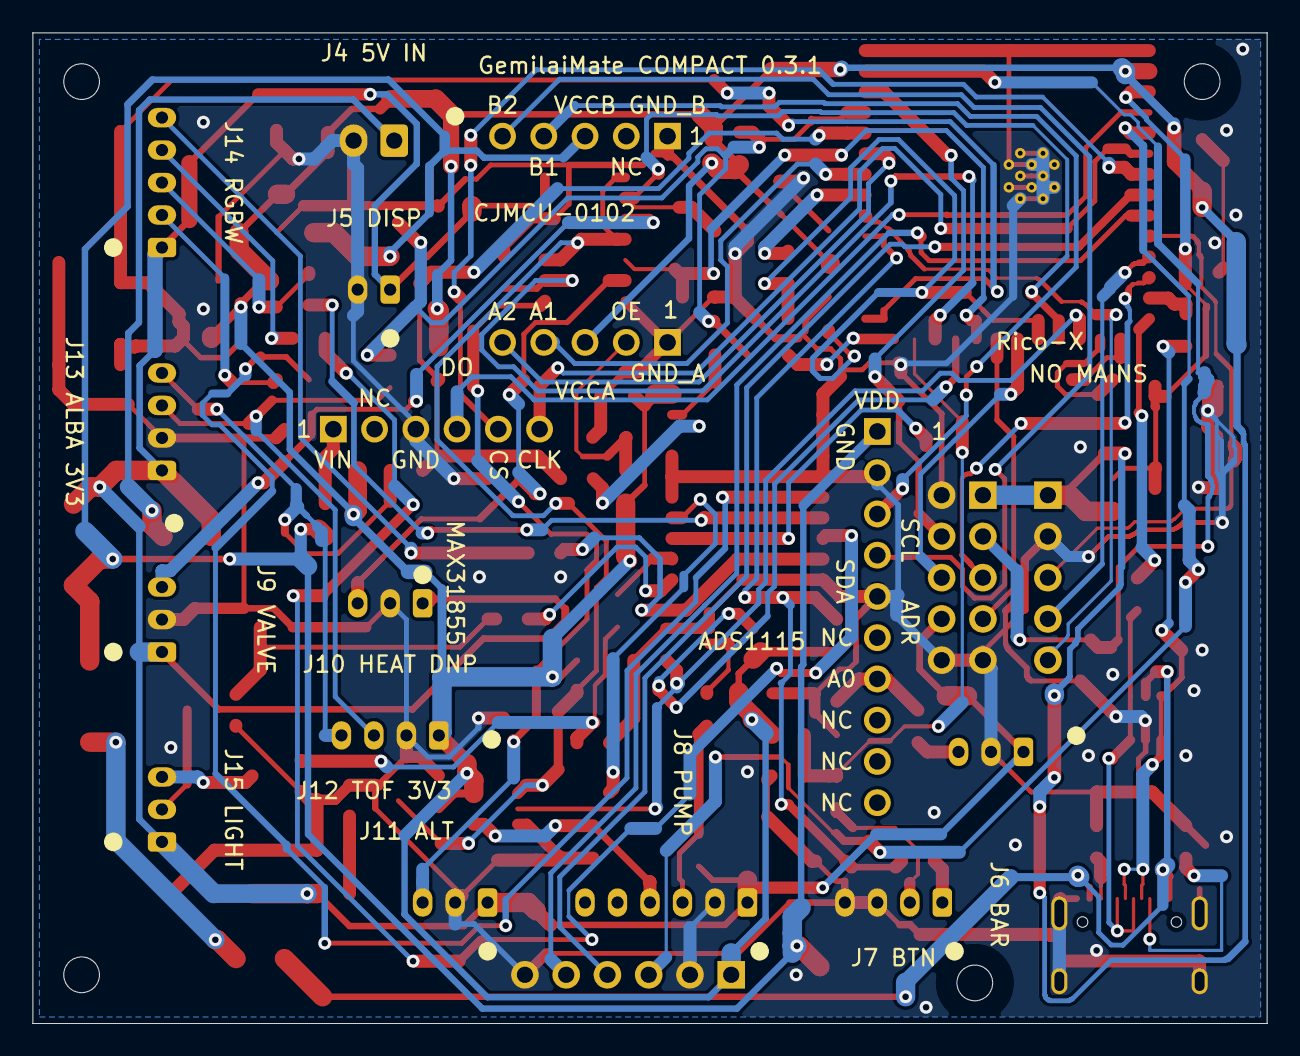
[picture p40: board gemilaimate-compact.kicad_pcb from below]

Board: 2 copper layers, 76.0 x 61.0 mm, 110 parts (12 on the bottom side), 81 nets.

Other parts of the board:
H1, H2, H3, H4: M2 NYLON
