rico-x/GemilaiMate/hardware/shield/gemilaimate-shield.kicad_pcb

## KiCad design hardware/shield/gemilaimate-shield.kicad_pcb (2026-10-29)

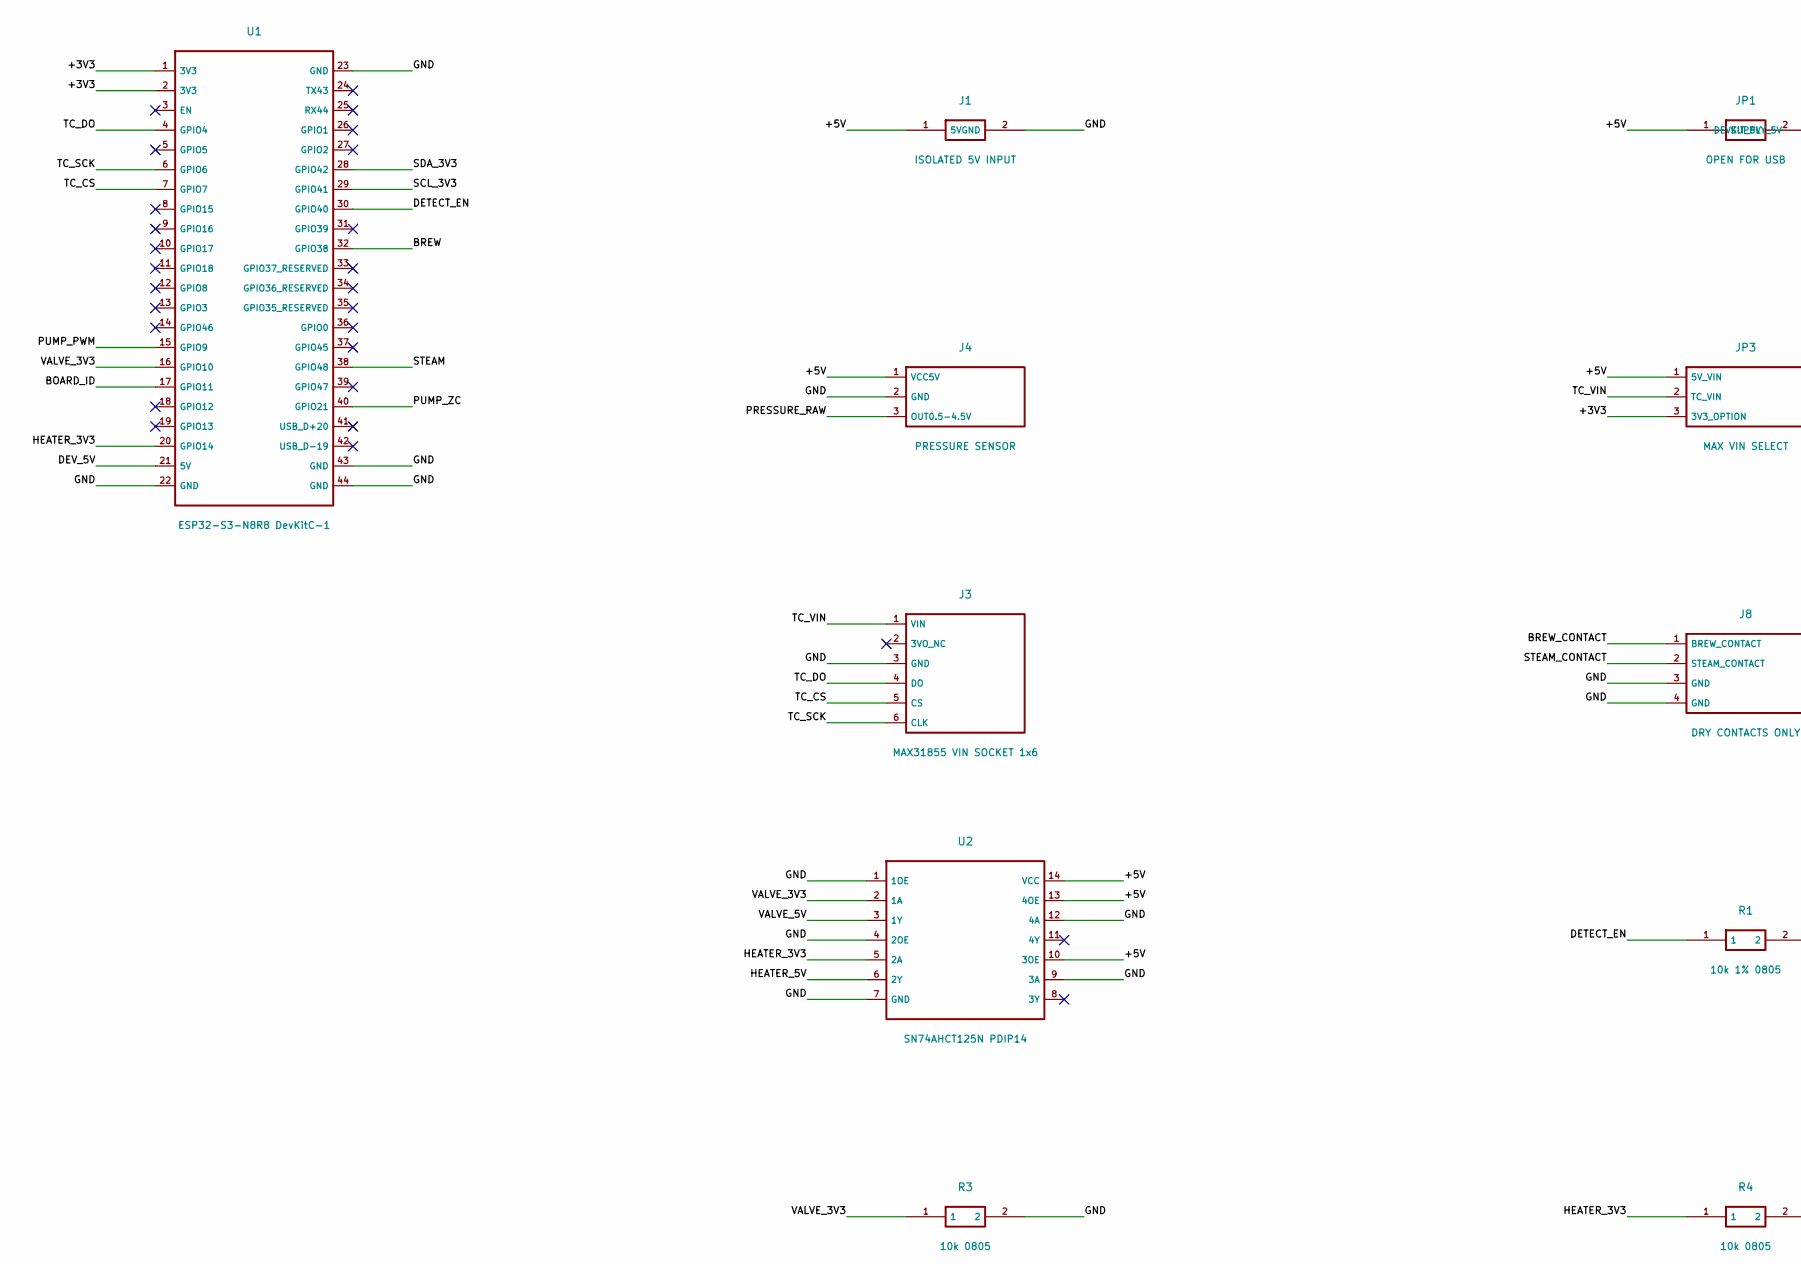
[picture p41: schematic gemilaimate-shield.kicad_sch, GemilaiMate - LOW VOLTAGE carrier / Rico-X, part in row 1, column 1]

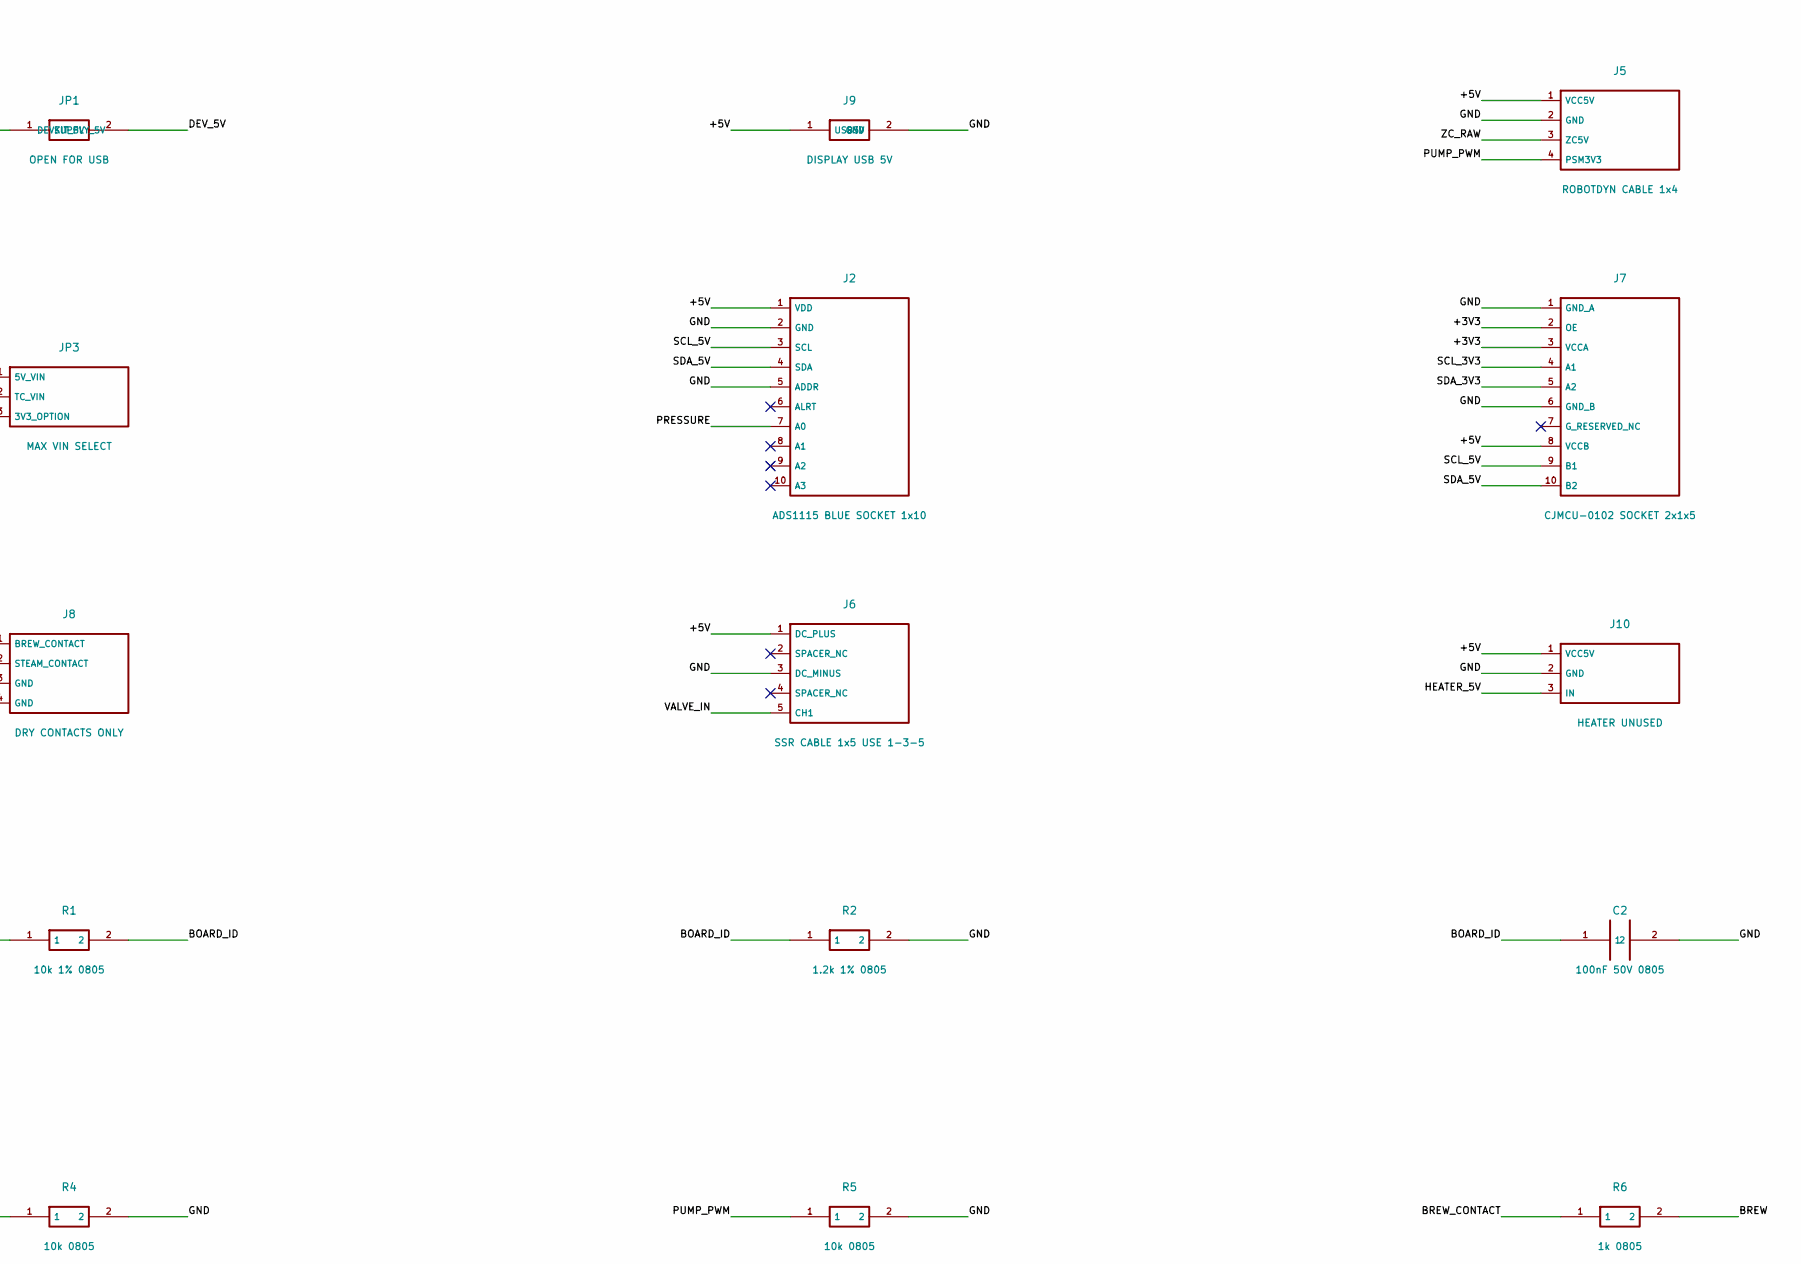
[picture p42: schematic gemilaimate-shield.kicad_sch, GemilaiMate - LOW VOLTAGE carrier / Rico-X, part in row 1, column 2]

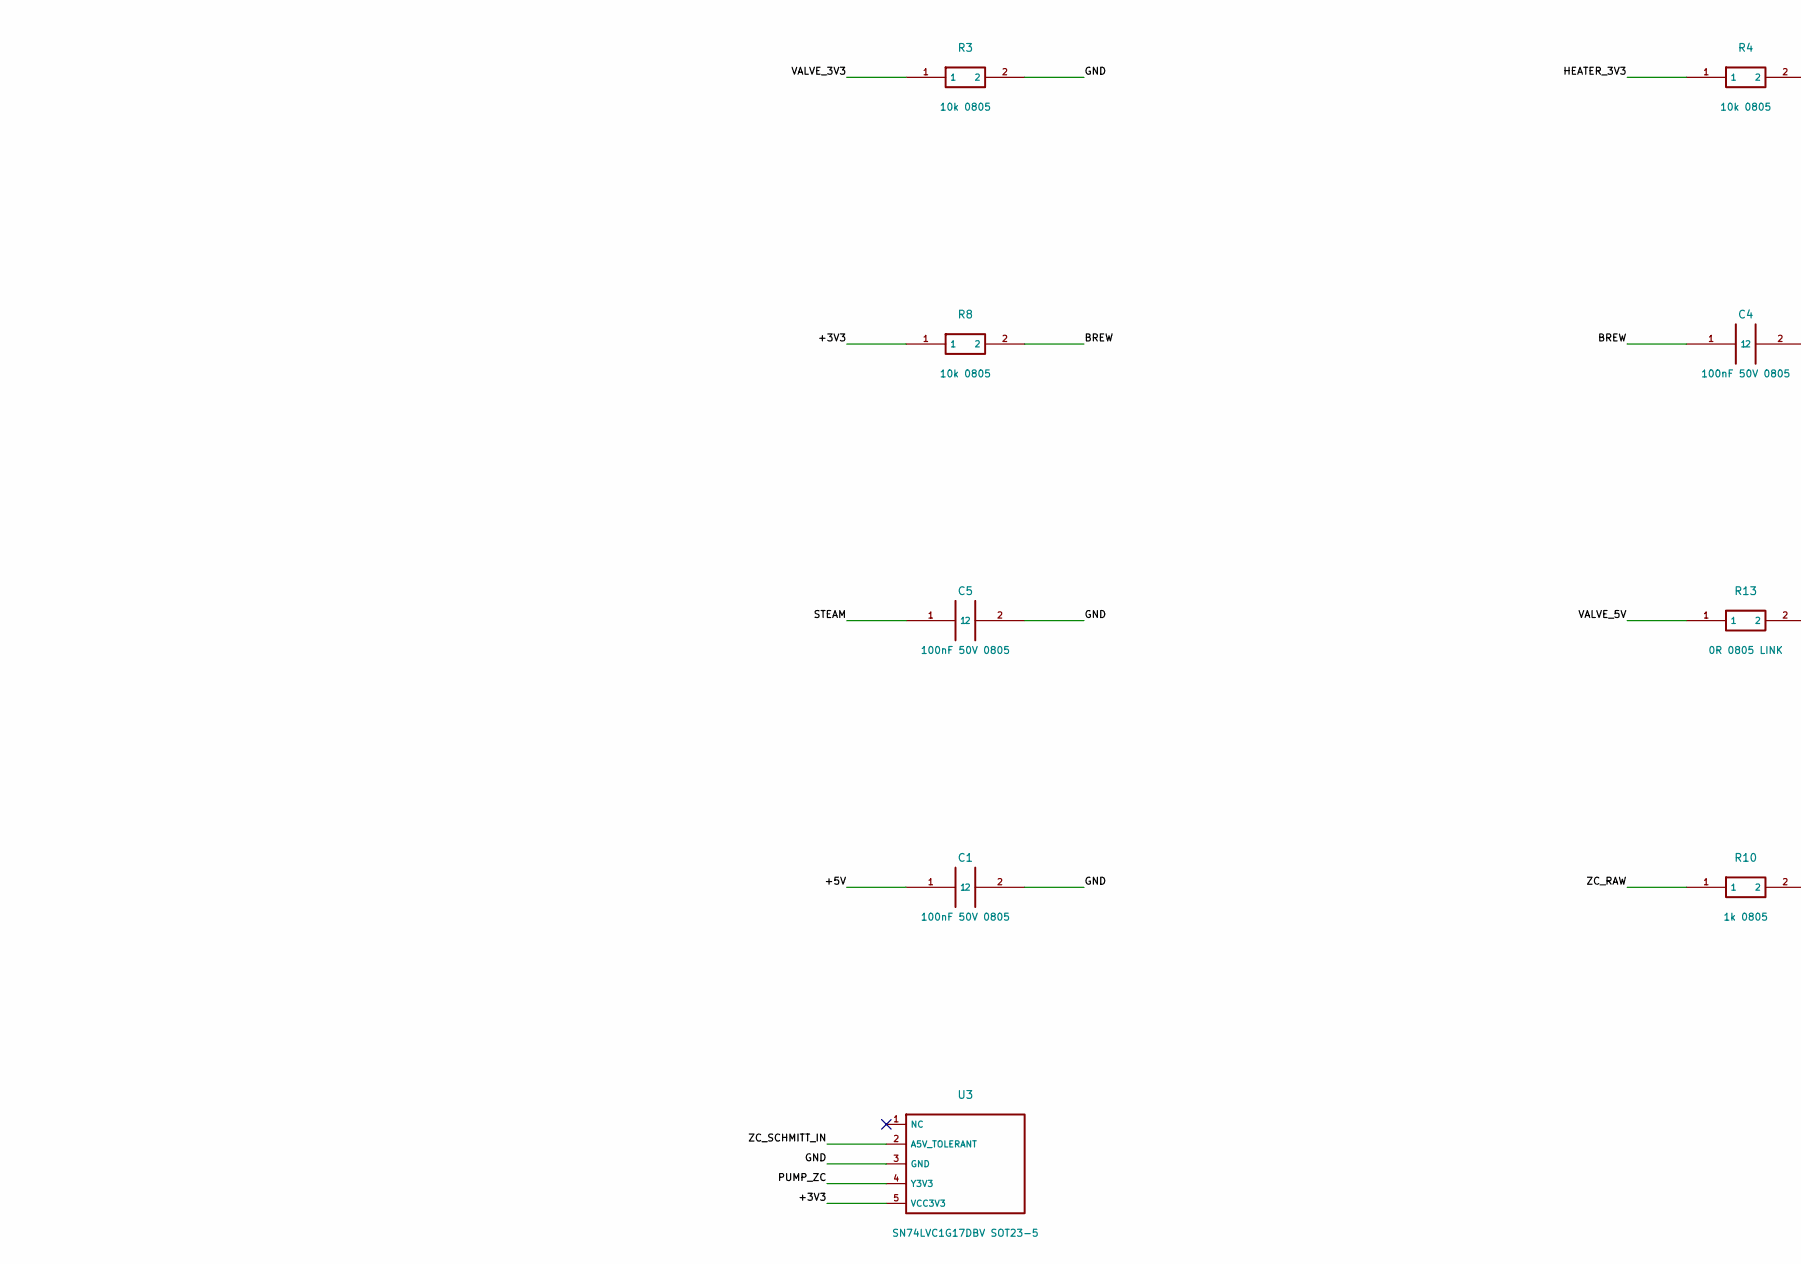
[picture p43: schematic gemilaimate-shield.kicad_sch, GemilaiMate - LOW VOLTAGE carrier / Rico-X, part in row 2, column 1]

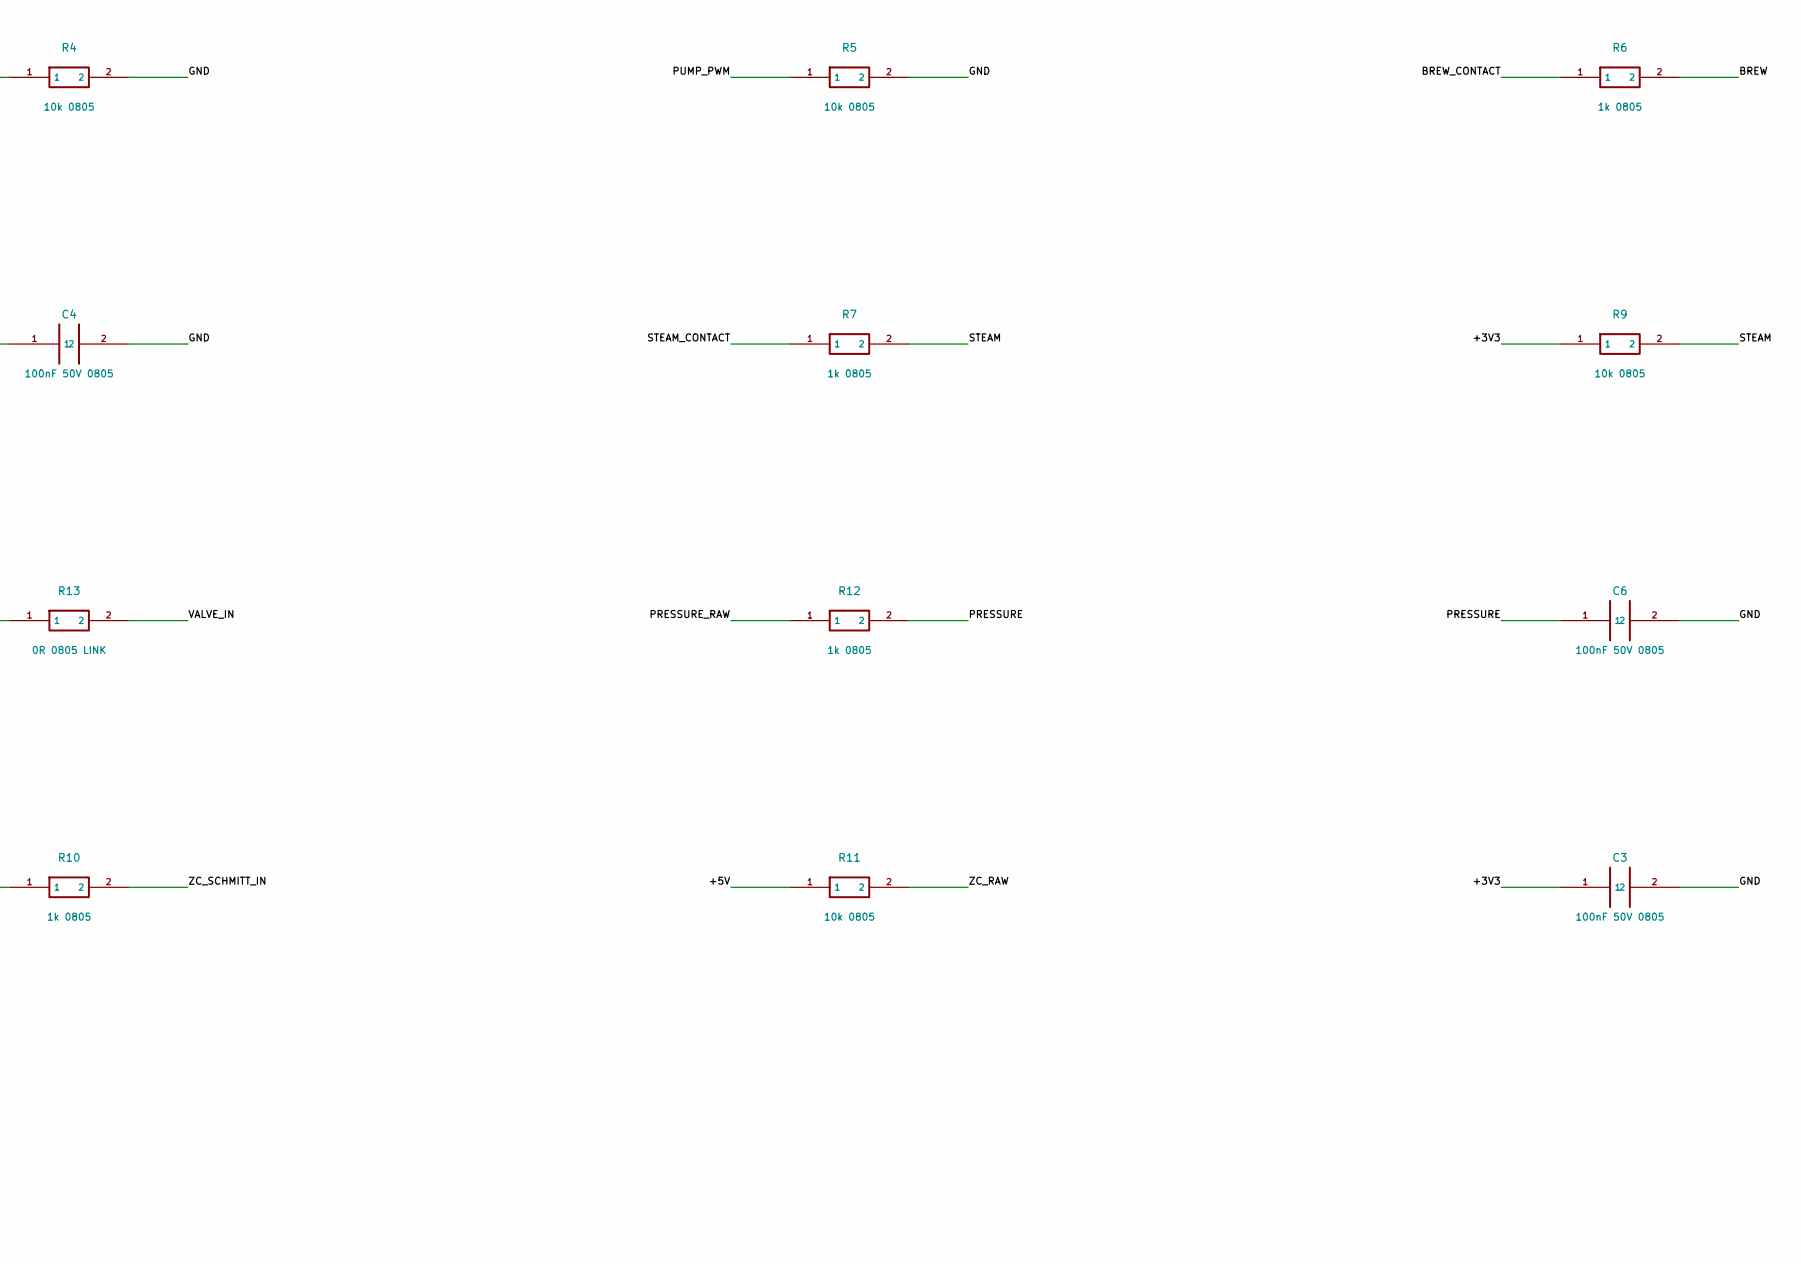
[picture p44: schematic gemilaimate-shield.kicad_sch, GemilaiMate - LOW VOLTAGE carrier / Rico-X, part in row 2, column 2]

Parts:
C1: 100nF 50V 0805; C1_C_0805_2012Metric
C2: 100nF 50V 0805; C2_C_0805_2012Metric
C3: 100nF 50V 0805; C3_C_0805_2012Metric
C4: 100nF 50V 0805; C4_C_0805_2012Metric
C5: 100nF 50V 0805; C5_C_0805_2012Metric
C6: 100nF 50V 0805; C6_C_0805_2012Metric
J1: ISOLATED 5V INPUT; J1_header
J2: ADS1115 BLUE SOCKET 1x10; J2_socket_shield
J3: MAX31855 VIN SOCKET 1x6; J3_socket_shield
J4: PRESSURE SENSOR; J4_header
J5: ROBOTDYN CABLE 1x4; J5_socket_shield
J6: SSR CABLE 1x5 USE 1-3-5; J6_socket_shield
J7: CJMCU-0102 SOCKET 2x1x5; J7_socket_shield
J8: DRY CONTACTS ONLY; J8_header
J9: DISPLAY USB 5V; J9_header
J10: HEATER UNUSED; J10_header
JP1: OPEN FOR USB; JP1_header
JP3: MAX VIN SELECT; JP3_header
R1: 10k 1% 0805; R1_R_0805_2012Metric
R2: 1.2k 1% 0805; R2_R_0805_2012Metric
R3: 10k 0805; R3_R_0805_2012Metric
R4: 10k 0805; R4_R_0805_2012Metric
R5: 10k 0805; R5_R_0805_2012Metric
R6: 1k 0805; R6_R_0805_2012Metric
R7: 1k 0805; R7_R_0805_2012Metric
R8: 10k 0805; R8_R_0805_2012Metric
R9: 10k 0805; R9_R_0805_2012Metric
R10: 1k 0805; R10_R_0805_2012Metric
R11: 10k 0805; R11_R_0805_2012Metric
R12: 1k 0805; R12_R_0805_2012Metric
R13: 0R 0805 LINK; R13_R_0805_2012Metric
U1: ESP32-S3-N8R8 DevKitC-1; U1_ESP32
U2: SN74AHCT125N PDIP14; U2_DIP14
U3: SN74LVC1G17DBV SOT23-5; U3_SOT-23-5

Connections:
/+3V3: C3.1, J7.2 (OE), J7.3 (VCCA), JP3.3 (3V3_OPTION), R8.1, R9.1, U1.1 (3V3), U1.2 (3V3), U3.5 (VCC3V3)
/+5V: C1.1, J1.1 (5V), J2.1 (VDD), J4.1 (VCC5V), J5.1 (VCC5V), J6.1 (DC_PLUS), J7.8 (VCCB), J9.1 (USB5V), J10.1 (VCC5V), JP1.1 (SUPPLY_5V), JP3.1 (5V_VIN), R11.1, U2.10 (3OE), U2.13 (4OE), U2.14 (VCC)
/BOARD_ID: C2.1, R1.2, R2.1, U1.17 (GPIO11)
/BREW: C4.1, R6.2, R8.2, U1.32 (GPIO38)
/BREW_CONTACT: J8.1 (BREW_CONTACT), R6.1
/DETECT_EN: R1.1, U1.30 (GPIO40)
/DEV_5V: JP1.2 (DEVKIT_5V), U1.21 (5V)
/GND: C1.2, C2.2, C3.2, C4.2, C5.2, C6.2, J1.2 (GND), J2.2 (GND), J2.5 (ADDR), J3.3 (GND), J4.2 (GND), J5.2 (GND), J6.3 (DC_MINUS), J7.1 (GND_A), J7.6 (GND_B), J8.3 (GND), J8.4 (GND), J9.2 (GND), J10.2 (GND), R2.2, R3.2, R4.2, R5.2, U1.22 (GND), U1.23 (GND), U1.43 (GND), U1.44 (GND), U2.1 (1OE), U2.4 (2OE), U2.7 (GND), U2.9 (3A), U2.12 (4A), U3.3 (GND)
/HEATER_3V3: R4.1, U1.20 (GPIO14), U2.5 (2A)
/HEATER_5V: J10.3 (IN), U2.6 (2Y)
/PRESSURE: C6.1, J2.7 (A0), R12.2
/PRESSURE_RAW: J4.3 (OUT0.5-4.5V), R12.1
/PUMP_PWM: J5.4 (PSM3V3), R5.1, U1.15 (GPIO9)
/PUMP_ZC: U1.40 (GPIO21), U3.4 (Y3V3)
/SCL_3V3: J7.4 (A1), U1.29 (GPIO41)
/SCL_5V: J2.3 (SCL), J7.9 (B1)
/SDA_3V3: J7.5 (A2), U1.28 (GPIO42)
/SDA_5V: J2.4 (SDA), J7.10 (B2)
/STEAM: C5.1, R7.2, R9.2, U1.38 (GPIO48)
/STEAM_CONTACT: J8.2 (STEAM_CONTACT), R7.1
/TC_CS: J3.5 (CS), U1.7 (GPIO7)
/TC_DO: J3.4 (DO), U1.4 (GPIO4)
/TC_SCK: J3.6 (CLK), U1.6 (GPIO6)
/TC_VIN: J3.1 (VIN), JP3.2 (TC_VIN)
/VALVE_3V3: R3.1, U1.16 (GPIO10), U2.2 (1A)
/VALVE_5V: R13.1, U2.3 (1Y)
/VALVE_IN: J6.5 (CH1), R13.2
/ZC_RAW: J5.3 (ZC5V), R10.1, R11.2
/ZC_SCHMITT_IN: R10.2, U3.2 (A5V_TOLERANT)
