rico-x/GemilaiMate/hardware/shield/gemilaimate-shield.kicad_pcb

## KiCad design hardware/shield/gemilaimate-shield.kicad_pcb (continued)

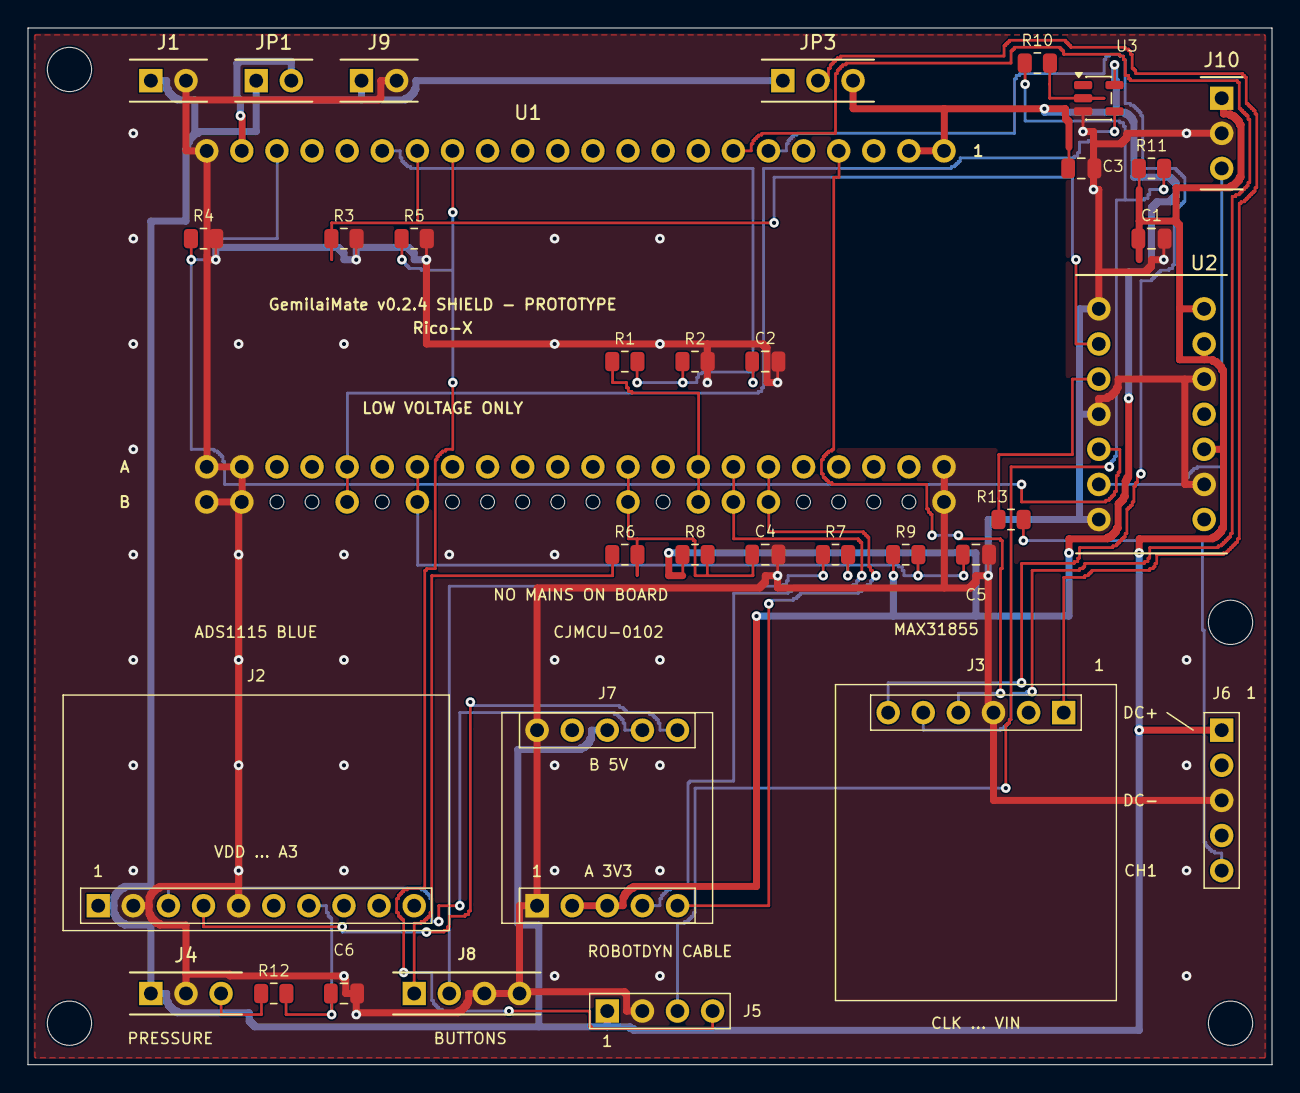
[picture p45: board gemilaimate-shield.kicad_pcb from above]

Board: 2 copper layers, 90.0 x 75.0 mm, 36 parts (0 on the bottom side), 29 nets.

Other parts of the board:
H1, H2: M3
