rico-x/GemilaiMate/firmware/src/display/plugins/WebUIPlugin.cpp

#include "WebUIPlugin.h"
#include <DNSServer.h>
#include <LittleFS.h>
#include <SD_MMC.h>
#include <algorithm>
#include <display/core/Controller.h>
#include <display/core/ProfileManager.h>
#include <display/models/profile.h>
#include <display/plugins/BLEScalePlugin.h>
#include <display/plugins/ShotHistoryPlugin.h>
#include <display/webassets/web_ui_manifest.h>
#include <esp32-hal-psram.h>
#include <esp_core_dump.h>
#include <esp_err.h>
#include <esp_heap_caps.h>
#include <esp_partition.h>
#include <mbedtls/platform.h>
#include <vector>
#include <version.h>

static WebUIPlugin *g_webUIPlugin = nullptr;

// Route mbedTLS allocations to PSRAM.
static void *mbedtlsPsramCalloc(size_t n, size_t size) { // NOSONAR
    void *p = heap_caps_calloc(n, size, MALLOC_CAP_SPIRAM | MALLOC_CAP_8BIT);
    if (p == nullptr) {
        p = heap_caps_calloc(n, size, MALLOC_CAP_INTERNAL | MALLOC_CAP_8BIT);
    }
    return p;
}
static void mbedtlsPsramFree(void *p) { heap_caps_free(p); } // NOSONAR

WebUIPlugin::WebUIPlugin() : server(80) { g_webUIPlugin = this; }

void WebUIPlugin::setup(Controller *_controller, PluginManager *_pluginManager) {
    // Redirect mbedTLS allocations to PSRAM before any TLS (OTA) handshake runs, so the
    // ~32 KB handshake buffers don't exhaust the scarce internal-DRAM pool. See mbedtlsPsramCalloc.
    (void)mbedtls_platform_set_calloc_free(mbedtlsPsramCalloc, mbedtlsPsramFree);
    this->controller = _controller;
    this->profileManager = _controller->getProfileManager();
    this->pluginManager = _pluginManager;
    pluginManager->on("controller:wifi:connect", [this](Event const &event) {
        apMode = event.getInt("AP");
        start();
    });
    // Intentionally do NOT stop the server on a WiFi disconnect: the listen
    // socket survives a reconnect, and tearing it down only to rebind moments
    // later races AsyncTCP's async close (bind: -8) and churns sockets in the
    // recovery path. The server keeps listening; clients reconnect on their own.
    pluginManager->on("controller:wifi:disconnect", [this](Event const &) {
        wsHandler.cleanupClients(); // drop dead websocket clients; keep the listener up
    });
    pluginManager->on("controller:ready", [this](Event const &) {
        updateOTAStatus(BUILD_PROJECT_VERSION);
    });
    wsHandler.setup(controller, pluginManager);
    wsHandler.onOtaSettings([this](JsonDocument &request) { handleOTASettings(request); });
    wsHandler.onOtaStart([this](JsonDocument &request) { handleOTAStart(request); });
    wsHandler.setUpdateAvailableProvider([] { return false; });

    setupServer();
}

void WebUIPlugin::loop() {
    if (!serverRunning) {
        return;
    }
    const unsigned long now = millis();
    wsHandler.loop(now);
    if (now > lastDns + DNS_PERIOD && dnsServer != nullptr) {
        lastDns = now;
        dnsServer->processNextRequest();
    }
}

// Linear lookup over the embedded asset table (~60 entries) — a couple of
// strcmps per request, negligible next to the network round-trip.
static const WebAsset *findWebAsset(const String &path) {
    for (size_t i = 0; i < WEB_ASSETS_COUNT; i++) {
        if (path == WEB_ASSETS[i].path) {
            return &WEB_ASSETS[i];
        }
    }
    return nullptr;
}

void WebUIPlugin::serveWebAsset(AsyncWebServerRequest *request) {
    String path = request->url();
    if (path.isEmpty() || path == "/") {
        path = WEB_UI_INDEX_PATH;
    }

    const WebAsset *asset = findWebAsset(path);
    if (asset == nullptr && !path.startsWith("/assets/")) {
        // SPA client-side routes (e.g. /settings, /profiles) aren't real files —
        // fall back to index.html. A miss under /assets/ is a genuine 404, not a
        // route, so it is not rewritten.
        asset = findWebAsset(WEB_UI_INDEX_PATH);
    }
    if (asset == nullptr) {
        request->send(404, "text/plain", "Not found");
        return;
    }

    // Serve straight from the memory-mapped flash blob — no copy into RAM, no
    // filesystem read. AsyncProgmemResponse streams from the pointer in chunks.
    AsyncWebServerResponse *response =
        request->beginResponse(200, asset->contentType, gWebUiBlobStart + asset->offset, asset->length);
    if (asset->gzip) {
        response->addHeader("Content-Encoding", "gzip");
    }
    // Content-hashed build assets (/assets/<hash>.js) never change for a given URL — cache them forever. index.html and
    // other unhashed files must revalidate so a new build is picked up after an update. [GM-83]
    if (path.startsWith("/assets/")) {
        response->addHeader("Cache-Control", "public, max-age=31536000, immutable");
    } else {
        response->addHeader("Cache-Control", "no-cache");
    }
    request->send(response);
}

void WebUIPlugin::setupServer() {
    server.on("/connecttest.txt", [](AsyncWebServerRequest *request) {
        request->redirect("http://logout.net");
    }); // windows 11 captive portal workaround
    server.on("/wpad.dat", [](AsyncWebServerRequest *request) {
        request->send(404);
    }); // Honestly don't understand what this is but a 404 stops win 10 keep calling this repeatedly and panicking the esp32
        // :)
    server.on("/generate_204",
              [](AsyncWebServerRequest *request) { request->redirect(LOCAL_URL); }); // android captive portal redirect
    server.on("/redirect", [](AsyncWebServerRequest *request) { request->redirect(LOCAL_URL); });            // microsoft redirect
    server.on("/hotspot-detect.html", [](AsyncWebServerRequest *request) { request->redirect(LOCAL_URL); }); // apple call home
    server.on("/canonical.html",
              [](AsyncWebServerRequest *request) { request->redirect(LOCAL_URL); });       // firefox captive portal call home
    server.on("/success.txt", [](AsyncWebServerRequest *request) { request->send(200); }); // firefox captive portal call home
    server.on("/ncsi.txt", [](AsyncWebServerRequest *request) { request->redirect(LOCAL_URL); }); // windows call home
    server.on("/api/settings", [this](AsyncWebServerRequest *request) { handleSettings(request); });
    server.on("/api/status", [this](AsyncWebServerRequest *request) {
        AsyncResponseStream *response = request->beginResponseStream("application/json");
        JsonDocument doc(&psramAllocator);
        doc["mode"] = controller->getMode();
        doc["tt"] = controller->getTargetTemp();
        doc["ct"] = controller->getCurrentTemp();
        serializeJson(doc, *response);
        request->send(response);
    });
    server.on("/api/scales/list", [this](AsyncWebServerRequest *request) { handleBLEScaleList(request); });
    server.on("/api/scales/connect", [this](AsyncWebServerRequest *request) { handleBLEScaleConnect(request); });
    server.on("/api/scales/scan", [this](AsyncWebServerRequest *request) { handleBLEScaleScan(request); });
    server.on("/api/scales/info", [this](AsyncWebServerRequest *request) { handleBLEScaleInfo(request); });
    FS *fs = &LittleFS;
    if (controller->isSDCard()) {
        fs = &SD_MMC;
    }
    server
        .on(AsyncURIMatcher::prefix("/api/history/"), HTTP_ANY,
            [](AsyncWebServerRequest *request) { request->send(503, "text/plain", "Update in progress"); })
        .setFilter([this](AsyncWebServerRequest *) { return controller->isUpdating(); });
    server.serveStatic("/api/history/", *fs, "/h/").setCacheControl("no-store");
    server.on("/api/history/index.bin", HTTP_GET, [this, fs](AsyncWebServerRequest *request) {
        // Serve the binary index file directly
        if (fs->exists("/h/index.bin")) {
            request->send(*fs, "/h/index.bin", "application/octet-stream");
        } else {
            request->send(404, "text/plain", "Index not found");
        }
    });
    server.on("/api/history/recent.bin", HTTP_GET, [this](AsyncWebServerRequest *request) {
        // The most recent non-deleted shots, newest first, as a regular shot
        // index (SIDX header + entries) — same binary format as index.bin,
        // just truncated, so clients reuse the index.bin parser.
        constexpr long MAX_RECENT_LIMIT = 50;
        long limit = 8;
        if (request->hasArg("limit")) {
            limit = constrain(request->arg("limit").toInt(), 1L, MAX_RECENT_LIMIT);
        }

        auto *entries = static_cast<ShotIndexEntry *>(ps_malloc(limit * sizeof(ShotIndexEntry)));
        if (entries == nullptr) {
            request->send(500, "text/plain", "Out of memory");
            return;
        }
        size_t count = ShotHistory.readRecentEntries(entries, limit);

        ShotIndexHeader header{};
        header.magic = SHOT_INDEX_MAGIC;
        header.version = SHOT_INDEX_VERSION;
        header.entrySize = SHOT_INDEX_ENTRY_SIZE;
        header.entryCount = count;
        header.nextId = 0; // meaningless for a partial view

        AsyncResponseStream *response = request->beginResponseStream("application/octet-stream");
        response->addHeader("Cache-Control", "no-store");
        response->write(reinterpret_cast<const uint8_t *>(&header), sizeof(header));
        response->write(reinterpret_cast<const uint8_t *>(entries), count * sizeof(ShotIndexEntry));
        free(entries);
        request->send(response);
    });
    server.on("/api/core-dump", HTTP_GET, [this](AsyncWebServerRequest *request) { handleCoreDumpDownload(request); });
    // The web UI is embedded in firmware flash and served from the memory-mapped blob (see serveWebAsset). It is no
    // longer in LittleFS, so OTA never touches the partition holding profiles/shots. The catch-all onNotFound handles
    // every path not claimed by an explicit server.on()/api route above. [GM-106]
    server.onNotFound([this](AsyncWebServerRequest *request) { serveWebAsset(request); });
    wsHandler.attach(server);
}

void WebUIPlugin::start() {
    if (serverRunning) {
        // Already listening. The 0.0.0.0:80 listen socket survives a WiFi
        // reconnect, so re-running end()+begin() only races AsyncTCP's async
        // socket close and fails to rebind ("bind: -8, port in use"). A transient
        // STA reconnect needs nothing done here.
        return;
    }
    server.begin();
    ESP_LOGI("WebUIPlugin", "Started webserver");
    if (apMode) {
        dnsServer = new DNSServer();
        dnsServer->setTTL(3600);
        dnsServer->start(53, "*", WIFI_AP_IP);
        ESP_LOGI("WebUIPlugin", "Started catchall DNS for captive portal");
    }
    lastUpdateCheck = millis();
    serverRunning = true;
}

void WebUIPlugin::stop() {
    if (!serverRunning)
        return;
    wsHandler.closeAll();
    server.end();
    if (dnsServer != nullptr) {
        dnsServer->stop();
        delete dnsServer;
        dnsServer = nullptr;
    }
    serverRunning = false;
    ESP_LOGI("WebUIPlugin", "WebUIPlugin stopped (wifi disconnected)");
}

void WebUIPlugin::handleOTASettings(JsonDocument &request) {
    (void)request;
    updateOTAStatus("Manual USB update");
}

void WebUIPlugin::handleOTAStart(JsonDocument &request) {
    (void)request;
    updating = false;
    updateOTAStatus("Manual USB update");
}

// Booleans are only touched when present, so a partial POST keeps the rest (GM-214).
static bool parseBoolArg(const String &value) {
    return !(value.isEmpty() || value == "0" || value.equalsIgnoreCase("false") || value.equalsIgnoreCase("off"));
}

void WebUIPlugin::handleSettings(AsyncWebServerRequest *request) const {
    if (request->method() == HTTP_POST) {
        controller->getSettings().batchUpdate([request](Settings *settings) {
            if (request->hasArg("startupMode"))
                settings->setStartupMode(request->arg("startupMode") == "brew" ? MODE_BREW : MODE_STANDBY);
            if (request->hasArg("startupProfile"))
                settings->setStartupProfile(request->arg("startupProfile"));
            if (request->hasArg("targetSteamTemp"))
                settings->setTargetSteamTemp(request->arg("targetSteamTemp").toInt());
            if (request->hasArg("targetWaterTemp"))
                settings->setTargetWaterTemp(request->arg("targetWaterTemp").toInt());
            if (request->hasArg("temperatureOffset"))
                settings->setTemperatureOffset(request->arg("temperatureOffset").toInt());
            if (request->hasArg("pressureOffset"))
                settings->setPressureOffset(request->arg("pressureOffset").toFloat());
            if (request->hasArg("pressureScaling"))
                settings->setPressureScaling(request->arg("pressureScaling").toFloat());
            if (request->hasArg("pid"))
                settings->setPid(request->arg("pid"));
            if (request->hasArg("pumpModelCoeffs"))
                settings->setPumpModelCoeffs(request->arg("pumpModelCoeffs"));
            if (request->hasArg("pumpSlipCoeffs"))
                settings->setPumpSlipCoeffs(request->arg("pumpSlipCoeffs"));
            if (request->hasArg("wifiSsid"))
                settings->setWifiSsid(request->arg("wifiSsid"));
            if (request->hasArg("mdnsName"))
                settings->setMdnsName(request->arg("mdnsName"));
            if (request->hasArg("wifiPassword") && request->arg("wifiPassword") != "---unchanged---")
                settings->setWifiPassword(request->arg("wifiPassword"));
            if (request->hasArg("apPassword") && request->arg("apPassword").length() >= WIFI_AP_PASSWORD_MIN_LENGTH)
                settings->setWifiApPassword(request->arg("apPassword"));
            if (request->hasArg("homekit"))
                settings->setHomekit(parseBoolArg(request->arg("homekit")));
            if (request->hasArg("boilerFillActive"))
                settings->setBoilerFillActive(parseBoolArg(request->arg("boilerFillActive")));
            if (request->hasArg("startupFillTime"))
                settings->setStartupFillTime(request->arg("startupFillTime").toInt() * 1000);
            if (request->hasArg("steamFillTime"))
                settings->setSteamFillTime(request->arg("steamFillTime").toInt() * 1000);
            if (request->hasArg("smartGrindActive"))
                settings->setSmartGrindActive(parseBoolArg(request->arg("smartGrindActive")));
            if (request->hasArg("smartGrindIp"))
                settings->setSmartGrindIp(request->arg("smartGrindIp"));
            if (request->hasArg("smartGrindMode"))
                settings->setSmartGrindMode(request->arg("smartGrindMode").toInt());
            if (request->hasArg("homeAssistant"))
                settings->setHomeAssistant(parseBoolArg(request->arg("homeAssistant")));
            if (request->hasArg("haUser"))
                settings->setHomeAssistantUser(request->arg("haUser"));
            if (request->hasArg("haPassword"))
                settings->setHomeAssistantPassword(request->arg("haPassword"));
            if (request->hasArg("haIP"))
                settings->setHomeAssistantIP(request->arg("haIP"));
            if (request->hasArg("haPort"))
                settings->setHomeAssistantPort(request->arg("haPort").toInt());
            if (request->hasArg("haTopic"))
                settings->setHomeAssistantTopic(request->arg("haTopic"));
            if (request->hasArg("momentaryButtons"))
                settings->setMomentaryButtons(parseBoolArg(request->arg("momentaryButtons")));
            if (request->hasArg("flushDuration"))
                settings->setFlushDuration(request->arg("flushDuration").toInt());
            if (request->hasArg("warnWaterLevel"))
                settings->setWarnWaterLevel(request->arg("warnWaterLevel").toInt());
            if (request->hasArg("warnFlush"))
                settings->setWarnFlush(request->arg("warnFlush").toInt());
            if (request->hasArg("warnSteamSwitch"))
                settings->setWarnSteamSwitch(request->arg("warnSteamSwitch").toInt());
            if (request->hasArg("warnScaleConnected"))
                settings->setWarnScaleConnected(request->arg("warnScaleConnected").toInt());
            if (request->hasArg("warnScaleBattery"))
                settings->setWarnScaleBattery(request->arg("warnScaleBattery").toInt());
            if (request->hasArg("warnTemperature"))
                settings->setWarnTemperature(request->arg("warnTemperature").toInt());
            if (request->hasArg("delayAdjust"))
                settings->setDelayAdjust(parseBoolArg(request->arg("delayAdjust")));
            if (request->hasArg("brewDelay"))
                settings->setBrewDelay(request->arg("brewDelay").toDouble());
            if (request->hasArg("grindDelay"))
                settings->setGrindDelay(request->arg("grindDelay").toDouble());
            if (request->hasArg("timezone"))
                settings->setTimezone(request->arg("timezone"));
            if (request->hasArg("clock24hFormat"))
                settings->setClockFormat(parseBoolArg(request->arg("clock24hFormat")));
            if (request->hasArg("standbyTimeout"))
                settings->setStandbyTimeout(request->arg("standbyTimeout").toInt() * 1000);
            if (request->hasArg("mainBrightness"))
                settings->setMainBrightness(request->arg("mainBrightness").toInt());
            if (request->hasArg("standbyBrightness"))
                settings->setStandbyBrightness(request->arg("standbyBrightness").toInt());
            if (request->hasArg("standbyBrightnessTimeout"))
                settings->setStandbyBrightnessTimeout(request->arg("standbyBrightnessTimeout").toInt() * 1000);
            if (request->hasArg("steamPumpPercentage"))
                settings->setSteamPumpPercentage(request->arg("steamPumpPercentage").toFloat());
            if (request->hasArg("steamPumpCutoff"))
                settings->setSteamPumpCutoff(request->arg("steamPumpCutoff").toFloat());
            if (request->hasArg("themeMode"))
                settings->setThemeMode(request->arg("themeMode").toInt());
            if (request->hasArg("sunriseIdle"))
                settings->setSunriseIdle(request->arg("sunriseIdle"));
            if (request->hasArg("sunriseActive"))
                settings->setSunriseActive(request->arg("sunriseActive"));
            if (request->hasArg("sunriseFinished"))
                settings->setSunriseFinished(request->arg("sunriseFinished"));
            if (request->hasArg("sunriseError"))
                settings->setSunriseError(request->arg("sunriseError"));
            if (request->hasArg("sunriseExtBrightness"))
                settings->setSunriseExtBrightness(request->arg("sunriseExtBrightness").toInt());
            if (request->hasArg("emptyTankDistance"))
                settings->setEmptyTankDistance(request->arg("emptyTankDistance").toInt());
            if (request->hasArg("fullTankDistance"))
                settings->setFullTankDistance(request->arg("fullTankDistance").toInt());
            if (request->hasArg("altRelayFunction"))
                settings->setAltRelayFunction(request->arg("altRelayFunction").toInt());
            if (request->hasArg("buttonBehavior"))
                settings->setButtonBehaviorList(explode(request->arg("buttonBehavior"), ','));
            if (request->hasArg("commutationGain"))
                settings->setCommutationGain(request->arg("commutationGain").toFloat());
            if (request->hasArg("convergenceGain"))
                settings->setConvergenceGain(request->arg("convergenceGain").toFloat());
            if (request->hasArg("integralGain"))
                settings->setIntegralGain(request->arg("integralGain").toFloat());
            if (request->hasArg("maxPumpPower"))
                settings->setMaxPumpPower(request->arg("maxPumpPower").toFloat());
            if (request->hasArg("savedScale"))
                settings->setSavedScale(request->arg("savedScale"));
            if (request->hasArg("autowakeupEnabled"))
                settings->setAutoWakeupEnabled(parseBoolArg(request->arg("autowakeupEnabled")));
            if (request->hasArg("autowakeupSchedules")) {
                // Handle schedule format with days
                String schedulesStr = request->arg("autowakeupSchedules");
                std::vector<AutoWakeupSchedule> schedules;

                if (schedulesStr.length() > 0) {
                    // Split semicolon-separated schedules
                    int start = 0;
                    int end = schedulesStr.indexOf(';');

                    while (end != -1 || start < schedulesStr.length()) {
                        String scheduleStr = (end != -1) ? schedulesStr.substring(start, end) : schedulesStr.substring(start);

                        int pipePos = scheduleStr.indexOf('|');
                        if (pipePos != -1) {
                            String timeStr = scheduleStr.substring(0, pipePos);
                            String daysStr = scheduleStr.substring(pipePos + 1);

                            AutoWakeupSchedule schedule;
                            schedule.time = timeStr;

                            if (daysStr.length() == 7) {
                                for (int i = 0; i < 7; i++) {
                                    schedule.days[i] = (daysStr.charAt(i) == '1');
                                }
                            }

                            schedules.push_back(schedule);
                        }

                        if (end == -1)
                            break;
                        start = end + 1;
                        end = schedulesStr.indexOf(';', start);
                    }
                }

                if (schedules.empty()) {
                    schedules.push_back(AutoWakeupSchedule("07:00")); // Default fallback
                }
                settings->setAutoWakeupSchedules(schedules);
            }
            settings->save(true);
        });
        pluginManager->trigger("settings:changed");
        controller->setTargetTemp(controller->getTargetTemp());
        controller->setPumpModelCoeffs();
    }

    AsyncResponseStream *response = request->beginResponseStream("application/json");
    JsonDocument doc(&psramAllocator);
    Settings const &settings = controller->getSettings();
    doc["startupMode"] = settings.getStartupMode() == MODE_BREW ? "brew" : "standby";
    doc["startupProfile"] = settings.getStartupProfile();
    doc["targetSteamTemp"] = settings.getTargetSteamTemp();
    doc["targetWaterTemp"] = settings.getTargetWaterTemp();
    doc["homekit"] = settings.isHomekit();
    doc["homeAssistant"] = settings.isHomeAssistant();
    doc["haUser"] = settings.getHomeAssistantUser();
    doc["haPassword"] = settings.getHomeAssistantPassword();
    doc["haIP"] = settings.getHomeAssistantIP();
    doc["haPort"] = settings.getHomeAssistantPort();
    doc["haTopic"] = settings.getHomeAssistantTopic();
    doc["pid"] = settings.getPid();
    doc["pumpModelCoeffs"] = settings.getPumpModelCoeffs();
    doc["pumpSlipCoeffs"] = settings.getPumpSlipCoeffs();
    doc["wifiSsid"] = settings.getWifiSsid();
    doc["wifiPassword"] = apMode ? "---unchanged---" : settings.getWifiPassword();
    doc["apPassword"] = settings.getWifiApPassword();
    doc["mdnsName"] = settings.getMdnsName();
    doc["temperatureOffset"] = String(settings.getTemperatureOffset());
    doc["pressureOffset"] = String(settings.getPressureOffset());
    doc["pressureScaling"] = String(settings.getPressureScaling());
    doc["boilerFillActive"] = settings.isBoilerFillActive();
    doc["startupFillTime"] = settings.getStartupFillTime() / 1000;
    doc["steamFillTime"] = settings.getSteamFillTime() / 1000;
    doc["smartGrindActive"] = settings.isSmartGrindActive();
    doc["smartGrindIp"] = settings.getSmartGrindIp();
    doc["smartGrindMode"] = settings.getSmartGrindMode();
    doc["momentaryButtons"] = settings.isMomentaryButtons();
    doc["flushDuration"] = settings.getFlushDuration();
    doc["warnWaterLevel"] = settings.getWarnWaterLevel();
    doc["warnFlush"] = settings.getWarnFlush();
    doc["warnSteamSwitch"] = settings.getWarnSteamSwitch();
    doc["warnScaleConnected"] = settings.getWarnScaleConnected();
    doc["warnScaleBattery"] = settings.getWarnScaleBattery();
    doc["warnTemperature"] = settings.getWarnTemperature();
    doc["brewDelay"] = settings.getBrewDelay();
    doc["grindDelay"] = settings.getGrindDelay();
    doc["delayAdjust"] = settings.isDelayAdjust();
    doc["timezone"] = settings.getTimezone();
    doc["clock24hFormat"] = settings.isClock24hFormat();
    doc["standbyTimeout"] = settings.getStandbyTimeout() / 1000;
    doc["mainBrightness"] = settings.getMainBrightness();
    doc["standbyBrightness"] = settings.getStandbyBrightness();
    doc["standbyBrightnessTimeout"] = settings.getStandbyBrightnessTimeout() / 1000;
    doc["steamPumpPercentage"] = settings.getSteamPumpPercentage();
    doc["steamPumpCutoff"] = settings.getSteamPumpCutoff();
    doc["themeMode"] = settings.getThemeMode();
    doc["sunriseIdle"] = settings.getSunriseIdle();
    doc["sunriseActive"] = settings.getSunriseActive();
    doc["sunriseFinished"] = settings.getSunriseFinished();
    doc["sunriseError"] = settings.getSunriseError();
    doc["sunriseExtBrightness"] = settings.getSunriseExtBrightness();
    doc["emptyTankDistance"] = settings.getEmptyTankDistance();
    doc["fullTankDistance"] = settings.getFullTankDistance();
    doc["altRelayFunction"] = settings.getAltRelayFunction();
    // Add auto-wakeup settings to response
    doc["autowakeupEnabled"] = settings.isAutoWakeupEnabled();
    doc["buttonBehavior"] = implode(settings.getButtonBehaviorList(), ",");
    doc["commutationGain"] = settings.getCommutationGain();
    doc["convergenceGain"] = settings.getConvergenceGain();
    doc["integralGain"] = settings.getIntegralGain();
    doc["maxPumpPower"] = settings.getMaxPumpPower();
    doc["savedScale"] = settings.getSavedScale();

    // Add schedule format with days
    std::vector<AutoWakeupSchedule> autowakeupSchedules = settings.getAutoWakeupSchedules();
    String schedulesStr = "";
    for (size_t i = 0; i < autowakeupSchedules.size(); i++) {
        if (i > 0)
            schedulesStr += ";";
        schedulesStr += autowakeupSchedules[i].time + "|";

        // Convert days array to 7-bit string
        for (int j = 0; j < 7; j++) {
            schedulesStr += autowakeupSchedules[i].days[j] ? "1" : "0";
        }
    }
    doc["autowakeupSchedules"] = schedulesStr;
    serializeJson(doc, *response);
    request->send(response);

    if (request->method() == HTTP_POST && request->hasArg("restart"))
        ESP.restart();
}

void WebUIPlugin::handleBLEScaleList(AsyncWebServerRequest *request) {
    JsonDocument doc(&psramAllocator);
    JsonArray scalesArray = doc.to<JsonArray>();
    std::vector<DiscoveredDevice> devices = BLEScales.getDiscoveredScales();
    for (const DiscoveredDevice &device : BLEScales.getDiscoveredScales()) {
        JsonDocument scale(&psramAllocator);
        scale["uuid"] = device.getAddress().toString();
        scale["name"] = device.getName();
        scale["rssi"] = device.getRSSI();
        scalesArray.add(scale);
    }
    AsyncResponseStream *response = request->beginResponseStream("application/json");
    serializeJson(doc, *response);
    request->send(response);
}

void WebUIPlugin::handleBLEScaleScan(AsyncWebServerRequest *request) {
    if (request->method() != HTTP_POST) {
        request->send(404);
        return;
    }
    BLEScales.scan();
    JsonDocument doc(&psramAllocator);
    doc["success"] = true;
    AsyncResponseStream *response = request->beginResponseStream("application/json");
    serializeJson(doc, *response);
    request->send(response);
}

void WebUIPlugin::handleBLEScaleConnect(AsyncWebServerRequest *request) {
    if (request->method() != HTTP_POST) {
        request->send(404);
        return;
    }
    BLEScales.connect(request->arg("uuid").c_str());
    JsonDocument doc(&psramAllocator);
    doc["success"] = true;
    AsyncResponseStream *response = request->beginResponseStream("application/json");
    serializeJson(doc, *response);
    request->send(response);
}

void WebUIPlugin::handleBLEScaleInfo(AsyncWebServerRequest *request) {
    JsonDocument doc(&psramAllocator);
    doc["connected"] = BLEScales.isConnected();
    doc["name"] = BLEScales.getName();
    doc["uuid"] = BLEScales.getUUID();
    doc["rssi"] = BLEScales.getRSSI();
    doc["hasBattery"] = BLEScales.hasBatteryLevel();
    // Only surface the numeric when the scale reports one — a 255 sentinel
    // (REMOTE_SCALES_BATTERY_UNKNOWN) would otherwise render as a fake "255%".
    if (BLEScales.hasBatteryLevel()) {
        const uint8_t pct = BLEScales.getBatteryLevel();
        if (pct != REMOTE_SCALES_BATTERY_UNKNOWN) {
            doc["battery"] = pct;
        }
    }
    AsyncResponseStream *response = request->beginResponseStream("application/json");
    serializeJson(doc, *response);
    request->send(response);
}

void WebUIPlugin::updateOTAStatus(const String &version) {
    if (!wsHandler.hasClients())
        return;
    Settings const &settings = controller->getSettings();
    JsonDocument doc(&psramAllocator);
    doc["latestVersion"] = BUILD_PROJECT_VERSION;
    doc["tp"] = "res:ota-settings";
    doc["displayUpdateAvailable"] = false;
    doc["controllerUpdateAvailable"] = false;
    doc["displayVersion"] = BUILD_PROJECT_VERSION;
    doc["controllerVersion"] = controller->getSystemInfo().version;
    doc["hardware"] = controller->getSystemInfo().hardware;
    doc["latestVersion"] = BUILD_PROJECT_VERSION;
    doc["channel"] = settings.getOTAChannel();
    doc["updating"] = updating;
    // LittleFS usage metrics
    {
        size_t total = LittleFS.totalBytes();
        size_t used = LittleFS.usedBytes();
        size_t freeBytes = total > used ? (total - used) : 0;
        doc["spiffsTotal"] = static_cast<uint32_t>(total);
        doc["spiffsUsed"] = static_cast<uint32_t>(used);
        doc["spiffsFree"] = static_cast<uint32_t>(freeBytes);
        if (total > 0) {
            doc["spiffsUsedPct"] = static_cast<uint8_t>((used * 100) / total);
        }
    }
    // Memory usage metrics
    {
        size_t free = heap_caps_get_free_size(MALLOC_CAP_DEFAULT | MALLOC_CAP_INTERNAL);
        size_t largest = heap_caps_get_largest_free_block(MALLOC_CAP_DEFAULT | MALLOC_CAP_INTERNAL);
        size_t total = heap_caps_get_total_size(MALLOC_CAP_DEFAULT | MALLOC_CAP_INTERNAL);
        doc["heapFree"] = static_cast<uint32_t>(free);
        doc["heapLargest"] = static_cast<uint32_t>(largest);
        doc["heapTotal"] = static_cast<uint32_t>(total);
    }
    doc["controllerTaskHealth"] = controller->isTaskHealthy();
#ifndef GEMILAIMATE_HEADLESS
    doc["uiTaskHealth"] = controller->getUI()->isTaskHealthy();
#endif
    if (controller->isSDCard()) {
        const uint64_t total = SD_MMC.cardSize();
        const uint64_t used = SD_MMC.usedBytes();
        const uint64_t freeBytes = total > used ? (total - used) : 0;
        doc["sdTotal"] = total;
        doc["sdUsed"] = used;
        doc["sdFree"] = freeBytes;
        if (total > 0) {
            // Provide integer percentage to avoid float JSON
            doc["sdUsedPct"] = static_cast<uint8_t>((used * 100) / total);
        }
    }
    wsHandler.broadcastJson(doc);
}

void WebUIPlugin::updateOTAProgress(uint8_t phase, int progress) {
    if (!wsHandler.hasClients())
        return;
    JsonDocument doc(&psramAllocator);
    doc["tp"] = "evt:ota-progress";
    doc["phase"] = phase;
    doc["progress"] = progress;
    wsHandler.broadcastJson(doc);
}

void WebUIPlugin::handleCoreDumpDownload(AsyncWebServerRequest *request) {
    // Check if core dump is available
    size_t coreAddr, coreSize;
    if (esp_core_dump_image_get(&coreAddr, &coreSize) != ESP_OK || coreSize == 0) {
        request->send(404, "text/plain", "No core dump available");
        return;
    }

    // Find the coredump partition
    const esp_partition_t *coredump_partition =
        esp_partition_find_first(ESP_PARTITION_TYPE_DATA, ESP_PARTITION_SUBTYPE_DATA_COREDUMP, NULL);
    if (coredump_partition == NULL) {
        request->send(500, "text/plain", "Core dump partition not found");
        return;
    }

    ESP_LOGI("WebUIPlugin", "Streaming core dump: %d bytes from 0x%x", coreSize, coreAddr);

    // Create a streaming response
    AsyncWebServerResponse *response =
        request->beginResponse("application/octet-stream", coreSize,
                               [coredump_partition, coreSize](uint8_t *buffer, size_t maxLen, size_t index) -> size_t {
                                   // Calculate how much to read
                                   size_t remaining = coreSize - index;
                                   size_t toRead = (remaining < maxLen) ? remaining : maxLen;

                                   if (toRead == 0)
                                       return 0;

                                   // Read from partition
                                   esp_err_t err = esp_partition_read(coredump_partition, index, buffer, toRead);
                                   if (err != ESP_OK) {
                                       ESP_LOGE("WebUIPlugin", "Failed to read core dump: %s", esp_err_to_name(err));
                                       return 0;
                                   }

                                   return toRead;
                               });

    // Set appropriate headers
    response->addHeader("Content-Disposition", "attachment; filename=\"coredump.bin\"");
    response->addHeader("Cache-Control", "no-cache");

    request->send(response);
}
