rico-x/GemilaiMate/firmware/src/display/plugins/MQTTPlugin.cpp

#include "MQTTPlugin.h"
#include "../core/Controller.h"
#include <ArduinoJson.h>
#include <ctime>
#include <display/util/PsramAllocator.h>
#include <esp_log.h>

const String LOG_TAG = F("MQTTPlugin");

bool MQTTPlugin::connect(Controller *controller) {
    const Settings settings = controller->getSettings();
    const String ip = settings.getHomeAssistantIP();
    const int haPort = settings.getHomeAssistantPort();
    const String clientId = "GemilaiMate";
    const String haUser = settings.getHomeAssistantUser();
    const String haPassword = settings.getHomeAssistantPassword();

    client.begin(ip.c_str(), haPort, net);
    client.setKeepAlive(10);
    ESP_LOGI(LOG_TAG.c_str(), "Connecting to %s:%d", ip.c_str(), haPort);
    for (int i = 0; i < MQTT_CONNECTION_RETRIES; i++) {
        ESP_LOGD(LOG_TAG.c_str(), "Attempt (%d/%d)", i + 1, MQTT_CONNECTION_RETRIES);
        if (client.connect(clientId.c_str(), haUser.c_str(), haPassword.c_str())) {
            ESP_LOGI(LOG_TAG.c_str(), "Successfully connected");
            return true;
        }
        delay(MQTT_CONNECTION_DELAY);
    }
    ESP_LOGW(LOG_TAG.c_str(), "Connection failed");
    return false;
}

void MQTTPlugin::publishDiscovery(Controller *controller) {
    if (!client.connected())
        return;
    const Settings settings = controller->getSettings();
    const String haTopic = settings.getHomeAssistantTopic();
    String mac = WiFi.macAddress();
    mac.replace(":", "_");
    const char *cmac = mac.c_str();

    JsonDocument device(&psramAllocator);
    JsonDocument origin(&psramAllocator);
    JsonDocument components(&psramAllocator);

    // Device information
    device["ids"] = cmac;
    device["name"] = "GemilaiMate";
    device["mf"] = "GemilaiMate";
    device["mdl"] = "GemilaiMate";
    device["sn"] = cmac;
    device["sw"] = controller->getSystemInfo().version;
    device["hw"] = controller->getSystemInfo().hardware;

    // Origin information
    origin["name"] = "GemilaiMate";
    origin["sw"] = controller->getSystemInfo().version;
    origin["url"] = "https://github.com/Rico-X/GemilaiMate";

    // Components information
    JsonDocument cmps(&psramAllocator);
    JsonDocument boilerTemperature(&psramAllocator);
    JsonDocument boilerTargetTemperature(&psramAllocator);
    JsonDocument mode(&psramAllocator);

    boilerTemperature["name"] = "Boiler Temperature";
    boilerTemperature["p"] = "sensor";
    boilerTemperature["device_class"] = "temperature";
    boilerTemperature["unit_of_measurement"] = "°C";
    boilerTemperature["value_template"] = "{{ value_json.temperature | round(2) }}";
    boilerTemperature["unique_id"] = "boiler0Tmp";
    boilerTemperature["state_topic"] = "gemilaimate/" + String(cmac) + "/boilers/0/temperature";

    boilerTargetTemperature["name"] = "Boiler Target Temperature";
    boilerTargetTemperature["p"] = "sensor";
    boilerTargetTemperature["device_class"] = "temperature";
    boilerTargetTemperature["unit_of_measurement"] = "°C";
    boilerTargetTemperature["value_template"] = "{{ value_json.temperature | round(2) }}";
    boilerTargetTemperature["unique_id"] = "boiler0TargetTmp";
    boilerTargetTemperature["state_topic"] = "gemilaimate/" + String(cmac) + "/boilers/0/targetTemperature";

    mode["name"] = "Mode";
    mode["p"] = "text";
    mode["device_class"] = "text";
    mode["value_template"] = "{{ value_json.mode_str }}";
    mode["unique_id"] = "mode";
    mode["state_topic"] = "gemilaimate/" + String(cmac) + "/controller/mode";

    cmps["boiler"] = boilerTemperature;
    cmps["boiler_target"] = boilerTargetTemperature;
    cmps["mode"] = mode;

    // Prepare the payload for Home Assistant discovery
    JsonDocument payload(&psramAllocator);
    payload["dev"] = device;
    payload["o"] = origin;
    payload["cmps"] = cmps;
    payload["state_topic"] = "gemilaimate/" + String(cmac) + "/state";
    payload["qos"] = 2;

    char publishTopic[80];
    snprintf(publishTopic, sizeof(publishTopic), "%s/device/%s/config", haTopic.c_str(), cmac);

    String payloadStr;
    serializeJson(payload, payloadStr);

    ESP_LOGD(LOG_TAG.c_str(), "Publishing discovery %s: %s", publishTopic, payloadStr.c_str());
    client.publish(publishTopic, payloadStr);
}

void MQTTPlugin::publish(const std::string &topic, const std::string &message) {
    if (!client.connected())
        return;
    String mac = WiFi.macAddress();
    mac.replace(":", "_");
    const char *cmac = mac.c_str();
    char publishTopic[80];
    snprintf(publishTopic, sizeof(publishTopic), "gemilaimate/%s/%s", cmac, topic.c_str());

    ESP_LOGD(LOG_TAG.c_str(), "Publishing %s: %s", publishTopic, message.c_str());
    client.publish(publishTopic, message.c_str());
}
void MQTTPlugin::publishBrewState(const char *state) {
    char json[100];
    std::time_t now = std::time(nullptr); // Get current timestame
    snprintf(json, sizeof(json), R"({"state":"%s","timestamp":%ld})", state, now);
    publish("controller/brew/state", json);
}

void MQTTPlugin::setup(Controller *controller, PluginManager *pluginManager) {
    pluginManager->on("controller:wifi:connect", [this, controller](const Event &) {
        if (!connect(controller))
            return;
        publishDiscovery(controller);
    });

    pluginManager->on("boiler:currentTemperature:change", [this](Event const &event) {
        if (!client.connected())
            return;
        char json[50];
        const float temp = event.getFloat("value");
        if (temp != lastTemperature) {
            snprintf(json, sizeof(json), R"***({"temperature":%02f})***", temp);
            publish("boilers/0/temperature", json);
        }
        lastTemperature = temp;
    });
    pluginManager->on("boiler:targetTemperature:change", [this](Event const &event) {
        if (!client.connected())
            return;
        char json[50];
        const float temp = event.getFloat("value");
        snprintf(json, sizeof(json), R"***({"temperature":%02f})***", temp);
        publish("boilers/0/targetTemperature", json);
    });
    pluginManager->on("controller:mode:change", [this](Event const &event) {
        int newMode = event.getInt("value");
        const char *modeStr;
        switch (newMode) {
        case 0:
            modeStr = "Standby";
            break;
        case 1:
            modeStr = "Brew";
            break;
        case 2:
            modeStr = "Steam";
            break;
        case 3:
            modeStr = "Water";
            break;
        case 4:
            modeStr = "Grind";
            break;
        default:
            modeStr = "Unknown";
            break; // Fallback in case of unexpected value
        }
        char json[100];
        snprintf(json, sizeof(json), R"({"mode":%d,"mode_str":"%s"})", newMode, modeStr);
        publish("controller/mode", json);
    });
    pluginManager->on("controller:brew:start", [this](Event const &) { publishBrewState("brewing"); });

    pluginManager->on("controller:brew:end", [this](Event const &) { publishBrewState("not brewing"); });
}
