rico-x/GemilaiMate/tools/check_compact_shield.py

#!/usr/bin/env python3
"""Independent package-pin and saved-artifact acceptance checks (no hardware)."""
from pathlib import Path
import json,hashlib,math,csv,sexpdata as s
R=Path(__file__).resolve().parents[1];H=R/'hardware/shield-compact'
def children(n,key):return [x for x in n if isinstance(x,list) and str(x[0])==key]
def value(n,key):return children(n,key)[0][1]
def main():
 d=json.loads((H/'design.json').read_text());parts={c['ref']:c for c in d['parts']};aliases={c['designator']:c['ref'] for c in d['parts']}
 pcb=s.loads((H/'gemilaimate-compact.kicad_pcb').read_text());found={}
 assert '${KICAD10_3DMODEL_DIR}' not in (H/'gemilaimate-compact.kicad_pcb').read_text(),'PCB must use self-contained 3D models'
 for footprint in children(pcb,'footprint'):
  for model in children(footprint,'model'):
   name=str(model[1]);assert name.startswith('${KIPRJMOD}/') and (H/name.split('}/',1)[1]).is_file(),name
 for f in children(pcb,'footprint'):
  ref=next(x[2] for x in children(f,'property') if x[1]=='Reference')
  alias=aliases.get(ref,ref)
  for pad in children(f,'pad'):
   if not pad[1]:continue
   nets=children(pad,'net');net=str(nets[0][-1]) if nets else None
   key=(alias,str(pad[1]))
   if key in found:assert found[key]==net,key
   found[key]=net
 # Literal manufacturer package numbers. Deliberately not imported from the
 # generator: DCT/DCU and X2SON have different pins; SO20 != QFN20 for PCA.
 expected={
 # CJMCU-0102 silkscreen A: GND OE VA A1 A2 / B: GND G VB B1 B2; TXS0102 pairs A1-B1, A2-B2.
 'J_USB':{'A1':'GND','A12':'GND','B1':'GND','B12':'GND','SH':'GND','A4':'USB_VBUS','A9':'USB_VBUS','B4':'USB_VBUS','B9':'USB_VBUS','A5':'CC1','B5':'CC2','A6':'USB_DP','B6':'USB_DP','A7':'USB_DM','B7':'USB_DM'},
 'R_CC1':{1:'CC1',2:'GND'},'R_CC2':{1:'CC2',2:'GND'},
 'J_LEVEL':{1:'GND',2:'I2C_OE',3:'+3V3',4:'SCL_3V3',5:'SDA_3V3',6:'GND',8:'+5V_CORE',9:'SCL_5V',10:'SDA_5V'},
 'R_OE':{1:'+3V3',2:'I2C_OE'},'C_OE':{1:'I2C_OE',2:'GND'},
 'U_LED':{1:'GND',2:'GND',3:'GND',4:'GND',5:'GND',6:'PCA_LED0',7:'PCA_LED1',8:'PCA_LED2',9:'PCA_LED3',10:'GND',11:'PCA_LED4',12:'PCA_LED5',13:'PCA_LED6',14:'PCA_LED7',15:'GND',16:'GND',17:'GND',18:'PCA_SCL',19:'PCA_SDA',20:'+3V3'},
 'U_REG':{1:'+5V_CORE',2:'GND',3:'+3V3'},
 'U_ZC':{2:'ZC_IN',3:'GND',4:'PUMP_ZC',5:'+3V3'},
 'U_PUMP':{1:'OUTPUT_OE_N',2:'PUMP_PWM',3:'GND',4:'PUMP_OUT',5:'+3V3'},
 'U_SSR':{1:'OUTPUT_OE_N',2:'VALVE',3:'VALVE_5V',4:'OUTPUT_OE_N',5:'HEATER',6:'HEATER_5V',7:'GND',8:'ALT_5V',9:'ALT',10:'OUTPUT_OE_N',12:'GND',13:'+5V_EXT',14:'+5V_EXT'},
 'U_ESD':{1:'USB_DM',2:'GND',3:'USB_DP',4:'USB_DP',5:'USB_VBUS',6:'USB_DM'},
 'D_TVS':{1:'+5V_EXT',2:'GND'},'J_ALBA':{1:'+5V_EXT',2:'GND',3:'EXT_SDA',4:'EXT_SCL'},
 'J_TOF':{1:'+3V3',2:'GND',3:'EXT_SDA',4:'EXT_SCL'},'R_EXTSDA':{1:'ALBA_SDA',2:'EXT_SDA'},'R_EXTSCL':{1:'ALBA_SCL',2:'EXT_SCL'},
 'R_TC3V3':{1:'+3V3',2:'TC_VIN'},'R_TC5V':{1:'+5V_CORE',2:'TC_VIN'},'J_PWR':{1:'EXT_IN',2:'GND'},
 'J_PUMP':{1:'+5V_EXT',2:'GND',3:'ZC_RAW',4:'PUMP_OUT'},
 'U1':{1:'GND',2:'+3V3',3:'EN',4:'TC_DO',5:'GPIO5',6:'TC_SCK',7:'TC_CS',8:'GPIO15',9:'GPIO16',10:'SCALE_CLK',11:'SCALE_DAT0',12:'EXT3',13:'USB_DM_MCU',14:'USB_DP_MCU',15:'STRAP3',16:'STRAP46',17:'PUMP_PWM',18:'VALVE',19:'BOARD_ID',20:'EXT4',21:'EXT5',22:'HEATER',23:'PUMP_ZC',24:'ALT',25:'STEAM',26:'STRAP45',27:'BOOT',31:'BREW',32:'SCALE_DAT1',33:'DETECT_EN',34:'SCL_3V3',35:'SDA_3V3',36:'ALBA_SCL',37:'ALBA_SDA',38:'EXT2',39:'EXT1',40:'GND',41:'GND'}}
 for ref,pins in expected.items():
  for pin,net in pins.items():assert found[(ref,str(pin))]==net,(ref,pin,net,found.get((ref,str(pin))))
 for pin in [28,29,30]:assert found[('U1',str(pin))].startswith('unconnected-'),('PSRAM exposed',pin)
 for item in children(pcb,'segment')+children(pcb,'via'):
  net=children(item,'net')
  assert not net or not str(net[0][-1]).startswith('unconnected-'), 'NC/PSRAM fanout must not be routed'
 # A second independent comparison with the actual exported schematic netlist.
 netlist=s.loads((H/'gemilaimate-compact.net').read_text())
 for net in children(netlist,'nets')[0][1:]:
  name=str(value(net,'name'))
  for node in children(net,'node'):
   ref=str(value(node,'ref'));pin=str(value(node,'pin'))
   if ref.startswith('#'):continue
   assert found[(aliases[ref],pin)]==name,(ref,pin,name)
 assert parts['J_LEVEL']['source_footprint'].endswith('CJMCU0102_socket')
 assert parts['J_LEVEL']['nets']['7'] is None and '2 x Harwin M20-7820546' == parts['J_LEVEL']['mpn']
 # Not mirrored: seen from the top with row A running GND->A2, row B lies on
 # the counter-clockwise side, and both GND contacts face each other.
 pad=lambda n:next((q['x'],q['y']) for q in parts['J_LEVEL']['physical_pads'] if q['number']==n)
 dx,dy=pad('5')[0]-pad('1')[0],pad('5')[1]-pad('1')[1];nx,ny=pad('6')[0]-pad('1')[0],pad('6')[1]-pad('1')[1]
 assert dx*ny-dy*nx<0 and abs(dx*nx+dy*ny)<1e-3,('CJMCU socket mirrored or rows shifted',dx,dy,nx,ny)
 assert parts['R_OE']['value']=='10k 1%' and parts['C_OE']['value']=='1uF 16V X7R'
 # Seller top-view photos: ADS1115 Blue reads VDD..A3 with the board above the
 # row; MAX31855 reads VIN..CLK with the terminal block opposite the row. Seen
 # from the top, the module body lies left of the pin1 -> last-pin direction.
 for ref,last,count in [('J_ADS','10',10),('J_TC','6',6)]:
  pp=lambda n:next((q['x'],q['y']) for q in parts[ref]['physical_pads'] if q['number']==n)
  a,b=pp('1'),pp(last);r=d['module_sockets'][ref]['body_rect_mm'];cx,cy=(r[0]+r[2])/2,(r[1]+r[3])/2;mx,my=(a[0]+b[0])/2,(a[1]+b[1])/2
  assert (b[0]-a[0])*(cy-my)-(b[1]-a[1])*(cx-mx)<0,(ref,'module body on the wrong side of the socket row')
  assert all(abs(math.dist(pp(str(i)),pp(str(i+1)))-2.54)<1e-3 for i in range(1,count)),(ref,'socket pitch')
 assert abs(math.dist(pad('1'),pad('6'))-12.7)<1e-3,'CJMCU row spacing'
 for ref in ['J_SCALE','J_EXT','J_FREE']:
  assert parts[ref]['dnp'] and 'P2.54mm' in parts[ref]['source_footprint'],(ref,parts[ref]['source_footprint'])
 assert parts['U_LED']['source_footprint'].endswith('SOIC-20W_7.5x12.8mm_P1.27mm') and parts['U_SSR']['source_footprint'].endswith('SOIC-14_3.9x8.7mm_P1.27mm')
 # Novice hand assembly: no 0603 or 0.65 mm pitch; every two-terminal SMD and
 # SOT/SMA package uses the long hand-solder land pattern.
 for c in parts.values():
  fp=c['source_footprint']
  assert '0603' not in fp and 'TSSOP' not in fp,(c['ref'],fp)
  if fp.split(':')[0] in ['Resistor_SMD','Capacitor_SMD','Fuse','Diode_SMD'] or ':SOT-23' in fp:assert 'hand' in fp.lower(),(c['ref'],fp)
 assert parts['R_ID_TOP']['value']=='10k 1%' and parts['R_ID_LOW']['value']=='1.58k 1%'
 # ID=4 window is 400-499 mV (round(mV/100-0.5)); keep >=15 mV on both sides.
 vmin=3.3*.95*(1580*.99)/(10000*1.01+1580*.99)
 vmax=3.3*1.05*(1580*1.01)/(10000*.99+1580*1.01)
 assert .415<vmin<vmax<.485,(vmin,vmax)
 assert d['size_mm']==json.loads((H/'layout-config.json').read_text())['size_mm'] and d['copper_layers']==2 and d['board_id']==4
 assert d['hardware_tested'] is False and d['manufacturing_release'] is False
 assert d['physical_flash_mb']==16 and d['compatible_partition_flash_mb']==8 and d['psram_mb']==8
 assert d['peripheral_gpio']==dict(sda=43,scl=44)
 for c in parts.values():
  if c['section']=='Connectors':assert c['side']=='back' and ('JST_PH_B' in c['source_footprint'] or c['ref']=='J_PWR')
 # Foolproofing: the supply input is the only XH, MAX31855 VIN is 3.3 V unless reworked.
 assert 'JST_XH_B2B' in parts['J_PWR']['source_footprint'] and sum('JST_XH' in c['source_footprint'] for c in parts.values())==1
 assert not parts['R_TC3V3']['dnp'] and parts['R_TC5V']['dnp'] and parts['R_EXTSDA']['value']==parts['R_EXTSCL']['value']=='470R 1%'
 erc=json.loads((H/'reports/erc.json').read_text());drc=json.loads((H/'reports/drc.json').read_text())
 assert not any(sh['violations'] for sh in erc['sheets'])
 assert all(not drc[k] for k in ['violations','unconnected_items','schematic_parity'])
 report=json.loads((H/'reports/layout.json').read_text());assert report['minimum_track_mm']>=.20
 assert all(x['via_overlaps']==0 for x in report['visible_labels'])
 # Socket marking order is checked spatially, including the reversed MAX row.
 for ref in ['J_ADS','J_TC']:
  c=parts[ref];owner=c['designator'];pins=sorted(c['pins'],key=lambda x:x['x'])
  words=[]
  for pin in pins:
   label=next((t for t in report['visible_labels'] if t['owner']==owner+'.'+pin['number']),None)
   if label is None:
    assert pin['net'] is None;continue
   # A silk legend stays within one 2.54 mm pitch of its own pad, or further
   # out exactly on the line through its pad across the row (never beside a
   # neighbour): offset along the row at most 0.55 mm.
   row=[(q['x'],q['y']) for q in c['physical_pads'] if q['number'] in ('1','2')];rx,ry=row[1][0]-row[0][0],row[1][1]-row[0][1];rl=math.hypot(rx,ry)
   dx,dy=label['position_mm'][0]-pin['x'],label['position_mm'][1]-pin['y']
   assert math.hypot(dx,dy)<2.6 or (abs(dx*rx+dy*ry)/rl<=.55 and math.hypot(dx,dy)<5.6),(ref,pin['number'],label['position_mm'],(pin['x'],pin['y']))
   words.append(label['text'])
  if ref=='J_TC':assert words[0]=='CLK' and words[-1]=='VIN',words
 # Review fixes that must not regress: the RobotDyn PH size is unique, the
 # unused heater header is not fitted, and the regulator caps sit at its pins.
 for pin in ['5','6']:assert found[('J_PUMP',pin)] is None or found[('J_PUMP',pin)].startswith('unconnected-'),('J_PUMP spare position wired',pin)
 sizes=[len(c['nets']) for c in parts.values() if c['section']=='Connectors' and not c['dnp']]
 assert sizes.count(len(parts['J_PUMP']['nets']))==1,'RobotDyn header size must be unique'
 assert parts['J_HEAT']['dnp'] and parts['F_EXT']['mpn']=='1206L150/12SLYR' and parts['D_TVS']['mpn']=='SMAJ5.0A'
 pos=lambda ref,num:next((p['x'],p['y']) for p in parts[ref]['pins'] if p['number']==num)
 for cap,pin in [('C_IN','1'),('C_OUT','3')]:
  assert math.dist(pos(cap,'1'),pos('U_REG',pin))<5,(cap,'too far from U_REG pin',pin)
 report_labels={t['owner'] for t in report['visible_labels']}
 # Budget-fab silkscreen and copper margins.
 assert all(t['bbox_mm'] and (t['bbox_mm'][3]-t['bbox_mm'][1]>=.95 or t['bbox_mm'][2]-t['bbox_mm'][0]>=.95) for t in report['visible_labels'])
 rules=json.loads((H/'gemilaimate-compact.kicad_pro').read_text())['board']['design_settings']['rules']
 assert rules['min_clearance']>=.21 and rules['min_track_width']>=.20
 assert not json.loads((H/'gemilaimate-compact.kicad_pro').read_text())['board']['design_settings']['drc_exclusions']
 net_settings=json.loads((H/'gemilaimate-compact.kicad_pro').read_text())['net_settings']
 classes={c['name']:c for c in net_settings['classes']}
 assert classes['Default']['clearance']>=.25 and classes['Default']['track_width']>=.3
 assert classes['Power']['clearance']>=.3 and classes['Power']['track_width']>=.4
 assert classes['USB']['clearance']>=.3 and classes['USB']['track_width']>=.3
 assert {p['pattern'] for p in net_settings['netclass_patterns'] if p['netclass']=='Power'}=={'+3V3','+5V_CORE','+5V_EXT','EXT_IN','USB_VBUS','USB_FUSED'}
 assert rules['min_via_diameter']>=.8 and rules['min_via_drill']>=.4
 assert rules['min_text_height']>=1 and rules['min_text_thickness']>=.15 and rules['min_copper_edge_clearance']>=.5
 assert rules['min_hole_to_hole']>=.65 and rules['min_hole_clearance']>=.4 and rules['min_via_annular_width']>=.20
 custom_rules=(H/'gemilaimate-compact.kicad_dru').read_text()
 assert 'Ordinary drill to copper' in custom_rules and '(constraint hole_clearance (min 0.50mm))' in custom_rules
 assert 'Power track width' in custom_rules and '(constraint track_width (min 0.30mm))' in custom_rules
 assert 'Signal track width' in custom_rules and '(constraint track_width (min 0.20mm))' in custom_rules and 'TSSOP' not in custom_rules
 assert 'USB4085' not in custom_rules and '(min 0.15mm)' not in custom_rules
 assert parts['J_USB']['mpn']=='TYPE-C-31-M-12'
 import re
 for kind,floor in re.findall(r'constraint (clearance|track_width) \(min ([0-9.]+)mm\)',custom_rules):
  assert float(floor)>=(.21 if kind=='clearance' else .20),('fabrication floor bypassed',kind,floor)
 # Any other footprint exception is pad-to-pad inside one package only.
 import re
 for rule in re.findall(r'\(rule "([^"]+)"\n \(condition "([^"]+)"\)',custom_rules):
  refs=set(re.findall(r"memberOfFootprint\('([^']+)'\)",rule[1]))
  if refs and refs!={'J1'}:assert rule[0].startswith('Package lands ') and len(refs)==1 and rule[1].startswith("A.Type == 'Pad' && B.Type == 'Pad' &&"),rule
 pcb_text=(H/'gemilaimate-compact.kicad_pcb').read_text()
 assert '(clearance 0.15)' not in pcb_text,'local 0.15 mm pad clearance leaks to pours and foreign tracks'
 geometry=json.loads((H/'reports/geometry.json').read_text())
 assert geometry['mount_copper_keepout_radius_mm']>=2.5 and geometry['power_min_track_mm']>=.3 and geometry['signal_min_track_mm']>=.20 and geometry['usb_min_track_mm']>=.2
 for ref in ['J_ADS','J_TC','J_LEVEL']:assert parts[ref]['designator']+'.BODY' in report_labels,ref
 # Orientation marks on silk for every fitted polarised SMD part.
 for c in parts.values():
  if c['ref'].startswith(('U','Q_','D_')) and c['ref']!='U1' and not c['dnp']:assert c['designator']+'.POL' in report_labels,('no polarity mark',c['designator'])
 for c in parts.values():
  if c['section']=='Connectors':assert c['designator']+'.FUNCTION' in report_labels,('no function label',c['designator'])
 placements=list(csv.DictReader((H/'manufacturing/CPL-SMD.csv').open()))
 expected_smd=sum(1 for c in parts.values() if not c['dnp'] and c['physical_pads'] and
                  (c['ref'] in ['U1','J_USB'] or all(p['smd'] for p in c['physical_pads'])))
 assert len(placements)==expected_smd
 u1=next(p for p in placements if p['Designator']=='U1')
 assert abs(float(u1['Mid X_mm'])-(15+json.loads((H/'layout-config.json').read_text()).get('layout_offset_x_mm',0)))<.001 and abs(float(u1['Mid Y_mm'])-5.6)<.001
 assert not {'U1','J1'} & {p['Reference'] for p in csv.DictReader((H/'manufacturing/BOM-THT.csv').open())}
 manifest=json.loads((H/'manufacturing/manifest.json').read_text())
 assert manifest['revision']==d['revision']==json.loads((H/'revision.json').read_text())['revision']
 assert manifest['pcb_sha256']==hashlib.sha256((H/'gemilaimate-compact.kicad_pcb').read_bytes()).hexdigest()
 assert manifest['hardware_tested'] is False and manifest['manufacturing_release'] is False
 print('PASS compact: physical package pins, schematic parity, memory/ID, GPIO reservations, marking order, saved ERC/DRC and hashes')
if __name__=='__main__':main()
