rico-x/GemilaiMate/hardware/shield-compact/scripts/generate.py

#!/usr/bin/env python3
"""Generate the compact KiCad PCB and circuit data. Execute on the KiCad build host.

Placement is nominal until real breakout modules are measured. Routes/CAM are
separate stages and no fabrication readiness is implied by generation.
"""
import csv
import json
import math
import shutil
import sys
from pathlib import Path

ROOT = Path(__file__).resolve().parents[3]
sys.path.insert(0, str(ROOT/'hardware/shield/scripts'))
from kicad_runtime import application, seed_uuids
_app=application()
import pcbnew as p
seed_uuids('compact-generate-0.1.0')
from circuit import SPEC, HERE, REV, WROOM_GPIO

for folder in ['GemilaiMateCompact.pretty','GemilaiMateCompact.3dshapes','previews','manufacturing','reports']:
    (HERE/folder).mkdir(parents=True, exist_ok=True)
B=p.BOARD()
B.SetCopperLayerCount(SPEC['copper_layers'])
V=lambda x,y:p.VECTOR2I(p.FromMM(x),p.FromMM(y))
names=sorted({n for c in SPEC['parts'] for n in c['nets'].values() if n})
nets={}
for name in names:
    net=p.NETINFO_ITEM(B,name)
    B.Add(net);nets[name]=net
title=B.GetTitleBlock()
title.SetTitle('GemilaiMate Compact Shield - Rico-X')
title.SetRevision(REV['revision']);title.SetDate(REV['date'])
title.SetComment(0,'PROTOTYPE / NOT HARDWARE VALIDATED')
title.SetComment(1,'Native USB / GM Pro PCB Rev 1.1 ID=4 / 16MB physical, 8MB partition map')
title.SetComment(2,'github.com/Rico-X/GemilaiMate - no mains on PCB')
B.SetTitleBlock(title)


def line(fp,a,b,layer=p.F_Fab,width=.1):
    item=p.PCB_SHAPE(fp if fp else B)
    item.SetShape(p.SHAPE_T_SEGMENT);item.SetStart(V(*a));item.SetEnd(V(*b))
    item.SetLayer(layer);item.SetWidth(p.FromMM(width))
    (fp if fp else B).Add(item)


def rect(fp,box,layer=p.F_Fab,width=.1):
    a,b,c,d=box
    for x,y in [((a,b),(c,b)),((c,b),(c,d)),((c,d),(a,d)),((a,d),(a,b))]:line(fp,x,y,layer,width)


def socket(part):
    fp=p.FOOTPRINT(B)
    fp.SetReference(part['ref']);fp.SetValue(part['value'])
    fp.SetAttributes(p.FP_THROUGH_HOLE)
    name=part['footprint'].split(':',1)[1]
    fp.SetFPID(p.LIB_ID('GemilaiMateCompact',name))
    if part['ref']=='J_LEVEL':
        for i in range(5):
            for number,y in [(i+1,6.35),(i+6,-6.35)]:
                pad=p.PAD(fp);pad.SetNumber(str(number));pad.SetPosition(V((i-2)*2.54,y))
                pad.SetAttribute(p.PAD_ATTRIB_PTH)
                pad.SetShape(p.PAD_SHAPE_RECT if number in [1,6] else p.PAD_SHAPE_CIRCLE)
                pad.SetSize(V(1.65,1.65));pad.SetDrillSize(V(1.02,1.02));pad.SetLayerSet(p.PAD.PTHMask())
                fp.Add(pad)
        # The two 1x5 rows mate with the selected CJMCU-0102 layout. The
        # square body is the nominal 15.24 x 15.24 mm breakout envelope.
        for row_y in [-6.35,6.35]:rect(fp,[-6.8,row_y-1.5,6.8,row_y+1.5],p.F_CrtYd,.05)
        rect(fp,[-7.62,-7.62,7.62,7.62],p.F_SilkS,.1)
        return fp
    n=10 if part['ref']=='J_ADS' else 6
    for i in range(n):
        pad=p.PAD(fp);pad.SetNumber(str(i+1));pad.SetPosition(V(i*2.54*(1 if n==10 else -1),0))
        pad.SetAttribute(p.PAD_ATTRIB_PTH);pad.SetShape(p.PAD_SHAPE_RECT if i==0 else p.PAD_SHAPE_CIRCLE)
        # Harwin M20-782 sockets specify a Ø1.02 ±0.05 mm PCB hole for their
        # 0.65 mm terminal; 0.95 mm was below the manufacturer's recommended fit.
        pad.SetSize(V(1.65,1.65));pad.SetDrillSize(V(1.02,1.02));pad.SetLayerSet(p.PAD.PTHMask())
        fp.Add(pad)
    # Only the low socket itself occupies a PCB courtyard. The daughterboard
    # envelope is checked at its actual assembly height, not as a flat keepout.
    box=[-1.47,-1.25,(n-1)*2.54+1.47,1.25] if n==10 else [-(n-1)*2.54-1.47,-1.25,1.47,1.25]
    rect(fp,box,p.F_CrtYd,.05);rect(fp,box,p.F_SilkS,.1)
    return fp


def save_local(fp,c):
    original=c['footprint']
    local_name=original.split(':',1)[1]
    fp.SetFPID(p.LIB_ID('GemilaiMateCompact',local_name))
    c['source_footprint']=original
    c['footprint']='GemilaiMateCompact:'+local_name
    plugin=p.PCB_IO_MGR.FindPlugin(p.PCB_IO_MGR.KICAD_SEXP)
    plugin.FootprintSave(str(HERE/'GemilaiMateCompact.pretty'),fp)


overrides=json.loads((HERE/'placement.json').read_text()) if (HERE/'placement.json').exists() and '--fresh' not in sys.argv else {}
for c in SPEC['parts']:
    c.update(overrides.get(c['ref'],{}))
    lib,name=c['footprint'].split(':',1)
    if lib=='GemilaiMateCompact':fp=socket(c)
    else:
        path=HERE/'GemilaiMateCompact.pretty'
        if not (path/(name+'.kicad_mod')).exists():path=Path('/usr/share/kicad/footprints')/(lib+'.pretty')
        fp=p.FootprintLoad(str(path),name)
        if not fp:raise RuntimeError('Missing footprint: '+c['footprint'])
    fp.SetReference(c['designator']);fp.SetValue(c['value'])
    for pad in fp.Pads():
        # Harness GND pins join both GND layers solidly: routing between connector
        # pins otherwise leaves F.Cu spokes on isolated islands (starved thermals).
        if (c['ref'] in ['J_EXT','J_FREE','J_SCALE','J_USB'] or c['section']=='Connectors') and c['nets'].get(pad.GetNumber())=='GND':pad.SetLocalZoneConnection(p.ZONE_CONNECTION_FULL)
        # Optional expansion headers: their supply pins join the outer +3V3/+5V_EXT
        # pours solidly too, so the 2.54 mm rows never leave a starved thermal.
        if c['ref'] in ['J_EXT','J_FREE','J_SCALE'] and c['nets'].get(pad.GetNumber()) in ['+3V3','+5V_EXT']:pad.SetLocalZoneConnection(p.ZONE_CONNECTION_FULL)
        # No local pad clearances: a pad override also applies to pours and
        # foreign tracks. The fixed HRO USB-C pitch is a pad-to-pad DRU exception.
        pad.SetLocalClearance(None)
        if c['ref']=='J_USB' and pad.GetAttribute()==p.PAD_ATTRIB_SMD:
            # HRO drawing: 0.30/0.60 mm recommended lands, layout tolerance
            # +/-0.05 mm; leads are 0.20 +/-0.05 mm. Retain centres/lengths,
            # reduce each land by 0.02 mm for a real >=0.22 mm copper gap.
            # Absolute sizes make this idempotent when loading the local cache.
            sx=.58 if pad.GetNumber() in ['A1','A4','A9','A12','B1','B4','B9','B12'] else .28
            pad.SetSize(V(sx,p.ToMM(pad.GetSize().y)))
        if c['ref']=='U1' and pad.GetNumber()=='41':
            if pad.GetAttribute()==p.PAD_ATTRIB_PTH:
                pad.SetDrillSize(V(.3,.3));pad.SetSize(V(.65,.65))
            pad.SetLocalZoneConnection(p.ZONE_CONNECTION_FULL)
    for drawing in fp.GraphicalItems():
        if drawing.GetLayer()==p.F_SilkS:drawing.SetLayer(p.F_Fab)
    save_local(fp,c)
    B.Add(fp)
    fp.SetPosition(V(c['x'],c['y']))
    if c['side']=='back':fp.Flip(fp.GetPosition(),False)
    fp.SetOrientationDegrees(c['rotation'])
    if c['dnp']:fp.SetDNP(True)
    fp.Value().SetVisible(False)
    fp.Reference().SetTextSize(V(.8,.8));fp.Reference().SetTextThickness(p.FromMM(.1))
    # Place compact designators explicitly later, after via placement.
    fp.Reference().SetPosition(V(c['x'],c['y']-2.3))
    fp.Reference().SetTextAngle(p.EDA_ANGLE(0,p.DEGREES_T))
    numbers={pa.GetNumber() for pa in fp.Pads() if pa.GetNumber()}
    assert numbers==set(c['nets']), (c['ref'],numbers,set(c['nets']))
    for pad in fp.Pads():
        nn=c['nets'].get(pad.GetNumber())
        if nn:pad.SetNet(nets[nn])

        if c['ref']=='U1' and pad.GetNumber()=='41' and pad.GetAttribute()==p.PAD_ATTRIB_PTH:
            pad.SetDrillSize(V(.3,.3));pad.SetSize(V(.65,.65))
        if c['ref']=='U1' and pad.GetNumber()=='41':
            pad.SetLocalZoneConnection(p.ZONE_CONNECTION_FULL)
    # Unused module-side GPIO35-37 are genuinely NC and have no escape traces.
    c['pins']=[]
    for number in sorted(numbers,key=lambda n:(not n.isdigit(),int(n) if n.isdigit() else n)):
        pads=[pa for pa in fp.Pads() if pa.GetNumber()==number]
        pa=pads[0];pos=pa.GetPosition()
        c['pins'].append(dict(number=number,name=c['names'].get(number,number),net=c['nets'][number],
                              type=c['pin_types'].get(number,'passive'),x=p.ToMM(pos.x),y=p.ToMM(pos.y)))
    c['physical_pads']=[dict(number=pa.GetNumber(),x=p.ToMM(pa.GetPosition().x),y=p.ToMM(pa.GetPosition().y),
                             net=c['nets'].get(pa.GetNumber()),smd=pa.GetAttribute()==p.PAD_ATTRIB_SMD)
                         for pa in fp.Pads() if pa.GetNumber()]

W,H=SPEC['size_mm']
rect(None,[0,0,W,H],p.Edge_Cuts,.05)
# M2 mounts: no copper on any layer within the keepout radius, so a screw head
# (<= 4 mm), washer or standoff cannot reach a power pour through the mask.
SPEC['mount_keepout_radius_mm']=MOUNT_KEEPOUT=2.5
for index,(x,y) in enumerate(SPEC['mounts_mm'],1):
    fp=p.FOOTPRINT(B);fp.SetPosition(V(x,y));fp.SetReference('H'+str(index));fp.SetValue('M2 NYLON')
    fp.SetAttributes(p.FP_BOARD_ONLY | p.FP_EXCLUDE_FROM_POS_FILES | p.FP_EXCLUDE_FROM_BOM)
    pa=p.PAD(fp);pa.SetNumber('');pa.SetPosition(V(x,y));pa.SetAttribute(p.PAD_ATTRIB_NPTH)
    pa.SetShape(p.PAD_SHAPE_CIRCLE);pa.SetSize(V(2.2,2.2));pa.SetDrillSize(V(2.2,2.2));pa.SetLocalClearance(p.FromMM(MOUNT_KEEPOUT-1.1))
    pa.SetLayerSet(p.LSET.AllCuMask());fp.Add(pa)
    fp.Reference().SetVisible(False);fp.Value().SetVisible(False);B.Add(fp)

for text,x,y,size in [('GemilaiMate COMPACT SHIELD',37.5,58.5,.8),('Rico-X  /  v'+REV['revision'],64,1.3,.7),
                      ('NO MAINS',30,44.5,.65),('USB',7.5,39.5,.7)]:
    t=p.PCB_TEXT(B);t.SetText(text);t.SetPosition(V(x,y));t.SetTextSize(V(size,size))
    t.SetTextThickness(p.FromMM(.1));t.SetLayer(p.F_SilkS);B.Add(t)
t=p.PCB_TEXT(B);t.SetText('github.com/Rico-X/GemilaiMate');t.SetPosition(V(34,47.7))
t.SetTextSize(V(.85,.85));t.SetTextThickness(p.FromMM(.12));t.SetLayer(p.B_SilkS);t.SetMirrored(True);B.Add(t)

# Standard footprint includes the antenna rule area. All the antenna is beyond
# the PCB edge; record the complete nominal assembly footprint.
W,H=SPEC['size_mm']
SPEC['nominal_assembly_bounds_mm']=[0,-7.15,W,H]
module_specs={
 'J_ADS':dict(body_size_mm=[28,17],body_offset_from_pin_row_mm=[0,-6.72],body_center_local_mm=[11.43,-6.72],socket_mpn='M20-7821046',male_header_mpn='M20-9991046',socket_body_mm=[25.8,2.5,8.5],socket_height_mm=8.5,male_header_body_mm=[25.4,2.54,2.54],male_header_height_mm=2.54,module_underside_mm=11.04,module_thickness_mm=1.6,geometry_status='seller outline; received clone not measured'),
 'J_TC':dict(body_size_mm=[20.32,22.86],body_offset_from_pin_row_mm=[0,9.4],body_center_local_mm=[-6.35,9.4],socket_mpn='M20-7820646',male_header_mpn='M20-9990646',socket_body_mm=[15.64,2.5,8.5],socket_height_mm=8.5,male_header_body_mm=[15.24,2.54,2.54],male_header_height_mm=2.54,module_underside_mm=11.04,module_thickness_mm=1.6,geometry_status='Adafruit reference envelope; received clone not measured'),
 'J_LEVEL':dict(body_size_mm=[15.24,15.24],body_offset_from_pin_row_mm=[0,0],body_center_local_mm=[0,0],socket_mpn='2 x M20-7820546',male_header_mpn='2 x M20-9990546',socket_body_mm=[13.1,2.5,8.5],socket_height_mm=8.5,male_header_body_mm=[12.7,2.54,2.54],male_header_height_mm=2.54,row_spacing_mm=12.7,module_underside_mm=11.04,module_thickness_mm=1.6,geometry_status='seller outline; received module and 12.70 mm row spacing unmeasured')}
SPEC['module_sockets']={}
for alias,spec in module_specs.items():
 c=next(x for x in SPEC['parts'] if x['ref']==alias)
 pads=c['physical_pads'];rx=sum(x['x'] for x in pads)/len(pads);ry=sum(x['y'] for x in pads)/len(pads)
 theta=-math.radians(c['rotation']);ox,oy=spec['body_offset_from_pin_row_mm']
 cx=rx+ox*math.cos(theta)-oy*math.sin(theta);cy=ry+ox*math.sin(theta)+oy*math.cos(theta)
 bw,bh=spec['body_size_mm']
 if int(round(c['rotation']))%180==90:bw,bh=bh,bw
 spec['body_rect_mm']=[round(cx-bw/2,4),round(cy-bh/2,4),round(cx+bw/2,4),round(cy+bh/2,4)]
 SPEC['module_sockets'][alias]=spec
SPEC['parts_count']=len(SPEC['parts'])
(HERE/'design.json').write_text(json.dumps(SPEC,ensure_ascii=False,indent=2)+'\n')
(HERE/'circuit.json').write_text(json.dumps(SPEC,ensure_ascii=False,indent=2)+'\n')
with (HERE/'connections.csv').open('w') as f:
    w=csv.writer(f,lineterminator="\n");w.writerow(['Reference','Value','Pin','Pin name','Net','x_mm','y_mm'])
    for c in SPEC['parts']:
        for pa in c['pins']:w.writerow([c['ref'],c['value'],pa['number'],pa['name'],pa['net'] or 'NC',pa['x'],pa['y']])

# Keep genuine power outputs in ERC. Flags mark power delivered through passive
# connector/fuse/diode chains; flags do not waive component pin errors.
SPEC['power_flags']=['GND','EXT_IN','USB_VBUS','USB_FUSED','+5V_EXT','+5V_CORE']
(HERE/'design.json').write_text(json.dumps(SPEC,ensure_ascii=False,indent=2)+'\n')
pro=json.loads((ROOT/'hardware/carrier/gemilaimate-carrier.kicad_pro').read_text())
ds=pro['board']['design_settings']
# Budget-fab margins for a two-layer process: edge, hole and
# annular clearances and legible silkscreen are enforced by DRC, not by review.
ds['rules'].update(min_clearance=.21,min_track_width=.20,min_via_diameter=.8,min_via_drill=.4,
                   min_through_hole_diameter=.3,min_copper_edge_clearance=.5,min_hole_clearance=.4,
                   min_hole_to_hole=.65,min_via_annular_width=.20,min_text_height=1.0,min_text_thickness=.15)
pro['meta']['filename']='gemilaimate-compact.kicad_pro'
pro['board']['design_settings']['drc_exclusions']=[]
# Copper for hand assembly and rework: 0.30 mm signals, 0.40 mm supplies, 0.30 mm
# gaps. The router may neck down at crowded pins only; DRC enforces the floors.
pro['net_settings']['classes'][0].update(clearance=json.loads((HERE/'layout-config.json').read_text()).get('signal_clearance_mm',.30),track_width=.3,via_diameter=.8,via_drill=.4)
default_class=pro['net_settings']['classes'][0]
pro['net_settings']['classes']=[default_class,
 dict(default_class,name='Power',clearance=.30,track_width=.4),
 dict(default_class,name='USB',clearance=.3,track_width=.3)]
pro['net_settings']['netclass_assignments']={}
pro['net_settings']['netclass_patterns']=[
 dict(netclass='Power',pattern=n) for n in ['+3V3','+5V_CORE','+5V_EXT','EXT_IN','USB_VBUS','USB_FUSED']]+[
 dict(netclass='USB',pattern=n) for n in ['USB_DP','USB_DM','USB_DP_MCU','USB_DM_MCU']]
(HERE/'gemilaimate-compact.kicad_pro').write_text(json.dumps(pro,indent=2)+'\n')
(HERE/'fp-lib-table').write_text('(fp_lib_table (version 7) (lib (name "GemilaiMateCompact") (type "KiCad") (uri "${KIPRJMOD}/GemilaiMateCompact.pretty") (options "") (descr "Local compact board footprints")))\n')
# Land-to-land gaps fixed by a package below the 0.30 mm class clearance
# (hand-solder SOT-23 and similar): allowed between that package's own pads only.
package_rules=''
for fp in sorted(B.GetFootprints(),key=lambda f:f.GetReference()):
    ref=fp.GetReference()
    if ref=='J1':continue
    lands=[a for a in fp.Pads() if a.GetNumber()]
    net=lambda a:a.GetNetname() or 'NC-'+a.GetNumber()
    gaps=[]
    for i,a in enumerate(lands):
        for b in lands[i+1:]:
            if net(a)==net(b):continue
            ra,rb=a.GetBoundingBox(),b.GetBoundingBox()
            gaps.append(math.hypot(max(p.ToMM(rb.GetLeft()-ra.GetRight()),p.ToMM(ra.GetLeft()-rb.GetRight()),0),
                                   max(p.ToMM(rb.GetTop()-ra.GetBottom()),p.ToMM(ra.GetTop()-rb.GetBottom()),0)))
    if gaps and min(gaps)<.30-1e-6:
        gap=math.floor(min(gaps)*100+1e-6)/100
        assert gap>=.21,(ref,'package gap below fabrication floor',gap)
        package_rules+=f'''(rule "Package lands {ref}"
 (condition "A.Type == 'Pad' && B.Type == 'Pad' && A.memberOfFootprint('{ref}') && B.memberOfFootprint('{ref}')")
 (constraint clearance (min {gap:.2f}mm)))
'''
(HERE/'gemilaimate-compact.kicad_dru').write_text("""(version 1)
(rule "Ordinary drill to copper"
 (constraint hole_clearance (min 0.50mm)))
(rule "Signal track width"
 (condition "A.NetClass == 'Default'")
 (constraint track_width (min 0.20mm)))
(rule "USB track width"
 (condition "A.NetClass == 'USB'")
 (constraint track_width (min 0.20mm)))
(rule "Power track width"
 (condition "A.NetClass == 'Power'")
 (constraint track_width (min 0.30mm)))
(rule "HRO USB-C contact fan-out"
 (condition "(A.memberOfFootprint('J1') || B.memberOfFootprint('J1')) && A.Type != 'Zone' && B.Type != 'Zone'")
 (constraint clearance (min 0.21mm)))
(rule "HRO USB-C fixed drill to copper"
 (condition "A.memberOfFootprint('J1') || B.memberOfFootprint('J1')")
 (constraint hole_clearance (min 0.40mm)))
"""+package_rules+"""# The last matching rule wins: enforce the real USB-C contact pitch.
(rule "HRO USB-C fixed pin pitch"
 (condition "A.Type == 'Pad' && B.Type == 'Pad' && A.memberOfFootprint('J1') && B.memberOfFootprint('J1')")
 (constraint clearance (min 0.21mm)))
""")
p.SaveBoard(str(HERE/'gemilaimate-compact.kicad_pcb'),B)
print('Generated',SPEC['parts_count'],'components at',HERE,'- unrouted, not a manufacturing release')
