rico-x/GemilaiMate/(commit log)

2026-10-28 Initial GemilaiMate prototype: Gemilai 3007Z carrier and standalone firmware
    [BOM-SMD.csv, BOM-THT.csv, connections.csv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]
2026-10-28 Add carrier 3D models and assembled renders
    [gemilaimate-carrier.kicad_pcb]
2026-10-28 Add wiring page with scheme, 3D view and harness tables
2026-10-28 Publish wiring page on GitHub Pages
2026-10-28 Add socketed shield alongside the carrier prototype
    [BOM-SMD.csv, BOM-THT.csv, connections.csv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]
2026-10-28 Move shield J5 to bottom edge to preserve ESP32 USB access
    Revise shield to v0.2.1, reserve the left USB plug corridor, and verify connector geometry against the PCB. Regenerate routing and fabrication files with zero ERC, DRC, unconnected and parity issues. Keep carrier v0.1, the component set and firmware unchanged.
    [BOM-THT.csv, connections.csv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]
2026-10-28 Apply shield assembly review and headless rebuild fixes
    Revise shield to v0.2.2 with square pin-1 pads, explicit orientation labels and module outlines. Use wired controls for externally mounted RobotDyn and SSR, preserve SSR terminals, reserve mating connector and cable envelopes, move J4 for mounting clearance, and document adjustable module retention. Rebuild on Linux KiCad 10.0.7 without DISPLAY; ERC, DRC, unconnected and parity all zero. Carrier electronics and firmware remain unchanged.
    [BOM-THT.csv, connections.csv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]
2026-10-28 Correct shield label order and specify grouped harness housings
    Revise shield to v0.2.3. Match CLK/VIN words to physical pad X, place ADS/TXS labels beside their own rows, and clear selected labels from front tracks and vias. Require single marked J5/J6 harness housings for both variants and document the remaining reversal risk. Native headless rebuild, electrical checks and semantic regressions pass; copper geometry is unchanged.
    [BOM-THT.csv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]
2026-10-28 Check all shield silk texts and clear remaining via overlaps
    [gemilaimate-shield-B_Cu.gbl, gemilaimate-shield-B_Mask.gbs, gemilaimate-shield-B_Silkscreen.gbo, gemilaimate-shield-Edge_Cuts.gm1, gemilaimate-shield-F_Cu.gtl, gemilaimate-shield-F_Mask.gts, gemilaimate-shield-F_Paste.gtp, gemilaimate-shield-F_Silkscreen.gto]
2026-10-28 Add shield wiring page with scheme, 3D assembly and harness tables
2026-10-29 Make shield rebuild reproducible, single-source its revision and check it with KiCad in CI
    [gemilaimate-shield-B_Cu.gbl, gemilaimate-shield-B_Mask.gbs, gemilaimate-shield-B_Silkscreen.gbo, gemilaimate-shield-Edge_Cuts.gm1, gemilaimate-shield-F_Cu.gtl, gemilaimate-shield-F_Mask.gts, gemilaimate-shield-F_Paste.gtp, gemilaimate-shield-F_Silkscreen.gto]
2026-10-29 Route pump and valve through a mode switch on both wiring pages
2026-10-29 Support a hand-wired VL53L0X water level sensor without the LED board
2026-11-03 Add compact N16R8 shield prototype with wider routing
    [BOM-EXTERNAL.csv, BOM-SMD.csv, BOM-THT.csv, BOM.csv, HARNESSES.csv, PINOUT.csv, alba.kicad_sch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]
2026-11-03 Fix compact shield review: input protection, regulator caps, unique RobotDyn header, reproducible routing
    [BOM-SMD.csv, BOM-THT.csv, BOM.csv, HARNESSES.csv, PINOUT.csv, alba.kicad_sch, connections.csv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]
2026-11-03 Adapt compact shield to budget fab rules and add miswiring protection
    [BOM-EXTERNAL.csv, BOM-SMD.csv, BOM-THT.csv, BOM.csv, HARNESSES.csv, PINOUT.csv, alba.kicad_sch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]
2026-11-03 Complete 75x60 compact PCB revision 0.2.3 with Pro PCB ID4
    [BOM-EXTERNAL.csv, BOM-SMD.csv, BOM-THT.csv, BOM.csv, PINOUT.csv, alba.kicad_sch, buttons.kicad_sch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]
2026-11-03 Compact 0.2.4: hand-solder packages, In1 ground routing, M2 keepouts, verified module orientation
    [BOM-SMD.csv, BOM.csv, PINOUT.csv, alba.kicad_sch, buttons.kicad_sch, component-dimensions.csv, connections.csv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]
2026-11-04 Compact 0.3: route 76x61 mm shield on two layers
    Use HRO TYPE-C-31-M-12 with a 0.20 mm copper/track floor, 0.25 mm signal gaps and 0.30 mm power/USB gaps. Preserve hand-solder packages, all 106 positions, logical connections and the GaggiMate Pro PCB ID=4 profile.
    Bundle current two-layer CAM, BOM, assembly views and repeatable copper. All-severity ERC/DRC, independent geometry, exact PCB rebuild, CAM comparison and both controller profile checks pass. Physical assembly and firmware switching remain untested.
    [BOM-SMD.csv, BOM-THT.csv, BOM.csv, PINOUT.csv, alba.kicad_sch, buttons.kicad_sch, component-dimensions.csv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]
2026-11-04 Fix compact rebuild determinism, USB land clearance and GND stitching
    [alba.kicad_sch, buttons.kicad_sch, expansion.kicad_sch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]
2026-11-04 Compact 0.3.1: 3D wiring, renders, purchase and assembly pages, landing for all boards
2026-11-06 Document 3007Z hydraulics and Compact wiring [skip ci]
